Human-Pygmalion/HUPHY/ros/README.md

# `ros/` — ROS 2 래퍼

`huphy` 를 라이브러리로 쓰는 ROS 2 패키지. 노드 둘 + 조작 노드 둘 (창, 패드) +
기록 노드.

| 노드 | 하는 일 | 어디서 |
|---|---|---|
| `control_node` | 모터를 몲. 100Hz, CAN, 가드 | 모션보드 (CAN·IMU 가 붙은 쪽) |
| `policy_node` | 갈 자세를 냄. **속도 명령** 정책 (`vx`·`wz`·`h*`). 50Hz | 작업 기계 (사람이 쓰는 쪽) |
| `motion_node` | 갈 자세를 냄. **모션 추종** 정책 (기준 궤적 재생). 50Hz. `policy_node` 와 둘 중 하나만 | 작업 기계 (사람이 쓰는 쪽) |
| `teleop_node` | (선택) `huphy-run --teleop` 과 같은 창으로 명령·시작·멈춤 | 작업 기계 (화면 있는 쪽) |
| `gamepad_node` | (선택) Xbox 패드로 명령·토크·시작·멈춤. `joy_node` 와 같이 띄움. 명령 없는 정책은 버튼만 | 작업 기계 (패드 꽂은 쪽) |
| `log_node` | (선택) `huphy-run --log` 과 같은 JSON 기록. 구독만 함 | 아무 기계 (파일이 거기 모임) |
| `current_node` | (선택) 전류계로 로봇 전체 DC 전류를 재서 냄. 제어도 추론도 안 함 | 전류계를 꽂은 기계 (CAN 과 무관) |

패키지는 둘임.

| 패키지 | 빌드 | 무엇 |
|---|---|---|
| `huphy_ros` | `ament_python` | 노드와 런치 |
| `huphy_ros_interfaces` | `ament_cmake` | 기록용 메시지 6개. 제어 토픽은 표준 타입 그대로임 |

D455 를 쓸 때는 노드가 하나 더 돎. **그건 우리가 만든 것이 아니라 인텔 공식
패키지임** -- 아래 [카메라 (D455)](#카메라-d455).

| 노드 | 하는 일 | 어디서 | 누가 만든 것 |
|---|---|---|---|
| `realsense2_camera_node` | D455 를 열어 깊이·색·IMU 를 토픽으로 냄 | 카메라가 USB 로 꽂힌 기계 | 인텔 (`realsense2_camera`) |
| `robot_state_publisher` · `rviz2` | 관절각으로 3D 모델을 움직여 보여 줌 ([3D 로 보기](#3d-로-보기-rviz)) | 화면 있는 기계 | ROS 기본 |

그림은 [`ros.drawio`](ros.drawio). 설계 근거는 **아래쪽 "아래는 설계"** 부터.

로봇 없이 ROS 만 테스트하려면 [`without_robot.md`](without_robot.md).

---

## 설치 (새 컴퓨터)

**한 번만 하면 됨.** 끝나면 터미널을 새로 열 때 따로 할 것이 없음.
두 기계(모션보드, 작업 기계) 모두 똑같이 함.

| | |
|---|---|
| OS | Ubuntu 22.04 |
| ROS | Humble |
| 파이썬 | 3.10 (Ubuntu 22.04 기본) |

```bash
sudo apt install -y git
cd ~
git clone https://github.com/chanhue/HUPHY.git
cd HUPHY
ros/install.sh
```

중간에 sudo 비밀번호를 물어봄 (ROS 설치). `끝.` 이 나오면 **새 터미널을 열고** 바로
`ros2 launch` 를 씀.

**여러 번 실행해도 됨.** 이미 된 단계는 건너뛰고, 잘못된 것은 고침. 설치가 꼬인 것
같으면 일단 다시 실행함.

### 스크립트가 하는 일

| 단계 | 하는 일 |
|---|---|
| 1 | ROS 저장소를 추가하고 ROS 2 Humble · colcon 설치. 이미 있으면 건너뜀 |
| 2 | `.venv` 를 `--system-site-packages` 로 만듦 (가상환경 안에서 ROS 가 보이게). 옵션 없이 만든 것이 있으면 다시 만듦 |
| 3 | `pip install -e ".[imu]"` |
| 4 | `~/ros2_ws` 를 만들고 가상환경 파이썬으로 빌드 (`python -m colcon build`) |
| 5 | `~/.bashrc` 에 자동 설정을 넣음 (`# >>> huphy >>>` 블록). 다시 실행하면 블록을 바꿔 끼움 |
| 6 | `huphy_ros` 가 보이는지, 노드가 가상환경 파이썬으로 도는지 확인 |

`ROS_DOMAIN_ID` 는 7 로 들어감. **두 기계가 같은 값이어야 함** — 다르면 에러 없이
서로 안 보임. 바꾸려면 `HUPHY_DOMAIN_ID=9 ros/install.sh`.

### 따로 까는 것

`install.sh` 는 **안 깖.** 쓰는 기계에서만 깔면 됨 -- 모션보드에는 보통 필요 없음.

| 쓸 때 | 어느 기계 | 명령 |
|---|---|---|
| RViz 로 3D 보기 | 화면 있는 기계 (작업 기계) | `sudo apt install ros-humble-rviz2` |
| 로그를 걸러 보기 (rqt_console) | 보는 기계 | `sudo apt install ros-humble-rqt-console` |
| D455 카메라 | 카메라가 꽂힌 기계 | [카메라 (D455)](#카메라-d455) |

### 다시 빌드할 때

**거의 없음.** 파이썬 코드를 고치면 그대로 반영됨. 노드를 새로 추가했거나
`setup.py` · `package.xml` 을 바꿨을 때만 `ros/install.sh` 를 다시 실행함.

**`colcon build` 를 직접 치지 말 것.** 시스템 파이썬으로 빌드되어 노드가
`No module named 'huphy'` 로 죽음. 그렇게 됐으면 `ros/install.sh` 를 다시 실행하면 고쳐짐.

### 안 될 때

| 메시지 | 할 것 |
|---|---|
| `ros2: 명령을 찾을 수 없습니다` | 설치 후 새 터미널을 안 엶 |
| `Package 'huphy_ros' not found` | 새 터미널을 안 엶. 그래도 안 되면 `ros/install.sh` 다시 |
| `No module named 'huphy'` | `colcon build` 를 직접 쳤음. `ros/install.sh` 다시 |
| 스크립트가 `✗` 로 멈춤 | 그 줄에 이유가 있음. 고치고 다시 실행 |

### D455 설치 (카메라를 쓸 때만)

**`ros/install.sh` 는 이걸 안 깖.** 카메라를 안 쓰면 없어도 나머지는 다 돎.
**카메라가 USB 로 꽂히는 기계에서만** 깔면 됨.

```bash
sudo apt install -y ros-humble-librealsense2*      # 인텔 SDK (librealsense2)
sudo apt install -y ros-humble-realsense2-*        # ROS 래퍼 + 메시지 + urdf
```

앞줄이 카메라와 USB 로 이야기하는 라이브러리, 뒷줄이 그걸 ROS 노드로 감싼 것임.
뒷줄은 `realsense2-camera`, `realsense2-camera-msgs`, `realsense2-description`
셋을 같이 깖.

깔렸는지 보려면

```bash
ros2 pkg list | grep realsense           # realsense2_camera 가 나와야 함
lsusb | grep -i intel                    # 꽂혀 있으면 Intel RealSense 가 보임
```

**`colcon build` 를 다시 할 필요 없음.** apt 로 깔리는 별개 패키지라
`~/ros2_ws` 와 상관없음.

---

## 실행

**띄우는 방법이 둘임. 해당하는 단락 하나만 따라감** -- 두 단락은 서로를 참조하지 않음.

| 띄우는 방법 | 언제 | 단락 |
|---|---|---|
| **두 기계** | 실제 배치. 모션보드는 로봇에, 작업 기계는 사람 앞에 | [A. 두 기계](#a-두-기계) |
| **한 기계** | 개발·점검. CAN·IMU 가 붙은 기계 하나에서 노드 둘 다 | [B. 한 기계](#b-한-기계) |

| 기계 | 붙은 것 | 띄우는 노드 |
|---|---|---|
| **모션보드** | CAN 어댑터 (모터) · IMU | `control_node` -- 모터를 읽고 몲 |
| **작업 기계** | 사람이 쓰는 PC | `policy_node` -- 갈 자세를 계산해 모션보드로 보냄 |

각 단락은 **평소 쓰는 순서**(띄우기 -> 토크 -> 기준 자세 -> 정책 -> 명령 -> 멈춤)가 먼저 있고, 그 아래에
**확인**(읽히는지, 토크 없이 정책 출력만)이 따로 있음. 처음 돌리거나 모터·배선을 바꿨으면
토크 넣기 전에 확인부터 함.

### 기존 명령과 어떻게 대응하나

ROS 없이 돌리는 `huphy-run` 한 번이 아래처럼 쪼개져 있음. **ROS 는 "토크 넣기" 와 "정책
시작" 이 따로임** -- `huphy-run` 은 켜자마자 토크를 넣고 기준 자세로 감.

| `huphy-*` 로 하던 것 | ROS 에서 |
|---|---|
| `huphy-can up` | 같음 (`huphy-can up`) |
| `huphy-test --robot watch` -- 토크 없이 읽기만 | `control.launch.py` 를 띄운 직후 (`OBSERVE`) + `ros2 topic echo` 로 봄 |
| `huphy-run --policy <이름>` 의 정책 불러오기 | `policy.launch.py policy:=<폴더>` -- 불러만 두고 아무것도 안 냄 |
| `huphy-run` 시작 = 토크 켜고 기준 자세로 가서 기다림 | `enable` (토크, 감쇠로 대기) -> `approach` (기준 자세로 3초, 도착하면 붙잡고 기다림) |
| `huphy-run` 의 **Enter** -- 정책 시작 | `start_policy` |
| `--teleop` -- pygame 창으로 조작 | `teleop.launch.py` -- 같은 창. R(기준 자세)·Enter(시작)·Esc(끔) |
| `--cmd vx=0.2` | `ros2 topic pub /huphy/cmd_vel ...` (계단·경사는 `linear.x` 만) |
| `--cmd h_star=0.80` / `--teleop` 의 ↑↓ | `ros2 topic pub /huphy/h_star ...` |
| **Ctrl-Q** -- 감쇠 5초 후 토크 끔 | `stop_policy` -> `disable` (감쇠 5초 후 토크 끔). 또는 모션보드 런치에서 Ctrl-C |
| (없음) | 토크 없이 정책 출력만 보기 -- `OBSERVE` 에서 `approach` -> `start_policy` |

**launch 는 띄운 터미널을 계속 차지함** (끄면 노드도 꺼짐). 그 뒤 명령은 **새 터미널**에서
침.

---

### A. 두 기계

모션보드(로봇) + 작업 기계(사람 앞). 각 단계 제목의 `[ ]` 가 **치는 기계**임.
`ros2 service` · `ros2 topic` 은 네트워크 전체에 통해서 어느 기계에서 쳐도 되지만, 사람이 앉은
**작업 기계**에서 치는 것으로 적음.

두 기계의 `ROS_DOMAIN_ID` 가 같아야 함 (설치 스크립트가 7 로 넣음). 다르면 에러 없이 서로
안 보임.

#### 띄울 것 한눈에

런치 하나가 터미널 하나를 차지함. **위에서부터 순서대로** 띄움. 정책은 걷기 예시 --
`walk` 자리를 `stair_slope` / `squat` 로 바꾸면 됨. 정책·창·패드에는
**같은 정책**을 줌.

터미널 2 는 **정책 종류에 따라 런치가 다름.** 속도 명령 정책(`walk`,
`stair_slope`, `squat`)은 `policy.launch.py`, 모션 추종 정책
(`motion545` · `motion399`)은 `motion.launch.py` 임. **둘 중 하나만** 띄울 것 -- 둘 다 띄우면
같은 `joint_targets` 에 두 노드가 목표각을 냄.

| 터미널 | 기계 | 띄울 것 |
|---|---|---|
| 1 | 모션보드 | `huphy-can up` 후 `ros2 launch huphy_ros control.launch.py config:=$HOME/HUPHY/config/robot.yaml` |
| 2 | 작업 기계 | 속도 명령 정책 `ros2 launch huphy_ros policy.launch.py policy:=$HOME/HUPHY/config/policies/walk` <br> 모션 추종 정책 `ros2 launch huphy_ros motion.launch.py policy:=$HOME/HUPHY/config/policies/motion545` |
| 3 | 작업 기계 | 조작 하나: 창 `teleop.launch.py policy:=...` / 패드 `gamepad.launch.py policy:=...` / 명령 `ros2 topic pub ...` (A-6). **모션 추종 정책은 패드뿐** -- 창과 명령은 줄 값이 있어야 함 |
| 4 | 작업 기계 | **기록할 때만** `ros2 launch huphy_ros log.launch.py` -- 정책 시작 전에 |

- **기록은 터미널 4 하나로 끝남.** 1·2 에 붙일 것 없음 -- 기록 노드가 뜨면 두 노드가 알아서
  기록용 토픽을 내기 시작하고, 안 뜨면 안 냄.
- 기록 파일은 터미널 4 를 띄운 기계의 `~/HUPHY/ros/logs/policy/`, `.../latency/` 에 생김.
  `stop_policy` (Esc, 패드 B 포함) 한 번에 한 쌍. 자세한 것은 [기록](#기록).
- 토크 켜기·기준 자세·정책 시작·멈춤은 런치가 아니라 서비스임 -- A-3 부터.

#### A-1. CAN 올리고 제어 노드 띄우기  `[모션보드]`

```bash
huphy-can up
ros2 launch huphy_ros control.launch.py config:=$HOME/HUPHY/config/robot.yaml
```

기록은 여기서 켤 것 없음 -- 작업 기계에서 `log.launch.py` 하나 (위 [띄울 것 한눈에](#띄울-것-한눈에)).

| 명령 | 하는 일 | 기존으로 치면 |
|---|---|---|
| `huphy-can up` | CAN 채널 canr·canl 을 1 Mbps 로 올림. 재부팅·어댑터 재연결 뒤마다 다시 | 같음 |
| `control.launch.py` | 모터·IMU 를 100Hz 로 읽어 `joint_states` 로 내보내고, 들어온 목표각으로 모터를 몲. **`OBSERVE` 로 시작 -- 토크 없음** | `huphy-test --robot watch` 를 띄운 상태 |

모터 설정(호스트 id)이 어긋나 있으면 여기서 멈춤 -- 아래 [안 될 때](#안-될-때-1).

#### A-2. 정책 노드 띄우기  `[작업 기계]`

**넷 중 하나만** 침 -- 어느 정책을 돌릴지 고르는 것. 마지막 하나는 런치가 다름.

```bash
# 걷기 -- /huphy/cmd_vel 로 앞뒤·회전 속도를 줌
ros2 launch huphy_ros policy.launch.py policy:=$HOME/HUPHY/config/policies/walk

# 계단·경사 걷기 -- /huphy/cmd_vel 의 linear.x 만. angular.z 는 0 으로 잘림
ros2 launch huphy_ros policy.launch.py policy:=$HOME/HUPHY/config/policies/stair_slope

# 제자리 스쿼트 -- /huphy/h_star 로 골반 높이를 줌
ros2 launch huphy_ros policy.launch.py policy:=$HOME/HUPHY/config/policies/squat

# 모션 추종 -- 줄 명령이 없음. 꾸러미의 궤적 659프레임을 13.16초 동안 재생
ros2 launch huphy_ros motion.launch.py policy:=$HOME/HUPHY/config/policies/motion545
#   또는 policy:=$HOME/HUPHY/config/policies/motion399
```

`motion.launch.py` 는 `motion_node` 를 띄움 (아래 [`motion_node`](#motion_node)).
단계·서비스는 `policy_node` 와 같고 끝에 `done` 이 하나 더 있음. 명령 토픽
(`cmd_vel`/`h_star`)은 값으로 안 쓰고 조작 노드가 살아 있는지만 봄.

| 명령 | 하는 일 | 기존으로 치면 |
|---|---|---|
| `policy.launch.py` | 정책 꾸러미를 불러 두고 모션보드의 `joint_states` 를 받기 시작함. **띄우기만 하면 아무것도 안 냄** (`stage` = `off`) | `huphy-run --policy <이름>` 의 불러오기까지 |

`checkpoint:=4500`(스쿼트) / `checkpoint:=37400`(걷기 예전 기본. 지금 기본은 49999) 로 다른 체크포인트,
안 주면 계약의 기본값 (`huphy-run --checkpoint` 와 같음). `stair_slope` 는 체크포인트가 `99998`
하나뿐임.

#### A-3. 토크 넣기  `[작업 기계]`

**로봇을 들거나 테더에 맨 상태에서.**

```bash
ros2 service call /huphy/enable std_srvs/srv/Trigger
```

| 명령 | 하는 일 | 기존으로 치면 |
|---|---|---|
| `enable` | 모션보드를 `OBSERVE` -> `CONTROL`. **모터에 힘이 들어감.** 정책이 없는 동안은 감쇠 명령(위치를 안 붙잡고 빠른 움직임만 막음)으로 버팀 | `huphy-run` 을 켠 순간의 토크 넣기 (단, `huphy-run` 은 곧바로 기준 자세로 감) |

`success: true` 가 나와야 함. `false` 면 메시지에 이유가 있음.

#### A-4. 기준 자세로  `[작업 기계]`

```bash
ros2 service call /huphy/approach std_srvs/srv/Trigger
```

| 명령 | 하는 일 | 기존으로 치면 |
|---|---|---|
| `approach` | 3초에 걸쳐 정책의 기준 자세로 간 뒤 **그 자세를 붙잡고 기다림**. `stage` 가 `off -> approach -> ready` | `huphy-run` 이 켜지고 기준 자세로 가서 기다리는 부분 |

로봇이 기준 자세로 제대로 섰는지 보고 다음으로.

**기준 자세가 정책마다 다름.** 속도 명령 정책은 계약의 기본자세로 가고, 모션 추종
정책은 **궤적의 시작 프레임 자세**로 감 (`start_frame`, 기본 0). 학습이 그 자세에서
에피소드를 시작하기 때문임 — 기본자세로 가면 재생을 누른 순간 기준과 실측이
10~20도 벌어진 채로 들어감. `motion_node` 로그가 지금 자세에서 몇 도 가는지 적음.

#### A-5. 정책 시작  `[작업 기계]`

```bash
ros2 service call /huphy/start_policy std_srvs/srv/Trigger
```

| 명령 | 하는 일 | 기존으로 치면 |
|---|---|---|
| `start_policy` | 신경망으로 바뀜. `stage` 가 `ready -> running`. **`ready` 가 아니면 거절**하고 이유를 줌 (먼저 approach / 아직 가는 중 n초) | **Enter** |

어느 정책(걷기/스쿼트)인지는 A-2 에서 띄울 때 정해짐 -- 여기서 고르지 않음. 지금 불린 것은
`ros2 topic echo /huphy/policy_status --once` 의 `hardware_id`. 바꾸려면 정책 런치를 다시 띄움.

#### A-6. 명령 주기 (cmd)  `[작업 기계]`

**방법 셋 -- 창(teleop), 패드(gamepad), 또는 명령.**

창으로 조작 -- `huphy-run --teleop` 과 같은 pygame 창. 화면이 있는 **작업 기계**에서 (ssh 면 `-X`).
`policy:=` 는 정책 노드에 준 것과 같은 꾸러미.

**정책 노드(A-2)에 준 것과 같은 정책**을 줌 -- 그 정책의 명령 키만 생김.

```bash
# 걷기 -- W/S 앞뒤, A/D 회전
ros2 launch huphy_ros teleop.launch.py policy:=$HOME/HUPHY/config/policies/walk

# 계단·경사 -- W/S 앞뒤만. A/D 키가 아예 안 생김
ros2 launch huphy_ros teleop.launch.py policy:=$HOME/HUPHY/config/policies/stair_slope

# 스쿼트 -- ↑/↓ 높이
ros2 launch huphy_ros teleop.launch.py policy:=$HOME/HUPHY/config/policies/squat
```

| 창에서 누르는 키 | 하는 일 | 기존으로 치면 |
|---|---|---|
| W/S · A/D | 걷기 앞뒤 · 회전. 누르는 동안 가속, 떼면 감속해 0 | `--teleop` 의 W/S/A/D |
| ↑/↓ | 스쿼트 높이 | `--teleop` 의 ↑/↓ |
| Space | 속도 즉시 0 | 같음 |
| **R** | 기준 자세로 (`approach`). **토크가 켜져 있을 때만** -- 아니면 안 보내고 로그에 "먼저 enable" | (없음 -- `huphy-run` 은 켜자마자 감) |
| **Enter** | 정책 시작 (`start_policy`). 기준 자세 도착 뒤에만 | Enter |
| **Esc** · 창 닫기 | 정책 끔 -> 토크 끔 (`stop_policy` -> `disable`), 창도 닫힘 | Esc |

창 맨 위에 지금 상태가 뜸 -- `Torque OFF` / `R: go to ready pose` / `Moving to ready pose` /
`Ready. Enter: start policy` / `POLICY RUNNING`. **토크 켜기(`enable`)는 키로 안 함** -- 명령으로
침. 속도 상한 등은 `max:="vx=0.8" accel:="vx=0.4" decel:="vx=1.5"` (`--max` 등과 같음).

창을 쓰면 A-4·A-5·A-6 의 명령을 대신함 (enable 만 명령).

---

패드로 조작 -- Xbox 패드. 화면이 필요 없음. 패드를 USB 나 블루투스로 붙이면
`/dev/input/js0` 가 생기고, 런치가 `joy_node`(ROS 의 `joy` 패키지)와 `gamepad_node` 를 같이 띄움.
`policy:=` 는 정책 노드에 준 것과 같은 꾸러미.

```bash
# 걷기 -- 왼쪽 스틱 앞뒤, 오른쪽 스틱 회전
ros2 launch huphy_ros gamepad.launch.py policy:=$HOME/HUPHY/config/policies/walk

# 계단·경사 -- 왼쪽 스틱 앞뒤만. 오른쪽 스틱이 아예 안 배정됨
ros2 launch huphy_ros gamepad.launch.py policy:=$HOME/HUPHY/config/policies/stair_slope

# 스쿼트 -- 십자키 위아래로 높이
ros2 launch huphy_ros gamepad.launch.py policy:=$HOME/HUPHY/config/policies/squat

# 모션 추종 -- 스틱이 할 일이 없음. 버튼만 씀 (아래 설명)
ros2 launch huphy_ros gamepad.launch.py policy:=$HOME/HUPHY/config/policies/motion545
```

**모션 추종 정책은 스틱이 없고 버튼만 씀.** 사람이 줄 명령이 없어서임 -- 따라갈
궤적이 꾸러미 안에 있음. View·A·RB+Menu·B 는 그대로 되고, RB 는 속도를 내보내는
데드맨 역할은 없어지지만 "RB 를 쥐고 있어야 시작된다" 는 조건으로 남음.

`cmd_vel` 은 그 경우에도 **0 만 20Hz 로 계속 냄.** 값이 쓰이지 않지만 그것이 패드
쪽이 살아 있다는 신호임 -- 끊기면 `control_node` 가 감쇠 후 토크를 끊고
(`stop_on_input_loss`) `motion_node` 가 재생을 멈춤 (`stop_on_cmd_loss`). 안 내면
패드가 죽어도 로봇이 13초 동안 혼자 돌고 B 를 누를 수단이 없어짐.

| 패드 | 하는 일 |
|---|---|
| 왼쪽 스틱 세로 · 가로 | `vx` 앞뒤 · `vy` 옆 (스틱값 × 그 명령의 `max`) |
| 오른쪽 스틱 가로 | `wz` 회전 |
| 십자키 세로 | `h_star` 높이. `accel`(기본 0.05 m/s)씩 움직이고 계약의 범위에서 멈춤 |
| **RB** | 누르고 있는 동안에만 명령이 먹음. 떼면 속도 0, 높이는 마지막 값 유지 |
| **A** | 기준 자세로 (`approach`). **토크가 켜져 있을 때만** |
| **RB + Menu** | 정책 시작 (`start_policy`). **RB 를 누르고 있어야 나감** |
| **B** | 정책 끔 -> 토크 끔 (`stop_policy` -> `disable`). 노드는 계속 돎 -- 다시 View 1초부터. 노드 종료는 Ctrl-C |
| **View 1초** | 토크 넣기 (`enable`). **1초 계속 눌러야** 한 번 나감 |

**창(teleop)과 다른 점은 `enable` 이 패드에 있다는 것뿐임.** 토크가 들어가는 순간이 가장
위험해서, 한 번 눌리는 것으로는 안 나가게 `enable_hold_s`(기본 1.0초)를 둠. 정책 시작도
RB 를 쥐고 있어야 나감 -- 손이 데드맨에 가 있어야 정책이 돈다는 뜻임. 둘 다 버튼이
**안 눌림 -> 눌림** 으로 바뀐 주기에만 나가므로, Menu 를 누른 채로 RB 를 더하는 것은 안 됨
(Menu 를 뗐다가 RB 를 먼저 쥐고 다시 누를 것).

**버튼 번호는 USB 와 블루투스가 다름** -- 같은 View 가 USB 에서는 6번, 블루투스에서는 10번.
`gamepad_node` 가 첫 `/joy` 의 버튼 수로 배치를 고름 (11개 usb, 16개 bluetooth). 시작 로그에
`패드 배치 bluetooth (버튼 16개): deadman 7, …` 처럼 찍힘. **모르는 버튼 수면 패드를 통째로
무시하고 속도 0 만 냄** -- 번호를 모르는 채로 쓰면 엉뚱한 버튼이 토크를 넣음 (블루투스에서
USB 번호를 쓰면 LB 가 "View" 였음). 고정하려면 `layout:=usb` / `layout:=bluetooth`.

`joy` 패키지는 apt 로 깜: `sudo apt install -y ros-humble-joy` (pip 아님).

패드 입력만 따로 보려면 `python3 tools/gamepad_viewer.py` -- ROS 없이 패드를 직접 읽어 버튼·축의
번호와 이름(`View`, `RB` 등)을 브라우저에 실시간으로 보여 줌 (`tools/README.md`).

**끊기면 감쇠 후 토크가 꺼짐:** 패드가 끊기거나(`/joy` 가 0.5초 넘게 안 옴 -- 선이 빠짐,
블루투스 끊김, `joy_node` 가 죽음) `gamepad_node` 가 죽으면(Ctrl-C 포함) 명령 토픽이 끊기고,
0.5초 뒤 `control_node` 가 감쇠 5초 후 토크를 끊음 (`stop_on_input_loss`). 정책 노드도 정책을 끔.
속도만 0 으로 두면 B 를 누를 패드가 없어 멈출 수단이 없기 때문임. 다시 쓰려면 View 1초부터.

축·버튼 번호는 드라이버마다 다름 (USB 의 `xpad` 와 블루투스의 `xpadneo` 가 다름). 안 맞으면
`ros2 topic echo /joy` 로 실제 번호를 보고 덮어씀.

```bash
ros2 launch huphy_ros gamepad.launch.py policy:=... \
  --ros-args -p axis_vx:=1 -p button_deadman:=5
```

패드 하나로 A-3·A-4·A-5·A-6·A-7 을 다 함.

---

명령으로 줄 때는 정책에 맞는 것 **하나**. `pub -r 20` 은 초당 20번 계속 보냄. 안 보내면 걷기는
(0, 0) = 제자리, 스쿼트는 시작값 0.8914.

**끊으면:** 0.5초 뒤(`policy_node` 의 `cmd_timeout_s`) **정책이 멈추고 모션보드가 감쇠 후
토크를 끊음** (`stop_on_cmd_loss`). 보내던 쪽(패드·teleop·`pub -r`)이 죽었는데 정책이 계속
돌면, 멈춤 버튼도 같이 죽어 멈출 수단이 없어짐. `--once` 로 한 번만 보낼 거면
`stop_on_cmd_loss:=false` -- 그때는 속도만 0 으로 돌아가고 높이는 마지막 값이 유지됨.

```bash
# 걷기: linear.x 앞뒤 (m/s), angular.z 돌기 (rad/s)
ros2 topic pub -r 20 /huphy/cmd_vel geometry_msgs/msg/Twist \
  '{linear: {x: 0.2}, angular: {z: 0.0}}'

# 계단·경사: 같은 토픽인데 linear.x 만 (0 ~ 2 m/s). angular.z 는 보내도 0 으로 잘림
ros2 topic pub -r 20 /huphy/cmd_vel geometry_msgs/msg/Twist \
  '{linear: {x: 0.3}}'

# 스쿼트: 골반 높이 (m). 0.70 ~ 0.891
ros2 topic pub -r 20 /huphy/h_star std_msgs/msg/Float64 '{data: 0.80}'
```

| 명령 | 하는 일 | 기존으로 치면 |
|---|---|---|
| `topic pub cmd_vel` | 걷기 속도 명령 | `--cmd vx=0.2 wz=0` 또는 `--teleop` 의 W·S·A·D |
| `topic pub cmd_vel` (계단·경사) | 전진 속도만. `angular.z` 는 무시됨 | `--cmd vx=0.3` 또는 `--teleop` 의 W·S |
| `topic pub h_star` | 스쿼트 높이 명령 | `--cmd h_star=0.80` 또는 `--teleop` 의 ↑↓ |

#### A-7. 멈춤 · 토크 끄기  `[작업 기계]` · 급하면 `[모션보드]`

```bash
ros2 service call /huphy/stop_policy std_srvs/srv/Trigger   # 목표각 중단
ros2 service call /huphy/disable std_srvs/srv/Trigger       # 감쇠 5초 후 토크 차단
```

| 명령 | 하는 일 | 기존으로 치면 |
|---|---|---|
| `stop_policy` | 정책이 목표각을 그만 냄(어느 단계에서든). 모션보드는 감쇠로 버팀 | (없음 -- 둘이 한 번에 일어남) |
| `disable` | 감쇠 5초 후 토크를 끊고 `OBSERVE` 로 | **Ctrl-Q** |

급하면 **모션보드**의 런치 터미널에서 **Ctrl-C** -- 같은 절차(감쇠 후 차단)를 탐. 작업
기계의 정책 런치를 끊으면 목표각이 끊겨 모션보드가 100ms 뒤 감쇠로 떨어지지만, 토크는
`disable` 이나 모션보드 Ctrl-C 로 끊어야 함.

다시 돌리려면 A-3 (`enable`) 부터.

#### A 확인 1. 읽히는지  `[작업 기계]` -- A-1 뒤, 토크 전에

```bash
ros2 topic hz   /huphy/joint_states          # 초당 몇 번 오는지. 100 근처. Ctrl-C 로 멈춤
ros2 topic echo /huphy/joint_states --once   # 관절 각도·속도 한 번
ros2 topic echo /huphy/gravity --once        # IMU 가 본 중력 방향 한 번
ros2 topic echo /huphy/loop_status --once    # 제어 루프 상태 (모드, 무응답 수)
```

| 명령 | 하는 일 | 기존으로 치면 |
|---|---|---|
| `topic hz joint_states` | 모션보드 상태가 **네트워크 너머로** 제 주기로 오는지 | (없음 -- ROS 만의 확인) |
| `topic echo joint_states` | 관절 각도·속도 | `watch` 의 실시간 뷰어 숫자 |
| `topic echo gravity` | IMU 중력방향 | 실시간 뷰어 IMU 그래프 |
| `topic echo loop_status` | 모드·무응답 수 | 끝에 찍히는 실패 집계 |

`hz` 는 계속 찍고 안 끝남 -- 확인했으면 **Ctrl-C**. `--once` 는 하나 찍고 끝남.

| 보는 것 | 맞는 값 |
|---|---|
| 관절 이름 | `right_leg__knee` 꼴, **모터 12개.** 발목은 `ankle_a`/`ankle_b` (기존 레포·정책 계약과 같음. `ankle_pitch`/`ankle_roll` 이 보이면 예전 노드임) |
| 위치 | **라디안.** 무릎 20도면 0.35. 손으로 움직이면 따라 변함 |
| 중력방향 | 서 있으면 z 가 −1 근처 |
| `missing_cycles` | 거의 안 늚 |

#### A 확인 2. 토크 없이 정책 출력만  `[작업 기계]` -- A-2 뒤, A-3 전에

```bash
ros2 service call /huphy/approach std_srvs/srv/Trigger       # 기준 자세 목표각 (3초 뒤 ready)
ros2 service call /huphy/start_policy std_srvs/srv/Trigger   # 정책 켬
ros2 topic hz   /huphy/joint_targets                         # 목표각이 초당 몇 번. Ctrl-C
ros2 topic echo /huphy/joint_targets --once                  # 목표각 한 번
ros2 service call /huphy/stop_policy std_srvs/srv/Trigger    # 정책 끔
```

| 명령 | 하는 일 | 기존으로 치면 |
|---|---|---|
| `approach` -> `start_policy` | 정책이 목표각을 내기 시작. 모션보드가 아직 `OBSERVE` 라 **모터는 안 움직임** | **없음** -- `huphy-run` 은 늘 토크를 넣고 돎 |
| `topic hz/echo joint_targets` | 목표각이 정책 주기(50Hz 근처)로, −2 ~ 2 rad 안에서 나오는지 | (없음) |
| `stop_policy` | 정책 끔. 이 뒤에 A-3 으로 | (없음) |

---

### B. 한 기계

**모든 명령을 CAN·IMU 가 붙은 그 기계 하나에서** 침. 노드 둘을 런치 하나로 같이 띄우는 것만
다르고, 그 뒤 서비스·토픽은 A 와 같음. 런치 뒤 명령은 새 터미널에서.

**`local.launch.py` 는 속도 명령 정책만 띄움** (`control` + `policy`). 모션 추종
정책은 한 기계에서도 터미널 둘로 띄울 것 -- `control.launch.py` 와
`motion.launch.py`. 한 런치로 묶지 않은 이유: `local.launch.py` 에 둘을 같이
넣으면 `policy_node` 와 `motion_node` 가 같은 `joint_targets` 에 목표각을 냄.

#### 띄울 것 한눈에 (한 기계)

| 터미널 | 띄울 것 |
|---|---|
| 1 | `huphy-can up` 후 `ros2 launch huphy_ros local.launch.py config:=$HOME/HUPHY/config/robot.yaml policy:=$HOME/HUPHY/config/policies/walk` |
| 2 | 조작 하나: 창 `teleop.launch.py policy:=...` / 패드 `gamepad.launch.py policy:=...` / 명령 `ros2 topic pub ...` (B-5) |

- **기록할 때만** 다른 터미널에서 `ros2 launch huphy_ros log.launch.py` -- 정책 시작 전에.
- 기록 파일은 `~/HUPHY/ros/logs/policy/`, `.../latency/`. `stop_policy` 한 번에 한 쌍.

#### B-1. CAN 올리고 노드 둘 띄우기

```bash
huphy-can up
ros2 launch huphy_ros local.launch.py \
  config:=$HOME/HUPHY/config/robot.yaml \
  policy:=$HOME/HUPHY/config/policies/walk
```

| 명령 | 하는 일 | 기존으로 치면 |
|---|---|---|
| `huphy-can up` | CAN 채널을 1 Mbps 로 올림 | 같음 |
| `local.launch.py` | 제어 노드(`OBSERVE`, 토크 없음)와 정책 노드(불러만 둠)를 **한 번에** 띄움. 정책은 `policy:=` 로 고름 -- `walk` / `stair_slope` / `squat`. **기록 노드는 안 띄움** | `huphy-test --robot watch` 상태 + `huphy-run --policy <이름>` 의 불러오기 |

로그 끝에 `approach 를 기다림` 과 `OBSERVE 로 시작` 이 나오면 된 것임.

기록은 다른 터미널에서 `ros2 launch huphy_ros log.launch.py` (아래 [기록](#기록)).

로봇 없이 점검할 때는 `huphy-can up` 대신 가짜 채널을 올리고 `config:=/tmp/robot_vcan.yaml`
-- [`without_robot.md`](without_robot.md).

#### B-2. 토크 넣기

**로봇을 들거나 테더에 맨 상태에서.**

```bash
ros2 service call /huphy/enable std_srvs/srv/Trigger
```

`OBSERVE` -> `CONTROL`. 정책이 없는 동안은 감쇠로 버팀. `huphy-run` 을 켠 순간의 토크
넣기에 해당 (단, 기준 자세로는 아직 안 감). `success: true` 가 나와야 함.

#### B-3. 기준 자세로

```bash
ros2 service call /huphy/approach std_srvs/srv/Trigger       # 3초에 걸쳐 기준 자세로, 도착하면 붙잡고 기다림
```

`stage` 가 `off -> approach -> ready`. `huphy-run` 이 켜지고 기준 자세에서 기다리는 부분.
로봇이 제대로 섰는지 보고 다음으로.

#### B-4. 정책 시작

```bash
ros2 service call /huphy/start_policy std_srvs/srv/Trigger   # ready -> running (= huphy-run 의 Enter)
```

`ready` 가 아니면 거절하고 이유를 줌. 어느 정책인지는 B-1 의 `policy:=` 로 정해짐 -- 바꾸려면
`disable` 후 런치를 다시 띄움 (제어 노드도 같이 뜨는 런치라서).

#### B-5. 명령 주기 (cmd)

창으로 -- 같은 기계에 화면이 있으면 (A-6 의 키와 같음. R 기준 자세, Enter 시작, Esc 끔):

```bash
# B-1 의 policy:= 와 같은 것
ros2 launch huphy_ros teleop.launch.py policy:=$HOME/HUPHY/config/policies/walk   # 걷기 W/S/A/D
ros2 launch huphy_ros teleop.launch.py policy:=$HOME/HUPHY/config/policies/stair_slope    # 계단·경사 W/S
ros2 launch huphy_ros teleop.launch.py policy:=$HOME/HUPHY/config/policies/squat        # 스쿼트 ↑/↓
```

패드로 -- A-6 의 패드와 같음 (RB 데드맨, View 1초 토크, A 기준 자세, RB+Menu 시작, B 끔):

```bash
ros2 launch huphy_ros gamepad.launch.py policy:=$HOME/HUPHY/config/policies/walk
```

명령으로 -- 정책에 맞는 것 하나. 끊으면 속도는 0.5초 뒤 0, 높이는 유지.

```bash
ros2 topic pub -r 20 /huphy/cmd_vel geometry_msgs/msg/Twist \
  '{linear: {x: 0.2}, angular: {z: 0.0}}'                      # 걷기 (= --cmd vx=0.2)
ros2 topic pub -r 20 /huphy/cmd_vel geometry_msgs/msg/Twist \
  '{linear: {x: 0.3}}'                                         # 계단·경사 (= --cmd vx=0.3)
ros2 topic pub -r 20 /huphy/h_star std_msgs/msg/Float64 '{data: 0.80}'   # 스쿼트 (= --cmd h_star=0.80)
```

#### B-6. 멈춤 · 토크 끄기

```bash
ros2 service call /huphy/stop_policy std_srvs/srv/Trigger   # 목표각 중단
ros2 service call /huphy/disable std_srvs/srv/Trigger       # 감쇠 5초 후 토크 차단 (= Ctrl-Q)
```

급하면 런치 터미널에서 **Ctrl-C** -- 같은 절차를 탐. 다시 돌리려면 B-2 (`enable`) 부터.

#### B 확인 1. 읽히는지 -- B-1 뒤, 토크 전에

```bash
ros2 topic hz   /huphy/joint_states          # 100 근처. Ctrl-C
ros2 topic echo /huphy/joint_states --once   # 관절 각도·속도
ros2 topic echo /huphy/gravity --once        # 중력 방향
ros2 topic echo /huphy/loop_status --once    # 모드, 무응답 수
```

| 명령 | 하는 일 | 기존으로 치면 |
|---|---|---|
| `topic hz joint_states` | 상태가 제 주기로 나오는지 | (없음) |
| `topic echo joint_states` | 관절 각도·속도 | `watch` 의 실시간 뷰어 숫자 |
| `topic echo gravity` | IMU 중력방향 | 실시간 뷰어 IMU 그래프 |
| `topic echo loop_status` | 모드·무응답 수 | 끝에 찍히는 실패 집계 |

맞는 값: 이름 `right_leg__knee` 꼴로 모터 12개(발목은 `ankle_a`/`ankle_b`), 위치는 **라디안**(무릎 20도면 0.35), 중력방향 z 가
−1 근처, `missing_cycles` 가 거의 안 늚.

#### B 확인 2. 토크 없이 정책 출력만 -- B-1 뒤, B-2 전에

```bash
ros2 service call /huphy/approach std_srvs/srv/Trigger       # 기준 자세 목표각 (3초 뒤 ready)
ros2 service call /huphy/start_policy std_srvs/srv/Trigger   # 정책 켬 -- 모터는 안 움직임
ros2 topic hz   /huphy/joint_targets                         # 정책 주기 근처. Ctrl-C
ros2 topic echo /huphy/joint_targets --once                  # −2 ~ 2 rad 면 정상
ros2 service call /huphy/stop_policy std_srvs/srv/Trigger    # 정책 끔. 이 뒤에 B-2 로
```

`huphy-run` 에는 없는 단계임 -- 토크 없이 정책이 무엇을 내는지만 봄.

---

## 카메라 (D455)

**지금은 카메라가 무엇을 내는지 보는 데까지임.** 깊이를 지형으로 바꿔 정책에
넣는 노드는 아직 없음 -- 아래 [지형 -- 아직 정하는 중](#지형--아직-정하는-중).

띄우는 노드는 인텔이 만든 `realsense2_camera_node` 임. 우리가 가진 것은
그걸 우리 설정으로 부르는 런치 파일 하나
([`camera.launch.py`](huphy_ros/launch/camera.launch.py)) 뿐임.

### C-1. 띄우기  `[카메라가 꽂힌 기계]`

```bash
ros2 launch huphy_ros camera.launch.py
```

**혼자 돎.** `control_node` 나 `policy_node` 가 떠 있든 말든 상관없고, 구독자가
없어도 그냥 토픽을 냄. 그래서 책상에서 작업 기계에 꽂고 띄워 봐도 됨.

자주 쓰는 인자.

```bash
# 드라이버가 역투영까지 해서 PointCloud2 로도 냄
ros2 launch huphy_ros camera.launch.py pointcloud:=true

# 눈으로 보려고 색까지
ros2 launch huphy_ros camera.launch.py color:=true

# 해상도를 낮춤 ("848x480x30" 도 "848,480,30" 도 됨)
ros2 launch huphy_ros camera.launch.py depth_profile:=424x240x30

# 드라이버 쪽에서 가로세로 반으로 줄임 (점 수 1/4)
ros2 launch huphy_ros camera.launch.py decimation:=true

# 카메라가 안 열릴 때 (앞 실행이 비정상 종료한 경우)
ros2 launch huphy_ros camera.launch.py initial_reset:=true
```

인자 전체는 런치 파일 맨 위 주석과 `ARGUMENTS` 목록에 있음.

### C-2. 나오는 토픽

| 토픽 | 타입 | 무엇 |
|---|---|---|
| `/huphy/d455/depth/image_rect_raw` | `sensor_msgs/Image` | 깊이. `Z16`, 한 칸이 1mm |
| `/huphy/d455/depth/camera_info` | `sensor_msgs/CameraInfo` | 초점거리·주점. 역투영에 필요 |
| `/tf_static` | `tf2_msgs/TFMessage` | 카메라 안 좌표계 관계. 드라이버가 냄 |
| `/huphy/d455/depth/color/points` | `sensor_msgs/PointCloud2` | `pointcloud:=true` 일 때만 |
| `/huphy/d455/color/image_raw` | `sensor_msgs/Image` | `color:=true` 일 때만 |
| `/huphy/d455/imu` | `sensor_msgs/Imu` | `imu:=true` 일 때만. 카메라 내장 IMU |

이름공간을 `/huphy/d455` 로 바꿔 둔 것임 (드라이버 기본값은 `/camera/camera`).
런치 인자 `namespace:=`, `name:=` 로 바꿀 수 있음.

### C 확인. 실제로 무엇을 얼마나 내는지

```bash
ros2 topic list                                              # 토픽이 다 떴는지
ros2 topic hz   /huphy/d455/depth/image_rect_raw             # 초당 프레임 수. Ctrl-C
ros2 topic bw   /huphy/d455/depth/image_rect_raw             # 초당 바이트. Ctrl-C
ros2 topic echo /huphy/d455/depth/camera_info --once         # 초점거리(k[0], k[4])
ros2 run rqt_image_view rqt_image_view                       # 눈으로 봄
```

`hz` 와 `bw` 가 **지형 노드를 설계할 때 필요한 숫자**임 -- 얼마나 자주 오는지,
기계 사이로 보내면 얼마를 먹는지.

### 안 될 때

| 증상 | 이유·할 것 |
|---|---|
| `Package 'realsense2_camera' not found` | 안 깔림. 위 "D455 설치" |
| `No RealSense devices were found` | USB 에 안 꽂힘. `lsusb \| grep -i intel` 로 확인 |
| 열렸다 바로 닫힘 | 앞 실행이 남아 있음. `initial_reset:=true` |
| 프레임이 뚝뚝 끊김 | USB 2.0 포트에 꽂힘. USB 3 포트(보통 파란색)로 |
| 깊이가 다 0 | 너무 가까움. D455 최소 거리가 대략 0.5m |

### 지형 -- 아직 정하는 중

깊이를 정책 입력으로 바꾸는 노드(`terrain_node`)는 **아직 안 만듦.** 만들려면
학습 쪽에서 다음이 정해져야 함.

- 정책이 지형을 **어떤 모양으로** 받는가 -- 높이 격자인지, 깊이 영상을 학습된
  인코더에 넣은 벡터인지, 영상 자체인지. 셋이 완전히 다른 노드가 됨
- **쌓는가** -- 지금 안 보이는 곳을 기억해야 하면 로봇이 공간 어디에 있는지를
  알아야 함. 그 추정 코드가 지금 우리 레포에 없음. 노드가 하나 더 생김
- 격자를 쓴다면 **크기·간격·칸의 값·안 보이는 칸의 값**
- 지형이 **낡았을 때** 무엇을 넣는가. 제어 루프는 멈출 수 없음

값과 무관하게 정해진 것도 있음.

- 지형 처리는 `control_node` 와 **다른 프로세스**여야 함. `control_node` 는
  100Hz 제어 스레드가 마감을 지키고 있어서 길이를 모르는 일을 같이 둘 수 없음
- 깊이 영상은 **기계 사이로 건너면 안 됨**. `/huphy/joint_targets` 와 같은 선을
  다투게 되고, 늦으면 `control_node` 의 `target_stale_ms` 에 걸려 루프가 멈춤.
  줄이는 일은 카메라가 붙은 기계에서 함
- 기하 계산은 `src/huphy/` 에 두고 노드는 부르기만 함. `control_node` ·
  `policy_node` 가 이미 그 구조임

---

## 파라미터

### `control_node`

| 이름 | 기본 | 무엇 |
|---|---|---|
| `config` | 없음. **필수** | `robot.yaml` 경로 |
| `limb` | 빈 값 = 양다리 | 다리 하나만 돌릴 때 |
| `hz` | 100.0 | 제어 주기. **런치 인자 이름은 `motor_hz`** (아래 [런치 인자 이름](#런치-인자-이름)) |
| `state_hz` | 100.0 | 상태 발행 주기 |
| `drain_ms` | 4.0 | 응답을 기다리는 최대 시간. 다 오면 즉시 넘어가서 평소엔 안 씀. 2 면 마지막 응답 모터(ankle_b)가 가끔 무응답으로 잡혀 통신 두절로 멈췄음 |
| `send_mode` | `burst` | 명령을 내는 방식. `burst` 는 모터마다 호스트 id 가 0xF0+id 여야 함 -- 시작할 때 확인하고 아니면 멈춤. 못 맞춘 모터가 있으면 `seq` (`docs/can_communication.md` 4절) |
| `target_stale_ms` | 100.0 | 목표각이 이보다 안 오면 감쇠 |
| `input_timeout_ms` | 500.0 | 조작 노드(패드·teleop)의 명령 토픽(`cmd_vel`/`h_star`)이 이보다 끊기면 CONTROL 을 멈춤 -> 감쇠 5초 후 토크 끔 |
| `stop_on_input_loss` | true | 위를 켜고 끔. 명령 토픽을 한 번도 안 받았으면(조작 노드 없이 씀) 걸리지 않음. `enable` 때마다 새로 셈 |
| `allow_uncalibrated` | false | 실측 전에도 토크를 넣음 |
| `extra` | 0 | 한 주기에 다리마다 보낼 파라미터 읽기 요청 수. 0 이면 전류·전압을 안 읽고 `motor_extra` 토픽도 안 냄. `burst` 에서만 됨 (아래 [모터 전류·전압·온도](#모터-전류전압온도)) |

### `policy_node`

| 이름 | 기본 | 무엇 |
|---|---|---|
| `policy` | 없음. **필수** | 정책 꾸러미 폴더 (`config/policies/<이름>`) |
| `checkpoint` | 빈 값 = 계약의 기본값 | 꾸러미 안의 다른 체크포인트 번호 (예: 스쿼트 `4500`, 걷기 `37400` -- 걷기 기본은 `49999`). `local.launch.py` 에도 같은 인자 |
| `hz` | 0 = 계약의 `control_rate_hz` | 추론 주기. 보통 비워 둠. **런치 인자 이름은 `policy_hz`** (아래 [런치 인자 이름](#런치-인자-이름)) |
| `state_stale_ms` | 60.0 | 상태가 이보다 낡으면 목표각을 안 냄 |
| `approach_s` | 3.0 | 기준 자세로 옮기는 시간 |
| `cmd_timeout_s` | 0.5 | 속도 명령(`cmd_vel`)이 이만큼 안 오면 속도를 0 으로. 높이는 유지 |
| `stop_on_cmd_loss` | true | 명령 토픽(`cmd_vel`/`h_star`)을 받다가 `cmd_timeout_s` 넘게 끊기면 **정책을 멈춤** -> 모션보드가 감쇠 후 토크 끔. 조작 노드(패드·teleop)가 죽었을 때 멈출 수단이 없어지는 것을 막음 |

### `motion_node`

`policy_node` 와 같은 자리임 -- **둘 중 하나만 띄울 것.** 둘 다 띄우면 같은
`joint_targets` 에 두 노드가 목표각을 내 모터가 둘을 번갈아 받음.

| 이름 | 기본 | 무엇 |
|---|---|---|
| `policy` | 없음. **필수** | 정책 꾸러미 폴더. 계약에 `motion` 칸이 있어야 함 (없으면 시작할 때 멈춤) |
| `checkpoint` | 빈 값 = 계약의 기본값 | 꾸러미 안의 다른 체크포인트 번호 |
| `hz` | 0 = 계약의 `control_rate_hz` | 추론 주기. **런치 인자 이름은 `motion_hz`** |
| `state_stale_ms` | 60.0 | 상태가 이보다 낡으면 목표각을 안 냄 |
| `approach_s` | 3.0 | 기준 자세로 옮기는 시간 |
| `start_frame` | 0 | 기준 궤적의 몇 번째 프레임부터 재생할지 |

| `cmd_timeout_s` | 0.5 | 명령 토픽이 이만큼 안 오면 조작 노드가 죽은 것으로 봄 |
| `stop_on_cmd_loss` | true | 그때 **재생을 멈춤** -> 모션보드가 감쇠 후 토크 끔 |

**명령 토픽은 값으로 안 쓰고 생존 신호로만 씀.** 사람이 줄 명령이 없지만
`cmd_vel`·`h_star` 를 구독해 **도착 시각만** 봄. `gamepad_node` 가 명령 없는
정책에서도 `cmd_vel` 로 0 을 20Hz 로 계속 내므로, 그것이 0.5초 넘게 끊기면 패드나
그 노드가 죽은 것이라 재생을 멈춤. 한 번도 안 받았으면 멈추지 않음 -- 조작 노드
없이 `ros2 service call` 로만 돌리는 쓰임임.

패드 버튼은 `policy_node` 와 같음: View 1초 토크, A 기준 자세, RB+Menu 시작, B 끔.

`joint_states` 의 **속도**도 씀 (`policy_node` 는 위치만 씀). 이 정책의 관찰에
관절 속도 24칸이 있음. 같은 토픽에 이미 실려 오고 있어서 더 받을 것은 없음.

단계가 하나 더 있음.

```
off -> approach -> ready -> running -> done
```

`done` 은 마지막 프레임까지 재생한 뒤임. **마지막 목표각을 계속 냄** -- 지금 궤적은
쪼그려 앉은 자세로 끝나서 목표각을 끊으면 모션보드가 100ms 뒤 감쇠, 5초 뒤 토크를
끊어 주저앉음. `done` 에서 `approach` 를 부르면 기본자세로 돌아옴.

되돌려 반복하지 않음 -- 첫 프레임과 끝 프레임의 관절차가 최대 37.6도임.

`log_node` 는 `running` 인 동안만 쌓으므로 `done` 으로 넘어가는 순간 그 재생의
기록 파일이 떨어짐.

재생 위치는 `policy_status` 의 `frame`·`frames`·`progress` 로 나감.

꾸러미와 확인된 어긋남은 [docs/policies/motion.md](../docs/policies/motion.md).

### `teleop_node`

| 이름 | 기본 | 무엇 |
|---|---|---|
| `policy` | 없음. **필수** | 정책 꾸러미 폴더. 정책 노드와 같은 것 -- 그 정책의 명령만 조작함 |
| `max` / `accel` / `decel` | 빈 값 = 기본 | `"vx=0.8 wz=1.0"` 꼴. `huphy-run --max/--accel/--decel` 과 같음 |

**게인·관절 한계·모터 id 는 양쪽 다 없음.** `robot.yaml` 과
`config/calibration/*.json` 이 유일한 출처임. 파라미터로 또 받으면 어긋났을 때 어느
쪽이 진짜인지 알 수 없음 — 실제로 그 실수를 한 적이 있음(커밋 `4dbdfa2`, 무릎 kp 가
설정의 값 대신 코드 상수로 나감).

### 런치 인자 이름

위 표는 **노드 파라미터** 이름임. 런치 인자는 `hz` 두 개만 이름이 다름.

| 런치 | 런치 인자 | 노드 파라미터 |
|---|---|---|
| `control.launch.py` | `motor_hz:=` | `hz` |
| `policy.launch.py` | `policy_hz:=` | `hz` |

**`local.launch.py` 때문임.** `IncludeLaunchDescription` 은 런치 설정 범위를 새로
안 만들고, `DeclareLaunchArgument` 는 **이미 있는 이름에 기본값을 안 넣음.** 그래서
두 런치가 같은 이름을 쓰면 먼저 include 한 쪽 값이 뒤쪽 노드에 그대로 들어감.

둘 다 `hz` 였을 때 `local.launch.py` 로 띄우면 `control.launch.py` 의 100 이
`policy_node` 에 들어가, **인자를 하나도 안 줘도 정책이 계약의 50 이 아니라 100Hz
로 돌았음** (11-02 기록 다섯 개가 그 상태임 -- `run.hz` 가 100, 줄 간격 9.99ms).
제어가 정책 사이를 메우는 구조가 아니라 두 타이머가 같은 주기로 따로 돈 것임.

인자를 더할 때 두 파일에 같은 이름을 쓰지 말 것.

`local.launch.py` 가 선언해서 `control.launch.py` 로 넘기는 이름(`config`, `extra`)
은 다름. 부모가 `launch_arguments` 로 값을 직접 주므로 선언 순서와 무관하게 그 값이
들어감. 금지되는 것은 **include 되는 두 파일이 같은 이름을 각자 선언하는 것**임.

---

---

## 테스트

`convert.py` 와 `freshness.py` 는 ROS 없이 돎.

```bash
cd ~/HUPHY
PYTHONPATH=src python3 -m pytest tests/test_ros_convert.py tests/test_ros_freshness.py -q
```

`tests/conftest.py` 가 `ros/huphy_ros` 를 경로에 넣으므로 `PYTHONPATH` 에 따로 안
적어도 됨. 노드 둘은 `rclpy` 가 있어야 import 되어 여기서 안 봄.

---

---

## 안 될 때

```bash
echo $ROS_DOMAIN_ID          # 양쪽 같아야 함
echo $ROS_LOCALHOST_ONLY     # 비어 있거나 0
echo $RMW_IMPLEMENTATION     # 양쪽 같아야 함
ros2 node list               # 상대 노드가 보여야 함
ros2 topic info -v /huphy/joint_states    # QoS 가 양쪽 맞는지
```

| 증상 | 흔한 원인 |
|---|---|
| `ros2 node list` 에 상대가 없음 | `ROS_DOMAIN_ID` 가 다름 / 멀티캐스트가 막힘 |
| 토픽은 보이는데 값이 안 옴 | QoS 가 다름 |
| `joint_states` 가 안 뜸 | `control_node` 가 CAN 을 못 열었음. 로그를 볼 것 |
| `control_node` 가 시작하자마자 `호스트 id 가 규칙과 다른 모터` 로 끝남 | 갈아 끼운 모터의 호스트 id 를 안 맞춤. `python3 tools/can_scan.py` 로 보고 맞추거나 `-p send_mode:=seq` |

ROS 1(Noetic)이 같이 깔려 있으면 **같은 셸에서 둘 다 `source` 하지 말 것.**
`ROS_DISTRO`, `PYTHONPATH`, `CMAKE_PREFIX_PATH` 가 서로 덮어씀.

---

## 3D 로 보기 (RViz)

로봇이 실물 관절각대로 RViz 에서 움직임. **화면이 있는 기계**(보통 작업 기계)에서 띄움.
`control_node` 가 떠 있으면 됨 -- OBSERVE 면 충분하니 토크 없이 손으로 다리를 움직여 봄.

처음 한 번 (화면 있는 기계):

```bash
sudo apt install ros-humble-rviz2
```

```bash
ros2 launch huphy_ros view.launch.py
```

| 보이는 것 | 뜻 |
|---|---|
| 몸통이 공중에 고정, 다리만 움직임 | 정상. 몸통 위치·자세를 추정하는 것이 없어 `world -> base_link` 를 0 으로 박음 |
| 막대 끝이 발에서 떨어짐 | 크랭크각이 모델 범위 밖이라 못 풀었음. launch 화면에 `발목 링키지를 못 풂` 경고가 뜨고 직전 자세로 그림 |
| 로봇이 아예 안 움직임 | `ros2 topic hz /huphy/joint_states` 부터. 두 기계면 `ROS_DOMAIN_ID` 확인 |
| 한 관절만 안 움직임 | URDF 관절 이름이 다름. robot_state_publisher 는 **모르는 이름을 경고 없이 버림** |
| 실물과 반대로 돎 | 0점·방향이 학습 모델과 다름 -- 캘리브레이션 문제 (`config/README.md`) |
| 반투명 로봇이 하나 더 겹쳐 있음 | 목표 자세 (아래). `target:=false` 로 안 띄움 |
| 반투명 로봇이 안 보임 / Target 이 `No transform` | 정책 노드가 아직 목표각을 안 냄. `approach` 부터 나옴 |

**목표 자세 (반투명).** 정책 노드가 낸 `/huphy/joint_targets` 를 반투명한 두 번째 로봇으로
겹쳐 그림 -- 실측(진한 쪽)이 목표를 얼마나 따라가는지 바로 보임. 같은 세 노드(링키지·
robot_state_publisher·고정 TF)를 한 벌 더 띄우고 TF 이름에 `target/` 을 붙임. 목표각은
기준 자세로 가는 중·대기·정책 중에만 와서, 그 밖에는 마지막 목표 자세에 멈춰 있음. 색은 메시
색 그대로라 투명도로만 구분됨.

```bash
ros2 launch huphy_ros view.launch.py target:=false   # 실측만
```

URDF 는 학습 레포(Human-Pygmalion/HuphyChan-dev) 의 `LegOnly_..._v30_proxyfix_loop.urdf` 를
이름만 바꾼 사본임 (`urdf/huphy.urdf`, 메시는 `meshes/`). 원본이 바뀌면 다시 만듦:

```bash
A=<원본 레포>/pygmalion_locomotion/assets/pygmalion_v2/LegOnly_prototype-tempmass-motormeasured-armfix_v30_proxyfix_loop
python3 ros/huphy_ros/urdf/make_urdf.py $A.urdf $A.xml <원본 레포>/tools/robot_model/fusion_snapshots/v30_inspection/meshes_armfix
rm -rf ~/ros2_ws/build/huphy_ros/meshes ~/ros2_ws/install/huphy_ros/share/huphy_ros/meshes  # 메시 이름이 바뀌면 옛 링크가 남아 빌드가 실패함
ros/install.sh      # 새 파일을 설치 폴더에 넣음
```

정강이·발은 원본 URDF 의 메시 대신 MJCF 가 쓰는 `*_noloop.stl` 을 씀. 원본 메시에는 크랭크·막대가
0 자세로 붙어 있어서, 그대로 쓰면 움직이는 막대 옆에 고정된 막대가 하나 더 보임.

**발목.** URDF 는 크랭크 -> 막대 -> 발 고리를 못 적어서 발(`ankle_pitch/roll`)과 막대가 따로
매달려 있음. `joint_states` 에는 크랭크각(`ankle_a/b`)만 있으므로, `view.launch.py` 가 같이
띄우는 `linkage_node` 가 **URDF 치수로** 발 자세와 막대 각도를 풀어 붙임
(`/huphy/joint_states_view`). RViz 는 계산을 안 하고 받은 각도대로 그리기만 함.

`huphy` 의 `kinematics/ankle.py` 값을 안 쓰는 이유: 그쪽 링키지 치수가 학습 모델과 달라서
(크랭크 반지름 40mm 대 약 65mm 등) 그 발 자세를 URDF 에 넣으면 막대 끝이 발에서 수 mm ~
2cm 어긋남.

---

## 로그

노드 메시지와 `huphy` 라이브러리(CAN·모터·루프) 메시지가 **같은 ROS 로그**로 나감.
이름 앞에 노드가 붙어서 어디서 온 줄인지 보임.

```
[INFO] [...] [huphy_control]: OBSERVE 로 시작
[WARN] [...] [huphy_control.huphy.robots.leg]: right_leg/knee 응답 없음
```

| 어디서 보나 | 명령 |
|---|---|
| launch 를 띄운 터미널 | 그대로 찍힘 |
| 지난 실행 | `~/.ros/log/` 아래 실행마다 폴더 하나 |
| 두 기계 로그를 한곳에서, 레벨·노드로 걸러서 | `ros2 run rqt_console rqt_console` (`/rosout` 을 봄. 처음 한 번 `sudo apt install ros-humble-rqt-console`) |
| 화면 없이 | `ros2 topic echo /rosout` |

**자세히 보기 (DEBUG)** — 노드 이름을 붙여서 줄 것. 그냥 `debug` 를 주면 ROS 내부
(`rcl`, `rmw`) 로그까지 쏟아짐.

```bash
ros2 run huphy_ros control_node --ros-args -p config:=... --log-level huphy_control:=debug
```

특정 모듈만 조용히: `--log-level huphy_control.huphy.motors.canbus:=warn`. 노드보다 낮게
(더 자세히) 내리는 것은 안 됨 — 파이썬 쪽 문턱이 노드 레벨에 맞춰져 있음.

---

## 기록

위 "로그" 는 **글 메시지**임. 이 절은 **숫자 기록** -- `huphy-run --log` 이 남기는
JSON 두 파일을 ROS 로 돌릴 때도 남기는 것임.

### 켜는 법

**기록 노드 하나만 띄우면 됨.** 제어·정책 노드는 평소대로 띄우고 따로 켤 것 없음.

```bash
ros2 launch huphy_ros log.launch.py      # 아무 기계 (보통 작업 기계)
```

두 노드는 기록용 토픽(`/huphy/debug/*`)을 **구독자가 있을 때만** 냄 -- 기록 노드가 없으면
50Hz·100Hz 메시지를 만들지도 않음. 시작할 때 한 번 내는 설명 두 개(`policy_info`,
`control_info`)는 늘 내 두고 `transient_local` 이라 기록 노드를 나중에 띄워도 받음.

**`log_node` 를 정책 시작 전에 띄울 것.** 그 전에 흘러간 줄은 못 받음. 시작할 때
어디에 쓸 것인지가 로그에 찍힘.

### 나오는 파일

```
$HOME/HUPHY/ros/logs/policy/<월일>_policy_<정책>.json     tools/policy_viewer.html
$HOME/HUPHY/ros/logs/latency/<월일>_latency_<정책>.json   tools/latency_viewer.html
```

`log_node` 를 띄운 기계의 디스크임. `log:=` 로 바꿀 수 있음.

기본값이 **절대경로**인 이유: 상대경로면 런치를 어느 폴더에서 쳤는지에 따라 파일이
다른 데 생김. `log_node` 자체는 경로를 모름 -- 설치된 노드는
`~/ros2_ws/install/huphy_ros/lib/huphy_ros/log_node` 에서 돌고 소스 폴더가 어디인지
알 길이 없음 (`__file__` 은 빌드 방식에 달리고, `share/` 는 다시 빌드하면 지워지고,
`huphy.__file__` 은 `pip install -e` 여서 소스를 가리키는 것임). 그래서 경로는
**소스에 있는 런치 파일**이 정함.

`ros/logs/` 에 두는 이유: 이 폴더를 새 레포로 분리하면 기록도 같이 감. `huphy-run`
쪽은 `<레포>/logs/` 로 따로 남음.

같은 날 같은 정책으로 또 돌리면 `_2`, `_3` 이 붙음. **덮어쓰지 않음.** 두 파일의
이름을 `log_node` 한 곳에서 지으므로 번호가 같이 올라감.

### 무엇이 담기나

`huphy-run --log` 과 **같은 모양임.** 같은 코드가 씀
(`src/huphy/telemetry/policy_log.py`, `latency_log.py`). 다른 것은 `power/` 열
하나임 -- 이쪽에만 있음 (아래 [전력 열](#전력-열)).

| 파일 | 열 |
|---|---|
| `policy` | `t`, `obs/...`(정규화 전), `act/...`(모델 출력 날값), `tgt/...`(도), `pos/...`(도), `extra/...`(전류·전압·온도. `extra` 를 켰을 때만), `power/...`(구리 손실·DC 전류 하한. `extra` 를 켰을 때만. **`huphy-run` 기록에는 없음**) |
| `latency` | `t`, `joint`, `latency_ms`, `status`(제때/늦음/유실) |

`run` 칸에 `source: "ros"` 가 들어감 -- `huphy-run` 기록과 한 폴더에 섞여도
구별됨. 게인 배율은 ROS 에 파라미터가 없어 안 들어감.

### 모터 전류·전압·온도

`control.launch.py` 의 `extra` 인자로 켬. 기본값은 0 (끔) 이라 안 켜면 명령이
그대로임.

```bash
ros2 launch huphy_ros control.launch.py config:=$HOME/HUPHY/config/robot.yaml extra:=2
ros2 launch huphy_ros local.launch.py config:=... policy:=... extra:=2
```

**`extra` 는 읽기만 켬. 기록 노드를 띄우지 않음.** 파일에 남기려면 다른 터미널에서
`log.launch.py` 를 정책 시작 전에 띄울 것 (위 [켜는 법](#켜는-법)).

```bash
ros2 launch huphy_ros log.launch.py      # 터미널 2
```

값은 **한 주기에 다리마다 보낼 파라미터 읽기 요청 수**임. 전류·전압은 상태 응답
프레임에 없어서 따로 요청해야 함. 한 다리가 읽을 항목이 모터 6개 x 값 2개 =
12개이므로 `extra:=2` 면 6주기에 한 바퀴 -- 100Hz 기준 값 하나가 **약 17Hz** 로
갱신됨. 올리면 빨라지고 그만큼 CAN 프레임이 늘어남.

온도는 상태 응답 프레임에 있어서 매 주기 갱신됨. 다만 세 값을 한 메시지로 두므로
`extra` 가 0 이면 온도도 안 나감 -- 열이 중간부터 생기면 줄마다 열 수가 달라짐.

주기는 이렇게 흐름.

| 무엇 | 주기 |
|---|---|
| `control_node` 가 `/huphy/debug/motor_extra` 발행 | `state_hz` (기본 100Hz) |
| `log_node` 가 구독 | 100Hz. 마지막 메시지만 둠 |
| 파일에 기록 | 정책 줄 주기 (50Hz). 줄이 올 때 마지막 값을 넣음 |
| `iq`·`vbus` 값 갱신 | `extra:=2` 면 약 17Hz. 연속 두세 줄에 같은 값이 기록됨 |
| `temp` 값 갱신 | 100Hz |

파일의 열 이름은 `huphy-run --extra` 와 같음 (`extra/<모터>/iq`, `/temp`, `/vbus`).
같은 뷰어로 봄. `run` 칸에 `extra` 값이 들어감.

#### 전력 열

`extra` 를 켜면 `log_node` 가 받은 상전류로 구리 손실을 계산해 열을 더 만듦. 따로
켜는 인자는 없음.

```
power/<모터>/copper_w   그 모터의 구리 손실 (W)
power/<모터>/dc_a_lo    그 모터의 DC 전류 하한 (A) = 그 모터의 구리 손실 / 그 모터의 vbus
power/copper_w          모터 전부의 합 (W)
power/dc_a_lo           DC 전류 하한 합 (A) = 합 / vbus 평균
```

    P_cu = 1.5 * iq**2 * R_phase

`R_phase` 는 모델별 사양값임. `control_node` 가 `control_info` 에 모델명
(`motor_models`, `robot.yaml` 의 `model`) 을 실어 보내고 `log_node` 가 상수로 바꿈
-- 모터가 다른 기계에 있어서 설정 파일을 못 읽음.

**`dc_a_lo` 는 하한임.** 모터가 DC 전류도 전력도 안 내서(매뉴얼의 읽기 가능 항목이
네 개뿐임) 구리 손실만 계산함. 기계 출력·철손·인버터 손실·감속기 손실이 빠져 있음
([docs/motor_power.md](../docs/motor_power.md)).

한 모터라도 상전류를 아직 못 받았으면 그 줄의 합이 `null` 임 -- 일부만 더한 값을
전체 합으로 읽지 않게 함. 사양을 안 넣은 모델(RS00·RS02)뿐이면 열을 아예 안 만듦.
`huphy-run --extra` 기록에는 이 열이 없음.

**`send_mode` 가 `burst` 여야 함.** 읽기 응답에 모터 id 가 없어서 CAN id 로 가름.
`seq` 로 띄우면 `control_node` 가 시작할 때 멈춤.

구독자가 없으면 `control_node` 가 이 토픽을 안 냄. 다만 **CAN 읽기 요청은 `extra`
파라미터로 켜는 것이라 `log_node` 가 없어도 보냄.** 안 보내려면 `extra:=0` 으로
띄울 것.

#### 전류 실측 열

전류계를 꽂았으면 `current_node` 를 같이 띄움 (아래 [노드](#3-노드) 3-4).
`log_node` 가 그 토픽을 받아 열을 더 만듦.

```bash
ros2 launch huphy_ros log.launch.py        # 터미널 2
ros2 launch huphy_ros current.launch.py    # 터미널 3. 포트가 헷갈리면 port:= 로
```

```
current/total_a   전류계가 잰 로봇 전체 DC 전류 (A). 실측
current/age       그 값이 장비에서 온 뒤 흐른 시간 (ms). 못 받았으면 -1
```

**계산값 `power/dc_a_lo` 와 같아질 수 없음.** 차이가 두 가지에서 옴.

| | |
|---|---|
| 빠진 손실 | 철손 + 인버터 + 감속기 + 기계 출력 -> 계산값이 작음 |
| 범위 차이 | 실측은 모터 말고 연산보드·팬·통신까지 다 포함 -> 실측이 큼 |

그래서 두 열을 바로 빼서 손실로 읽으면 안 됨. 로봇을 세워 둔 채 잰 값을 기준선으로
빼면 비교가 됨 (`huphy-current` 가 평균을 찍어 줌).

`age` 가 따로 있는 이유: 장비 출력 주기가 정책 줄 주기(50Hz)보다 느려 같은 값이 여러
줄에 반복됨. 없으면 "전류가 안 변함" 과 "장비가 멈춤" 이 구분되지 않음. 이 값은
`current_node` 가 재서 실어 보낸 것이므로 **그 기계 기준**임 -- 두 기계 시계를 안
맞추므로 전달 시간은 안 들어 있음 (`freshness.py` 와 같은 이유).

열은 **첫 `bus_current` 가 왔을 때 생김.** 정책이 도는 중에 `current_node` 를 띄우면
그 실행은 열 없이 끝나고 다음 실행부터 생김 -- 이미 쌓인 줄이 있는데 기록을 다시
만들면 그 줄들이 날아감. 열이 생긴 뒤에는 값이 안 와도 남고 `age` 가 `-1` 임.

파일의 열 이름은 `huphy-run --current` 와 같음. 같은 뷰어로 봄.

### 어느 구간이 담기나

`policy_status` 의 단계가 `running` 인 동안만. 접근·대기·감쇠가 빠짐 --
`huphy-run` 이 맞추는 구간과 같음.

`stop_policy` 한 번이 한 실행임. 그때 두 파일을 씀. Ctrl-C 로 끝내도 남음.

### 파일을 쓰는 것이 왜 따로 있나

**기계가 둘임** (결정 13). 두 노드가 각자 쓰면 정책 기록은 작업 기계에, 지연 기록은
모션보드에 떨어짐.

그리고 쓰는 데 **1분 기록이 220~260ms, 5분이면 1.2~1.3초** 걸림 (측정). 두 노드는
단일 스레드 executor 에서 100Hz·50Hz 타이머를 돌리므로 그 안에서 쓰면 낡음 기준
60ms/100ms 를 넘겨 감쇠 정지로 번짐 (결정 12). `log_node` 에는 타이머가 없음.

### 안 될 때

| 증상 | 이유·할 것 |
|---|---|
| 파일이 안 생김 | `stop_policy` 를 안 불렀거나 `running` 구간이 없었음. `ros2 topic echo /huphy/policy_status --once` 로 단계 확인 |
| `log_node` 가 "정책 줄 N개를 못 받음" | 정책이 시작한 뒤에 띄웠음. 먼저 띄울 것 |
| 지연 파일만 안 생김 | 모션보드와 기록 노드 기계가 서로 안 보임 (`ROS_DOMAIN_ID`). `ros2 topic info /huphy/debug/latency` 의 구독자 수 확인 |
| 정책 파일만 안 생김 | 정책 노드가 기록 노드를 못 봄. `ros2 topic info /huphy/debug/policy_row` 의 구독자 수 확인 |
| `loop_status` 의 `latency_pending` 이 계속 큼 | 발행이 밀림. 24 안쪽이 정상. `ros/huphy_ros/huphy_ros/latency_tap.py` 의 `MAX_EVENTS` 를 넘으면 오래된 사건이 버려짐 |
| `limits` 칸이 빈 파일 | `control_info` 를 못 받았음. `control_node` 가 떠 있는지, 두 기계가 서로 보이는지 확인 |

---

---

# 아래는 설계

왜 이렇게 만들었는지. 고치거나 늘릴 때 볼 것.

## 0. 정해진 것

| # | |
|---|---|
| 1 | 관절상태 → 정책 → 관절목표각 한 바퀴가 **네트워크를 건너감** |
| 2 | 목표각이 끊기면 **감쇠 후 토크 차단** |
| 3 | 기준 자세로 옮기는 접근 단계는 **`policy_node`** 가 함 |
| 4 | 사람이 보내는 것: 속도 명령(`vx`, `wz`) / 시작·정지·토크 / 관절 목표각 직접 |
| 5 | **정책 교체 없음.** 다른 정책은 `policy:=` 를 바꿔 노드 재시작 |
| 6 | 추론은 **타이머**, 주기는 정책 계약을 따름 (지금 둘 다 50Hz). 상태가 낡으면 목표각을 안 내보냄 |
| 7 | IMU 는 **모션보드**에 붙음. 관절 상태와 같이 네트워크를 건너감 |
| 8 | `/huphy/joint_targets` **하나**를 정책과 pose 가 같이 씀. 중재 없음 |
| 9 | 기계 간 **시계 동기 없음.** 각 노드가 자기 시계로 도착 간격만 봄 |
| 10 | 상태 발행 주기는 파라미터, **기본 100Hz** |
| 11 | 제어 토픽은 **표준 메시지**만. 기록 토픽 4개만 직접 정의 (`huphy_ros_interfaces`) — 아래 [기록](#기록) |
| 12 | 낡음 기준 **60ms / 100ms**, 통신두절 5주기 |
| 13 | **기계 둘.** 모션보드에 `control_node`, 작업 기계에 `policy_node` 와 사람 |

정책은 꾸러미 폴더 하나임 (`config/policies/<이름>/deploy_contract.json` + `.pt`).
`policy_node` 는 [`control/deploy.py`](../src/huphy/control/deploy.py) 로 그 계약을
읽어 돌림 — `huphy-run` 과 같은 코드임. 명령은 정책에 있는 칸만 씀.

| 정책 | 관찰 | 명령 토픽 |
|---|---|---|
| `walk` | 44 | `/huphy/cmd_vel` (Twist) 의 `linear.x` -> `vx`, `angular.z` -> `wz`. `vy` 칸 없음 |
| `stair_slope` | 44 | 같은 토픽, `linear.x` -> `vx` 만. **`angular.z` 는 0 으로 잘림** |
| `squat` | 43 | `/huphy/h_star` (Float64) -> `h_star` [m]. 0.1 m/s 로 다가감 |

**정책이 명령 범위도 정함.** 계약의 `observations[].ranges` 에 적힌 범위 밖의 값은
[`control/deploy.py`](../src/huphy/control/deploy.py) 의 `_command` 가 관찰에 넣기 전에
자름. `stair_slope` 는 전진만 학습해서 `vx` 가 `[0, 2]`, `wz` 가 `[0, 0]` 임 --
`/huphy/cmd_vel` 의 `angular.z` 에 무엇을 보내도 신경망은 0 을 받고, 조작 노드 둘은
그 칸에 키·스틱을 아예 안 배정함.

---

---

## 1. ROS 개념 — 이 로봇에 짝지어서

| 개념 | 무엇 | 여기서 |
|---|---|---|
| 노드 | 프로세스 하나 안에서 도는 작업 단위 | `control_node`, `policy_node` |
| 토픽 | 이름이 붙은 단방향 방송. 받는 쪽이 없어도 보냄 | 관절 상태, IMU, 목표각, 속도 명령 |
| 서비스 | 요청-응답 한 쌍 | 토크 on/off, 정책 시작·정지 |
| 파라미터 | 노드마다 가지는 설정값 | 설정 파일 경로, 주기, 임계값 |
| 메시지 | 주고받는 자료형 | `sensor_msgs/JointState` 등 표준만 |
| QoS | 토픽마다의 신뢰성 설정 | 3-4 |
| 런치 | 노드 여러 개를 한 번에 띄우는 파이썬 스크립트 | 7-3 |

**액션은 안 씀.** 오래 걸리는 것이 접근 단계 하나인데 그건 `policy_node` 안에서
끝남 (결정 3).

---

---

## 2. 전체 그림

```
        모션보드  (로봇에 붙음)                    작업 기계
 ┌──────────────────────────┐          ┌──────────────────────────┐
 │ control_node             │          │ policy_node              │
 │                          │          │                          │
 │  메인    rclpy.spin()    │          │  메인   rclpy.spin()     │
 │  제어    ControlLoop     │          │         + 20ms 타이머    │
 │          100Hz           │          │                          │
 │  rx x2   CanBus          │          │  .pt -> numpy MLP        │
 │                          │          │  q(t-1), last_action 보관│
 └───┬──────────────────┬───┘          └────┬────────────────┬────┘
     │                  │                   │                │
     │ CAN              │   joint_states    │                │
     │ canr/canl        ├──────100Hz───────>│                │
     │ 시리얼 IMU       │   imu, gravity    │                │
     │                  │                   │                │
     │                  │<─────50Hz─────────┤                │
     │                  │   joint_targets   │                │
     v                  │                   │   cmd_vel      │
  모터 12개             │<┄┄ enable ┄┄┄┄┄┄┄ │ approach·start │
  IMU                   │     disable       │        ↓       │
                        │                   │  ┌──────────┐  │
                        ├┄┄ loop_status ┄┄> │  │  사람    │<─┘
                        │                   │  │ bag·rqt  │
                        │                   │  └──────────┘
                        └───────────────────┴──────────────────────┘
                              네트워크
                     ROS_DOMAIN_ID 양쪽 같게 · 유선
```

### 네트워크를 타는 것과 안 타는 것

```
탐         joint_states  imu  gravity      100Hz   모션 -> 작업
           joint_targets                    50Hz   작업 -> 모션
           loop_status                       5Hz   모션 -> 작업
           enable  disable                   사람  작업 -> 모션

안 탐      CAN 프레임                            모션보드 안
           시리얼 IMU 읽기                        모션보드 안
           가드·통신두절 판정                     모션보드 안
           신경망 추론                            작업 기계 안
           q(t-1) 보관                            작업 기계 안
           cmd_vel                               작업 기계 안
           approach / start_policy / stop_policy 작업 기계 안
```

### 한 주기에 값이 지나는 길

```
 1  모터 12개 ──CAN──> CanBus ──> Leg ──> Biped
                                            │ Observation (도, cal)
 2                            control_node ─┤
                                            │ JointState (rad) + Imu + Vector3
 3                      ─────네트워크─────> policy_node
                                            │
 4                            observation_vector(44칸)
                                 0-2   각속도        rad/s
                                 3-5   중력방향      단위벡터
                                 6-17  q(t-1)-기본   rad
                                 18-29 q(t)  -기본   rad
                                 30-41 직전 행동     날것
                                 42-43 vx, wz        cmd_vel 에서
 5                            model(vector) -> 행동 12
 6                            joint_targets() -> 목표각 12 (도)
                                            │ JointState (rad)
 7                      <────네트워크────── │
                                            │
 8  control_node ──> Biped ──> Leg ──> 가드 ──> MitCommand ──CAN──> 모터
```

4번의 관찰 배치는 계약 파일이 정하고 `deploy.DeployPolicy.observation_vector` 가
만듦. **`policy_node` 는 `deploy.Runner.step` 을 그대로 부름** — 배치를 ROS 쪽에서
다시 만들지 않음.

### 노드가 들고 있는 상태

둘 다 스레드가 둘 이상이라, 스레드 사이에 넘기는 값만 적음.

```
control_node
  Latest      최신 관찰        제어 스레드 -> 발행 타이머
  Freshness   최신 목표각      구독 콜백   -> 제어 스레드   기준 100ms

policy_node
  Freshness   최신 관절 상태   구독 콜백   -> 추론 타이머   기준 60ms
  Freshness   최신 IMU         구독 콜백   -> 추론 타이머   기준 60ms
  Runner      q(t-1), last_action, 명령    추론 타이머 (명령은 구독 콜백이 set)
```

명령 토픽만 나이를 안 보는 이유: 안 오면 계약의 시작값으로 두면 되고(walk 는
제자리, squat 는 기본자세 높이), 끊겼다고 로봇을 멈출 이유가 아님.

---

---

## 3. 노드

### 3-1. `control_node` — 모션보드

```
하는 일   ControlLoop 를 자기 스레드에서 돌림. CAN 송수신. IMU 읽기
          가드(safety/guards.py)와 통신두절 판정(safety/link.py)은 여기서 돎
받음      /huphy/joint_targets        관절 목표각 12개
          /huphy/enable, /disable     서비스
보냄      /huphy/joint_states         모터 12개 위치·속도·토크 (발목은 ankle_a/b)
          /huphy/imu                  각속도·가속도
          /huphy/gravity              중력방향 3칸
          /huphy/loop_status          주기·밀림·무응답
          /huphy/debug/control_info   주기·수거 대기·관절 이름·모델명·가동범위 (1회)
          /huphy/debug/latency        송신·수신 사건 (100Hz, 기록 노드가 있을 때만)
          /huphy/debug/motor_extra    전류·전압·온도 (100Hz, extra 가 1 이상이고
                                      기록 노드가 있을 때만)
```

**정책을 모름.** 목표각을 누가 보냈는지도 모름 (결정 8).

### 3-2. `policy_node` — 작업 기계

```
하는 일   .pt 를 읽어 추론. 관찰 44칸 조립, q(t-1) 보관, 행동 -> 목표각
          접근 단계(기준 자세로 보간)도 여기서 함
받음      /huphy/joint_states, /huphy/imu, /huphy/gravity
          /huphy/cmd_vel              속도 명령
          /huphy/approach, /start_policy, /stop_policy   서비스
보냄      /huphy/joint_targets        관절 목표각 12개
          /huphy/policy_status        단계·상태 나이·멈춘 이유
          /huphy/debug/policy_info    열 이름·관절 순서·체크포인트 (1회)
          /huphy/debug/policy_row     추론 한 번 (50Hz, 기록 노드가 있을 때만)
```

**CAN 을 모름.** 모터가 몇 개인지, id 가 뭔지 모름.

### 3-3. `log_node` — 아무 기계 (선택)

```
하는 일   토픽을 받아 huphy-run --log 과 같은 JSON 두 파일을 씀. 제어도 추론도 안 함
받음      /huphy/debug/policy_info, /policy_row
          /huphy/debug/control_info, /latency, /motor_extra
          /huphy/bus_current          전류계 실측 (current_node 를 띄웠을 때만)
          /huphy/policy_status        단계. running 인 동안만 쌓음
보냄      없음
```

**설정 파일을 안 읽음.** 열 이름·관절 순서·가동범위·주기·모터 모델명이 전부 두
`*Info` 토픽으로 옴 (`transient_local` 이라 늦게 띄워도 받음). 모델명은 전력 열의
상저항을 가르는 데 씀 (`ControlInfo.motor_models`).

따로 있는 이유와 파일 경로는 위 [기록](#기록).

### 3-4. `current_node` — 전류계를 꽂은 기계 (선택)

```
하는 일   전류계(WCM1600)로 로봇 전체 DC 전류를 재서 냄. 제어도 추론도 안 함
받음      없음
보냄      /huphy/bus_current          전류 (A) · 값이 온 뒤 흐른 시간 (ms), 20Hz
```

```bash
ros2 launch huphy_ros current.launch.py
ros2 launch huphy_ros current.launch.py port:=/dev/ttyUSB1
```

`log_node` 와 **같이 띄워야** 기록에 열이 남음 (`current/total_a`, `current/age`).
다른 런치에 들어 있지 않음 -- 전류계가 없는 실행이 대부분이고, 없으면 이 노드는
포트를 못 열어 멈춤. 그래도 **로봇은 멈추지 않음**: 이 노드는 아무것도 제어하지
않고, 제어·정책 노드는 이 토픽을 보지 않음.

**어느 기계에 꽂아도 됨.** 모터와 달리 CAN 과 무관해서 작업 기계에 꽂고 이 노드만
그쪽에서 띄워도 `log_node` 가 받음 (결정 13).

`control_node` 에 넣지 않은 이유는 둘임. 안 꽂혀 있을 때마다 그 노드가 포트를
뒤지게 되고, 장비가 9600 baud 라 8바이트 프레임 하나가 선로에 8.3ms 걸림 -- 제어
주기가 10ms 임. 읽기는 스레드가 하므로 주기 안에서 기다리지는 않지만 같은
프로세스에 둘 이유가 없음.

이 값은 `power/dc_a_lo`(모터 상전류로 계산한 하한)와 **같아질 수 없음.** 위
[기록](#기록) 의 전류 실측 열 절.

### 3-5. 사람이 치는 것

노드를 안 만듦. `policy_node` 와 **같은 기계**에서 기성 도구로 함.

```
ros2 service call /huphy/enable std_srvs/srv/Trigger
ros2 topic pub -r 20 /huphy/cmd_vel geometry_msgs/msg/Twist '{}'
ros2 bag record -a
rqt_plot /huphy/joint_states/position[3]
```

---

---

## 4. 토픽

| 토픽 | 타입 | 내는 쪽 | 주기 | QoS |
|---|---|---|---|---|
| `/huphy/joint_states` | `sensor_msgs/JointState` | control | 100Hz | sensor_data |
| `/huphy/imu` | `sensor_msgs/Imu` | control | 100Hz | sensor_data |
| `/huphy/gravity` | `geometry_msgs/Vector3Stamped` | control | 100Hz | sensor_data |
| `/huphy/loop_status` | `diagnostic_msgs/DiagnosticArray` | control | 5Hz | 기본 |
| `/huphy/joint_targets` | `sensor_msgs/JointState` | policy 또는 사람 | 50Hz | sensor_data |
| `/huphy/cmd_vel` | `geometry_msgs/Twist` | 사람 | 10~20Hz | 기본 |
| `/huphy/policy_status` | `diagnostic_msgs/DiagnosticArray` | policy | 5Hz + 단계 전이 직후 | 기본 |

**제어가 쓰는 것은 전부 표준 메시지임** (결정 11). 기록용 토픽 다섯만 직접 정의한
타입을 씀 (`huphy_ros_interfaces`).

| 토픽 | 타입 | 내는 쪽 | 주기 | QoS |
|---|---|---|---|---|
| `/huphy/debug/policy_info` | `huphy_ros_interfaces/PolicyInfo` | policy | 1회 | transient_local |
| `/huphy/debug/policy_row` | `huphy_ros_interfaces/PolicyRow` | policy | 50Hz | sensor_data |
| `/huphy/debug/control_info` | `huphy_ros_interfaces/ControlInfo` | control | 1회 | transient_local |
| `/huphy/debug/latency` | `huphy_ros_interfaces/LatencyBatch` | control | 100Hz | sensor_data |
| `/huphy/debug/motor_extra` | `huphy_ros_interfaces/MotorExtra` | control | 100Hz | sensor_data |
| `/huphy/bus_current` | `huphy_ros_interfaces/BusCurrent` | current | 20Hz | sensor_data |

`policy_row` · `latency` · `motor_extra` 는 구독자(`log_node`)가 있을 때만 나감.
`bus_current` 는 구독자와 무관하게 나감 -- `current_node` 를 띄운 것 자체가 "지금
재겠다" 는 뜻임. 쓰는 쪽은 `log_node` 하나임 -- 아래 [기록](#기록).

### 4-0. 기록용 토픽만 직접 정의한 이유

제어 토픽은 표준 타입에 들어갈 자리가 있었음. 기록은 아님.

| 담아야 하는 것 | 표준 타입으로 |
|---|---|
| 관찰 벡터 44칸 + 행동 12칸을 **한 메시지로** | `Float64MultiArray` 로 56칸을 보낼 수 있음. 다만 칸 이름이 없어 `ros2 topic echo` 와 `rqt_plot` 에서 숫자 뭉치로만 보임 |
| 관절 이름 · 지연 ms · 제때/늦음/유실 | 맞는 것이 없음. `JointState` 의 `position` 에 지연을 넣으면 **필드 이름과 담는 내용이 달라지고**, 같은 타입을 보는 기성 도구(rviz 등)가 관절 상태로 읽음 |
| 발행 시각 (`Header`) | `Float64MultiArray` 에 `Header` 가 없음 |

`huphy_ros_interfaces` 를 `ament_cmake` 로 따로 두는 것이 ROS 2 의 보통 구성임.
`huphy_ros` 는 `ament_python` 그대로 남음.

### 4-1. 중력방향을 따로 내보내는 이유

`sensor_msgs/Imu` 에는 `orientation`(쿼터니언), `angular_velocity`,
`linear_acceleration` 만 있음. **중력방향 3칸이 들어갈 자리가 없음.**

이 저장소의 `ImuState` 는 자세를 중력방향으로만 들고 있음
([`sensors/base.py`](../src/huphy/sensors/base.py) 의 `gravity`). 벤더 모듈이
쿼터니언이든 오일러든 받아서 중력방향으로 만들어 올리는 구조이고, 정책이 쓰는 것도
그 3칸임 (계약의 `imu_gravity` 항목).

쿼터니언으로 되돌려 넣었다가 정책 쪽에서 다시 풀면 **왕복에서 틀릴 자리가 생김.**
그래서 `Vector3Stamped` 로 그대로 내보냄.

`Imu` 토픽도 같이 내는 이유는 표준 도구(rviz, 기록)가 그걸 보기 때문임.

### 4-2. `joint_targets` 에 `JointState` 를 쓰는 이유

목표각 전용 표준 메시지가 없음. `JointState` 의 `name` 과 `position` 만 채우고
`velocity`/`effort` 는 비움.

**받는 쪽은 `name` 을 봐야 함.** 배열 순서를 믿으면 보내는 쪽이 순서를 바꿨을 때
조용히 엉뚱한 관절이 움직임.

### 4-3. QoS

| | |
|---|---|
| `sensor_data` | BEST_EFFORT, depth 5. 빠진 것을 다시 안 보냄 |
| 기본 | RELIABLE, depth 10. 빠지면 다시 보냄 |

고주기 값에 RELIABLE 을 쓰면 안 됨 — 다시 보낼 때쯤이면 이미 낡은 값이고, 재전송이
새 값 뒤에 줄을 섬.

**보내는 쪽과 받는 쪽 설정이 다르면 연결이 아예 안 됨.** 에러도 경고도 없이 토픽이
비어 있음. `ros2 topic info -v <토픽>` 으로 양쪽을 확인함.

---

---

## 5. 단위와 이름

### 5-1. 단위

ROS 는 SI 를 씀 (REP 103). 이 저장소는 도를 씀.

| | huphy 안쪽 | ROS 경계 |
|---|---|---|
| 각도 | 도 | 라디안 |
| 각속도 | 도/초 | rad/s |
| 토크 | Nm | Nm (같음) |

변환은 `huphy_ros/convert.py` **한 곳에만** 둠. 저장소 안에 도↔라디안이 이미 두
곳 있는데(프로토콜 경계 `codec/mit.py`, 모델 경계 `control/deploy.py`)
서로 안 만남. 세 번째가 여기저기 흩어지면 어디서 한 번 더 변환됐는지 추적이 안 됨.

### 5-2. 관절 이름

`Biped` 는 `right_leg/knee` 처럼 `/` 로 팔다리를 앞에 붙임
([`robots/biped.py`](../src/huphy/robots/biped.py) 의 `SEP`).

ROS 에서 `/` 는 네임스페이스 구분자라 사람이 토픽 이름과 헷갈림. 경계에서 바꿈.

```
huphy   right_leg/knee
ROS     right_leg__knee
```

---

---

## 6. 주기와 끊김

### 6-1. 정책 추론은 타이머가 돌림

`policy_node` 가 20ms 타이머로 추론함 (결정 6). 메시지 도착이 아니라 타이머인
이유: **네트워크 지터가 그대로 추론 간격의 지터가 되기 때문**임.

정책은 20ms 간격으로 불린다고 가정하고 학습했고, 관찰의 관절 이력 `q(t-1)` 이
정확히 한 정책 주기 전 값이어야 함 (계약의 `motor_encoder_rel.history_frames`,
`control_rate_hz`).

```
타이머 20ms
  마지막 joint_states 나이 < 60ms   -> 추론하고 목표각을 냄
  나이 >= 60ms                      -> 아무것도 안 냄
```

`q(t-1)` 은 **직전 추론 때 쓴 관절각**임. 메시지 순번이 아니라 추론 호출 기준이므로,
중간에 상태가 두 번 와도 한 번만 쓰고 한 번은 버림.

### 6-2. 끊겼을 때 — 두 단계

```
상태가 60ms 넘게 안 옴
  policy_node 가 목표각 발행을 멈춤        policy_status 에 이유를 적음
      |
      | 40ms 더 지남
      v
control_node 가 목표각을 100ms 넘게 못 받음
  ControlLoop 을 멈춤 -> damp(kp=0) 5초 -> 토크 차단 -> 스스로 OBSERVE 로 돌아감
```

`stop_policy` 를 불러도, `policy_node` 가 꺼져도 이 길을 탐. **OBSERVE 로 돌아가므로 상태는
계속 읽힘.** 다시 돌리려면 `enable` → `approach` → `start_policy`.

`enable` 직후 목표각이 **아직 한 번도 안 왔으면** 이 판정을 안 함 — 그 동안은 감쇠 명령을 보냄
(실행 A-3 / B-2).

`100 > 60` 이므로 순서가 뒤바뀌지 않음. 정책이 먼저 멈추고, 그 뒤에 제어가 멈춤.

| 값 | 어디 | 뜻 |
|---|---|---|
| 60ms | `policy_node` | 상태가 이보다 낡으면 목표각을 안 냄. 50Hz 기준 3주기 |
| 100ms | `control_node` | 목표각이 이보다 안 오면 감쇠. 50Hz 기준 5주기 |
| 5주기 | `robot.yaml` 의 `safety.link_loss_cycles` | 모터가 연속으로 답을 안 하면 정지 |

앞의 둘은 **실물 측정 전의 제안값**임.

### 6-3. 시계

기계 간 시계를 안 맞춤 (결정 9). 각 노드가 **자기 시계로 마지막 수신 이후 흐른
시간**만 봄. 편도 지연은 알 수 없고, 끊겼는지는 알 수 있음.

메시지의 `header.stamp` 는 **채워서 보내되 나이 판정에는 안 씀.** 기록(`ros2 bag`)과
나중에 시계를 맞출 때를 위해 남겨 두는 것임.

---

---

## 7. 안전

| 상황 | 막는 것 | 어디 |
|---|---|---|
| 목표각이 안 옴 | 감쇠 후 토크 차단 | `control_node`, 100ms |
| 상태가 안 옴 | 목표각 발행 중단 | `policy_node`, 60ms |
| 모터가 답을 안 함 | 루프 정지 | `safety/link.py`, 이미 있음 |
| 한계·점프 | 자름 | `safety/guards.py`, 이미 있음 |
| 명령값이 NaN | 그 모터만 안 보냄 | `safety/guards.py`, 이미 있음 |
| 노드를 `kill -9` | **못 막음.** 토크가 켜진 채 남음 | — |

**토크는 명시해야 들어감.** `control_node` 가 `Mode.OBSERVE` 로 시작하고,
`/huphy/enable` 서비스를 받아야 `Mode.CONTROL` 이 됨.

**정책과 pose 를 동시에 쓰면 안 됨** (결정 8). 토픽 하나를 같이 쓰므로 둘 다 쏘면
번갈아 들어감. 사람이 `policy_node` 를 시작·정지해서 정함.

---

---

## 8. 코드

### 8-1. 파일

| 파일 | 하는 일 | `rclpy` |
|---|---|---|
| `huphy_ros/convert.py` | 도↔라디안, 관절 이름 변환 | **안 씀** |
| `huphy_ros/freshness.py` | 받은 값과 그 나이. 낡음 판정 | **안 씀** |
| `huphy_ros/control_node.py` | `ControlLoop` 를 자기 스레드에서. CAN | 씀 |
| `huphy_ros/policy_node.py` | 20ms 타이머 추론. 접근 단계 | 씀 |
| `huphy_ros/logbridge.py` | 파이썬 `logging` → ROS 로그. 노드 시작 때 붙임 | 씀 |
| `huphy_ros/linkage.py` | 크랭크각 -> 발 자세·막대 각도 (URDF 치수). RViz 용 | **안 씀** |
| `huphy_ros/linkage_node.py` · `launch/view.launch.py` · `urdf/` · `meshes/` · `rviz/` | RViz 로 보기. URDF 는 `urdf/make_urdf.py` 로 만듦 | 씀 |
| `huphy_ros/current_node.py` · `launch/current.launch.py` | 전류계로 로봇 전체 DC 전류. 필요할 때만 띄움 | 씀 |

앞의 둘이 `rclpy` 를 안 쓰는 것이 의도임. 거기 있는 판단(단위, 이름, 낡음)이 틀리면
로봇이 잘못 움직이는데 **틀려도 길이와 자릿수가 그대로라 코드로는 안 잡힘.** ROS 가
없는 기계에서 테스트가 돌아야 고정해 둘 수 있음.

### 8-2. `convert.py`

| 함수 | 방향 |
|---|---|
| `to_ros_name` / `to_huphy_name` | `right_leg/knee` ↔ `right_leg__knee` |
| `joint_names` | 관찰 사전에서 관절 이름을 뽑음. `.pos` 가 있는 것만 |
| `observation_to_arrays` | 관찰(도) → `JointState` 네 배열(rad) |
| `arrays_to_observation` | `JointState` → 관찰 사전. `policy_node` 가 씀 |
| `targets_to_arrays` | 목표각(도) → `JointState`(rad). 순서는 `ORDER` 가 정함 |
| `arrays_to_targets` | `JointState` → `Action`(도). `control_node` 가 씀 |
| `imu_arrays` | `ImuState` → 각속도(rad/s)·가속도·중력방향 |
| `extra_to_columns` | `MotorExtra` 세 배열 → `extra/<모터>/<값>` 열 |
| `current_to_columns` | `BusCurrent` → `current/total_a`·`current/age` 열 |

**없는 항목은 `0.0` 으로 채움.** `JointState` 는 네 배열의 길이가 같아야 하고 다르면
받는 쪽이 짝을 못 맞춤 — 0 이 옳은 값이라는 뜻이 아니라 길이를 맞추는 것이 필수라서임.

**길이가 다르면 멈춤.** `zip` 은 짧은 쪽에 맞춰 조용히 잘라서, 관절 하나가 빠진
명령이 그대로 통과함.

### 8-3. `freshness.py`

```python
Freshness(stale_s, clock=time.monotonic)
    put(value)          받은 값을 넣음. ROS 콜백에서
    take() -> (값, 쓸 수 있나)
    age()               마지막 수신 이후 초. 없었으면 -1.0
    clear()             비움

Latest()
    put(value) / take()     나이를 안 봄
```

`Latest` 는 반대 방향에 씀 — 제어 스레드가 관찰을 써 두고 발행 타이머가 꺼냄.
발행이 한 번 늦는 것은 문제가 아니므로 낡음 판정이 필요 없음.

**"아직 없음" 을 `None` 으로 둠.** `0.0` 을 쓰면 안 되는 이유는 `clock()` 이
정말로 `0.0` 을 낼 수 있기 때문임 — `monotonic` 은 기준점이 정해져 있지 않음.
만들다 이걸 테스트가 잡았음.

`time.monotonic` 을 쓰는 이유: 벽시계는 보정으로 뒤로 갈 수 있어 나이가 음수가 됨.
`huphy` 전체가 같은 이유로 `monotonic` 을 씀.

### 8-4. `control_node.py` — 모드를 루프 재시작으로 바꿈

`ControlLoop` 는 모드를 **생성할 때** 받고 `_enter` 에서 `enable()`/`disable()` 을
부름. 돌고 있는 루프의 모드를 바꾸는 길이 없음.

```
시작        OBSERVE 루프를 띄움        토크 안 들어감
/enable     OBSERVE 를 멈추고 CONTROL 루프를 새로 띄움
/disable    CONTROL 을 멈춤 -> finally 가 감쇠 후 토크 차단
```

로봇 객체는 그대로 두고 루프만 바꿈. `_enter` 가 `is_connected` 를 보고 이미
연결돼 있으면 다시 안 엶.

`CONTROL` 을 멈출 때는 `_exit` 가 `DAMPING_S`(5초) 동안 감쇠를 보냄. 그만큼 걸림.

**`enable` 서비스는 토크가 실제로 들어갔는지 확인하고 답함.** 루프를 띄우기만 하고
성공으로 답하면, `robot.enable()` 이 실측값이 없어 예외를 낼 때 스레드가 조용히
죽는데 부르는 쪽은 토크가 들어간 줄 앎.

**목표각이 낡으면 `_motion` 안에서 `loop.stop()`.** 플래그만 세우는 일이라 그 주기는
정상으로 끝나고, `finally` 가 감쇠 뒤 토크를 끊음 (결정 2).

### 8-5. `policy_node.py` — 네 단계

```
꺼짐      아무것도 안 냄
접근      지금 자세에서 기준 자세로 approach_s 초 동안 보간한 목표각
대기      기준 자세를 계속 냄. 사람이 자리를 잡는 시간
정책      신경망 출력
```

`/huphy/approach` 가 꺼짐 → 접근, `approach_s` 가 지나면 저절로 대기. `/huphy/start_policy`
가 대기 → 정책 (`huphy-run` 의 Enter) -- 대기가 아니면 이유를 붙여 거절함.
`/huphy/stop_policy` 가 어디서든 꺼짐으로.

접근과 정책 시작을 나눈 이유: 하나로 묶여 있으면 기준 자세에 도착하자마자 정책으로 넘어가서,
로봇이 제대로 섰는지 보고 시작할 틈이 없음. `huphy-run` 도 기준 자세에서 Enter 를 기다림.

접근을 여기서 하는 이유 (결정 3): 기준 자세(계약의 행동 오프셋,
`DeployPolicy.default_pose()`)를 아는 쪽이 여기뿐임. 모션보드에도 두면 같은 값이 두
군데가 됨.

**`DeployPolicy.motion()` 대신 `Runner` 를 직접 들고 있음.** 명령이 토픽으로 매 주기
바뀔 수 있어서, 구독 콜백이 `runner.commands.set(이름, 값)` 으로 넣고 타이머가
`runner.step()` 을 부름. `huphy-run` 은 같은 `Runner` 를 `motion()` 으로 감싸 쓸 뿐임.

```python
self.policy = deploy.load(folder)
self.runner = self.policy.runner(self.policy.load_model(checkpoint))
targets = self.runner.step(observation, imu_state)     # 20ms 타이머
```

접근 단계는 `scripts.selftest.approach(targets, start, seconds)` 를 그대로 씀.
지금 자세에서 목표까지 선형 보간하는 함수를 내는 순수 함수라 ROS 와 무관함.

---

---

## 9. `huphy` 와의 경계

`ros/` 는 `huphy` 를 **라이브러리로 씀.** 지켜야 하는 것이 둘임.

1. **`src/huphy/` 가 ROS 없이 그대로 돌아야 함.** `rclpy` 를 import 하지 않고,
   `package.xml` 을 붙이지 않고, `tests/` 가 ROS 없는 기계에서 돎
2. **`ros/` 를 새 레포로 분리했을 때 `huphy` 를 import 해서 그대로 쓸 수 있어야 함.**
   `huphy` 의 공개 API 만 쓰고, `sys.path` 를 건드리지 않고, 레포 안에 있다는 것을
   전제하지 않음

**`src/huphy/` 에 기능을 더하는 것은 이 둘을 안 깨면 됨.** ROS 쪽에서 필요해 더한
것이 있음 -- 아래 "기록을 위해 더한 것".

| 노드 | `huphy` 에서 쓰는 것 |
|---|---|
| `control_node` | `config.load_robot`, `scripts.bringup.build_biped`, `control.ControlLoop`, `control.Mode`, `telemetry.track_log.joint_limits` |
| `policy_node` | `control.deploy` 의 `load`·`DeployPolicy.load_model`·`runner`·`default_pose`·`order`, `scripts.selftest.approach` |
| `log_node` | `telemetry` 의 `policy_log.PolicyLog`·`latency_log.LatencyLog`·`run_name`·`power`, `motors.robstride.tables.phase_resistance_ohm` |
| `current_node` | `sensors.wcm1600.Wcm1600` |

### 기록을 위해 더한 것

`log_node` 는 모델을 안 부르고 버스도 안 들고 있음 -- 토픽으로 완성된 숫자를 받음.
그런데 두 기록 클래스는 **감싸서 직접 잡는** 입구만 있었음 (`PolicyLog.wrap_model`,
`LatencyLog.attach`). 그래서 밖에서 넣는 입구를 더함.

| 어디 | 무엇 | 왜 |
|---|---|---|
| `control/deploy.py` | `Runner.last_vector` | 모델에 넣은 관찰 벡터. `last_action` 은 이미 있었음. 모델을 감싸지 않고 읽으려는 것 |
| `telemetry/policy_log.py` | `add_row(...)`, 생성자 `limits=`·`extra_motors=`·`power_motors=`·`current=` | 완성된 줄을 넣음. `limits` 는 로봇 객체 없이 받음 (모터가 다른 기계에 있음). 두 `*_motors` 는 열을 미리 박음 -- 첫 정책 줄이 첫 `MotorExtra` 보다 먼저 올 수 있음 |
| `telemetry/power.py` | 새 모듈 | 받은 상전류로 구리 손실. `huphy-run` 쪽은 안 씀 (모델별 상저항을 꺼내는 길이 없음). 전류계 실측 열 이름(`CURRENT_COLUMNS`)도 여기 -- 계산값과 나란히 적어 두려는 것 |
| `telemetry/latency_log.py` | `set_joints`·`note_sent`·`add_sample` | 버스 없이 사건을 넣음. `_BusSink` 도 이 셋을 거쳐 가게 바꿈 |

**기록 형식을 `log_node` 안에 베끼지 않은 이유:** 열 순서, `NaN -> null`, 유실
계산(`보낸 수 - 받은 수`), p50/p95 표가 두 벌이 되면 한쪽만 고쳐져 어긋남. 그러면
`huphy-run` 기록과 비교하는 일이 안 됨 -- 비교가 이 기록의 목적임.

`_BusSink` 를 새 메서드로 돌린 이유도 같음. "**센 송신의 응답만 센다**" 는 규칙이
한 곳에 있어야 함 (`LatencyLog._counted`). 안 지키면 기록을 켜고 끄는 경계에서
가짜 유실이 생김.

### `huphy` 를 ROS 패키지로 안 만드는 이유

**빌드 경로가 둘이 됨.** `ament_python` 은 `setup.py` 를 보는데 이 저장소는
`pyproject.toml` 만 있음. 둘을 같이 두면 `pip install -e .` 과 `colcon build` 가
다른 경로로 설치해서 어느 쪽이 import 되는지가 환경에 달라짐.

**ROS 없이 못 돌게 됨.** 지금 `src/huphy/` 와 `tests/` 가 ROS 없는 기계에서 돎.
`package.xml` 을 붙이면 그 전제가 흐려짐.

`rosdep` 은 apt 패키지와 몇몇 pip 패키지만 알아서 `huphy` 를 `package.xml` 에 적을
수 없음. `pip install -e .` 를 전제로 둠. **분리하면 이 전제가 바뀜** --
`install.sh` 가 레포를 링크하는 대신 `huphy` 를 패키지로 받게 됨.

---

---

## 10. 스레드

`control_node` 한 프로세스 안에 넷임.

| 스레드 | 하는 일 |
|---|---|
| 메인 | `rclpy.spin()`. 구독·서비스·발행 타이머 |
| 제어 | `ControlLoop.run()`. 100Hz, CAN 송수신 |
| 수신 ×2 | `CanBus._read_loop`. 채널마다. `huphy` 가 이미 띄움 |

**제어 스레드에서 `publish()` 를 부르지 않음.** 직렬화와 DDS 가 제어 주기 안에
들어감. 제어 스레드는 최신 관찰을 `Latest` 에 써 두기만 하고 발행 타이머가 꺼냄.

**`ControlLoop` 를 `rclpy` 타이머에 얹지 않음.** 절대 마감·스핀 구간·밀림 측정으로
주기를 자기가 지키는데([`control/loop.py`](../src/huphy/control/loop.py) 의
`_sleep_until`, `SPIN_THRESHOLD_S`), executor 가 콜백을 꺼내 부르는 구조 위에
얹으면 그 지터가 더해짐.

**콜백 안에서 계산하지 않음.** 파이썬은 GIL 을 쥔 스레드가
`sys.getswitchinterval()`(기본 0.005초) 동안 시스템콜 없이 계속 돌 수 있음. 수거
예산이 2ms 이므로, 계산만 하는 콜백 하나가 그 주기의 수거를 통째로 넘기게 만듦.

---

---

## 11. 센서를 붙일 때

카메라·라이다를 **모션보드에 붙이지 않음.** 거기는 CAN 과 100Hz 제어뿐임.

그러면 작업 기계에 붙게 되는데, **거기가 정책이 도는 기계임** (결정 13). 그래서
막아야 할 것이 제어가 아니라 **정책**임.

| 무엇이 다투나 | 왜 |
|---|---|
| CPU | 포인트클라우드 처리와 50Hz 추론이 같은 코어를 씀 |
| GIL | 센서 노드가 파이썬이면 10장의 전환 간격 문제가 추론 타이머에 걸림 |
| 대역 | 프레임 하나가 수십 MB 라 UDP 조각으로 나감. 같은 링크의 `joint_targets` 가 그 뒤에 줄을 섬 |

마지막 것이 제일 나쁨. `joint_targets` 가 50Hz 로 가야 하는데 한 번 늦으면
모션보드의 100ms 임계에 가까워지고, 몇 번 이어지면 감쇠로 떨어짐.

대책 넷임. 위에서부터 효과가 큼.

| | |
|---|---|
| 센서를 **전용 보드**에 | 정책과 CPU·GIL 을 안 나눔. 기계가 셋이 됨 |
| 망을 나눔 | 제어용 링크와 센서용 링크를 물리적으로 분리 |
| `ROS_DOMAIN_ID` 를 나눔 | 센서 도메인과 제어 도메인을 나누고 필요한 토픽만 넘김 |
| 센서 노드를 C++ 로 | `realsense-ros`·`ouster-ros` 가 이미 C++ 임. GIL 을 안 씀 |

마지막 것이 공짜임 — 기성 드라이버가 이미 C++ 라 **파이썬 노드를 따로 안 만들면**
GIL 문제는 안 생김. CPU 와 대역은 남음.

**붙이기 전에 재야 할 것**: 센서 노드를 띄운 상태에서 `/huphy/joint_targets` 의
주기가 50Hz 를 지키는지. `ros2 topic hz` 로 보면 됨.

---

---

## 12. 안 하는 것

| | 왜 |
|---|---|
| `ros2_control` | 발목이 크랭크 두 개로 두 축을 만드는 링키지라 기성 컨트롤러에 그 변환이 없음. 커스텀 컨트롤러를 C++ 로 써야 해서 기성품을 쓰는 이점이 사라짐 |
| 정책 교체 서비스 | 결정 5 |
| 액션 | 오래 걸리는 것이 접근 단계뿐이고 `policy_node` 안에서 끝남 |

### 아직 못 한 것

| 확인함 | 안 함 |
|---|---|
| 한 기계에서 실물로 B 확인 1·2 (상태 100Hz, IMU, 토크 없이 목표각) | 토크 넣기·기준 자세·정책 시작 (A-3~A-5 / B-2~B-4) — **ROS 로 토크를 넣어 본 적 없음** |
| 로봇 없이 가짜 CAN 으로 노드 둘 ([`without_robot.md`](without_robot.md)) | **두 기계** 구성 |
| RViz 보기 — robot_state_publisher 가 URDF 를 읽는 것까지 | RViz 화면을 실물과 같이 띄워 본 적 없음. **발목 pitch/roll 방향**이 URDF 와 맞는지 모름 |
| 기록(`--log`)을 `log_node` 로 옮김 — 코드만, **실물에서 안 돌려 봄** | `huphy-run` 에만 있는 것: 실시간 그래프(`--live`), `--profile`, `--gain-scale` |

두 기계 사이 왕복 지연도 안 쟀음. 6-2 의 60ms / 100ms 는 제안값이고, 재고 나서 다시
정해야 함.
