Human-Pygmalion/HUPHY/src/huphy/kinematics/README.md

# `kinematics/` — 기구학

```
kinematics/
├── ankle.py       발목 2모터 링키지 (**실측**). 관절각 <-> 모터각. 제어가 씀
└── mjcf_loop.py   발목 폐루프 (**학습 MJCF**). 모터각 -> 종속 관절 6개. 관찰이 씀
```

**둘을 섞어 쓰지 말 것.** 같은 발목을 다르지만 수치가 다른 두 링키지로 모델링한
것임 -- 같은 크랭크각에 피치가 약 1.1배, 롤이 약 1.4배 다르고 롤 부호 규약도
다름. `ankle.py` 는 실측이라 모터에 보낼 각도를 정하는 데 쓰고, `mjcf_loop.py` 는
학습 MJCF 라 **정책에 넣을 관찰**을 만드는 데만 씀
(`docs/policies/motion.md` 3절).

순수 계산임. 모터도 CAN 도 모르고 숫자만 다룸. `numpy` 만 씀.

---

## 왜 발목만 있나

다른 관절은 **모터 하나가 관절 하나**를 돌림. 무릎에 30도를 보내면 무릎이 30도
돎 — 변환할 것이 없음.

발목은 다름. **모터 두 개가 로드 두 개로 발판 하나를 밀고 당김.**

```
a1 ↑  a2 ↓     ->  발끝이 내려감 (pitch)
a1 ↑  a2 ↑     ->  발이 옆으로 기움 (roll)
```

그래서 "pitch 10도" 를 모터 각도 두 개로 풀어야 하고, 모터 각도 두 개를 읽으면
지금 pitch/roll 이 얼마인지 계산해야 함.

---

## 두 방향

```python
solve_ik(pitch, roll)  ->  (a1, a2)      역기구학
solve_fk(a1, a2)       ->  (pitch, roll) 순기구학
```

### 비용이 다름

`solve_ik` 는 **닫힌 해**임. 삼각함수 몇 번으로 끝남. 제어 루프에서 매 주기 불러도 됨.

`solve_fk` 는 **뉴턴 반복**임. 두 로드 길이가 동시에 맞는 자세를 수치로 찾아감.

`solve_fk` 는 `solve_ik` 의 열 배쯤 걸리지만 둘 다 제어 루프에서 매 주기 쓸 수 있음
— 직전 자세를 추정으로 주면 FK 가 155us 이고 IK 는 12us 임 (100Hz 주기 예산 10ms).

---

## 토크로 굴릴 때

위치 명령 대신 토크를 보내는 경로임. 모터 각도에 게인을 걸면 로드 지렛대 비가 자세마다
달라 발목이 내는 강성이 자세마다 달라짐. 관절 토크를 만들어 야코비안으로 내리면 그 비가
보정됨.

```python
jacobian(pitch, roll)                        ->  J = d(a1,a2)/d(pitch,roll)
joint_torque_to_motor(자세, tau_pitch, tau_roll)  ->  (tau1, tau2)   [Nm]
mit_torque(목표, 실측, kp=..., kd=...)        ->  (tau1, tau2)   [Nm]
```

`jacobian` 은 닫힌 해임. 제약식을 직접 미분한 것이라 eps 를 고를 일도 wrap 불연속에
걸릴 일도 없음. **단위가 없음** — 분자와 분모가 둘 다 각도라 도/도와 rad/rad 가 같은
값임.

`joint_torque_to_motor` 는 가상일 보존에서 나옴.

```
tau_a . da = tau_pr . dpr,   da = J dpr    ->    tau_a = (J^T)^-1 tau_pr
```

**지금 자세에서 선형화함.** 목표가 아니라 실측을 넣을 것 — 링키지가 지금 놓인 기하가
토크를 정함.

`mit_torque` 는 모터 펌웨어가 하던 PD 를 여기서 함.

```
tau_pr = kp*(목표 - 실측) + kd*(목표속도 - 실측속도) + feedforward
```

| 인자 | 단위 |
|---|---|
| `target`, `current` | 도 |
| `target_velocity`, `current_velocity` | 도/초 |
| `kp` | Nm/rad |
| `kd` | Nm/(rad/s) |
| `feedforward` | Nm |

각도는 도, 게인은 라디안 기준임. 둘 다 이 저장소의 기존 규약임 — `solve_ik`/`solve_fk`
가 도를 쓰고, `robot.yaml` 의 `kp` 는 변환 없이 모터로 나가는데 모터는 프레임의 라디안
각도로 계산함. 오차를 안에서 라디안으로 바꾸므로 `kp` 값을 그대로 쓸 수 있음.

나온 값은 `MitCommand(kp=0, kd=0, torque_nm=...)` 로 보낼 것. 모터 쪽 PD 를 끄지 않으면
두 PD 가 겹침.

특이점에서는 던짐. 로드가 크랭크 원에 접하면 모터를 돌려도 발판이 그 방향으로 움직이지
않아 필요한 토크가 발산함. 조건수가 `MAX_JACOBIAN_CONDITION` 을 넘어도 던짐 — 그런 자세
에서는 자세 측정 오차가 토크로 증폭됨. 지금 기하에서는 도달 범위 안 최대가 12 정도라
걸리지 않고, 그보다 먼저 로드 해가 없어짐.

---

## FK 는 답이 하나가 아님

**같은 모터각 조합이 서로 다른 자세 둘에 대응함.**

```python
a1, a2 = ankle.solve_ik(90, 90, enforce_envelope=False)   # (52.10, 45.41)

ankle.solve_fk(a1, a2)                                    # (2.41, -40.48)
ankle.solve_fk(a1, a2, guess_pitch_deg=90, guess_roll_deg=90)   # (90.00, 90.00)
```

둘 다 **맞는 해임.** 링키지의 성질이지 버그가 아님. 어느 쪽으로 수렴할지는 초기
추정이 정함.

### 실제로는 문제가 안 됨

시험 범위 안에서는 추정 `(0, 0)` 으로도 **항상** 원래 자세를 찾음. 격자 187개로
확인함 (`test_default_guess_is_enough_inside_the_envelope`).

제어 루프에서는 한 주기 전 자세를 추정으로 넣으면 됨 — 늘 가까움.

**범위를 넓히면 이 성질이 깨질 수 있음.** 그때 다시 확인할 것.

### 발산은 막음

수렴한 답을 **IK 로 되짚어 확인함.** IK 는 닫힌 해라 싸고, 이 검사가 없으면 발산한
값이 그대로 나감.

```python
ankle.solve_fk(170.0, -170.0)     # AnkleUnreachableError
```

NaN 을 돌려주면 `safety.guards` 가 잡기 전까지 조용히 흘러감.

---

## 각도 규약

두 모터 각도를 **모두 `[-180, 180)`** 으로 냄.

모터가 `zero_sta = 1` 로 그 범위를 보고하기 때문임. 한쪽만 `[0, 360)` 으로 두면
IK 가 340도를 돌려주고 모터는 -20도를 보고해 **360도 차이**가 남 (이슈 #1).

이 규약이 맞아떨어져서 별도의 각도 감싸기 처리가 필요 없음 — 모든 관절 한계가
±180 안에 있고 전 회전을 하지 않음.

---

## 닿지 않는 자세는 던짐

```python
ankle.solve_ik(80.0, 0.0, enforce_envelope=False)
# AnkleUnreachableError: ... 로드 해가 없음 (a1 가능=False, a2 가능=True)
```

자르지 않는 이유: 발목은 두 모터가 물려 있어 **한쪽만 잘리면 관절이 비틀림.**
무엇을 보낼지는 상위가 정해야 함.

어느 로드가 안 닿는지 같이 알려줌.

### 시험 범위는 별개임

```python
AnkleEnvelope(roll_deg=(-25, 25), pitch_deg=(-40, 40))
```

링키지가 닿는 범위보다 **좁게** 잡아 둔 소프트웨어 값임. 브링업 단계라 보수적으로
감. `enforce_envelope=False` 로 건너뛸 수 있고, `is_reachable()` 은 범위를 무시하고
링키지만 봄.

시험 범위 네 귀퉁이가 전부 닿는지 테스트가 확인함 — 안 닿으면 설정이 잘못된 것임.

---

## 거울상

```python
left = AnkleKinematics(AnkleGeometry().mirrored())
```

**좌표만 뒤집으면 안 됨.** `crank_t` 는 x 방향 오프셋이라 부호가 같이 뒤집혀야 하고,
모터 회전축이 x 축이므로 yz 평면 반사에서 회전 방향도 뒤집힘.

제대로 뒤집으면 다음이 정확히 성립함.

```
거울상.solve_ik(pitch, -roll) == -원본.solve_ik(pitch, roll)
```

**이게 성립해야 보행 궤적 한 벌로 양다리를 움직일 수 있음.** 좌표만 뒤집으면 이
관계가 근사로만 맞아 좌우가 미묘하게 다르게 움직임.

---

## 기하값

```
a1     (-26.10,  74.000, -255.00)   모터 1 회전축
a2     (-80.90,  74.000, -313.00)   모터 2 회전축
origin (-53.50,  74.000, -393.00)   발목 회전 중심
c1     ( -8.10, 111.343, -398.00)   로드 1 이 발판에 붙는 곳
c2     (-98.90, 111.343, -398.00)   로드 2 가 발판에 붙는 곳

crank_r  40.0    모터 디스크 반지름
crank_t  18.0    디스크가 축에서 x 방향으로 떨어진 거리
```

단위는 mm. 모터 회전축은 x 축이고 디스크는 y-z 평면에 놓임.

**로드 길이는 여기 없음.** 중립 자세(모터각 0)에서 계산됨 — 143.02 와 85.04.
좌표를 고치면 길이도 따라 바뀌므로 따로 관리할 값이 아님.

두 로드 길이가 크게 다름. **대칭 링키지가 아님.**

### 출처가 확인되지 않음 (이슈 #13)

실물 발목 **하나**를 실측한 값임. 어느 쪽 다리인지 기록이 없고, 반대쪽은
`mirrored()` 로 만든 계산 결과임 — 실측이 아님.

`rotation_sign_1/2` 가 실물과 맞는지도 확인된 바 없음. 반대면 발목이 목표에서
멀어지는 방향으로 감.

---

## 테스트가 확인하는 것과 못 하는 것

```bash
PYTHONPATH=src python3 -m pytest tests/test_ankle.py -q
```

149개. 확인하는 것:

```
IK -> FK 왕복이 정확함
두 각도가 같은 규약
시험 범위 격자 187개에서 다중해 문제가 없음
거울상 반대칭
시험 범위 네 귀퉁이가 닿음
```

**이 전부가 기하값이 틀려도 성립함.** 자기일관성은 정확성이 아님.

기하가 실제 로봇과 맞는지는 **실물에서만** 확인됨 — 발목에 pitch 10도를 명령하고
실제 발 각도를 재는 수밖에 없음.
