Human-Pygmalion/HUPHY/src/huphy/scripts/README.md

# `scripts/` — 터미널 진입점

```
scripts/
├── commission.py   조립할 때 한 번 하는 조작
├── bringup.py      다리를 실제로 움직여 보는 대화형 메뉴
├── selftest.py     정해진 패턴으로 계속 움직여 봄
├── run.py          학습한 정책으로 움직임
├── imu.py          센서를 설정하고 확인
├── current.py      전류계로 로봇 전체 DC 전류를 봄
├── failures.py     실행이 끝난 뒤 실패 집계 (진입점 아님)
└── table.py        표 그리기 (진입점 아님)
```

설정 파일에서 모터 목록을 읽으므로 모터 id 를 손으로 적지 않음.

`--config` 를 주지 않으면 현재 폴더부터 위로 올라가며 `config/robot.yaml` 을 찾음.
설정에 오류가 있으면 채널을 열기 전에 멈춤.

`--limb` 은 팔다리가 둘 이상이면 필수임. 팔다리마다 CAN 채널이 다름.

`huphy-test` 는 로봇 전체를 한 루프로 돌릴 수 있음.

```bash
huphy-test --robot zero                   # kind: leg 인 팔다리 전부
huphy-test --limb right_leg zero          # 다리 하나
huphy-test --limb left_leg,right_leg zero # 일부만 묶기 (드묾)
```

**플래그가 곧 만들어지는 객체임.**

| | 만들어지는 것 | 관절 이름 |
|---|---|---|
| `--limb <이름>` | `Leg` | `knee` |
| `--robot` | `Biped` | `right_leg/knee` |

`--limb` 은 "팔다리가 여럿이라 헷갈리니 하나를 짚어라" 는 뜻임. 로봇 전체는 그것과
다른 층의 선택이라 플래그를 따로 둠 — `--limb all` 처럼 단수 플래그에 복수 의미를
얹으면, 나중에 팔이 붙었을 때 "다리만? 팔까지?" 로 다시 애매해짐. 둘을 같이 주면
거부함.

프로세스를 둘 띄우는 것과 다름 — 명령이 같은 주기에 나가고, 한쪽 통신이 끊기면
**양쪽이 같이** 멈춤. 따로 띄우면 한쪽이 죽어도 다른 쪽은 계속 움직여 넘어짐.

나머지 진입점은 팔다리 하나만 받음. `commission` 은 사람이 한 다리를 손으로
만지는 절차이고, `bringup` 은 관절 하나씩 확인하는 화면이라 묶을 이유가 없음.

---

## `commission.py`

```bash
python -m huphy.scripts.commission --limb right_leg scan
huphy-commission --limb right_leg state
huphy-commission --limb right_leg nudge knee --delta 5
huphy-commission --limb right_leg zero knee --note "다리 편 상태" --yes
```

| | 무엇 |
|---|---|
| `scan` | 어느 모터가 응답하는지 |
| `state` | raw 와 cal 을 나란히. 속도·토크·온도 |
| `fault` | 고장 상태 조회 |
| `clear-fault` | 고장 상태 지우기 |
| `sweep` | 토크를 끄고 손으로 밀어 가동 범위 측정 |
| `nudge` | 조금 움직였다 되돌림 |
| `zero` | **[영구]** 지금 자세를 기계 영점으로 |
| `mode` | 제어 모드 변경 |
| `can-id` | **[영구]** CAN id 변경 |
| `protocol` | **[영구]** 프로토콜 전환 |

`mode` `can-id` `protocol` 은 모터를 새로 사거나 갈아 끼울 때만 씀. 한 관절씩만 다룸.

**갈아 끼운 모터는 호스트 id 도 맞출 것** (0xF0 + id, `docs/motor_setup.md` 14절). 이
도구에는 없고 `cansend` 한 줄임. 안 맞추면 `huphy-run`·`huphy-test` 가 연결할 때
`HostIdError` 로 멈춤. 확인은 `python3 tools/can_scan.py`.

### 관절과 옵션을 생략하면 물어봄

관절을 받는 명령(`clear-fault` `sweep` `nudge` `zero` `mode` `can-id` `protocol`)은
이름을 빼고 실행할 수 있음. 터미널이면 목록을 띄우고 번호·이름·`a`(전부) 로 받음.

```
  right_leg -- 무엇을 영점 잡을까요?

    1) hip_pitch  id=7   RS02
    ...
    a) 전부

  선택 [a]:
```

`clear-fault` `sweep` `zero` 는 전부가 기본임. `nudge` `mode` `can-id` `protocol` 은
전부를 고를 수 없음.

관절을 고르고 나면 옵션을 한 번에 보여주고 한 줄로 받음. 쉼표로 구분하고 빈 칸은
기본값임. 옵션이 하나뿐인 명령은 줄 전체를 값으로 씀.

```
  옵션 -- 쉼표로 구분, 비우면 기본값

    1) delta   5.0      몇 도 움직였다 되돌릴지. 20도까지
    2) kp      5.0      위치 게인. 안 움직이면 조금씩 올릴 것
    3) kd      0.5      속도 게인

  입력 [5.0, 5.0, 0.5]: 3

  실행: huphy-commission --limb right_leg nudge knee --delta 3.0 --kp 5.0 --kd 0.5
```

끝에 나오는 명령줄은 그대로 다시 쳐도 같이 동작함. `(필수)` 로 나오는 것은
`zero --note`, `can-id --to`, `protocol --to` 임.

옵션을 물어보는 것은 관절을 생략했을 때뿐임. 관절을 명령줄에 적었으면 묻지 않음.

터미널이 아니면 물어볼 수 없음. 전부가 기본인 명령은 전부로 가고, 하나만 받는 명령은
거부함.

### `--yes` 를 요구하는 것

```
zero        기계 영점. 모터에 저장되고 좌표계가 통째로 옮겨감
can-id      CAN id 변경. 바꾼 뒤 robot.yaml 도 고쳐야 함
protocol    프로토콜 전환. 전원 재투입 필요
```

승인 확인이 버스를 열기 전에 일어남. `--yes` 는 이 세 명령에만 붙음.

---

## 명령별 동작

### `scan`

```
right_leg  can1  모터 6개

  hip_pitch  id=7   RS02   응답
  ankle_b    id=12  RS00   ----

응답 없음: ['ankle_b']
```

### `state`

```
  관절               raw       cal        속도       토크     온도
  knee       29.99     29.99     -0.46     0.39   32.5

  미실측 상태라 cal 이 raw 와 같음.
```

### `sweep`

```bash
huphy-commission --limb right_leg sweep          # 전 관절
huphy-commission --limb right_leg sweep knee     # 하나만
huphy-commission --limb right_leg sweep 10       # id 로도 됨
```

토크를 끄고 관절마다 오프셋과 한계각을 정함. 관절(묶음) 하나가 한 단계임. 측정은
초당 20번, `--hz` 로 바꿀 수 있음.

```
right_leg 가동 범위 측정 -- 5단계, 초당 20번 잽니다.

  [4/5] knee
       0도 자세로 두고 Enter:
       knee       offset   -33.40

       양쪽 끝까지 미세요. 끝나면 Enter.

       관절                최소        지금        최대        범위
       knee       -20.61     30.12     74.76     95.37
```

0도가 먼저임. `measure_offset` 이 `offset = -raw` 를 내고, 그 뒤 `cal = raw + offset`
으로 최대·최소를 굴림. `ankle_a` 과 `ankle_b` 는 한 단계로 묶임(`LINKED`).

단계가 끝날 때마다 캘리브레이션 파일에 적음. 오프셋과 한계각이 같이 들어가고,
`sign` 과 `zero_reference` 는 건드리지 않음.

```json
"knee": {"sign": 1.0, "offset_deg": -33.40,
         "zero_reference": "다리 편 상태", "limits_deg": [-20.61, 74.76]}
```

움직인 폭이 0인 관절은 빼고 나머지를 적음. 뺀 관절과 그것만 다시 재는 명령을 화면에
냄. 캘리브레이션 파일이 설정되어 있지 않으면 재기 전에 멈춤.

단계마다 Enter 를 받으므로 화면에서만 실행됨. 범위가 5도도 안 되는 관절이 있으면
종료 코드 `1`.

### `nudge`

```
right_leg.knee (id=10) 를 +5.0도 움직였다 되돌림.
  게인 kp=5.0 kd=0.5
  다리를 받쳐 두고, 실제로 어느 관절이 움직이는지 볼 것.

  시작    29.99
  최대    34.72   (움직인 양 +4.73)
  끝      30.23
```

명령한 양의 30% 미만이면 알림. 응답 없는 모터에는 토크를 넣지 않음.

### `zero`

```bash
... zero --yes                                            # 전부, 관절마다 Enter
... zero knee --note "다리 편 상태, 발바닥 평면 접촉" --yes   # 하나만
```

```json
"knee": {"sign": 1.0, "offset_deg": 0.0, "zero_reference": "다리 편 상태, 발바닥 평면 접촉"}
```

토크를 맨 앞에서 한 번에 끊고 영점을 잡음. 관절을 생략하면 한 번 실행에 전부를 잡되
관절마다 Enter 를 받음.

```
  자세를 잡은 채로 관절마다 Enter.

  hip_pitch  Enter:
  hip_pitch  잡음
  hip_roll   실패 -- 응답 없음
```

프레임이 실제로 나간 관절만 메모가 저장됨. 하나라도 실패하면 종료 코드 `1`.

### 채널이 안 열리면

```
can1 (socketcan) 를 열 수 없음: ...
채널이 올라와 있는지 확인할 것:
  huphy-can up       (robot.yaml 의 채널을 1 Mbps 로 올림. 상태는 huphy-can status)
  손으로 -- gs_usb(candleLight)·네이티브 CAN:
    sudo ip link set can1 up type can bitrate 1000000
  손으로 -- slcan 어댑터 (slcand, -s8 = 1 Mbps):
    sudo slcand -o -c -s8 /dev/<어댑터> can1 && sudo ip link set can1 up
  확인: ip -details link show can1
```

### 종료 코드

```
0   정상
1   응답 없는 모터가 있거나 고장이 있음
```

`scan`, `state`, `fault` 는 문제가 있으면 `1` 을 냄.

---

## 실물에서의 순서

```
1  CAN 채널 올리기          어댑터 종류에 따라 다름. 루트 README 4번
2  commission scan          6개 다 응답하나
3  commission fault         고장 없나
4  commission nudge <관절>   설정대로 움직이나. 관절마다, 눈으로
5  commission zero <관절>    영점. 자세를 잡아 놓고 관절 전부
6  commission sweep         가동 범위. 영점을 전부 끝낸 뒤 한 번에
7  게인 튜닝               kp, kd 를 robot.yaml 에 적음
8  bringup                  게인 튜닝. 그래프를 보며
```

`sweep` 이 재는 값은 영점 기준의 각도임. 영점을 다시 잡으면 범위도 다시 재야 함.

---

## `bringup.py`

```bash
python -m huphy.scripts.bringup --limb right_leg
huphy-bringup --limb right_leg
huphy-bringup --limb right_leg --gain-scale 0.1 --allow-uncalibrated
```

설정·실측값·버스·기구학·안전·텔레메트리·제어 루프를 한데 묶어 씀.

| 옵션 | 기본값 | 무엇 |
|---|---|---|
| `--limb` | 없으면 오류 | 어느 팔다리. 팔다리마다 CAN 채널이 다름 |
| `--gain-scale` | `1.0` | `robot.yaml` 의 `kp`/`kd` 를 이 비율로 낮춰 씀. 설정 파일은 안 바뀜 |
| `--allow-uncalibrated` | 꺼짐 | 미실측이어도 토크를 넣음. 경고만 내고 진행함 |
| `--config` | 위로 올라가며 찾음 | 다른 `robot.yaml` 을 쓸 때 |
| `--hz` | 설정의 `control_hz` | 제어 주기 |
| `--no-precise` | 켜짐 | 마감 직전 스핀을 끔 |
| `-v` | | DEBUG 로그 |

`--gain-scale 0.1` 이면 `kp: 20.0, kd: 1.0` 이 `kp: 2.0, kd: 0.1` 로 감. 실물에서
튜닝하기 전의 시작값이라 처음 만질 때는 낮춰야 함. 낮추면 시작할 때 화면에 냄.

`--allow-uncalibrated` 가 없으면 `Leg.enable` 이 `is_calibrated` 를 보고 막음 —
`[토크]` 항목이 전부 거부됨. 상태 보기와 카운터 보기는 그대로 됨.

```
1. 상태 보기
2. 카운터 보기
3. 자세 유지 [토크]
4. 한 관절 옮기기 [토크]
5. 계단 응답 [토크]
6. 사인파 왕복 [토크]
```

`[토크]` 항목은 미실측이면 거부함. 아래가 다 차야 `is_calibrated` 가 참이 됨.

| 파일 | 채울 값 | 무엇으로 |
|---|---|---|
| `config/calibration/<팔다리>.json` | `limits_deg` | `commission sweep` |
| `config/calibration/<팔다리>.json` | `zero_reference` | `commission zero --note` |
| `config/robot.yaml` | `kp` (0보다 커야 함) | 사람이 적음 |

하나라도 비면 메뉴 머리에 `미실측 (allow_uncalibrated 필요)` 이 뜨고 `[토크]` 항목이
거부됨. 어느 관절이 빈지는 상태 보기 끝에 나옴.

`--allow-uncalibrated` 를 붙이면 경고만 내고 진행함. 실측을 하려면 움직여야 하므로
커미셔닝 단계에서 필요함.

움직이는 것은 전부 제어 루프를 탐. 메뉴는 동작만 정하고 루프에 넘김.

```
menu -> motion -> ControlLoop -> Leg -> bus
```

### 상태 보기

```
  관절             raw       cal      속도     토크   온도     응답  마지막 응답
  hip_pitch  -60.01    -60.01     -0.46     0.32   30.0     받음       0.02ms
  knee       -60.01    -60.01     -0.46     0.32   30.0     씹힘      254.9초
  ankle_b    -60.01    -60.01     -0.46     0.32   30.0 명령안함         없음

  발목  pitch   -0.00   roll    0.01
```

| 칸 | 무엇 |
|---|---|
| `raw` | 모터가 보고한 각도 그대로 |
| `cal` | 관절 좌표계 각도. `sign`·`offset` 을 적용한 값 |
| `속도` | 도/초 |
| `토크` | 모터가 보고한 토크 |
| `온도` | ℃ |
| `응답` | 직전 주기에 명령하고 `받음` / 명령했는데 `씹힘` / `명령안함` |
| `마지막 응답` | 그 이후 경과 시간. 1초가 넘으면 초로 씀. 한 번도 못 받았으면 `없음` |

100Hz 면 `마지막 응답` 이 한 자리 ms 임. `254.9초` 처럼 크면 한 번은 받았다가 끊긴
것이고, `없음` 이면 처음부터 응답이 없던 것임.

응답이 끊기면 가드가 현재 위치를 몰라 명령을 거부하므로 `응답` 이 `명령안함` 으로
조용해짐. 진짜 신호는 `마지막 응답` 임.

발목은 모터 각도가 아니라 기구학으로 푼 pitch/roll 로 보여줌.

IMU 가 붙어 있으면 이어서 나옴. 없으면 이 표가 아예 안 나옴.

```
  IMU             roll     pitch       yaw    마지막 값
  main            1.50     -2.50     30.00      4.21ms
```

`마지막 값` 이 진짜 신호임. 센서가 멈춰도 자세는 그럴듯한 숫자로 남아 있음.

한계 밖에 있는 관절이 있으면 경고함.

```
  ** 한계 밖에 있는 관절 **
  토크를 넣으면 가드가 한계 안으로 끌어당김 -- 그 방향으로 움직임.
    knee       200.00  한계 -20.65 ~ 74.79
```

### 카운터 보기

시작부터 지금까지 쌓인 사건 수임. 상태 보기가 "지금 어떤가"면 이쪽은 "그동안 몇 번".

```
  가드
    clips                12
    rejects               0
    clips_limit          12
    clips_jump            0
    rejects_nan           0
    rejects_nostate       0

  CAN
    can.tx_errors         0
    can.rx_errors         0
    can.frames_sent    1204
    can.frames_received 1198
    can.drain_timeouts    2

  마지막 클리핑 이후 3.4초   마지막 거부 이후 -1.0초

  루프  340주기 3.4초 (평균 100.1Hz / 목표 100Hz), 밀림 2회, 최악 12.3ms, 무응답 주기 0회
```

| 칸 | 무엇 |
|---|---|
| `clips` | 잘렸지만 전송은 된 횟수 |
| `rejects` | 아예 안 나간 횟수 |
| `clips_limit` | 목표가 관절 한계 밖이라 한계값으로 잘림 |
| `clips_jump` | 한 주기에 너무 많이 움직이려 해서 잘림 |
| `rejects_nan` | 목표가 NaN/Inf. 자를 수 있는 값이 아님 |
| `rejects_nostate` | 현재 위치를 몰라 점프 폭을 못 잼 — 그 모터가 무응답임 |
| `can.frames_sent` / `_received` | 보낸 프레임과 받은 프레임. 차이가 벌어지면 응답을 못 받는 것 |
| `can.drain_timeouts` | 기대한 개수를 못 채우고 시간을 다 쓴 횟수 |
| `마지막 ... 이후` | 초. 없었으면 `-1.0` |

누적 수만 보면 12번이 방금 몰린 것인지 10분 전 것인지 모름. 그래서 마지막 사건 이후
경과를 같이 냄.

루프 줄은 한 번이라도 돌았을 때만 나옴.

| 칸 | 무엇 |
|---|---|
| `340주기 3.4초` | 돈 주기 수와 걸린 시간 |
| `평균 100.1Hz / 목표 100Hz` | 실제 주파수와 `--hz` |
| `밀림` | 마감을 넘긴 주기 수 |
| `최악` | 가장 오래 걸린 주기 |
| `무응답 주기` | 응답이 하나도 안 온 주기 수 |

못 지키면 끝에 `** 주기를 못 지킴 **` 이 붙음.

### 자세 유지 [토크]

지금 자세를 그대로 붙잡음. 게인 튜닝의 출발점임 — 여기서 떨리면 어떤 동작을 시켜도
떨림.

```
  얼마나 (초) [3.0]:

  지금 자세를 붙잡음. 처지나, 떨리나 볼 것

  300주기 3.0초 (평균 100.0Hz / 목표 100Hz), 밀림 0회, 최악 10.4ms, 무응답 주기 0회
```

처지면 `kp` 부족, 떨리면 `kp` 과함.

관절을 고르지 않고 여섯 개를 전부 붙잡음. 목표는 시작할 때 한 번 정하고 그대로 둠.
발목은 FK 로 풀어 `ankle_pitch`/`ankle_roll` 목표를 만듦. 목표를 못 정한 관절은
이름을 내고 빠짐.

### 한 관절 옮기기 [토크]

한 관절만 지금 자리에서 조금 옮김. 나머지는 지금 자리에 붙잡아 둠.

```
  관절: hip_pitch, hip_roll, hip_yaw, knee, ankle_pitch, ankle_roll
  이름: knee
  얼마나 (도) [5.0]:

  knee       29.99 -> 34.99 도

  250주기 2.5초 (평균 100.0Hz / 목표 100Hz), 밀림 0회, 최악 10.4ms, 무응답 주기 0회
```

`29.99 -> 34.99` 는 지금 각도와 목표 각도임. 1초에 걸쳐 옮김. 발목은 모터가 아니라
`ankle_pitch` / `ankle_roll` 로 받음.

### 계단 응답 [토크]

목표를 한 번에 뛰게 하고 따라오는 모양을 봄. 게인 튜닝에서 가장 많은 것을 알려줌.

```
  이름: knee
  계단 크기 (도) [10.0]:

  knee       29.99 -> 39.99 도
  그래프에서 볼 것:
    못 미침    kp 부족      지나쳤다 돌아옴  kd 부족
    떨림       kp 과함      느리게 도달      kp 올릴 여지

  350주기 3.5초 (평균 100.0Hz / 목표 100Hz), 밀림 0회, 최악 10.4ms, 무응답 주기 0회
```

0.5초 붙잡고 있다가 뛰므로 그래프에서 뛰기 전후가 갈림. 모양은 텔레메트리로 봄.

### 사인파 왕복 [토크]

지금 자리를 중심으로 왕복시킴. 추종 지연과 진폭 감쇠를 봄.

```
  이름: knee
  진폭 (도) [5.0]:
  주파수 (Hz) [0.5]:
  길이 (초) [3.0]:

  knee       29.99 도를 중심으로 ±5.0 도, 0.5 Hz

  350주기 3.5초 (평균 100.0Hz / 목표 100Hz), 밀림 0회, 최악 10.4ms, 무응답 주기 0회
```

| 물음 | 무엇 |
|---|---|
| `진폭` | 중심에서 한쪽으로 몇 도 |
| `주파수` | 초당 몇 번 오가는지 |
| `길이` | 몇 초 동안 |

주파수를 올릴수록 뒤처짐과 진폭 감쇠가 커짐. 어디서 못 따라오는지가 게인의 한계임.

### 안전

```
시작할 때    관찰 모드. 토크가 꺼져 있음
움직이기 전  freeze 로 지금 자세를 잡음
끝날 때      hold 후 토크 차단
Ctrl-C       루프의 finally 를 지나므로 같은 순서
```

모든 동작이 `freeze` 로 시작하고, 흔들지 않는 관절은 지금 자리에 붙잡아 둠.

---

## `selftest.py`

```bash
huphy-test --limb right_leg zero
huphy-test --limb right_leg range --period 10 --margin 8
huphy-test --limb right_leg pose 0 10 0 30 0 0
huphy-test --robot pose 0 10 0 30 0 0  0 10 0 30 0 0
huphy-test --robot pose left_leg/ankle_a=10 right_leg/knee=-20
huphy-test --robot pose --ankle-space rp left_leg/ankle_pitch=10 left_leg/ankle_roll=0
huphy-test --robot --hz 50 --drain-ms 4 zero --log     # 목표·실측과 지연을 logs/ 에
huphy-test --robot --hz 50 zero --live                  # 같은 것을 브라우저로 실시간 (포트 8770)
```

`--live [PORT]` 는 도는 동안 관절 목표·실측을 브라우저로 보여줌. `huphy-run` 에도 있음.
화면의 **녹화** 버튼으로 누른 구간만 `logs/track/<월일>_track_live_*.json` 으로 남길 수 있음.
화면 설명은 [tools/README.md](../../../tools/README.md).

`--log [DIR]` 을 주면 파일 둘을 남김. 정책 입출력은 없음.

| 파일 | 무엇 | 볼 곳 |
|---|---|---|
| `track/<월일>_track_<명령>[_<인자>].json` | 매 주기 관절 목표각(`tgt/`)과 실측각(`pos/`). 접근 구간부터 | `tools/policy_viewer.html` |
| `latency/<월일>_latency_<명령>[_<인자>].json` | 관절별 응답 지연. 첫 상태 읽기부터. 끝날 때 p50/p95/p99 표도 찍음 | `tools/latency_viewer.html` |

`zero`·`pose` 는 목표가 고정이라 실측이 거기로 어떻게 다가가고 얼마나 처지는지가
보임. 뷰어의 "관절별 추종" 칸이 목표(점선)·실측(실선)·오차를 같이 그림.

정해진 패턴으로 Ctrl-Q 를 누를 때까지 계속 움직임.

| | 무엇 | 무엇을 보나 |
|---|---|---|
| `zero` | 관절 전부를 0도로 두고 붙잡음 | 자세가 유지되는가. 처지면 `kp` 부족, 떨면 과함 |
| `range` | 관절마다 최소~최대를 오감 | 끝까지 가는가. 걸리는 데는 없는가 |
| `pose` | 준 각도로 옮기고 붙잡음 | 원하는 자세를 직접 넣어 봄 |
| `watch` | **토크를 끄고** 위치만 읽음 | 손으로 움직인 각도를 실시간으로 보고 녹화 |
| `studio` | 웹에서 토크·게인·자세·동작 순서를 다룸 | 자세를 손으로 넣어 보고, 엮어서 반복 |

### `studio` — 웹에서 자세와 동작 순서

```bash
huphy-test --robot studio                       # http://127.0.0.1:8770 (이 기계에서만)
huphy-test --robot studio --gain-scale 0.4      # 처음 게인 = robot.yaml 값 x 0.4
huphy-test --robot studio --open                # 같은 망의 노트북에서도 (제어가 붙음 -- 주의)
huphy-test --robot studio --log                 # 실행 전체를 logs/track/*.json 으로도
```

**힘이 풀린 채로 시작함.** 실시간 뷰어 위에 제어 패널이 붙음.

| 상태 | 뜻 | 할 수 있는 것 |
|---|---|---|
| `FREE` | 토크 없음. 위치만 읽음 | 토크 켜기, 게인 미리 정하기 (바로 걸림) |
| `HOLD` | 지금 목표를 붙잡음 | 자세 실행, 재생, 게인 바꾸기, 토크 끄기 |
| `RAMP` | 게인을 0.3초에 걸쳐 바꾸는 중 | 기다림 |
| `MOVING` | 정한 시간에 자세로 이동 | 정지(그 자리 붙잡기), 토크 끄기 |
| `PLAYING` | 키프레임을 차례로 (반복) | 정지, 토크 끄기 |
| `DAMPING` | 토크를 끄기 전 감쇠 (5초) | 기다림 |

튀지 않게 하는 것:

- **토크를 켤 때 목표 = 지금 실측 자세.** 켜는 순간 당기는 힘이 없음
- 이동과 재생은 늘 **지금 목표**에서 출발함 (처져 있어도 목표가 끊기지 않음)
- **게인은 `HOLD` 에서만** 바꾸고 0.3초에 걸쳐 바꿈

**게인은 값으로 넣음.** 모터 이름(`hip_pitch hip_roll hip_yaw knee ankle_a ankle_b`)마다
kp/kd 한 쌍, **양다리 공통**. 표에 지금 값·robot.yaml 값·상한이 같이 나옴.

- 상한은 모터 통신 형식(MIT)이 실을 수 있는 최댓값뿐임 (RS03·RS04 kp 5000, kd 100).
  넘으면 보내는 숫자가 잘려 적은 값과 다른 게인이 나가서 거부함. **robot.yaml 값은
  상한이 아님** -- 처음 값(`--gain-scale` 을 곱함)과 기준으로만 씀
- "yaml 값으로 채우기", "배율로 채우기" 는 입력칸만 채움. "게인 적용" 을 눌러야 나감
- 게인은 동작 순서 파일에 안 들어감 -- 튜닝 값이라 동작과 따로 둠
- robot.yaml 에서 양다리 값이 다르면 시작할 때 알리고 첫 다리 값을 기준으로 씀
- 목표가 한계 밖이면 실행 전에 거부함. 가드는 그대로 걸려 있음
- 이동 시간은 0.2초 이상
- 이동·재생 중 **화면이 5초 끊기면** 그 자리를 붙잡음

웹 요청은 큐에만 들어가고 **제어 루프가 다음 주기 앞에서 처리함** (`ControlLoop.before_step`).
웹 서버 스레드가 직접 토크를 켜거나 게인을 바꾸면 루프와 동시에 버스를 씀.

발목은 **모터각**(`ankle_a`/`ankle_b`)으로 받음 (`pose --ankle-space ab` 와 같음). 동작
순서 파일(`config/sequences/<이름>.json`)도 모터각이고 `ankle_space: ab` 를 적어 둠.

```json
{"name": "wave_1", "ankle_space": "ab", "repeat": 0,
 "keyframes": [{"pose": {"right_leg/knee": 40.0, "...": 0}, "move_s": 2.0, "hold_s": 0.5}]}
```

`repeat` 0 은 무한. 패널의 "지금 자세 불러오기" 를 쓰면 토크를 끈 채 손으로 자세를 잡고
그대로 키프레임으로 만들 수 있음.

### `watch` — 손으로 움직이는 것을 기록

```bash
huphy-test --robot watch                 # 실시간 뷰어가 기본으로 켜짐 (8770)
huphy-test --robot watch --log           # 실행 전체도 logs/track/*.json 으로
```

제어 루프를 관찰 모드로 돌림 -- 들어갈 때 토크를 끊고, 힘이 0인 명령(kp = kd = 토크
= 0)을 보내 그 응답으로 위치를 받음. MIT 모드에는 읽기 전용 명령이 없음. 관찰 모드에서는
motion 이 안 불리므로 기록기(`track_log.ObservationTap`)를 루프의 텔레메트리 자리에
꽂아 매 주기 관찰을 받음.

| 기록 | 열 |
|---|---|
| 관절 | 다리마다 `hip_pitch hip_roll hip_yaw knee`, 발목 자세 `ankle_pitch ankle_roll`, 발목 모터 `ankle_a ankle_b` 의 `pos/` |
| IMU | `imu/<이름>/...` (붙어 있으면) |

목표가 없어 `tgt/` 열이 없음. 실시간 뷰어와 `policy_viewer` 는 그때 실측만 그리고, 관절
칸 머리에 지금 값과 보이는 창의 범위(어디서 어디까지 움직였나)를 보여줌.

### `pose` 의 각도 넣는 법

둘 중 하나만 씀. 섞으면 거부함 — 숫자가 어느 관절로 갈지 정할 근거가 없음.

| | 방식 | 안 준 관절 |
|---|---|---|
| 숫자만 | 다리 하나 6개, 로봇 전체 12개를 순서대로 | — (전부 줘야 함) |
| `이름=값` | 준 관절만 | **0** |

숫자 순서는 `hip_pitch hip_roll hip_yaw knee` 다음에 발목 두 개이고, 로봇 전체면
**왼다리 6개 다음 오른다리 6개**임. 양다리 모델의 출력 규격과 같은 순서라 모델이 낼
자세를 그대로 옮겨 넣을 수 있음. `robot.yaml` 의 다리 순서와는 무관함.

발목 두 칸은 `--ankle-space` 가 정함. **기본은 모터 각도**임.

| | 발목 두 칸 | 한계의 출처 |
|---|---|---|
| `ab` (기본) | `ankle_a` `ankle_b` — 모터각을 그대로 보냄 | 여섯 개 다 캘리브레이션 실측값 |
| `rp` | `ankle_pitch` `ankle_roll` — 기구학을 거쳐 모터각으로 | 발목만 `AnkleEnvelope` 의 시험 범위 |

`rp` 의 발목이 실측값을 못 쓰는 이유: 모터 두 개가 물려 있어 **한 모터의 최대각이
다른 모터의 자세에 따라 달라짐.** 모터 한계를 관절 한계로 옮길 수 없음.

안 준 관절을 지금 자세가 아니라 0 으로 두는 이유: 결과가 실행할 때마다 같아야 함.
시작 전에 목표 전부를 표로 찍고, 한계 밖이면 표시함. 발목 외 관절은 가드가 한계
안쪽으로 자르고, 발목은 기구학이 못 풀면 그 목표를 버림.

이름으로 줄 때는 그 공간의 이름만 받음. 음수는 그냥 치면 됨 (`-10`).

### 끝나면 실패 집계를 찍음

`huphy-test` 와 `huphy-run` 이 루프가 끝난 뒤 한 번에 찍음. 텔레메트리를 켜지
않아도 됨 (`scripts/failures.py`).

```
  주기       1000회 10.0초  평균 99.8Hz / 목표 100Hz  밀림 3회  최악 14.2ms
  수거 대기  2ms  (주기 10.0ms 의 20%)
  무응답     12주기 (1.2%)

  채널        송신실패  수신실패  대기초과      버림
  can1               0         0         7         0
  can0               0         0         5         0

  모터                      빠짐    명령    비율
  left_leg/ankle_a             7    1001    0.7%
  right_leg/knee               5    1001    0.5%

  가드 자름   limit 4
  가드 거부   없음
```

| 줄 | 무엇 |
|---|---|
| 대기초과 | 기다린 개수를 못 채우고 수거 대기 시간을 다 쓴 횟수 |
| 버림 | 수신 스레드 큐가 차서 버린 프레임. 양다리만 해당 |
| 버스오류 | 버스에서 난 CAN 오류 프레임 수. 응답으로 세지 않음. **0 이 아니면 버스 오류가 실제로 있는 것** (배선·노이즈·타이밍). gs_usb 만 냄 -- slcan 은 늘 0 |
| 모터별 | 명령한 횟수 대비 응답이 없던 횟수. 빠진 모터만 나옴 |

**연결한 뒤부터의 누적**임. 연결 직후 상태 조회와 영자세로 옮기는 구간이 들어감.

### `--drain-ms` — 응답을 기다리는 최대 시간

```bash
huphy-test --robot --hz 100 --drain-ms 4 zero
huphy-run --policy walk --cmd vx=0.5 --drain-ms 4
```

기본 4ms. 다 오면 즉시 빠져나가므로 정상 주기에는 이만큼 쓰지 않음.

| | |
|---|---|
| 늘리면 | 늦은 응답을 이번 주기에 받아 무응답·대기초과가 줄어듦 |
| 대신 | 모터 하나가 죽으면 매 주기 이만큼을 통째로 씀 → 밀림 |

양다리도 **마감 하나를 같이 씀** (`Biped.collect`) -- 앞 다리가 마감까지 기다리는
동안 뒤 다리 응답은 수신 스레드가 받아 둬서, 최악이 다리 수만큼 곱해지지 않음.
주기의 80% 를 넘으면 집계에 경고가 찍힘. 주기(`--hz`)와 함께 바꿔 가며 실패 집계를
보는 용도임.

지금 자세에서 목표까지 `--approach` 초(기본 3)에 걸쳐 옮긴 뒤 패턴을 시작함.
왕복은 사인파이고 `--period`(기본 6초)에 한 번 오감.

관절 한계의 출처가 둘임.

```
hip_pitch hip_roll hip_yaw knee     캘리브레이션 파일의 limits_deg
ankle_pitch ankle_roll  AnkleEnvelope 의 시험 범위
```

한계가 없는 관절은 빠지고, 어느 관절을 뺐는지 화면에 냄. `--margin`(기본 5도)만큼
한계 안쪽까지만 감.

Ctrl-Q 는 `QuitWatcher` 가 별도 스레드에서 봄. 터미널을 cbreak 로 바꾸고 빠져나올 때
되돌림. 화면이 아니면 켜지 않고 Ctrl-C 로 끊음.

---

## `can.py` -- `huphy-can`

CAN 채널을 올리고 내리고 상태를 봄. 채널 이름은 `robot.yaml` 에서 읽음.

| | 하는 일 |
|---|---|
| `up` | `ip link set <ch> down` 다음 `up type can bitrate 1000000`. slcand 가 떠 있으면 먼저 끔. 막힌 송신 큐도 비워짐 |
| `down` | 내림 |
| `status` | lsusb 의 candleLight 개수, gs_usb 로드 여부, 채널별 링크·CAN 상태·비트레이트·error-warning/passive/bus-off·막힌 큐, 최근 10분 gs_usb echo 오류. 손볼 것이 있으면 종료 코드 1 |

root 가 아니면 `sudo` 를 붙여 부름. 암호는 sudo 가 터미널에서 물음 -- 이 코드는 암호를
받지 않음. `--channel canr` 로 하나만, `--config` 로 다른 하드웨어 버전.

---

## `run.py`

정책 꾸러미(`config/policies/<이름>/`) 하나로 움직임. `selftest` 와 **같은 다리·같은
루프**를 쓰고, 매 주기 관절 목표를 내는 것만 다름.

```bash
huphy-run --policy walk --cmd vx=0.5 --cmd wz=0.0
huphy-run --policy squat --cmd h_star=0.80
huphy-run --policy squat --checkpoint 4500
```

**정책별 코드가 없음.** `main()` 의 순서:

| 단계 | 함수 | 하는 일 |
|---|---|---|
| 1 | `_policy_folder(args.policy, path)` | `--policy` -> 꾸러미 폴더. 경로 / `robot.yaml` 옆 `policies/<이름>` / `config/policies/<이름>` 순으로 찾음 |
| 2 | `deploy.load(folder)` | `deploy_contract.json` -> `DeployPolicy` (관절 순서, 기본 자세, 자르기 범위, 관찰 항목, 명령, 주기) |
| 3 | `policy.load_model(args.checkpoint)` | sha256 대조 -> `rsl_rl.load` (입출력 개수 대조) -> 참조 입출력 대조 |
| 4 | `_parse_commands(args.cmd, policy)` | `--cmd 이름=값` -> `deploy.Commands`. 없는 이름·범위 밖이면 멈춤 |
| 5 | | `--hz` 가 `policy.hz` 의 정수 배인지, `policy.order` 의 다리가 `robot.yaml` 에 있는지 |
| 6 | `build_biped` -> `connect` | 여기서 처음 CAN 을 엶 |
| 7 | `policy.motion(model, imu, commands=...)` | 매 주기 `Runner.step` -> 관찰 -> 모델 -> 목표각 |
| 8 | `staged(approach(policy.default_pose(), ...), ...)` | 기본 자세로 옮김 -> 대기 -> Enter -> 정책 |

1~5 는 모터를 켜기 전임. 계약·가중치·명령이 어긋나면 여기서 멈춤.

시작은 세 단계임 (`staged`). `--approach` 초에 걸쳐 시작 자세로 옮김 → 그 자세로
대기 → **Enter** 를 누르면 정책. **Ctrl-Q** 로 멈춤 (`huphy-test` 와 같은 키). 끝나면
실패 집계를 찍음.

`EnterWatcher` 가 `selftest.QuitWatcher` 를 이어받아 한 스레드에서 두 키를 봄 --
터미널을 한 글자 모드로 두므로 `input()` 으로는 Enter 를 못 받음. `QuitWatcher.on_key`
가 Ctrl-Q 가 아닌 키를 넘겨 줌. 화면이 아니면(파이프) 바로 시작하고 Ctrl-C 로 끊음.

### 옵션

| | 기본 | 무엇 |
|---|---|---|
| `--policy` | **필수** | 꾸러미 이름 또는 폴더 (`walk`, `stair_slope`, `squat`) |
| `--checkpoint` | 계약의 `default_checkpoint` | 같은 꾸러미의 다른 체크포인트 |
| `--cmd 이름=값` | 계약의 시작값 | 정책 명령. 여러 번. `--teleop` 없으면 실행 내내 고정 |
| `--teleop` | 끔 | pygame 창으로 실시간 조작 (`control/teleop.py`, 별도 프로세스). W/S vx, A/D wz, ↑/↓ h_star, Space 0, Enter 시작, Esc·Ctrl-C·Ctrl-Q 멈춤 |
| `--max/--accel/--decel 이름=값` | 0.5 / 0.5 / 1.0 | `--teleop` 의 속도 상한 · 누르는 동안 가속 · 뗐을 때 감속 (h_star 는 `--accel` 만, 기본 0.05 m/s) |
| `--hz` | 정책 주기 | 모터 전송 주기. 정책 주기의 정수 배. 정책은 늘 정책 주기 (`held`) |
| `--drain-ms` | `2` | 응답 대기. slcan(1.0) 이면 `--hz 50 --drain-ms 4` |
| `--gain-scale A [B]` | `1.0` | kp/kd 배율. 하나면 전체, 둘이면 나머지 A · 발목(`ANKLE_MOTORS`) B |
| `--log [DIR]` | 끔 | 정책 입출력과 응답 지연 기록. 폴더를 안 주면 `logs/` |
| `--live [PORT]` | 끔 | 도는 동안 관절 목표·실측을 브라우저로. 포트를 안 주면 8770 |

**게인 배율은 `build_leg` 가 함** -- `gain_scale` 이 전체 배율이고 `joint_gain_scale`
(관절 이름 -> 배율)이 `ANKLE_MOTORS`(`ankle_a`/`ankle_b`)만 따로 덮어씀. 시작
화면의 게인 줄은 **모터에 실제로 걸린 값**을 읽어 찍음.

**`--ankle-output`(torque)은 지금 `run.py`에 CLI로 없음 — `Leg` 쪽 기능은 그대로
있지만 띄울 진입점이 없는 상태임.** 예전 `balance`/`hopping`만 `rp` 발목 공간에서
이 플래그(관절 공간 PD를 야코비안으로 모터에 내리는 경로, `ankle_kp`/`ankle_kd`)
를 썼는데, 그 정책들이 지워지면서 `run.py`가 더 이상 `build_leg(ankle_output=...)`
를 안 넘김 -- 코드(`robots/leg.py`의 `ANKLE_TORQUE` 분기)는 안 지웠지만, 지금은
아무 명령줄도 이 경로를 호출하지 않음. 발목 토크 출력을 쓰는 정책이 다시 생기면
`run.py`에 이 플래그만 되살리면 됨.

### 기록 (`--log`)

| 파일 | 무엇 | 만드는 곳 |
|---|---|---|
| `policy/<월일>_policy_<정책>[_<인자>].json` | 정책 호출마다 관찰·출력·목표각·실측각 | `telemetry/policy_log.py` |
| `latency/<월일>_latency_<정책>[_<인자>].json` | 모터마다 송신 → 응답 도착 지연 (제때/늦음/유실) | `telemetry/latency_log.py` |

정책 기록은 모델(`wrap_model`)과 정책 motion(`wrap_motion`)을 감싸서 잡음. 지연은 접근
구간부터 재고, 끝날 때 관절별 p50/p95/p99 표를 찍음. 둘 다 메모리에 쌓았다가 토크를
끊은 **뒤** `finally` 에서 씀 -- 저장이 실패해도 정지 절차를 막지 않음. 보는 법은
[`tools/README.md`](../../../tools/README.md).

### 연결 실패

채널이 안 올라와 있으면 진입점 넷이 모두 `canbus.bring_up_hint()` 의 명령을 찍음.
채널 이름으로는 어댑터 종류를 알 수 없어서 USB 어댑터(`slcand -s8` + `ip link set up`)와
네이티브(`ip link set ... type can bitrate 1000000`) 두 방식을 같이 찍음.

---

## 넷의 차이

| | `commission.py` | `bringup.py` | `selftest.py` | `run.py` |
|---|---|---|---|---|
| 무엇 | 조립할 때 한 번 | 하나씩 골라 움직여 봄 | 정해진 패턴을 계속 | 학습한 정책 |
| 주기 | 없음 | 제어 루프 | 제어 루프 | 제어 루프 |
| 되돌리기 | 어려움 | 쉬움 | 쉬움 | 쉬움 |
| 사람이 하는 일 | 관절을 손으로 잡음 | 메뉴를 고름 | 보고만 있음 | 보고만 있음 |
| 목표를 정하는 것 | 사람 | 사람 | 코드의 패턴 | 신경망 |

---

## 테스트

```bash
PYTHONPATH=src python3 -m pytest tests/test_commission_cli.py tests/test_bringup.py tests/test_selftest.py -q
```

`commission` 71개, `bringup` 30개, `selftest` 27개. 가짜 모터가 붙은 가짜 CAN 버스에
대고 명령줄과 메뉴를 그대로 돌림. 설정 파일은 임시 폴더에 만들어 씀.

---

## 조립 함수 — `bringup.build_leg` / `bringup.build_biped`

설정을 실행 객체로 바꾸는 곳. 진입점 넷이 전부 이 둘 중 하나를 씀.

```python
build_leg(robot, limb)      # 다리 하나.       ControlLoop 에 그대로 들어감
build_biped(robot)          # 로봇 전체.       kind: leg 인 팔다리를 전부
```

둘 다 `Robot` 계약을 채우므로 제어 루프 입장에서는 차이가 없음.

### `build_biped` 가 다르게 하는 것

| | 왜 |
|---|---|
| 수신 스레드를 켬 | 버스가 둘이면 순차 수거의 총 대기가 두 배가 됨 |
| IMU 를 다리에 안 붙임 | 로봇이 들고 있음. 몸통 센서는 어느 다리의 것도 아님 |
| 관절 이름에 팔다리가 붙음 | `right_leg/knee`. 무릎이 둘이라 구분이 필요함 |

나머지 인자(`gain_scale` 등)는 `build_leg` 로 그대로 넘어가 **양다리에 같이**
걸림.

### 순서가 곧 열 순서임

`limbs` 를 생략하면 `robot.yaml` 에 적힌 순서를 씀. 그 순서가 관절 이름 순서와
텔레메트리 열 순서를 정하므로, 설정에서 다리 순서를 바꾸면 로그 열 순서도 바뀜.

---

## `current.py`

```bash
huphy-current                        # 포트를 찾아 계속 보여 줌
huphy-current --port /dev/ttyUSB1
huphy-current --quiet --seconds 10   # 조용히 재고 요약만
```

전류계(WCM1600)로 **로봇 전체 DC 전류**를 봄. `config/robot.yaml` 을 안 읽음 --
전류계는 설정의 항목이 아니고 필요할 때만 꽂는 장비임 (`sensors/wcm1600/`).

끝낼 때 프레임 수·평균·최소·최대를 찍음. **기준선을 잴 때 쓰는 화면임** -- 로봇을
세워 둔 채(모터는 자세 유지 전류만) 평균을 재 두면, 나중에 로그의
`current/total_a` 에서 그만큼을 빼고 계산값 `power/dc_a_lo` 와 비교할 수 있음
(`telemetry/power.py` 4절).

기록에 남기는 것은 이 명령이 아니라 `huphy-run --current` 또는 ROS `current_node` 임.
