Human-Pygmalion/HUPHY/src/huphy/telemetry/README.md

# `telemetry/` — 무슨 일이 일어났는지 내보냄

```
telemetry/
├── snapshot.py   한 시점의 사전. 필드 이름을 정하는 유일한 곳
├── udp.py          UDP JSON 송신. 실시간으로 보는 것
├── csv_log.py      CSV 기록. 끝나고 되돌아보는 것
├── policy_log.py   정책이 본 입력과 낸 출력. huphy-run --log
├── track_log.py    매 주기 관절 목표각과 실측각. huphy-test --log
├── live.py         같은 값을 브라우저로 실시간. huphy-test / huphy-run --live
├── live_viewer.html  live.py 가 내주는 화면
├── latency_log.py  관절별 응답 지연 (송신 -> 도착). huphy-run / huphy-test --log
├── power.py        읽어 온 상전류로 구리 손실. ROS log_node 가 씀
└── run_name.py     위 셋의 파일 이름·`run` 칸·JSON 쓰기
```

앞의 셋은 **한 주기의 로봇 상태**(스냅샷)를 내보내고, 뒤의 셋은 `--log` 으로 켜는
실행 기록임 -- 모델이 실제로 본 벡터, 시험 패턴의 목표·실측, 프레임 하나하나의 왕복
시간. 뒤의 셋을 보는
도구는 [`tools/README.md`](../../../tools/README.md).

---

## 왜 제어보다 먼저인가

게인을 튜닝하려면 **목표와 실측을 겹쳐 봐야 함.**

```
목표를 지나쳤다 돌아옴    ->  kd 를 올림
목표까지 못 감            ->  kp 를 올림
부르르 떨림               ->  kp 를 내림
```

눈으로만 보면 "지나쳤다 돌아온다" 를 구분할 수 없음. 그래프가 없으면 게인을
찾을 수 없고, 게인이 없으면 다리가 안 움직임.

---

## 필드 이름은 한 곳에서만 정함

`snapshot.py` 가 사전 하나를 만들고 **UDP 와 CSV 가 둘 다 그것을 소비함.**

두 군데에서 필드를 만들면 반드시 어긋남 — CSV 헤더에는 있는데 UDP 에는 없는 값이
생기고, 어느 쪽이 맞는지 알 수 없어짐.

```python
snapshot.field_names(robot)   # 실행 전에 알 수 있음
snapshot.build(robot, t=1.5)  # 그 목록과 정확히 같은 키
```

테스트가 둘이 같은지 고정함.

### 실행 전에 알 수 있어야 함

CSV 헤더를 첫 줄에 써야 하고, PlotJuggler 레이아웃도 미리 만들어 둬야 함.

**필드가 나타났다 사라지면 안 됨.** 값이 없어도 키는 내보내고 `0` 을 채움 — 중간에
사라지면 그래프가 끊기고 CSV 열이 밀림.

---

## 두 갈래로 나감

**빠른 것 — 매 주기** (42필드, 약 1.2 KB)

```
t                            시작부터 흐른 초
loop_dt                      직전 루프 실제 주기 (ms)

right_leg/knee/pos           실측 위치 (cal 공간)
right_leg/knee/tgt           목표 위치. 실제로 나간 것
right_leg/knee/err           tgt - pos
right_leg/knee/vel           실측 속도
right_leg/knee/tau           실측 토크

right_leg/ankle_pitch/pos    실측 각도. 모터각을 FK 로 푼 것
right_leg/ankle_pitch/tgt    목표 각도
right_leg/ankle_pitch/err    tgt - pos
right_leg/ankle_pitch/vel    실측 각속도. 모터 속도를 야코비안으로 푼 것
right_leg/ankle_roll/...     같은 넷

right_leg/ankle_a/tau_cmd   tau_ff 로 실어 보낸 토크
right_leg/ankle_b/tau_cmd
```

`tau` 와 `tau_cmd` 는 다른 값임 — 앞은 **모터가 냈다고 보고한 값**이고 뒤는
**우리가 시킨 값**임. 둘을 같이 봐야 `tau` 가 낮을 때 적게 시킨 것인지, 시킨 만큼
못 낸 것인지(전류 한계·마찰·걸림) 구분됨. 위치 모드에서는 `tau_cmd` 가 늘 0임 —
모드에 따라 열이 나타났다 사라지면 CSV 가 밀림.

발목만 **관절 축**을 따로 냄. 모터 값(`ankle_a/pos`)만 보면 발이 어떤 자세인지 안
보임 — 두 모터가 로드로 물려 있어 각도 하나가 자세 하나에 대응하지 않음. 모터 값도
그대로 나가므로 둘을 같이 볼 수 있음.

**진단 — N주기마다** (35필드, 약 950 B. 기본 10주기)

```
t
missing                      명령했는데 응답이 없는 모터 수
since_clip                   마지막 클리핑 이후 경과 (초). 없었으면 -1
since_reject                 마지막 거부 이후 경과 (초)

right_leg/knee/temp          권선 온도
right_leg/knee/age           마지막 응답 이후 경과 (ms). 한 번도 없었으면 -1
right_leg/knee/ack           1 응답함 / 0 씹힘 / -1 명령하지 않음
right_leg/knee/miss          연속 무응답 주기 수

right_leg/guard/clip_limit   한계에 잘린 횟수 (누적)
right_leg/guard/clip_jump    점프에 잘린 횟수
right_leg/guard/reject_nan   NaN 으로 버린 횟수
right_leg/guard/reject_nostate  현재 위치를 몰라 버린 횟수

right_leg/can/tx_errors      송신 실패
right_leg/can/rx_errors      수신 실패
right_leg/can/drain_timeouts 기대한 응답을 못 채운 횟수
```

**IMU — 매 주기** (붙었을 때만. **필드 수가 센서마다 다름**)

공통 열은 센서를 바꿔도 같음.

```
t
imu/main/gx                  각속도 (도/초)
imu/main/gy
imu/main/gz
imu/main/ax                  가속도 (m/s^2). 중력 포함
imu/main/ay
imu/main/az
imu/main/grav_x              중력방향 단위벡터. 정책에 그대로 들어가는 값
imu/main/grav_y
imu/main/grav_z
imu/main/age                 파싱한 지 얼마나 됐나 (ms). 한 번도 없었으면 -1
```

센서 고유 열이 뒤에 붙음. 목록은 구현체의 `extra_fields` 가 냄.

```
EBIMU   qw qx qy qz  roll pitch yaw  dx dy dz  temp  sensor_ms  sensor_dt
Xsens   roll pitch yaw  temp  sensor_ms  sensor_dt
```

`grav_*` 는 **정책이 실제로 본 값**임. 자세가 이상해 보일 때 센서 원본이 이상한
것인지 중력방향 계산이 이상한 것인지 여기서 갈림.

`sensor_dt` 는 직전 패킷과의 **센서 시각** 차임. 100Hz 면 10이 정상이고, 20이면 한
개가 빠진 것임. `age` 와 같이 봐야 원인이 좁혀짐.

    sensor_dt 10, age 10       정상
    sensor_dt 10, age 가 튐    센서는 규칙적인데 우리 스레드가 밀림
    sensor_dt 20, 30           패킷이 빠지는 중. 선이나 보레이트
    age 만 자람                센서가 멈춤

**나누는 이유는 패킷 크기임.** 합치면 66필드에 약 1.8 KB 로 MTU 를 넘어 조각남.

나누는 것이 자연스럽기도 함 — `temp` 는 초 단위로 변하고 카운터는 사건이 있을 때만
변함. 100Hz 로 보낼 이유가 없음.

**CSV 는 나누지 않음.** 진단 값도 매 주기 계산해 한 줄에 다 넣음 — 나누는 것은
보내는 쪽뿐임.

---

## 명령이 씹혔는지 잡아냄

### ack 가 두 층임

**CAN 하드웨어 ACK** — 프레임마다 ACK 비트가 있고 **버스에 붙은 아무 노드나** 한 개가
찍어줌. "누군가 들었다" 일 뿐이고, 아무도 안 찍으면 `can/tx_errors` 가 오름.

**응답 프레임** — MIT 모드는 명령을 받으면 **반드시 상태 프레임으로 답함.** 그게
그 모터가 처리했다는 증거임. `ack` 가 이것임.

### 둘을 같이 보면 원인이 좁혀짐

| `tx_errors` | `ack` | 뜻 |
|---|---|---|
| 0 | 1 | 정상 |
| 0 | 0 | **모터가 명령을 무시함** — 프로토콜·제어 모드 불일치 (이슈 #11) |
| > 0 | — | 버스에 아무도 없음 — 배선·전원 |

### `age` 가 가장 믿을 만함

응답이 한 번도 없던 모터는 **현재 위치를 몰라 가드가 명령을 거부함**
(`reject_nostate`). 그러면 명령이 안 나가고, 명령이 안 나갔으니 응답 대상에서도
빠짐 — **그 모터가 `ack` 에서 `-1` 로 가려짐.**

`age` 는 명령 여부와 무관하게 참임. `-1` 이면 한 번도 응답한 적이 없다는 뜻임.

```
모터           ack  miss   age(ms)
ankle_b      -1.0   1.0     -1.00   <- 한 번도 응답 없음
reject_nostate 3.0                    <- 매 주기 거부됨
can/tx_errors  0.0                    <- 배선이 아니라 모터가 무시하는 것
```

### 응답은 명령한 모터만 보냄

`collect()` 가 **직전에 명령한 개수만** 기다림. 전체를 기다리면 명령하지 않은
모터가 무응답으로 잡혀 가짜 고장이 보임.

### `since_clip` / `since_reject`

누적 카운터만으로는 **언제 일어났는지** 그래프에서 계단을 찾아야 함. 이 값은 사건
직후 0으로 떨어졌다 올라가서 눈에 바로 띔.

없었으면 `-1` 임.

---

## 이름 규약

`/` 로 나눔. PlotJuggler 가 트리로 묶어 보여줌 — 모터가 20개를 넘어가면 평평한
목록에서는 찾을 수 없음.

**팔다리 이름이 앞에 붙음.** 양다리를 같이 기록할 때 `knee` 가 둘이 되기 때문임.

**IMU 만 예외로 개체 이름을 씀** (`imu/main/roll`). 같은 센서가 다리에 붙었다가
몸통으로 옮겨감 — 팔다리 이름을 쓰면 옮기는 순간 필드 이름이 바뀌어 예전 로그와
그래프 레이아웃이 안 맞음.

### `tgt` 는 실제로 나간 명령임

명령한 값이 아니라 **잘리고 남은 값**임 (`robot.last_sent`).

그래야 오차를 보고 "왜 모터가 저기까지만 갔지" 가 설명됨. 명령한 값을 기록하면
한계에 걸린 것과 게인이 낮은 것이 그래프에서 구분되지 않음.

발목은 명령이 관절(pitch/roll)로 오므로 모터별 목표가 없음. 그때는 실측을 목표로
둬서 오차를 0으로 냄 — 가짜 오차가 그래프에 남는 것보다 나음.

---

## 팔다리마다 따로 둠

```python
Telemetry(left_leg,  host=...)    # 빠른 패킷 + 진단 패킷 (+ IMU 패킷)
Telemetry(right_leg, host=...)    # 빠른 패킷 + 진단 패킷 (+ IMU 패킷)
```

**합쳐 보내지 않음.** 다리 하나의 빠른 패킷이 이미 850 B 라, 둘을 합치면 MTU 를
넘어 조각남. 조각 하나만 잃어도 패킷 전체가 버려져 손실률이 확 올라감.

PlotJuggler 는 여러 출처를 같은 타임라인에 올림. 팔·상체까지 붙으면 이 구성이
그대로 늘어남.

CSV 는 크기 제약이 없으므로 `merge()` 로 한 파일에 모아도 됨.

---

## `udp.py`

**보내고 잊음.** 받는 쪽이 없어도, 느려도, 꺼져 있어도 제어 루프가 멈추지 않음.

### 왜 TCP 가 아닌가

TCP 는 상대가 안 받으면 **송신이 막힘.** 제어 루프 한가운데서 막히면 주기가 통째로
밀림. UDP 는 커널 버퍼에 넣고 바로 돌아옴.

패킷이 몇 개 빠져도 상관없음 — 그래프에 점 하나가 비는 것뿐이고, 100Hz 로 보내므로
눈에 띄지도 않음.

### 예외를 던지지 않음

네트워크가 끊기거나 상대가 꺼져 있는 것은 **로봇 입장에서 정상 상황임.** 실패는
세기만 하고, 처음 한 번만 로그를 남김.

관측이 제어를 멈추면 관측할 대상이 없어짐.

### 진단 패킷 주기

```python
Telemetry(robot, host=..., diag_every=10)   # 100Hz 에서 10Hz
```

### 반올림

소수점 둘째 자리까지 보냄. 패킷 크기를 반으로 줄이는 데 이게 제일 큼.

0.01도는 모터 해상도(0.022도)보다 촘촘해서 **정보를 잃지 않음.**

### 시간축

`t` 를 PlotJuggler 의 timestamp 필드로 지정할 것. 지정하지 않으면 **수신 시각**을
쓰게 되어 네트워크 지터가 데이터에 섞임.

시각은 첫 호출을 0으로 하는 상대 시간임. 벽시계를 쓰면 x 축이 `1.7e9` 같은 값에서
시작해 읽을 수 없음.

### 자체 카운터는 UDP 로 안 나감

```python
tm.as_fields()   # {'udp.sent': ..., 'udp.errors': ..., 'csv.rows': ...}
```

나가는 경로가 고장났는데 **그 사실을 같은 경로로 알릴 수는 없음.** 로그와 CSV 로 봄.

---

## `csv_log.py`

UDP 는 실시간으로 보는 것이고, 이쪽은 **끝나고 나서 되돌아보는 것**임. 사고가 났을
때 그 직전 몇 초를 프레임 단위로 다시 볼 수 있어야 함.

### 열이 실행 전에 정해짐

첫 줄에 헤더를 쓰고 나면 열이 고정됨. 헤더에 없는 키는 버리고 셈.

**열이 밀리면 기록 전체가 못 쓰게 됨.** 나중에 열어 보면 어느 열이 무엇인지 알 수
없고, 그걸 알아채는 것은 보통 사고 조사 중임.

### 이어 쓰지 않음

열 구성이 실행마다 다를 수 있는데(모터를 추가하거나 관절 이름을 바꾸면) 이어 쓰면
한 파일 안에 두 형식이 섞임.

### 디스크 쓰기가 주기를 흔듦

`flush_every` 주기마다 한 번만 밀어 넣음. 기본 50이면 100Hz 에서 0.5초마다임.

**멈출 때는 반드시 밀어 넣음.** 버퍼에 남은 것이 사라지면 사고 직전 몇 줄을 잃는데,
하필 그게 제일 보고 싶은 부분임.

소수점은 셋째 자리까지 — UDP 보다 한 자리 더 남김. 크기 제약이 없고, 나중에
미분해서 볼 때 반올림 오차가 커짐.

---

## `policy_log.py`

정책 한 번 실행의 입출력을 남김. 스냅샷에는 관절 상태만 있고 **모델이 본 벡터**는
없음 -- 관찰이 학습 때와 어긋났는지는 그 벡터를 봐야 앎.

    t                 첫 정책 호출부터 흐른 초
    obs/...           모델 입력 그대로 (정규화 전, 라디안 단위)
    act/<관절>        모델 출력 그대로
    tgt/<관절>        관절 목표각 (도). 루프에 실제로 넘긴 것
    pos/<관절>        그 순간의 실측 관절각 (도)
    extra/<모터>/<값> 추가 값. `--extra` 를 켰을 때만 (`track_log` 와 같은 열)
    power/<모터>/...  전력. ROS `log_node` 에서 전기값을 읽을 때만 (`power.py`)
    current/total_a   전류계가 잰 로봇 전체 DC 전류 (A). 전류계를 켰을 때만
    current/age       그 값이 들어온 뒤 흐른 시간 (ms). 못 받았으면 -1

파일은 JSON 하나임 (`run_name.write`). `columns` 에 위 열 이름을, `rows` 에 한 주기
한 줄씩, `limits` 에 관절 가동범위를, `run` 에 이 실행의 인자를 담음.

### 두 군데를 감쌈

    wrap_model    벡터 -> 행동. obs 와 act 를 잡음
    wrap_motion   (t, 관찰) -> 목표. tgt 와 pos 를 붙여 한 줄을 완성함

모델만 감싸면 관절 이름이 붙은 목표·실측을 모름 -- 그 둘은 관절 이름이 붙은 사전에만
있음. motion 만 감싸면 모델이 본 벡터를 모름.

관찰 칸 이름은 `control/deploy.py` 의 `_term_names` 가 계약의 관찰 항목(`func`)마다
만들고, `policy.obs_names` 로 나와 `PolicyLog(obs_names, ...)` 에 들어감
(`scripts/run.py` 의 `PolicyLog(policy.obs_names, policy.order, robot=leg)`). 계약이
관찰 순서를 정하므로 이 README 를 고칠 일은 없고, 새 `func` 를 더하면 `_term_names`
에 그 이름 짓는 분기를 같이 더할 것. 길이가 어긋나면 첫 기록에서 세고 제어는 계속함.

### 메모리에 쌓고 끝날 때 씀

루프 안에서 파일을 쓰지 않음 (줄 하나에 수 µs). 50Hz 로 한 시간이 18만 줄 정도라
메모리로 충분함. 대신 **강제로 죽으면 남지 않음.**

---

## `track_log.py`

`huphy-test --log` 이 남김. 매 주기 한 줄.

    t              첫 주기부터 흐른 초
    tgt/<관절>     실제로 나간 관절 목표각 (도). 가드가 자른 뒤 값 (`robot.last_sent`)
    pos/<관절>     그 명령에 대한 실측 관절각 (도)
    imu/<이름>/<값> IMU. roll/pitch/yaw, gx/gy/gz, grav_x/y/z, ax/ay/az, age (`IMU_FIELDS`)
    extra/<모터>/<값> 추가 값. `--extra` 를 켰을 때만. iq (A), temp (C), vbus (V)

`extra/` 는 IMU 열 바로 뒤에 붙고, 실시간 뷰어(`live`)와 `policy_log` 에도 같은 열이
붙음. 전류·전압은 몇 주기에 한 번씩 갱신되므로(`--extra-per-cycle`) 그 사이 줄에는 마지막
값이 들어가고, 첫 값을 받기 전에는 빈 칸임. 온도는 모터가 정수 도로 보냄.

`policy_log` 에서 정책 칸(obs/act)을 뺀 모양이라 `tools/policy_viewer.html` 로 그대로
열림. 뷰어는 `act/` 가 없으면 관절 목록을 `tgt/` 에서 읽음.

`pos` 는 motion 이 받은 관찰임 -- 직전 주기에 수거한 값이라 같은 줄 `tgt` 보다 한
주기 앞섬. 응답이 빠진 주기는 마지막으로 받은 값이 그대로 남음.

---

## `live.py`

`--live [PORT]` 로 켬. `track_log` 와 같은 줄을 파일 대신 메모리 고리(60초)에 쌓고,
같은 프로세스의 HTTP 스레드가 `live_viewer.html` 과 `/data?since=<번호>` 를 내줌.
브라우저는 0.1초마다 새 줄만 받아 그림.

- 제어 루프는 줄 하나를 고리에 넣을 뿐임 (락 한 번). 브라우저가 없거나 느려도 모름
- `0.0.0.0` 에 열어서 같은 망의 노트북에서도 봄. 읽기 전용
- 포트가 막혀 있으면 경고만 하고 제어는 그대로 감
- **녹화**: 화면의 녹화 버튼(`POST /record/start`, `/record/stop`)이 누른 구간을 따로
  모아 `track/<월일>_track_live_<이름>.json` 으로 씀 (`track_log` 형식). 파일은 HTTP 스레드가
  씀. 녹화 중에 끝나면 `LiveServer.stop()` 이 거기까지 저장함
- **주기가 빠듯하면 끄고 돌릴 것.** HTTP 스레드도 GIL 을 잠깐씩 잡음 -- 끝 집계의
  밀림으로 확인

---

## `power.py`

읽어 온 상전류로 구리 손실을 계산해 열을 만듦. 전기값(`extra/`)을 읽는 쪽에서만
쓰임 -- 지금은 ROS `log_node` 뿐임 (`huphy-run --extra` 는 열을 안 만듦. 모델별
상저항을 꺼내는 길이 없음).

    power/<모터>/copper_w   그 모터의 구리 손실 (W)
    power/copper_w          모터 전부의 합 (W)
    power/dc_a_lo           DC 전류 **하한** (A)

    P_cu = 1.5 * iq**2 * R_phase

`R_phase` 는 모델별 사양값임 (`motors/robstride/tables.phase_resistance_ohm`).
모터는 DC 전류도 전력도 안 냄 -- 매뉴얼의 읽기 가능 항목이 네 개뿐임
(docs/motor_power.md 1절).

**하한인 이유:** 구리 손실만 계산함. 기계 출력(토크·속도가 기록 열에 없음), 철손,
인버터 손실, 감속기 손실의 상수가 없음. 한 모터라도 상전류를 못 받았으면 합이
`NaN` 임 -- 일부만 더한 값을 전체 합으로 읽지 않게.

### 실측 열이 같은 파일에 있음

전류계(`sensors/wcm1600/`)가 잰 값은 계산이 아니지만 열 이름을 이 파일이 냄
(`CURRENT_COLUMNS`, `current_values`). **둘이 같아질 수 없다는 것을 한 군데에 적어
두려는 것임.**

    current/total_a   로봇 전체 DC 전류 (A). 실측
    current/age       그 값이 들어온 뒤 흐른 시간 (ms)

    빠진 손실    철손 + 인버터 + 감속기 + 기계 출력     -> 계산값이 작음
    범위 차이    실측은 연산보드·팬·통신까지 다 포함    -> 실측이 큼

`current/total_a - power/dc_a_lo` 를 바로 "손실" 로 읽으면 안 됨. 로봇을 세워 둔
채 잰 값을 기준선으로 빼면 비교가 됨 (`huphy-current` 가 평균을 찍어 줌).

열이 생기는 길이 둘임.

    huphy-run --current        PolicyLog(current_source=meter.read). 줄마다 꺼냄
    ROS current_node           /huphy/bus_current -> log_node 가 줄에 넣음

`age` 를 같이 두는 이유: 장비 출력 주기가 로그 주기(50Hz)보다 느려 같은 값이 여러
줄에 반복됨. 없으면 "전류가 안 변함" 과 "장비가 멈춤" 이 구분되지 않음.

**켜 놓고 값이 안 와도 열은 남음.** 첫 줄로 열을 정하면 늦게 오는 값이 다 버려짐 --
그 줄들은 `current/age` 가 `-1` 임.

---

## `latency_log.py`

모터마다 **명령 묶음을 보내기 직전 시각 -> 수신 스레드가 응답을 받은 시각**을 잼.
`RobStrideBus.latency` 에 붙고, 안 붙어 있으면 버스는 시각을 재지도 않음.

    ontime   그 주기 수거에서 받은 것
    late     수거 대기를 넘겨 다음 주기에 들어온 것. 지연은 원래 명령 기준
    lost     끝내 안 온 것. 보낸 수 - 받은 수

MIT 응답에는 순번이 없어서, 도착 시각이 이번 송신보다 앞이면 직전 명령의 응답으로
봄. 묶음 송신 시각 하나를 쓰는 이유는 slcan 에서 앞 프레임이 직렬로 나가는 동안 뒤
프레임이 기다리는 시간도 루프가 겪는 지연이기 때문임.

끝나면 관절별 p50/p95/p99/최대·늦음·유실 표를 찍고 JSON 으로 씀. `meta` 칸에
`drain_ms`·`hz` 를 남겨 뷰어가 기준선을 그림. **수신 스레드가 없는 버스**(다리 하나)는
꺼낸 시각이 찍혀 지연이 조금 크게 나옴.

---

## `run_name.py`

위 셋(`policy_log`·`track_log`·`latency_log`)의 **파일 이름·`run` 칸·쓰기를 한 곳에
모은 것.** 한쪽만 고치면 같은 실행의 파일들이 다른 이름으로 나가, 어느 `latency` 가
어느 `policy` 와 같은 실행 것인지 이름으로 못 가림.

    <폴더>/<종류>/<월일>_<종류>_<이름>[_<인자들>].json

    logs/policy/1030_policy_walk_g0.5-0.8_vx0.3.json
    logs/latency/1030_latency_walk_g0.5-0.8_vx0.3.json
    logs/track/1030_track_zero_g0.3.json

- `tags()` 가 이름에 붙일 조각을 만듦. **기본값인 인자는 빼므로** 전부 기본값이면
  월일·종류·이름만 남음. `--teleop` 이면 명령값 자리에 `teleop` 하나만 넣음 (값이 매
  주기 바뀌어 이름에 넣을 수 없음 -- 실제 값은 `obs/cmd/<이름>` 열에 있음)
- `path()` 가 종류별 폴더를 붙임. 같은 이름이 있으면 `_2`, `_3`. **덮어쓰지 않음**
- `header()` 가 `run` 칸을 만듦. **이름에서 뺀 것이 전부 여기 들어감** -- 초 단위
  시각, 체크포인트, 기본값인 인자들. 이름은 찾기용, `run` 은 정확한 기록임
- `write()` 가 JSON 으로 씀

    {"run":     {"at": "2026-10-30 14:30:52", "policy": "walk", ...},
     "limits":  {"right_leg/knee": [6, 114], ...},
     "columns": ["t", "obs/gyro/x", ...],
     "rows":    [[0.0, 0.01, ...], [0.02, ...]]}

**열 이름을 한 번만 적고 값은 배열로** 둠. 줄마다 `{"t": ..., "obs/...": ...}` 로
쓰면 같은 기록이 1.9배로 커짐 (50Hz 60초, 열 81개 기준 2.2MB -> 4.0MB).

셋 다 CSV 였다가 JSON 으로 바꿨음. 전에는 뷰어가 `# limits ...` 와 `# run ...` 줄을
문자열로 쪼개 읽어야 했는데, 지금은 `doc.run.gain` 으로 바로 읽음. **스냅샷 쪽
(`csv_log.py`) 은 그대로 CSV 임** -- 저쪽은 제어 루프 안에서 매 주기 이어 쓰는
파일이라 끝에 한 번에 쓰는 JSON 과 맞지 않음.

---

## 쓰는 법

```python
from huphy import telemetry

tm = telemetry.Telemetry.from_config(leg, robot_config.telemetry)

with tm:
    while running:
        leg.send_action(action)
        tm.record(loop_dt_ms=dt * 1000)
```

무응답 모터 수는 인자로 넘기지 않음 — `Leg` 가 누가 답했는지 알고 있어 스냅샷이
직접 읽어 감.

설정에서 둘 다 꺼 두면 아무것도 하지 않음 — **호출부가 분기하지 않아도 되게 함.**

```yaml
telemetry:
  host: null            # 비우면 UDP 안 보냄
  port: 9870
  csv_path: null        # 비우면 파일 안 만듦
  csv_flush_every: 50
```

진단 패킷 주기(`diag_every`)는 설정 파일에 없음. 기본 10주기임.

---

## 받는 쪽

```bash
sudo ufw allow 9870/udp
ping <파이 IP>
echo '{"t":1,"x":42}' | nc -u -w1 <우분투 IP> 9870
```

PlotJuggler 에서 UDP Server 를 열고 포트와 `t` 를 지정하면 됨. 자세한 것은
[docs/monitoring.md](../../../docs/monitoring.md) 참조.

---

## 테스트

```bash
PYTHONPATH=src python3 -m pytest tests/test_telemetry.py -q
```

43개. UDP 는 **진짜 소켓**으로 자기 자신에게 보내 받아 봄 — 직렬화와 반올림이
실제로 왕복하는지 확인함. CSV 는 임시 폴더에 씀.

고정하는 것:

```
field_names() 와 build() 의 키가 같음
CSV 열 == 빠른 것 + 진단, t 는 한 번만
두 패킷이 각각 MTU 안에 들어가고, 합치면 넘침
진단이 diag_every 주기마다만 나감
CSV 는 매 줄에 전 필드가 채워짐
송신·기록이 실패해도 예외를 던지지 않음
close() 가 버퍼를 밀어 넣음
```

`ack` / `age` / `miss` 는 `tests/test_leg.py` 의 `TestLinkStatus` 가 고정함 —
링크 상태를 만드는 곳이 `Leg` 이기 때문임.

---

## 팔다리가 여럿일 때

기록 단위는 로봇이 아니라 **팔다리**임 (`snapshot.parts`).

```python
snapshot.parts(leg)      # (leg,)              다리 하나면 자기 자신
snapshot.parts(biped)    # (right_leg, left_leg)
```

### 이름이 깊어지지 않음

```
right_leg/knee/pos          <- 이대로
huphy/right_leg/knee/pos    <- 이렇게 되지 않음
```

합성 로봇을 통째로 한 단위로 보면 한 겹 깊어져서, 다리 하나로 돌리던 때의
로그·그래프 레이아웃과 안 맞음. 팔다리마다 따로 찍으면 예전 이름 그대로임.

### CSV 는 한 줄, UDP 는 팔다리마다 한 패킷

| | 왜 |
|---|---|
| CSV 한 줄 | 같은 시각의 두 다리를 나란히 봐야 함 |
| UDP 나눠 보냄 | 다리 하나가 이미 1 KB 가까움. 합치면 MTU(1500)를 넘어 조각남 |

조각 하나만 잃어도 패킷 전체가 버려짐. PlotJuggler 는 여러 출처를 같은 타임라인에
올리므로 나눠 보내도 그래프는 하나로 보임.

### IMU 는 한 번만

IMU 필드에는 팔다리 이름이 안 붙음 (`imu/main/gx`). 로봇 전체에서 한 번만 찍고,
몸통에 달린 것과 다리에 달린 것을 한 줄에 같이 넣음 — 대조하려면 같은 줄에 있어야
함 (`snapshot.imus_of`).
