Human-Pygmalion/HUPHY/docs/full_robot.md

# 실제 로봇 결합 — 다리 하나에서 양다리로

다리 하나를 어떻게 돌리는지, 양다리를 어떻게 묶는지, 남은 것이 무엇인지 정리함.

계층을 나눈 이유는 [architecture.md](architecture.md), 한 주기에 값이 어떻게
흐르는지는 [cycle.md](cycle.md).

---

## 0. 한눈에

| | 상태 |
|---|---|
| 설정 (`robot.yaml`) | 양다리가 다 적혀 있음 |
| 두 다리를 묶는 계층 | **있음** — `robots/biped.py` |
| 관절 이름 | `right_leg/knee` 로 구분됨 |
| IMU | 다리가 아니라 로봇이 들고 있음 |
| 통신 두절 | 이어지면 양다리가 같이 멈춤 |
| 수신 | 버스마다 스레드. 수거 대기가 겹침 |
| 진입점 | `huphy-test --robot` |
| 캘리브레이션 | 1.0 은 양쪽 다 비어 있음 — **재야 함** |
| 정책 | 관절 6개짜리. 양다리 모델은 학습 중 |

설정에만 있던 "로봇 전체" 라는 마디가 실행 쪽에도 생김. 남은 것은 실측과 정책임 —
둘 다 코드가 아님.

---

## 1. 다리 하나를 쓰는 방법

**여전히 유효한 경로임.** 브링업과 커미셔닝은 다리 하나씩 하는 작업이고, 조립을
확인할 때도 다리별로 먼저 돌려 봄. 양다리는 3장.

### 1.1 두 계층에 "로봇" 이 따로 있음

```python
robot = load_robot(path)          # RobotConfig — 설정. 양다리 다 있음
limb  = _pick_limb(robot, name)   # LimbConfig  — 그중 하나를 고름
leg   = build_leg(robot, limb)    # Leg         — 실행 객체
loop  = ControlLoop(leg, ...)     # 루프에 들어가는 것은 leg
```

| | [`RobotConfig`](../src/huphy/config/schema.py#L263) | [`Robot`](../src/huphy/robots/base.py#L54) |
|---|---|---|
| 무엇 | 야믈을 담은 읽기 전용 자료형 | 관절 이름으로 말하는 실행 객체 |
| 양다리 | 있음 (`limbs` 에 둘 다) | 구현체가 [`Leg`](../src/huphy/robots/leg.py#L101) 하나뿐 |
| 하는 일 | 없음. 데이터임 | 명령 계산·전송·수거 |

`robot` 이라는 변수는 `build_leg` 에 재료로 들어가고 끝임. 제어 루프 근처에
가지 않음.

### 1.2 조립 순서

`huphy-bringup`, `huphy-run`, `huphy-test`, `huphy-commission` 이 전부 같은
순서를 지남 ([bringup.py:584](../src/huphy/scripts/bringup.py#L584)).

```
1  _find_config()          config/robot.yaml 을 찾음
2  load_robot(path)        YAML -> RobotConfig                하드웨어 안 만짐
3  _pick_limb(robot, ...)  팔다리 하나를 고름                  <- 여기서 좁아짐
4  build_leg(robot, limb)  CanBus -> RobStrideBus -> Leg      객체만 생김
5  leg.connect()           CAN 채널을 엶                      <- 처음 하드웨어
6  ControlLoop(leg, ...)   주기·통계·기록을 맡김
```

2~4 는 통신을 하지 않음. 설정 오류(모르는 모델, 관절 이름 불일치, id 중복)는
전부 4 에서 걸리고, 5 에는 배선 문제만 남음.

캘리브레이션 파일은 4 에서 `Leg` 생성자가 읽음. 야믈에서 온 모터 정보와
JSON 의 `limits_deg` 가 합쳐지는 지점이 거기 한 군데임
([leg.py:206](../src/huphy/robots/leg.py#L206)).

### 1.3 각 계층이 맡은 것

```
scripts/     설정을 읽고 객체를 조립함
control/     주기를 지킴. 끝날 때 안전하게 정리함
robots/      관절 이름 <-> 모터 id, 관절각 <-> 모터각          <- 경계
motors/      모터 id 와 raw 각도. 각도 <-> 바이트
canbus.py    프레임 송수신
```

| 계층 | 아는 것 | 모르는 것 |
|---|---|---|
| `control/` | 시간, 주기 | 관절도 모터도 모름 |
| `robots/` | 관절 이름, cal 각도 | 프레임, 바이트 |
| `motors/` | 모터 id, raw 각도 | 관절 이름 |
| `canbus.py` | CAN id 와 8바이트 | 바이트의 뜻 |

제어 루프가 관절을 모르기 때문에, 루프를 고치지 않고도 다른 종류의 로봇을
넣을 수 있음. 이것이 아래 3장의 전제임.

### 1.4 `Leg` 가 하는 일

위에서 관절 목표를 받아 아래로 모터 명령을 냄. 네 가지가 **여기서만** 일어남.

```
입력   {"knee": 30.0, "ankle_pitch": 10.0}      관절 이름, cal 공간
  1  한계·점프 검사        cal 공간에서 먼저 함
  2  발목 pitch/roll -> a/b 각도    기구학
  3  관절 이름 -> 모터 id   robot.yaml 의 매핑
  4  cal -> raw            캘리브레이션의 sign/offset
출력   {10: MitCommand(62.79도, kp, kd)}         모터 id, raw 공간
```

**검사가 변환보다 먼저임.** 한계는 관절 좌표계에서 잰 값이라, 모터 각도로 바꾼
뒤 검사하면 부호가 뒤집힌 관절에서 한계가 반대로 걸림.

### 1.5 한 주기

`Leg` 는 이 일을 세 동작으로 나눠 가지고 있음
([base.py:140](../src/huphy/robots/base.py#L140)).

| | 하는 일 | CAN |
|---|---|---|
| `build_commands` | 위 네 가지 계산 | 안 씀 |
| `send` | 계산해 둔 명령 전송 | 씀 |
| `collect` | 응답 수거, 상태 갱신 | 씀 |

다리가 하나면 `send_action()` 이 셋을 순서대로 부르면 됨. 나눠 둔 이유는 2.2 에
있음.

---

## 2. 왜 이렇게 되어 있나

### 2.1 다리 하나로 시작했음

0.5 하드웨어가 다리 하나였음. 그 시점에 양다리 관리 계층을 만들었다면 실물로
검증한 적 없는 추상이 하나 늘 뿐임. 대신 **끼울 자리를 인터페이스로 남겨** 둠.

### 2.2 이미 깔려 있는 것

양다리를 전제하고 만들었으나 아직 쓰이지 않는 것들임.

| 무엇 | 어디 | 지금 |
|---|---|---|
| 계산·전송·수거 분리 | [base.py:140](../src/huphy/robots/base.py#L140) | `send_action` 이 셋을 묶어 씀 |
| 여러 버스 수거 (`drain_all`) | [canbus.py:303](../src/huphy/motors/canbus.py#L303) | 테스트만 씀 |
| 기록 필드에 팔다리 이름 | [snapshot.py:151](../src/huphy/telemetry/snapshot.py#L151) | `right_leg/knee/pos` 로 이미 나감 |
| 왼다리 발목 거울상 | [bringup.py:115](../src/huphy/scripts/bringup.py#L115) | `side` 로 갈림 |
| 채널 공유 시 id 충돌 검사 | [schema.py:293](../src/huphy/config/schema.py#L293) | 채널이 달라 안 걸림 |
| 팔다리 선택 도구 | [schema.py:319](../src/huphy/config/schema.py#L319) | 부르는 곳 없음 |

계산·전송·수거를 나눈 이유가 핵심임 ([이슈 #10](issues.md)). 다리마다
"계산 → 전송 → 수거" 를 돌리면 이렇게 됨.

```
왼다리   [계산][전송][---- 응답 대기 ----]
오른다리                                    [계산][전송][대기]
```

두 CAN 채널은 물리적으로 독립이라 실제로 겹쳐 보낼 수 있는데 그 병렬성을 못 씀.
두 다리의 명령 시각도 벌어짐. 나눠 두면 이 순서를 짤 수 있음.

```
왼다리 계산 -> 오른다리 계산 -> 왼다리 전송 -> 오른다리 전송 -> 수거
```

### 2.3 비어 있던 자리

오래 이랬음. 설정에는 로봇 전체를 뜻하는 마디가 있는데 실행에는 없어서, 다리가
그 자리에 그대로 앉아 있었음.

```
설정 계층                   실행 계층 (예전)
RobotConfig        ->       (없음)                <- 비어 있던 자리
 ├ limbs["right"]  ->         Leg("right_leg")    <- 루프의 뿌리가 여기였음
 ├ limbs["left"]   ->         (안 만들어짐)
 ├ safety          ->         Leg.safety
 ├ imus            ->         Imu (mount 로 다리에 들어감)
 └ telemetry       ->         Telemetry
```

`Robot` 계약이 이 자리를 미리 명시해 뒀음 —
"다리, 팔, 나중에는 **양다리를 묶은 것**도 이 계약을 채움"
([base.py:55](../src/huphy/robots/base.py#L55)).

지금은 `Biped` 가 그 자리에 들어가 있고, `safety` 와 `imus` 도 다리에서 한 층
위로 올라갔음. 3장이 그 그림임.

---

## 3. `Biped` — 로봇 전체

### 3.1 위치

`Leg` 를 대체하지 않음. 위에 얹혀 같은 `Robot` 계약을 채우고, 안에 `Leg` 둘과
IMU 를 둠.

```
ControlLoop
 └ robot -> Biped("huphy")
             ├ Leg("right_leg") -> RobStrideBus -> CanBus("can1")  + 수신 스레드
             ├ Leg("left_leg")  -> RobStrideBus -> CanBus("can0")  + 수신 스레드
             └ ImuGroup                                            <- 다리와 나란히
```

`ControlLoop` 도 `Leg` 도 `CanBus` 도 이 그림 때문에 고쳐지지 않았음. `Biped` 가
`Robot` 계약을 채우므로 루프는 이것이 다리 하나인지 양다리인지 모름.

### 3.2 맡는 것 셋

| | |
|---|---|
| 이름 구분 | `right_leg/knee`. 무릎이 둘이라 필요함 |
| 전송 순서 | 전부 계산 → 전부 전송 → 수거 |
| 반쪽 금지 | 연결·토크는 되돌리고, 종료·수거는 나머지를 마저 함 |

구분자가 `/` 인 이유: 관찰 필드가 이미 `knee.pos` 처럼 `.` 을 씀. 같은 문자를
쓰면 `right_leg.knee.pos` 에서 어디까지가 팔다리 이름인지 갈리지 않음.

전송 순서가 중요한 이유는 [이슈 #10](issues.md) 에 있음 — 다리마다
"계산→전송→수거" 를 붙여 하면 앞 다리가 응답을 기다리는 동안 뒤 다리는 보내지도
못해, 두 다리의 명령 시각이 벌어짐.

### 3.3 IMU 가 다리에서 떨어져 나옴

같은 센서가 다리에 붙었다가 몸통으로 옮겨감. 설정에서 `ImuConfig` 를 `limbs`
안이 아니라 로봇 밑에 둔 것이 그 이유였는데, 실행 객체에서 다리가 센서를 소유하고
있으면 옮길 때 소유자까지 바뀜.

`ImuGroup` 이 다리와 나란히 놓임 (`sensors/group.py`). 여는 데 실패해도 예외를
올리지 않음 — IMU 는 관측이지 제어가 아니라서, 센서 때문에 로봇을 못 움직이면
고장 났을 때 안전한 자세로 되돌리는 것조차 막힘.

`mount` 는 이제 **어디 붙었는지 적어 두는 메모**임. 값을 찾는 쪽은 개체 이름만
알면 됨 (`imu/main/gx`).

### 3.4 통신이 끊기면 양쪽이 같이 멈춤

연속 무응답이 이어지면 그 모터는 현재 위치를 모른 채 **마지막 명령을 유지하고
있음.** 다리 하나면 그 관절만 굳지만, 양다리면 한쪽만 움직여 넘어짐.

```
safety/link.py      끊겼는지 판정만 함
control/loop.py     그 결과로 자세를 붙잡고 토크를 끊음
```

나눈 이유: 정지는 순서가 있는 절차라 그 순서를 아는 곳에서 해야 함. 바로 끊으면
서 있는 다리가 주저앉음.

| | |
|---|---|
| 기준 | 연속 무응답 **주기 수**. 시간이 아님 — 루프가 밀려도 뜻이 같음 |
| 설정 | `SafetyConfig.link_loss_cycles` (기본 5, 100Hz 에서 50ms) |
| 범위 | 한 모터라도 걸리면 끊긴 것으로 봄 |
| 모드 | 제어 모드에서만. 관찰 모드는 토크가 없어 세울 것이 없음 |

정상 종료와 구분하려고 `LoopStats.link_loss` 에 남김. 둘 다 루프가 조용히 끝나서,
이 값이 없으면 "시간이 다 됐나" 와 "다리가 죽었나" 를 가를 수 없음.

### 3.5 수신은 버스마다 따로

`CanBus(channel, reader=True)`. 켜면 `recv` 를 기다리는 일이 제어 루프에서 빠지고,
`drain` 은 큐에서 꺼내기만 함.

```
끄면   can0 기다림 -> can1 기다림      총 대기가 버스 수만큼 곱해짐
켜면   두 채널이 동시에 받음            큐에서 꺼내기만
```

락 구성 — **수신 스레드는 송신 락을 잡지 않음.** 잡으면 `recv` 에서 블로킹하는
동안 송신이 밀려, 스레드를 둔 이유가 사라짐. 공유하는 것은 프레임 `deque` 뿐이고
`append`/`popleft` 가 원자적이라 락이 필요 없음. 닫을 때는 **스레드를 먼저 세우고**
채널을 닫음.

큐가 차면 오래된 것부터 버리고 `can.rx_dropped` 를 올림. 0 이 아니면 소비가 밀린
것이라 `loop_dt` 와 같이 볼 것.

### 3.6 기록

기록 단위가 로봇이 아니라 **팔다리**임.

```
right_leg/knee/pos          <- 다리 하나로 돌리던 때와 같은 이름
huphy/right_leg/knee/pos    <- 이렇게 깊어지지 않음
```

| | 왜 |
|---|---|
| CSV 한 줄 | 같은 시각의 두 다리를 나란히 봐야 함 |
| UDP 팔다리마다 한 패킷 | 다리 하나가 이미 1KB 가까움. 합치면 MTU 를 넘어 조각남 |
| IMU 는 한 번만 | 필드에 팔다리 이름이 안 붙음. 몸통·다리 센서가 한 줄에 |

---

## 4. 쓰는 법

```bash
huphy-test --robot zero                    # 로봇 전체를 0도로 두고 붙잡음
huphy-test --robot range --period 10       # 로봇 전체 가동 범위 왕복
huphy-test --limb right_leg zero           # 다리 하나
huphy-test --limb left_leg,right_leg zero  # 일부만 묶기 (드묾)
```

**플래그가 곧 만들어지는 객체임.**

| | 만들어지는 것 | 관절 이름 |
|---|---|---|
| `--limb right_leg` | `Leg` | `knee` |
| `--robot` | `Biped` | `right_leg/knee` |

`--limb` 은 예전부터 "팔다리가 여럿이라 헷갈리니 하나를 짚어라" 는 뜻임. 로봇
전체는 그것과 **다른 층의 선택**이라 플래그를 따로 둠. 둘을 같이 주면 거부함.

프로세스를 둘 띄우는 것과 다름 — 명령이 같은 주기에 나가고, 한쪽 통신이 끊기면
양쪽이 같이 멈춤.

주기는 팔다리 중 **가장 느린** `control_hz` 에 맞춤. 빠른 쪽에 맞추면 느린 쪽이
매 주기 밀림.

`bringup` 과 `commission` 은 팔다리 하나만 받는 그대로임. 사람이 한 다리를 손으로
만지는 절차라 묶을 이유가 없음.

조립을 코드로 하면:

```python
robot = load_robot("config/robot.yaml")
biped = build_biped(robot)          # kind: leg 인 팔다리 전부
loop = ControlLoop(biped, hz=100.0, mode=Mode.CONTROL)
```

---

## 5. 앞으로 해야 할 것

### 하드웨어 — 지금 막고 있는 것

- **양다리 실측** — `huphy-commission --limb <팔다리> zero` 후 `sweep`.
  1.0 캘리브레이션은 지금 **양쪽 다 비어 있음.** 값이 없으면 `is_configured` 가
  거짓이라 토크가 나가는 경로가 막힘
- **모터 매핑 확인** ([이슈 #8](issues.md)) — 명령한 관절이 실제로 움직이는지
- **왼다리 발목 기하 확인** ([이슈 #13](issues.md)) — 거울상은 실측이 아니라 가정임

### 코드 — 실물을 보고 정할 것

- **주기 예산 측정** — 12모터에서 목표 Hz 를 지키는지. 못 지키면 수신 스레드의
  폴링 간격부터 볼 것
- **`link_loss_cycles` 조정** — 기본 5 는 계산값이 아니라 출발점임. 실물에서
  정상 상태의 `miss` 분포를 보고 정할 것
- **게인 튜닝** ([이슈 #9](issues.md)) — RS04 는 0.5 의 RS02 보다 토크가 7배임

### 정책 — 다른 곳에서 진행 중

- **양다리 시뮬 모델과 재학습** — 지금 모델은 관절 6개, 관찰 24/26칸이고 시뮬
  파일이 `half_huphy.xml` 임
- **관찰을 모델 입력으로 옮기는 곳** — 양다리 12칸 순서는 학습 쪽과 정했음
  (왼다리 6 → 오른다리 6). `control/policy.py` 의 `BIPED_LEGS` / `BIPED_ORDERS`
- **`huphy-run` 의 양다리 경로** — 붙였음. `huphy-run --robot`. 관찰 42/44칸,
  출력 12칸을 가중치와 대조함. `action_scale` 은 `--policy` 규격을 그대로 씀
- **최종 실행기** — 설정 파일 하나로 인자 없이 도는 것.
  [policy_runner.md](policy_runner.md) 에 설계 검토

---

## 6. 예상 순서

| 단계 | 무엇 | 끝났다는 기준 |
|---|---|---|
| 1 | 양다리 배선·CAN 확인 | `commission scan` 에 모터 6개씩 다 뜸 |
| 2 | 양다리 실측 (`zero` → `sweep`) | 두 JSON 의 `limits_deg` 가 채워짐 |
| 3 | 다리별 단독 브링업 | 양쪽 다 `huphy-bringup` 으로 사인파가 돎 |
| 4 | 양다리 영자세 | `huphy-test --robot zero` 가 유지됨 |
| 5 | 주기 예산 측정 | 12모터에서 목표 Hz 를 지킴 |
| 6 | 양다리 시뮬 모델과 재학습 | 시뮬에서 서고 걷는 것을 확인 |
| 7 | 정책 실물 적용 | — |

**4 를 3 보다 먼저 하지 않을 것.** 다리 하나가 혼자 제대로 돌지 않는 상태에서
둘을 묶으면, 문제가 다리에 있는지 묶는 계층에 있는지 갈리지 않음.

1~3 은 하드웨어 작업이고 코드를 안 고침. 4~5 에서 이 문서의 코드가 처음 실물을
만남. 6~7 은 별개 프로젝트에 가까움.
