Human-Pygmalion/HUPHY/src/huphy/control/POLICY.md

# 정책 실행 — 지금까지 만든 것

> **2026-10-23 — 정책은 꾸러미 폴더 하나임.** `control/walk.py` 는
> 지워졌고, `control/deploy.py` 가 `config/policies/<이름>/deploy_contract.json` 을
> 읽어 어느 정책이든 같은 코드로 돌림. 0장이 지금 구조임.
>
> **지워짐 (2026-10-20).** 아래 2장~8장의 `balance`/`hopping`/`stand` 정책과
> `control/policy.py`의 `observation_vector`/`BALANCE`/`HOPPING`, `control/stand.py`
> 는 더 이상 없음. **역사적 참고용으로만** 남겨 둠 — 지금 `huphy-run --help`와 다름.

상태 기계와 토크 가드가 없어서 **사람이 지켜보며 돌려야 함.**

```
있음   계약 파일 -> 규격            src/huphy/control/deploy.py   load()
있음   관찰 -> 모델 입력 벡터        src/huphy/control/deploy.py   DeployPolicy.observation_vector()
있음   모델 출력 -> 관절 목표        src/huphy/control/deploy.py   DeployPolicy.joint_targets()
있음   .pt 파일 -> 부를 수 있는 함수  src/huphy/control/rsl_rl.py   load()
있음   실행 파일                     src/huphy/scripts/run.py      main()
없음   상태 기계
없음   토크 가드
```

---

## 0. 실행 (지금)

```bash
huphy-run --policy walk --cmd vx=0.5         # 걷기 (--policy 는 필수)
huphy-run --policy stair_slope --cmd vx=0.5     # 계단·경사 (앞으로만)
huphy-run --policy squat --cmd h_star=0.80    # 스쿼트
```

### 0.1 꾸러미

```
config/policies/
  walk/
    deploy_contract.json     이 저장소가 씀 (옛 walk.py 의 값 그대로)
    generalized_walk.pt      체크포인트 37400
    generalized_walk_49999.pt  체크포인트 49999 (기본)
  stair_slope/
    deploy_contract.json     학습 쪽 deploy.yaml 에서 옮겨 적음
    stairs_slopes12_99998.pt  체크포인트 99998. 49999 에서 이어 학습
  squat/
    deploy_contract.json     학습 쪽 export_deploy.py 가 만든 것 그대로
    policy_5000.pt (기본)  policy_4500.pt  policy_4000.pt
    README.md                학습 쪽 꾸러미 README (참고용)
```

새 정책은 폴더 하나를 넣으면 됨. 코드는 안 바뀜.

### 0.2 계약의 어느 값이 어디로 가나

`deploy.load(folder)` 가 계약을 읽어 `DeployPolicy` 를 만듦. 단위(rad -> 도)와 관절
이름(`R_crank_A_joint` -> `right_leg/ankle_a`, `deploy.robot_name`) 은 여기서 한 번
바뀜.

| 계약 필드 | `DeployPolicy` | 쓰는 곳 |
|---|---|---|
| `actions[].joint` (index 순) | `order` | 행동 순서. `joint_targets()` 가 이 순서로 이름을 붙임 |
| `actions[].offset_rad` | `default_pose_deg` | ① 목표 = 이것 + 배율 x 행동 ② 관찰 관절각의 기준점 ③ 시작 자세 (`run.py` 의 `approach`·`staged`) |
| `actions[].scale_rad_per_unit` | `scale` | `joint_targets()` |
| `actions[].clip_rad` | `limits_deg` | `joint_targets()` 가 목표를 자름 |
| `observations[]` | `terms` | `observation_vector()` 가 이 순서로 `OBSERVATIONS[func]` 을 불러 이어 붙임 |
| `observations[].history_frames` | `Term.history` | `motor_encoder_rel` 의 프레임 수. `Runner.history` 가 쌓음 |
| `h_star` (`height_command` 일 때) | `commands["h_star"]` | 범위·시작값. 속도 제한 0.1 m/s (`H_STAR_MAX_RATE`) |
| `observations[].components` (`velocity_command`) | `commands["vx"]` 등 | 시작값 0 |
| `observations[].ranges` (`velocity_command`) | `commands[이름].range` | ① `--cmd` 가 범위 밖이면 시작 전에 멈춤 ② `_command` 가 관찰에 넣기 전에 자름 ③ `teleop.make_axes` 가 상한을 맞추고, **범위가 한 점이면 축을 안 만듦** |
| `control_rate_hz` | `hz` | 정책 주기. `held()` 의 안쪽 주기 |
| `checkpoints.<번호>.pt` / `pt_sha256` / `golden` | `checkpoints` | `load_model()` 의 검사 |

### 0.3 관찰 항목 표 (`deploy.OBSERVATIONS`)

| `func` | 칸 | 계산 (`deploy.py`) |
|---|---|---|
| `imu_gyro` | 3 | `_gyro` — `ImuState.gyro_dps` 를 rad/s 로 |
| `imu_gravity` | 3 | `_gravity` — `ImuState.gravity` 그대로 |
| `motor_encoder_rel` | 관절 x 프레임 | `_encoder_rel` — (관절각 − 기본자세) rad, 오래된 프레임이 앞. 첫 주기는 지금 값으로 메움 |
| `last_action` | 12 | `_last_action` — 직전 모델 출력, 자르기 전 |
| `height_command` | 1 | `_command` — `h_star`, 범위로 자름 |
| `velocity_command` | `components` 수 | `_command` — `vx`, `wz` 등 |

모르는 `func` 이 계약에 있으면 `load()` 가 `ContractError` 로 멈춤 (0 으로 채우지 않음).

### 0.4 모터를 켜기 전 검사 (`DeployPolicy.load_model`)

```
1  .pt 가 있음
2  sha256 == 계약의 pt_sha256          다른 꾸러미의 가중치를 섞으면 여기서 걸림
3  rsl_rl.load: 입력 == obs_dim, 출력 == action_dim
4  golden 이 있으면 그 입력을 넣어 학습 쪽 출력과 1e-4 안 (GOLDEN_TOL)
```

`run.py` 는 여기에 더해 `--cmd` 이름·범위(`_parse_commands`), `--hz` 배수, 다리
이름을 CAN 을 열기 전에 봄.

### 0.5 한 주기 (`Runner.step`)

```
observation(도) ─┐
IMU(ImuState)  ──┼─> history 에 지금 관절각 추가 (history_frames 개만 남김)
명령           ──┘   commands.step(1/hz)        h_star 는 0.1 m/s 로 목표에 다가감
                     observation_vector(Frame)  계약 순서대로 이어 붙임 (rad)
                     model(vector)              rsl_rl: 정규화 + MLP
                     last_action = 출력          다음 주기 관찰로
                     joint_targets(출력)         기본자세 + 배율 x 행동, 자름, 도
```

명령 목표는 도는 중에 바뀔 수 있음. `huphy-run --teleop` 이면 `Commands.source` 가
`teleop.Teleop.targets` 이고, `Commands.step` 이 매 정책 주기 그 값을 목표로 넣음.
pygame 은 별도 프로세스(`teleop._process`)에서 `TeleopState.update` 로 누름/뗌을
적분·감속·상한 처리해 공유 메모리에 씀 -- [`teleop.py`](teleop.py) 모듈 설명.

`huphy-run` 은 `DeployPolicy.motion()` 으로 이것을 `Motion` 으로 감싸고, ROS
`policy_node` 는 `Runner` 를 직접 들고 토픽 값을 `runner.commands.set()` 으로 넣음.

## 0-구. 실행 (옛 버전, 지워짐)

```bash
huphy-run --limb right_leg --policy balance
huphy-run --robot --policy stand --ankle-space ab --weights config/policies/stand_bi.pt
```

그 이름이 규격(입력 개수, `action_scale`)과 **관찰을 만드는 코드**를 고름. 가중치는
`config/policies/<이름>.pt` 를 씀. 다른 파일은 `--weights` 로.

| `--policy` | 입력 | 출력 | 규격 | 관찰을 만드는 곳 |
|---|---|---|---|---|
| `balance` | 24 | 6 | `policy.BALANCE` | `policy.observation_vector` |
| `hopping` | 26 | 6 | `policy.HOPPING` | 같음 (위상 2칸 더) |
| `stand` | 45 | 12 | `stand.SPEC` | `stand.observation_vector` |

**`stand` 는 2장의 구성과 다름** -- 8장 참조.

| 옵션 | 기본값 | 무엇 |
|---|---|---|
| `--policy` | 없으면 오류 | `balance` / `hopping` / `stand` |
| `--weights` | `config/policies/<정책>.pt` | 더 학습한 모델을 시험할 때 |
| `--robot` / `--limb` | — | 양다리 모델(12칸)이면 `--robot`, 한다리면 `--limb <이름>` |
| `--ankle-space` | `rp` | 발목을 무엇으로 내는지. `rp` 발판 자세 / `ab` 모터각. `stand` 는 `ab` 고정 |
| `--ankle-output` | `position` | 발목에 각도 / 토크. `torque` 는 `rp` 에서만 |
| `--hz` | `50` | 모터 **전송** 주기. 50 의 정수 배만. 정책은 늘 50Hz 로 불리고 사이 주기는 직전 목표를 다시 보냄. slcan 이면 50 |
| `--drain-ms` | `2` | 응답을 기다리는 최대 시간. slcan 이면 4 |
| `--gain-scale A [B]` | `1.0` | kp/kd 배율. 하나면 전체, 둘이면 나머지 A · 발목 B. 0 초과 1 이하 |
| `--log [DIR]` | 끔 (`logs/`) | 정책 입출력과 관절별 응답 지연을 JSON 으로 남김 -- [`tools/README.md`](../../../tools/README.md) |
| `--approach` | `3` | 시작 자세까지 옮기는 시간(초) |
| `--duration` | 없음 | 이 초만큼만. 생략하면 Ctrl-Q 까지 |

### 0.1 바로 움직이지 않음

지금 자세에서 정책 목표로 한 번에 뛰면 관절이 튐. 세 단계를 거침.

```
1  3초에 걸쳐 영점 자세(관절 전부 0)로 천천히 옮김
2  그 자세로 유지하며 Enter 를 기다림          <- 사람이 손을 떼고 자리를 잡는 시간
3  Enter 누르면 정책 시작
```

영점 자세로 가는 이유는 정책이 그 자세를 기준으로 학습했기 때문임. 관찰의 관절
각도가 그 자세 기준의 상대값이라, 다른 자세에서 시작하면 학습 때 본 적 없는 입력이
들어감.

화면이 아니면(파이프, 서비스) Enter 없이 바로 시작함.

**아직 실물에서 돌리면 안 됨** -- 넘어져도 멈추지 않고(5.5), 발목 토크에 한계 검사가
없음(5.4).

### 0.2 실행하면 무슨 일이 일어나나

```
1  설정 읽기          config/robot.yaml -> 모터 id, 게인, IMU
2  다리 만들기        모터 표 + 캘리브레이션(한계각·오프셋) + 발목 기구학
3  CAN 열기           채널이 안 올라와 있으면 여기서 멈춤
4  IMU 열기           실패해도 계속 감 (다리는 씀)
5  가중치 읽기        입력 개수가 정책 이름과 다르면 여기서 멈춤
6  루프 시작          토크를 넣음
7  매 주기 (50Hz)     관찰 -> 모델 -> 관절 목표 -> 모터
8  끝날 때            자세를 붙잡은 뒤 토크 차단
```

7번 한 주기의 안은 1절에 있음.

8번은 `control/loop.py` 가 `finally` 로 함. Ctrl-C 로 끊든 예외로 끝나든 같은 순서를
탐.

### 0.3 실행 구조

무엇이 무엇을 부르는지.

```
scripts/run.py
   │  조립만 함
   ├─ config/loader.py        robot.yaml 읽기
   ├─ scripts/bringup.py      build_leg -- 다리 조립. 브링업과 같은 함수를 씀
   ├─ control/rsl_rl.py       .pt -> 모델 함수
   ├─ control/policy.py       모델 함수 -> Motion
   └─ control/loop.py         run(Motion)
                                 │  매 주기
                                 ├─ robots/leg.py      관찰, 명령 만들기, 전송
                                 │    ├─ kinematics/ankle.py   발목 IK/FK/토크
                                 │    ├─ safety/guards.py      한계·점프 검사
                                 │    └─ motors/robstride/     프레임 만들기
                                 └─ telemetry/                 기록
```

브링업이 쓰는 것과 **같은 루프·같은 다리**임. 다르게 들어가는 것은 `Motion` 하나뿐임
— 브링업은 사인파 같은 것을 넣고, 여기는 정책을 넣음.

---

## 1. 한 주기에 무슨 일이 일어나나

```
모터에서 각도·속도를 읽음 (도, 도/초)        robots/leg.py 의 get_observation
IMU 에서 각속도·중력방향을 읽음                sensors/ebimu/imu.py
   ↓
숫자 24개(또는 26개)로 늘어놓음. 라디안으로 바꿈    control/policy.py
   ↓
(입력 - mean) / std 로 정규화                 control/rsl_rl.py
   ↓
완전연결 4층 + ELU                            control/rsl_rl.py
   ↓
숫자 6개. 단위 없음
   ↓
× action_scale -> 라디안 -> 도                control/policy.py
   ↓
관절 목표 6개
   ↓
모터 7~10 은 각도 그대로, 11·12 는 기구학을 거쳐 각도나 토크로   robots/leg.py
   ↓
CAN 프레임
```

정책이 50Hz 로 학습됐으므로 제어 루프도 50Hz 로 돌리는 것이 맞음.

---

## 2. 관찰 24개 / 26개의 구성 — `balance` / `hopping`

학습 쪽(mjlab)이 이 순서로 이어 붙임. 가중치 파일의 입력 차원과 맞음.

| | 개수 | 무엇 |
|---|---|---|
| `base_ang_vel` | 3 | IMU 각속도 (rad/s) |
| `projected_gravity` | 3 | 중력 방향을 몸체 좌표로. 수평이면 `(0,0,-1)`. **IMU 모듈이 만들어 올림** |
| `joint_pos` | 6 | 관절 각도 (rad) |
| `joint_vel` | 6 | 관절 각속도 (rad/s) |
| `actions` | 6 | **직전 주기에 모델이 낸 값 그대로.** 배율 곱하기 전 |
| `hop_phase` | 2 | `sin`/`cos`. hopping 에만 |

```
balance  24        hopping  26
```

관절 순서는 CAN id 7 → 12 임. 모델은 이름을 모르고 순서만 봄.

```
hip_pitch(7)  hip_roll(8)  hip_yaw(9)  knee(10)  ankle_pitch  ankle_roll
                                                  └── 모터 11·12 가 함께 만듦
```

---

## 3. 행동을 관절 목표로

```
관절 목표(rad) = 기본자세 + action_scale × 모델출력
```

기본 자세가 전부 0 이라 두 번째 항만 남음.

| | `action_scale` | 출력 1.0 이면 |
|---|---|---|
| balance | 0.25 | 14.3도 |
| hopping | 0.5 | 28.6도 |

**이 값은 `.pt` 안에 없음.** 학습 설정에만 있어서 코드에 적어 뒀음
(`src/huphy/control/policy.py` 의 `BALANCE` / `HOPPING`). 틀리면 로봇이 두 배로
움직이는데 에러는 안 남.

`stand` 는 기본 자세가 0 이 아니라 첫 번째 항이 남고, 그 뒤 관절마다 자름 (8장).

---

## 4. 체크포인트를 numpy 로 읽음

`.pt` 는 zip 이고 안에 pickle 하나와 float32 원본이 들어 있음. torch 없이 읽음 —
신경망이 4층이라 곱셈 5만 번이면 끝나고, 제어 루프가 도는 파이에 200MB 짜리를 넣을
이유가 없음.

꺼내는 것:

```
mlp.0 / mlp.2 / mlp.4 / mlp.6      완전연결 4층. 사이에 ELU
obs_normalizer._mean / ._std       학습 중에 쌓인 통계
```

층 크기는 파일에서 읽으므로 학습 쪽에서 층을 바꿔도 따라감.

`distribution.std_param` 은 학습 때 탐색용이라 안 씀. `critic_state_dict` 도 안 씀.

가중치는 `config/policies/balance.pt`, `hopping.pt` 에 있고 테스트가 그 파일을 직접
읽음.

---

## 5. 제한사항

### 5.1 torch 와 대조하지 않았음

numpy 로 다시 짠 계산이 torch 와 같은 값을 내는지 **확인 못 했음.** 이 환경에
torch 가 없음.

확인 방법: 학습하는 쪽(torch 있는 곳)에서 같은 입력을 넣어 나온 출력을 뽑아 주면,
그 값과 맞는지 테스트로 고정할 수 있음. 한 번만 하면 됨.

### 5.2 실물에서 아무것도 확인 안 됨

아래는 전부 "설계대로 조립됐다" 는 전제 위에 있음.

- 모터의 + 방향이 시뮬과 같은지
- 실물 영점 자세가 시뮬의 기준 자세(관절 전부 0)와 같은지
- IMU 를 붙인 방향
- 관절 한계가 시뮬 범위와 맞는지 (시뮬 `knee` 는 0~115도)

### 5.3 IMU 좌표

IMU 를 시뮬 프레임에 맞춰 붙였다고 들었음. 그래서 정책에 넣을 때 좌표 변환을 하지
않음.

다만 브링업 화면과 텔레메트리에 나오는 `roll`/`pitch` 는 **IMU 프레임 기준**이라,
로봇 기준으로 읽으면 둘이 바뀌어 보임. 표시용 변환은 아직 없음.

### 5.4 발목 토크에 가드가 없음

발목을 토크로 보낼 때 한계 검사가 안 걸림. `safety/guards.py` 는 목표 각도를 받아
자르는데 토크 명령에는 넘길 각도가 없음.

### 5.5 정책이 늦거나 멈추면

아무 대비가 없음. 모델이 `None` 이나 NaN 을 내면 그대로 나가고, 모델 호출이 안
돌아오면 제어 루프도 같이 멈춤.

### 5.6 `hop_period_s` 는 임의값

hopping 의 뛰는 주기를 0.6초로 적어 뒀는데 **근거가 없음.** 학습 쪽 커리큘럼에서
stance/flight 시간이 바뀌므로 최종 값을 받아야 함.

---

## 6. 상태 기계를 붙일 때 바꿔야 하는 것

상태 기계는 "지금 무엇을 돌릴지" 를 고르는 것임. 지금 구조로 안 되는 게 셋임.

### 6.1 게인을 실행 중에 못 바꿈

지금은 `config/robot.yaml` 의 `kp`/`kd` 를 읽어 `Motor.gains` 에 넣고, 그 값이 그대로
프레임에 실림. `Motor` 가 frozen 이라 만든 뒤에는 못 고침.

상태마다 게인이 달라야 함.

```
힘 빼고 대기    kp = 0       다리가 손에 딸려 움직여야 함
자세 잡기       kp = 30      버텨야 함
정책            kp = 20, kd = 0.502    학습에 쓴 값
```

**바꿀 곳**: `robots/leg.py` 가 게인 사본을 들고, 프레임을 만들 때 설정 대신 그
사본을 보게 함. 설정은 원래 값으로 남겨 둠.

### 6.2 발목 출력 모드를 실행 중에 못 바꿈

`robots/leg.py` 의 `ankle_output` 이 생성자에서 정해짐. 대기 상태에서는 토크가 필요
없고 정책에서는 필요한데 오갈 수 없음.

실행할 때 고르는 것은 됨 (`huphy-run --ankle-output`, 기본 `position`). **한 실행
안에서** 못 바꾸는 것만 남음.

**바꿀 곳**: 값 검사를 생성자 밖으로 빼서 실행 중에도 바꿀 수 있게.

### 6.3 정책이 든 "직전 행동" 을 되돌릴 수 없음

정책은 자기가 직전에 낸 값 6개를 다음 주기 입력으로 받음. `control/policy.py` 가 그
값을 함수 안에 들고 있는데 **밖에서 0으로 되돌릴 방법이 없음.**

정책 상태를 나갔다 다시 들어오면 예전 값이 남아 있어서, 시뮬에서 에피소드가 새로
시작할 때와 다른 상태로 시작함.

**바꿀 곳**: `policy_motion` 이 되돌리는 방법을 같이 내거나 작은 클래스로 바꿈.

### 6.4 상태별 경과 시간은 이미 됨

`hop_phase` 가 `t` 를 받아 계산하므로, 상태 기계가 "그 상태가 시작한 뒤로 흐른 시간"
을 넘기면 뛰는 위상이 상태 진입 시점부터 셈. `motions.chain` 이 이미 같은 방식임.

---

## 7. 다음에 할 것

```
1. torch 와 대조값 받기    5.1
2. 실물 확인              5.2
3. 토크 가드              5.4
4. 상태 기계              6.1~6.3 을 같이 손봄
```

---

## 8. `stand` — 1.0 서기 정책

`legonly_ab_v9_caps`. 2장~4장이 `balance`/`hopping` 기준이고, 이 정책은 **관찰
레이아웃이 겹치지 않아** `src/huphy/control/stand.py` 에 따로 있음.

```bash
huphy-run --robot --policy stand --ankle-space ab --weights config/policies/stand_bi.pt
```

`--robot --ankle-space ab --ankle-output position` 고정임. 다른 조합은 CAN 을 열기
전에 거부함.

### 8.1 관찰 45칸

| 칸 | 무엇 | 단위 |
|---|---|---|
| 0–2 | 각속도 | rad/s |
| 3–5 | 중력방향. 서 있으면 z 가 −1 | 단위벡터 |
| 6–17 | `q(t-1) − 기본자세` | rad |
| 18–29 | `q(t) − 기본자세` | rad |
| 30–41 | 직전 행동. 배율·기본자세를 입히기 전 날것 | — |
| 42–44 | 속도 명령 `(vx, vy, wz)`. 서기는 전부 0 | m/s, rad/s |

**관절 속도가 없음.** 대신 위치를 두 프레임 받아 모델이 스스로 추정함.

이력은 `[q(t-1) 전체 12][q(t) 전체 12]` 로 **오래된 것이 먼저**이고 관절별로 묶이지
않음. 첫 주기는 지금 위치로 앞을 메움 (학습 쪽 순환버퍼와 같음).

### 8.2 관절 순서 — 오른다리가 먼저

```
0-5    right_leg/hip_pitch  hip_roll  hip_yaw  knee  ankle_a  ankle_b
6-11   left_leg/hip_pitch   hip_roll  hip_yaw  knee  ankle_a  ankle_b
```

0.5 양다리(`policy.BIPED_LEGS`)는 **왼다리가 먼저**임. 서로 다른 학습에서 나온
규격이라 같은 상수를 공유하지 않음.

발목은 크랭크 두 개를 직접 냄. `Leg` 이 이름을 보고 기구학을 건너뜀.

### 8.3 기본 자세가 0 이 아님

살짝 웅크린 자세임 — 엉덩이 10도, 무릎 20도, 크랭크 8.3도. 왼쪽과 오른쪽의 부호가
반대이고 뒤집으면 로봇이 뒤로 감.

**세 곳에 같이 걸림.**

```
관찰   q - 기본자세 를 넣음            stand.observation_vector
행동   기본자세 + 0.25 x 행동          stand.joint_targets, 그 뒤 관절마다 자름
시작   기본자세로 데려다 놓음           run.py
```

0 에서 시작하면 정책이 켜지는 순간 무릎 20도를 한 번에 메우려 함.

자르는 범위(`stand.LIMITS_DEG`)는 **학습 모형의 범위**이지 실물 한계가 아님. 실물
한계는 캘리브레이션의 `limits_deg` 이고 `safety/guards.py` 가 따로 봄 — 둘 중 좁은
쪽이 걸림.

### 8.4 확인한 것

학습 쪽 배포 꾸러미가 참조 입출력 16쌍을 같이 줌.

| | 결과 |
|---|---|
| 모델 (`policy.pt`) | 최대차 4.554e−07 (허용 1e−4) |
| 명세 ↔ 상수 (순서·기본자세·한계·배율·`obs_dim`·Hz) | 전부 일치 |
| 관찰 빌더 왕복 (0–41칸) | 최대차 0.0 |

**이 대조가 정규화 오류를 잡았음** — `(v−mean)/std` 가 2.5e−01 어긋났고
`(v−mean)/(std+1e-2)` 가 맞았음. 5.1 의 "torch 와 대조값 받기" 가 이것으로 일부
해결됨. 절차는 `docs/policy_runner.md` 13.3.

### 8.5 아직 안 된 것

| | |
|---|---|
| 가중치 파일 | `config/policies/stand_bi.pt` 가 참조 입출력과 7.3 어긋남. 꾸러미의 `policy.pt` 가 맞는 파일임 |
| 캘리브레이션 | 12모터 전부 `limits_deg: null` 이라 제어 진입이 막힘 |
| IMU 부착 | `robot.yaml` 의 `mount: right_leg` 가 실제 위치와 맞는지. 몸통이면 `torso`. 축 방향은 `huphy-imu check` |
| 0.5 모델 | 정규화 식이 바뀌었으므로 `balance`/`hopping` 을 실물에서 다시 확인해야 함 |
