Human-Pygmalion/HUPHY/src/huphy/motors/robstride/README.md

# `robstride/` — RobStride 드라이버

```
robstride/
├── tables.py         벤더 사양 (데이터시트에서 오는 값)
├── codec/
│   └── mit.py        MIT 표준 프레임 인코딩/디코딩
├── bus.py            런타임 조작
└── commissioning.py  조립할 때 한 번 하는 조작
```

`tables` 와 `codec` 은 순수 계산임. `python-can` 없이 import되고 테스트됨.
`bus` 와 `commissioning` 은 전송 계층을 쓰므로 `__init__.py` 에서 내보내지 않음 —
이 패키지를 import하는 것만으로 `python-can` 이 필요해지지 않게 함.

```python
from huphy.motors.robstride import tables                      # python-can 불필요
from huphy.motors.robstride.bus import RobStrideBus            # 여기서만 필요
from huphy.motors.robstride import commissioning
```

출처: RS02 User Manual (Seeed Studio 배포판 251112). 각 값의 페이지를 주석에 명시함.

---

## `tables.py`

실측이 아님. 모터를 바꾸지 않는 한 변하지 않음.
실측값(sign/offset/limits/gains)은 `calibration/` 으로 감.

### 프로토콜과 제어 모드는 다른 축임

이름이 겹쳐 헷갈리기 쉬움.

| | `Protocol` | `ControlMode` |
|---|---|---|
| 정하는 것 | **프레임 포맷** | **무엇을 명령할지** |
| 값 | 11-bit 표준 / 29-bit 확장 | 5개 파라미터 / 목표위치 / 목표속도 |
| 전환 | Command 8 → **전원 재투입** | Command 6 → 즉시 |

**서로 독립임.** MIT 프로토콜을 쓰면서 Position 모드를 쓸 수도 있음.

> `Protocol.MIT`은 "11-bit 표준 프레임을 쓴다",
> `ControlMode.MIT`은 "5개 파라미터를 보낸다" — 같은 이름이지만 뜻이 다름.
> 매뉴얼도 후자를 "MIT mode", "Motion Control Mode", "operation control mode"로
> 혼용함.

모드마다 보내는 명령이 다름.

| 모드 | 명령 | 보내는 것 |
|---|---|---|
| `MIT` (전원 투입 기본값) | Command 3 | 위치 · 속도 · kp · kd · 토크 **5개** |
| `POSITION` | Command 10 | 목표 위치 + 속도 제한 |
| `VELOCITY` | Command 11 | 목표 속도 + 전류 제한 |

**본 프로젝트는 MIT 모드를 사용함.** 궤적을 직접 만들고 게인을 매 프레임 실어
보내야 하기 때문임.

### 인코딩 범위는 `[프로토콜][모델]`

같은 RS02라도 프로토콜에 따라 속도 범위가 다름.

| 조합 | 위치 | 속도 | 토크 | 출처 |
|---|---|---|---|---|
| RS02 / **MIT** | ±12.57 rad | **±44 rad/s** | ±17 N·m | 6.5 |
| RS02 / private | ±12.57 rad | **±44 rad/s** | ±17 N·m | p.20~21 |
| RS00 / MIT | ±12.57 rad | ±33 rad/s | ±14 N·m | 6.5 |

`260713` 판본에서는 두 프로토콜의 범위가 같음. 예전 판본은 MIT 을 ±33으로 잘라
쓰는 것으로 보임.

**현재 MIT만 사용하지만 `PRIVATE_ENCODING`도 표에 남김.** 두 범위가 다르다는 사실
자체가 중요하며, 이 축이 없으면 private 값을 MIT에 가져다 쓰는 실수가 남.

```python
encoding_for(Model.RS02)                      # 기본 인자가 MIT
encoding_for(Model.RS02, Protocol.PRIVATE)
encoding_for(Model.RS00, Protocol.PRIVATE)    # KeyError
```

**없는 조합에 `KeyError`를 던짐.** 조용히 기본값으로 때우지 않음 — 범위가 틀리면
명령한 값과 실제가 배율만큼 어긋나는데, 실물에서 찾기 매우 어려움.

> `pmax = 12.57 rad`은 4π를 반올림한 값임 (= ±720°).

### 명령 바이트의 F_CMD 규약

```
data[0:6] = 0xFF    data[6] = F_CMD    data[7] = 명령 바이트
```

`F_CMD`가 `0xFF`면 기본 동작, 다른 값이면 변형 동작임.

| `data[7]` | `F_CMD = 0xFF` | `F_CMD = 그 외` |
|---|---|---|
| `0xFC` | Enable | 제어 모드 설정 (값 = 모드) |
| `0xFD` | Stop | 프로토콜 전환 (값 = 프로토콜) |
| `0xFB` | 고장 클리어 | 고장값 조회 |

**같은 바이트가 두 명령을 겸함.** 그래서 상수 이름을 나눠 뒀음.

```python
CMD_ENABLE = 0xFC        # F_CMD = 0xFF
CMD_SET_MODE = 0xFC      # F_CMD = ControlMode
```

> 주석의 "Command N"은 **매뉴얼 목차 번호**임. CAN에는 이 숫자가 들어가지 않음.
> 나중에 "이 `0xFC`가 뭐지?" 할 때 매뉴얼에서 바로 찾으라는 표시임.
> private 프로토콜은 같은 것을 "Communication Type N"이라 부름 — 번호 체계가 다름.

### 11비트 ID 형식이 두 가지임

지금까지 쓰는 명령은 **11비트 ID 가 통째로 모터 CAN ID** 임 (`00A` = 모터 10).
그런데 매뉴얼 6.13~6.18절의 명령들은 **상위 3비트에 선택자**를 실음.

```
11-bit ID = (선택자 << 8) | 모터 CAN ID

선택자 0   지금 쓰는 명령 전부 (Enable/Stop/영점/고장/모드/ID/프로토콜/저장/능동보고)
       1   Command 10  위치 모드 제어
       2   Command 11  속도 모드 제어
       3   Command 14  파라미터 읽기
       4   Command 15  파라미터 쓰기
```

모터 CAN ID 가 1~127 이라 하위 8비트에 들어가므로 선택자와 겹치지 않음.

`_command_frame` 은 `can_id = motor_id` 만 만들어서 **선택자 명령을 못 보냄.**
전부 미구현임. 상수만 `SEL_*` 로 적어 둠.

### 파라미터 인덱스

하드웨어 전제를 확인하는 데 쓰는 것만 둠. 나머지는 필요해질 때 매뉴얼에서 추가함.

| 상수 | 인덱스 | 용도 |
|---|---|---|
| `PARAM_PROTOCOL_FLAG` | `0x201F` | 현재 프로토콜 확인 |
| `PARAM_ZERO_STA` | `0x7029` | 위치 보고 범위 확인 (`0`=`[0,360)`, `1`=`[-180,180)`) |

인덱스도 값도 **작은 자리 먼저** 임 (상태 프레임과 반대 — `codec/mit.py` 참조).

**MIT 모드에서 파라미터를 못 만지는 것이 아님.** 읽고 쓰는 경로가 둘 있고 표는 같음.

| | 읽기 | 쓰기 (RAM) | 플래시 저장 |
|---|---|---|---|
| private | Type 17 | Type 18 | Type 22 |
| MIT | Command 14 (`SEL_PARAM_READ`) | Command 15 (`SEL_PARAM_WRITE`) | Command 12 (`CMD_SAVE`) |

둘 다 미구현임. 지금은 사람이 [`docs/motor_setup.md`](../../../../docs/motor_setup.md)
절차대로 private 에서 `cansend` 로 함. MIT 쪽은 펌웨어 요구사항이 있음
(RS00 `0.0.3.27` / RS02 `0.2.3.32` 이상).

MIT 파라미터 응답의 11비트 ID 는 `(3 << 8) | 모터ID` 라서 **상태 프레임(`0FD`)과
CAN ID 로 구분됨.** 고장 응답이 안 갈리는 문제가 여기엔 없음.

---

## `codec/mit.py`

로봇을 전혀 모름. 관절 이름도 모터 배치도 없고 숫자와 바이트만 다룸.
인코딩 범위를 **인자로 받으므로** 모델·프로토콜에 묶이지 않음.

### 왜 양자화하나

CAN 2.0 프레임은 데이터가 **8바이트뿐**임. 실수 5개에 부동소수(4바이트씩 20바이트)를
쓸 수 없음.

```
uint = (값 + max) / (2*max) * (2**bits - 1)
해상도 = 2*max / (2**bits - 1)
```

위치에 16비트를 몰아주고 나머지를 12비트로 깎아 8바이트에 맞춤.

```
16 + 12 + 12 + 12 + 12 = 64bit = 8byte    ← 정확히 맞음
```

| 값 | 비트 | 해상도 (RS02) |
|---|---|---|
| 위치 | 16 | **0.0220°** |
| 속도 | 12 | 0.016 rad/s |
| 토크 | 12 | **0.0083 N·m** |
| Kp | 12 | 0.12 |
| Kd | 12 | 0.0012 |

### 프레임 배치

**명령** — Command 3 (p.38). 11-bit 표준 ID = 대상 모터 CAN ID

```
Byte0~1               목표각    16bit
Byte2 + Byte3[7:4]    목표속도  12bit
Byte3[3:0] + Byte4    Kp        12bit
Byte5 + Byte6[7:4]    Kd        12bit
Byte6[3:0] + Byte7    목표토크  12bit
```

**응답** — Response Command 1 (매뉴얼 6.1절)

```
Byte0                 모터 CAN ID
Byte1~2               현재각    16bit
Byte3 + Byte4[7:4]    현재속도  12bit
Byte4[3:0] + Byte5    현재토크  12bit
Byte6[7:6]            동작 모드  0 Reset / 1 Cali / 2 Motor
Byte6[5]              고장 있음
Byte6[4]              경고 있음
Byte6[3:0] + Byte7    권선 온도  12bit (0.1° 단위)
```

**명령과 응답의 배치가 다름** — 응답은 앞에 모터 ID가 붙어 한 칸씩 밀림.

**온도는 12비트임 ⚠️** Byte6 상위 4비트는 온도가 아님. 16비트로 읽으면 토크를
켠 순간(Motor 모드 → `Byte6[7]=1`) 3300°C 가 나옴. 토크가 꺼져 있을 땐 맞게 나와서
벤치에서는 안 보임. private 프로토콜에서는 이 플래그들이 29비트 CAN ID 안에 있어
`Byte6~7` 이 온전한 16비트 온도인데, MIT 은 11비트 ID 라 자리가 없어 내려왔음.

### 함수

| 함수 | 반환 |
|---|---|
| `float_to_uint(x, min, max, bits)` | 양자화된 정수 |
| `uint_to_float(x, min, max, bits)` | 역변환 |
| `pack_command(...)` | 명령 8바이트 |
| `decode_state(data, enc)` | `(id, pos_deg, vel_deg_s, tau_nm, temp_c)` |
| `decode_flags(data)` | `StatusFlags(mode, fault, warning)` |
| `decode_fault(data)` | `(id, fault_word)`. `0`이면 정상 |

`decode_flags` 는 인코딩 범위를 안 받음 — 플래그는 양자화된 값이 아니라 생비트라
범위표가 틀려도 맞음. 그래서 `decode_state` 와 나눠 뒀음.

### 클램프 특성 ⚠️

`float_to_uint`는 범위를 벗어나면 **잘림** (감싸지 않음).

```python
float_to_uint(999.0, -10.0, 10.0, 12)   # 4095 = 최대값
```

따라서 **전송 전에 범위 확인이 필요함** — 넘으면 조용히 최대/최소값이 나감.

그리고 **NaN은 이 클램프를 통과함.**

```python
min(10, nan)                             # 10      ← 비교가 False라 통과
float_to_uint(nan, -12.57, 12.57, 16)    # 65535 = 720°
```

**NaN 하나가 720° 목표 명령이 됨.** `safety.guards`가 미리 걸러야 함.

### 단위

내부는 rad, 외부는 deg. 변환이 **이 파일에서만** 일어나도록 경계에 가둠.
나머지 코드는 라디안을 신경 쓰지 않아도 됨.

### 고장값은 작은 자리 먼저

```
Byte0     모터 CAN ID
Byte1~4   고장값 32bit, 작은 자리 먼저 -- Byte1 이 최하위
```

**상태 프레임과 반대임.** 이 제조사는 프레임 종류마다 순서가 다름.

| | 순서 | 왜 |
|---|---|---|
| 제어 명령 · 상태 피드백 | 큰 자리 먼저 | 12비트 값이 바이트 경계를 넘나들어 손으로 조립한 것 |
| 파라미터 · 고장값 | **작은 자리 먼저** | MCU(ARM) 메모리의 32비트 값을 그대로 복사한 것 |

매뉴얼 6.8절 표에는 순서가 안 적혀 있지만 6.7절이 **"에러 코드는 응답의 BYTE1
자리로 돌아온다"** 고 함 — Byte1 이 최하위 바이트라는 뜻임. 고장값은 파라미터로도
읽히는 같은 레지스터(`faultSta`, uint32)이고, 파라미터는 매뉴얼이 작은 자리
먼저라고 명시함.

반대로 읽으면 **`raw` 는 0이 아닌데 이름이 하나도 안 붙음** — 과열(bit0)이
`0x01000000` 이 되어 어느 고장 비트에도 안 걸림. 이름 없는 16진수 줄이 나오면
이 순서를 의심할 것.

### `decode_fault`의 한계

고장 응답은 일반 상태 프레임과 **CAN ID가 같아**(둘 다 11비트 ID = 호스트 ID)
겉으로 구분되지 않음. 조회 명령을 보낸 직후의 첫 응답으로 간주해야 함.

**`decode_flags(data).fault` 가 더 나은 경로임.** 상태 프레임마다 딸려 오므로
왕복도 없고 오인할 여지도 없음. "무슨 고장인지"가 필요할 때만 `read_fault` 를 씀.

---

## `bus.py`

`base.py` 의 `MotorsBus` 계약, `codec/mit.py`, `canbus.py` 를 잇는 곳임.

각도는 전부 **raw 공간**이고 관절 이름은 모름 — 모터 id 로만 말함. cal 변환과 관절
이름은 `robots/` 가 함.

### 상태는 명령의 응답으로 옴

MIT 모드에는 **"상태 읽기" 명령이 따로 없음.** 모터는 동작 명령을 받으면 응답으로
현재 상태를 돌려줌.

그래서 움직이지 않고 상태만 보려면 게인과 토크가 0인 명령을 보냄.

```
tau = kp*(목표각 - 현재각) + kd*(0 - 현재속도) + 토크_FF
    =  0*(...)          +  0*(...)          + 0
    =  0
```

토크가 0이니 아무 일도 일어나지 않고 응답만 옴. 이것이 `PASSIVE` 임.

#### 요청 없이 받는 길도 있음 (미구현)

"읽기 명령" 은 없지만 **모터가 알아서 보내게** 할 수는 있음 — Command 13
(`CMD_ACTIVE_REPORT`, 매뉴얼 6.16절).

```
cansend can1 00A#FFFFFFFFFFFF01F9      # F_CMD=1 켬 / 0 끔(기본값)
```

켜면 Response Command 1 을 **기본 10ms 주기**로 스스로 보냄. 주기는 파라미터
`EPScan_time`(0x7026)으로 조정 — `1`=10ms, 이후 +1 마다 +5ms.

**제어 루프에는 쓰지 말 것.** 보고 시각이 모터 타이머 기준이라 명령과 안 붙음.
두 다리의 명령 시각을 맞추려고 전송을 몰아 둔 것([이슈 #10](../../../../docs/issues.md))이
무의미해짐. 명령을 안 보내면서 상태만 보고 싶은 자리 — 브링업 화면, 모니터링,
커미셔닝 중 관절을 손으로 돌려 보는 상황 — 에 맞음.

펌웨어 요구사항: RS00 `0.0.3.27` / RS02 `0.2.3.32` 이상.

### 전송과 수거를 나눠 둠

| | |
|---|---|
| `send_mit(commands)` | 보내기만. 보낸 개수 반환 |
| `collect(expect=)` | 수거만. **응답이 없었던 모터 id** 반환 |
| `refresh_states(motors=)` | 둘 다 (`MotorsBus` 계약) |

버스가 둘일 때 "왼다리 보내기 → 오른다리 보내기 → 왼다리 수거 → 오른다리 수거"
순서를 짜려면 나뉘어 있어야 함 (이슈 #10).

**`refresh_states` 는 제어 루프에서 쓰지 않음.** 이미 보낸 명령의 응답을
`collect()` 로 받으면 되므로 프레임을 두 배로 보낼 이유가 없음. 토크를 넣기 전에
다리 위치를 볼 때 씀.

### `MitCommand`

```python
MitCommand(position_deg=45.0, velocity_deg_s=0.0, kp=30.0, kd=1.0, torque_nm=0.0)
```

다섯 값을 튜플로 넘기지 않는 이유: 전부 `float` 이라 **순서를 틀려도 조용히
통과함.** `kp` 자리에 위치가 들어가면 `kp=45` 가 되어 모터가 전력으로 튐.

`position_deg` 는 raw 공간임.

### 모터별 인코딩 표

다리에 RS02 4개와 RS00 2개가 섞여 있고 토크 범위가 다름(17 vs 14 N·m). **같은
바이트가 모터마다 다른 토크를 뜻함.**

응답을 해석할 때 모터 id 를 프레임 안(`data[0]`)에서 꺼냄 — CAN 중재 id 는 모델을
알려주지 않음.

모델 문자열을 벤더 enum 으로 옮기는 곳이 **생성자 하나**임. 여기서 걸러 두면 제어
중에 오타가 드러나는 일이 없음.

```
m1: 모르는 모델 'RS99'. 가용: ['RS00', 'RS02']
```

### `disconnect` 가 토크를 먼저 끊음

순서가 반대면 채널이 닫힌 뒤라 정지 명령을 보낼 방법이 없어짐. 모터는 마지막
명령을 유지하므로 사람이 전원을 뽑을 때까지 힘을 씀.

**차단이 실패해도 채널은 반드시 닫음.** 여기서 예외를 올리면 정리가 중간에 멈춰
소켓이 열린 채로 남고, 다음 실행 때 채널을 못 엶.

### `read_fault` 가 큐를 먼저 비움

고장 응답은 일반 상태 프레임과 **CAN ID 가 같아** 구분되지 않음. 묵은 프레임이 남아
있으면 그걸 고장값으로 읽음.

`F_CMD` 도 조회용(`0x00`)을 씀 — `0xFF` 면 클리어라서 **조회하려다 원인을 지움.**

응답이 없으면 `None`, 정상이면 `ok=True` 임. 둘은 다름.

### 한계를 검사하지 않음

`send_mit` 은 값을 그대로 보냄. 한계는 `safety.guards` 가 cal 공간에서 이미 함.

같은 검사를 두 군데 두면 한쪽만 고쳐졌을 때 어느 쪽이 맞는지 알 수 없음.

### 지연을 잴 수 있음 (`latency`)

`latency` 에 기록기를 붙이면 `send_mit` 이 묶음을 보내기 직전 시각을 모터마다 남기고,
`collect` 가 응답 프레임의 도착 시각(수신 스레드가 찍은 `CanFrame.stamp`)과 맞춰
지연을 넘김. 도착이 이번 송신보다 앞이면 직전 명령의 늦은 응답으로 봄 -- MIT 응답에
순번이 없어서임.

기본은 `None` 이고, 그때는 시각을 재지도 않음. 붙이는 쪽은
`telemetry.latency_log.LatencyLog.attach()` (`huphy-run --log`).

### 여기 없는 것

CAN id 변경, 프로토콜 전환, 기계영점, 플래시 저장은 `commissioning.py` 로 감.
되돌리기 어렵고 한 번만 하는 조작이라, 제어 루프에서 부를 수 있는 자리에 두지 않음.

---

## `commissioning.py`

**조립할 때 한 번 하는 조작.** 제어 루프에서 쓰는 것이 하나도 없음.

`bus.py` 와 파일을 나눈 이유: 여기 있는 것은 전부 **되돌리기 어려움.**

| 조작 | 무엇이 남나 |
|---|---|
| 기계 영점 | 모터에 저장됨. 전원 재투입 후에도 남음 |
| CAN id 변경 | 주소가 바뀌어 옛 id 로는 말을 걸 수 없음 |
| 프로토콜 전환 | 전원을 재투입해야 적용됨 |

`MotorsBus` 계약에 이것들이 없으므로 제어 코드에서는 **부를 방법 자체가 없음.**

### 담긴 것

| | |
|---|---|
| `set_control_mode` | 제어 모드 (Command 6). 즉시 적용 |
| `set_zero` | 지금 자세를 기계 영점으로 (Command 4) |
| `set_can_id` | CAN id 변경 (Command 7) |
| `set_protocol` | 프로토콜 전환 (Command 8) |
| `sweep` | 토크를 끄고 손으로 미는 동안 가동 범위 기록 |
| `nudge` | 조금 움직였다 되돌림. 어느 관절인지 확인용 |
| `scan` | 응답하는 모터 id 수집 |

### 한 모터씩만 처리함

여러 개를 연속으로 바꾸다 중간에 실패하면 **어느 것이 옛 상태이고 어느 것이 새
상태인지 알 수 없음.** CAN id 가 겹치면 응답이 충돌해 구분조차 안 됨.

영점은 자세를 잡아 놓고 하나씩 하는 작업이기도 함.

### `set_zero` 가 메모를 필수로 받음

```python
set_zero(bus, 10, zero_reference="다리 편 상태, 발바닥 평면 접촉")
```

모터는 영점 값을 저장하지만 **"그때 다리가 어떤 자세였는지" 는 어디에도 남지
않음.** 이 메모가 없으면 영점을 재현할 수 없고, 재현할 수 없으면 `offset` 실측이
무의미해짐.

### `set_zero` 가 토크 켜진 상태를 거부함

영점을 잡으면 모터의 좌표계가 통째로 옮겨감. 그런데 직전 명령의 목표각은 **옛
좌표계 값**임. 그대로 유지되면 그 차이만큼 관절이 튐.

### `set_can_id` 가 새 id 로 응답을 확인함

상태 프레임에는 모터 id 가 실리므로 이것만은 확인 가능함. 실패하면 **양쪽 id 로
다시 확인하라고 알림** — 반영됐는데 응답만 놓쳤을 수 있음.

### `sweep` — 가동 범위를 재는 유일한 방법

한계는 **잴 수밖에 없음.** 토크를 끄고 사람이 관절을 양쪽 끝까지 밀면 그동안의
최대·최소를 기록함.

```python
sweep(bus, [10], should_stop=enter_pressed, on_update=show)
# {10: SweepResult(motor_id=10, lo_deg=-20.61, hi_deg=74.76, samples=412)}
```

**토크를 먼저 끊음.** 힘이 들어간 채로 밀면 모터와 싸우게 되고, 손으로 밀 수 있는
범위가 실제 가동 범위보다 좁게 나옴.

**raw 공간으로 냄.** 캘리브레이션 전에도 쓸 수 있어야 하기 때문임. 영점을 다시
잡으면 이 값도 다시 재야 함.

#### 발목도 같이 잼

두 모터가 로드로 발판에 물려 있어 한쪽만 손으로 돌릴 수 없음. **발을 잡고 움직이면
두 모터가 같이 따라옴** — 둘 다 토크가 꺼져 있어 서로 밀리지 않음.

그렇게 얻은 두 범위는 각 모터가 **어떤 자세에서든 가질 수 있는 값의 범위**임.
두 최대값을 동시에 가지는 자세는 없을 수 있으나, 명령은 IK 가 만든 짝에서
시작하므로 문제되지 않음.

#### 값이 사람 손에 달려 있음

끝까지 안 밀면 그만큼 좁게 나옴. **한 번 더 돌려 같은 값이 나오는지** 보는 것이
확인 방법임.

### `nudge` 는 현재 위치 기준 상대 이동

이 시점에는 캘리브레이션이 없어 **cal 공간이 존재하지 않음.** 따라서
`Motor.limits_deg` 를 적용할 수 없고, 지금 있는 자리에서 조금 움직이는 것만
안전하게 할 수 있음.

```
진폭 20도 상한      확인용이지 동작용이 아님
기본 kp=5           걸리면 못 움직이고 마는 편이 나음
PASSIVE 후 정지     바로 끊으면 관절이 떨어짐
finally 토크 차단    중단해도 힘이 빠짐
```

호출 전에 다리를 받쳐 둘 것. 중력을 이길 만큼의 게인이 아니므로 무릎처럼 하중을
받는 관절은 지지 없이는 움직이지 않거나 처짐.

### MIT 표준 프레임으로 되는 것만 있음

파라미터 읽기·쓰기(`PARAM_PROTOCOL_FLAG`, `PARAM_ZERO_STA`)를 다루는 명령은 여기
없음. 인덱스만 `tables.py` 에 적어 둠.

즉 하드웨어 전제를 코드로 확인할 수 없고, 지금은 외부 도구로 확인함 (이슈 #11).

---

## 터미널에서 쓰기

```bash
python -m huphy.scripts.commission --limb right_leg scan
python -m huphy.scripts.commission --limb right_leg nudge knee --delta 5
```

설정 파일에서 모터 목록을 읽으므로 모터 id 를 손으로 적지 않음.
[scripts/README.md](../../scripts/README.md) 참조.

---

## 테스트

```bash
PYTHONPATH=src python3 -m pytest tests/test_codec.py tests/test_robstride_bus.py \
                                tests/test_commissioning.py -q
```

`codec` 31개, `bus` 40개, `commissioning` 33개. 전부 하드웨어 없이 돌아감 —
자세한 내용은 [tests/README.md](../../../../tests/README.md) 참조.

---

## 미구현

| 파일 | 용도 | 필요해지는 시점 |
|---|---|---|
| `codec/private.py` | 29-bit 확장 프레임. 파라미터 읽기·쓰기 | 이슈 #11 을 해소할 때 |
