Human-Pygmalion/HUPHY/ros/huphy_ros/meshes/pelvis.stl

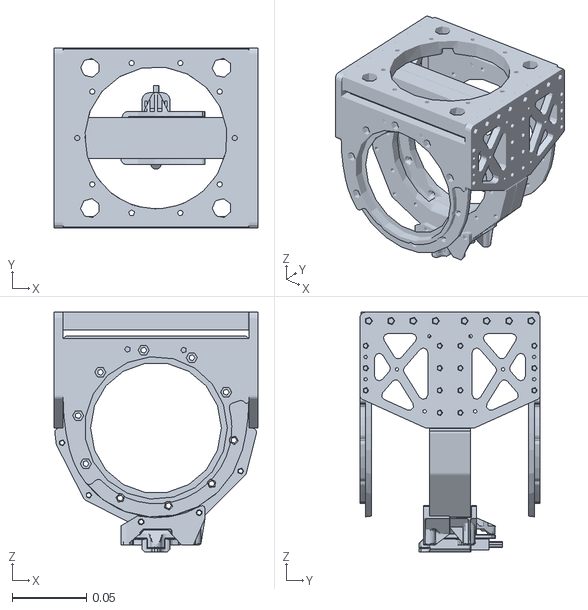
[picture p1: CAD file, 2026-11-02]
ros/huphy_ros/meshes/pelvis.stl
0.137 x 0.121 x 0.161
