Human-Pygmalion/HUPHY/ros/huphy_ros/meshes/R_thigh.stl

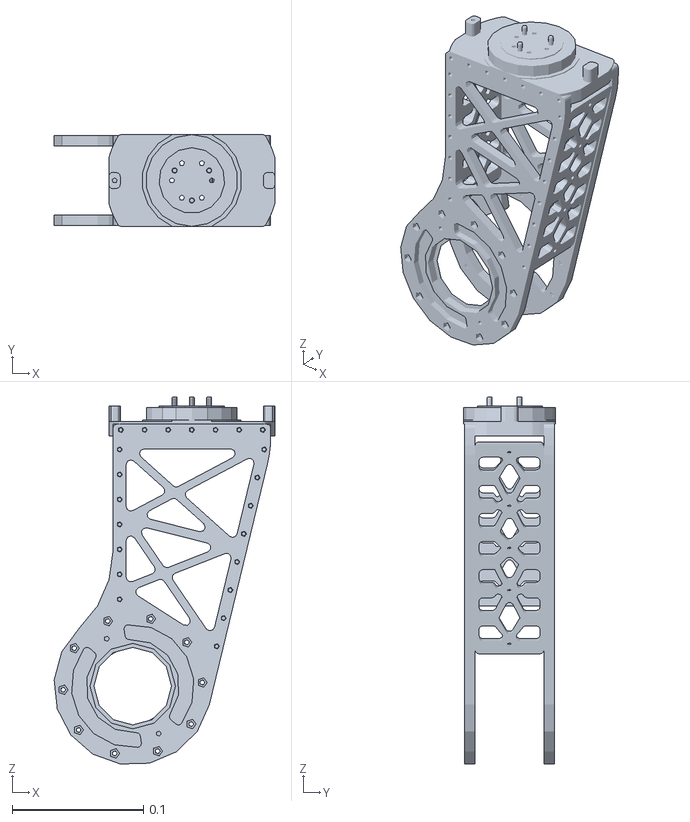
[picture p2: CAD file, 2026-11-02]
ros/huphy_ros/meshes/R_thigh.stl
0.168 x 0.0699 x 0.279
