Human-Pygmalion/HUPHY/ros/huphy_ros/meshes/crank_B.stl

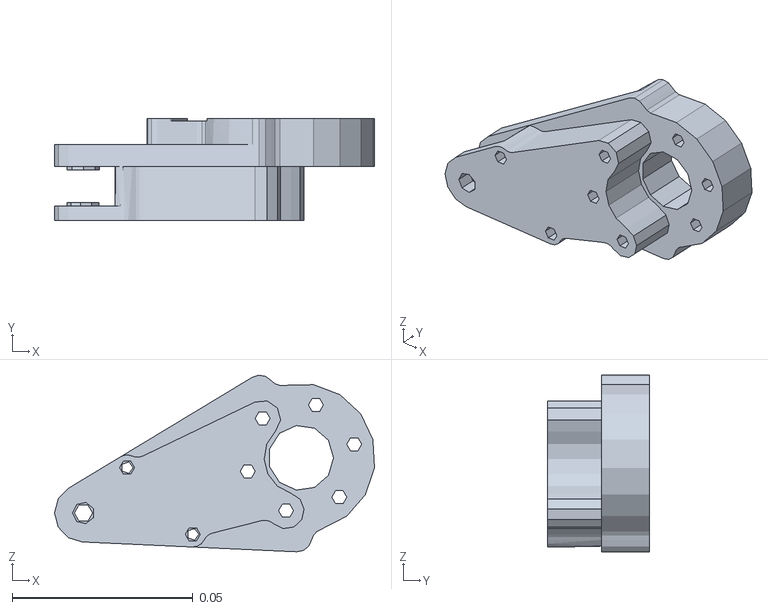
[picture p3: CAD file, 2026-11-02]
ros/huphy_ros/meshes/crank_B.stl
0.0884 x 0.0282 x 0.0488
