Human-Pygmalion/HUPHY/ros/huphy_ros/meshes/foot_noloop.stl

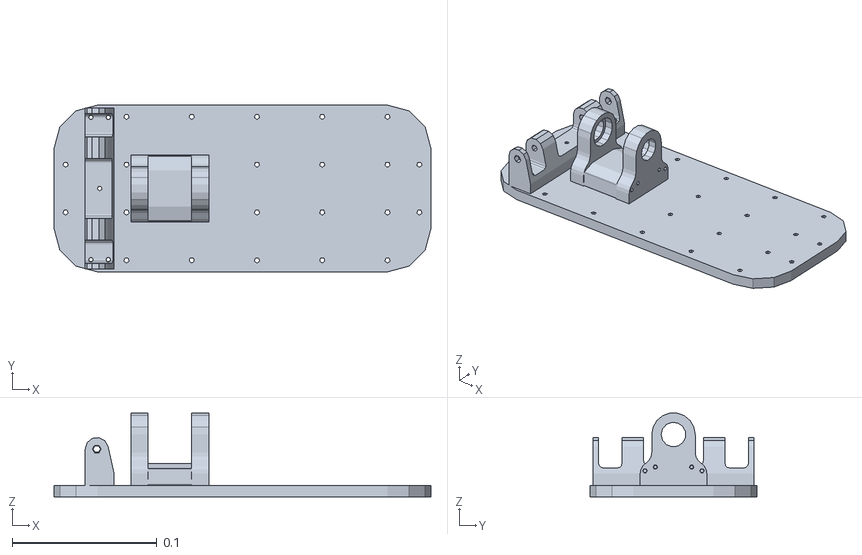
[picture p4: CAD file, 2026-11-02]
ros/huphy_ros/meshes/foot_noloop.stl
0.26 x 0.115 x 0.0578
