Human-Pygmalion/HUPHY/ros/huphy_ros/meshes/R_rod_B.stl

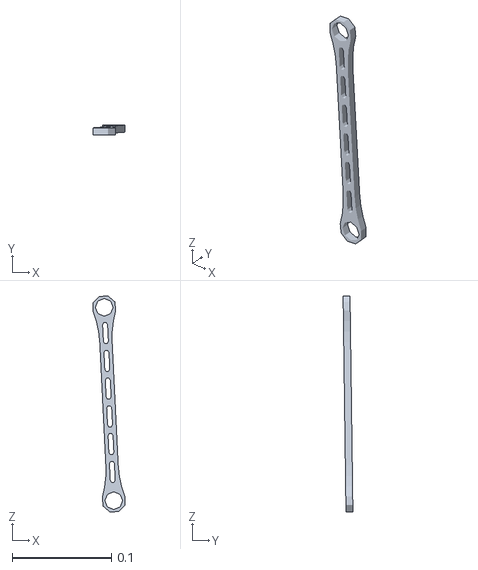
[picture p5: CAD file, 2026-11-02]
ros/huphy_ros/meshes/R_rod_B.stl
0.032 x 0.0099 x 0.218
