Human-Pygmalion/HUPHY/ros/huphy_ros/meshes/hip_pitch_link.stl

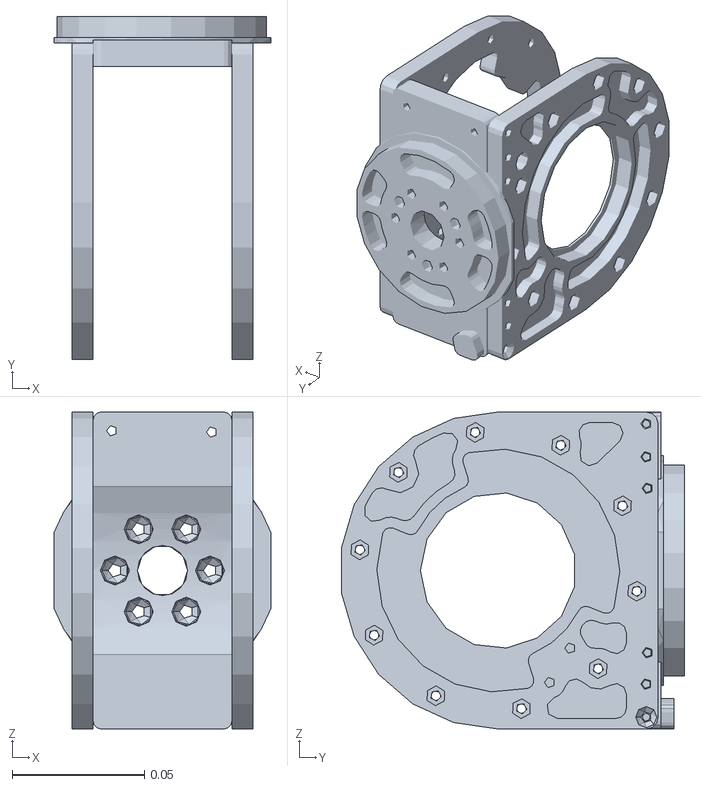
[picture p6: CAD file, 2026-11-02]
ros/huphy_ros/meshes/hip_pitch_link.stl
0.082 x 0.13 x 0.12
