Human-Pygmalion/HUPHY/ros/huphy_ros/meshes/crank_A.stl

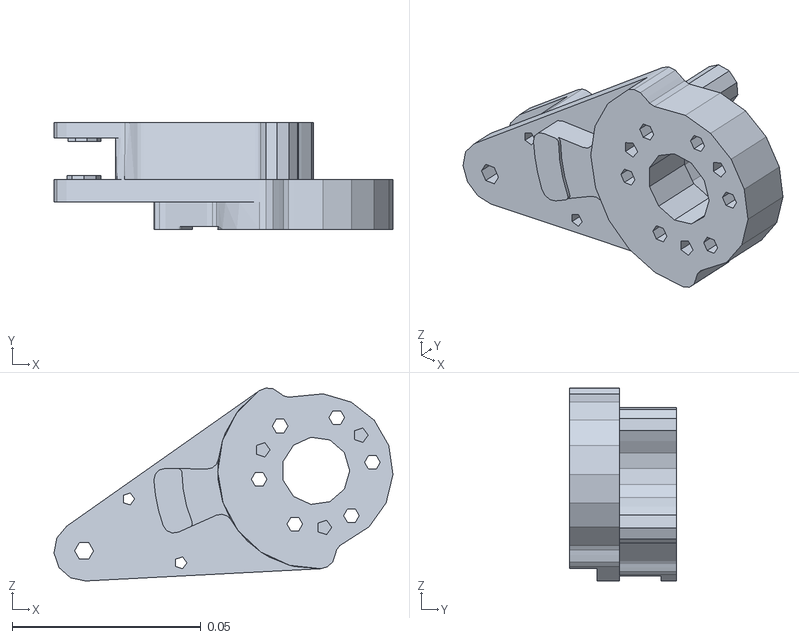
[picture p7: CAD file, 2026-11-02]
ros/huphy_ros/meshes/crank_A.stl
0.0899 x 0.0283 x 0.0512
