Human-Pygmalion/HUPHY/ros/huphy_ros/meshes/R_rod_A.stl

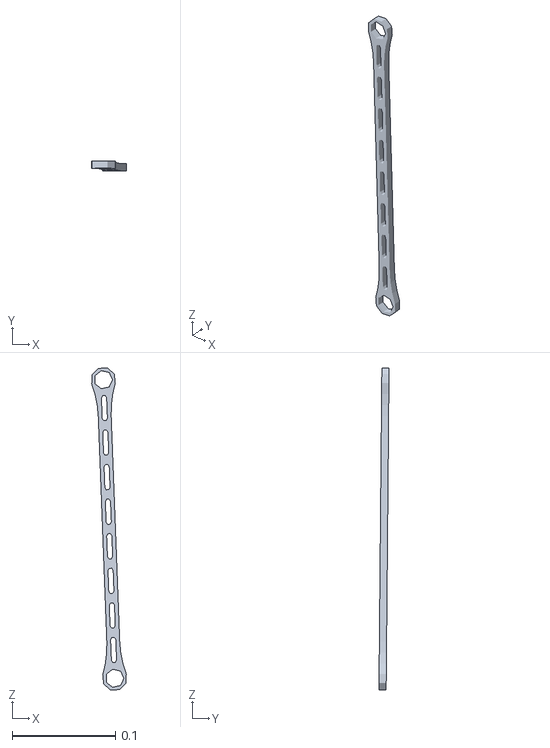
[picture p8: CAD file, 2026-11-02]
ros/huphy_ros/meshes/R_rod_A.stl
0.0334 x 0.0098 x 0.311
