Human-Pygmalion/HUPHY/ros/huphy_ros/meshes/shin_noloop.stl

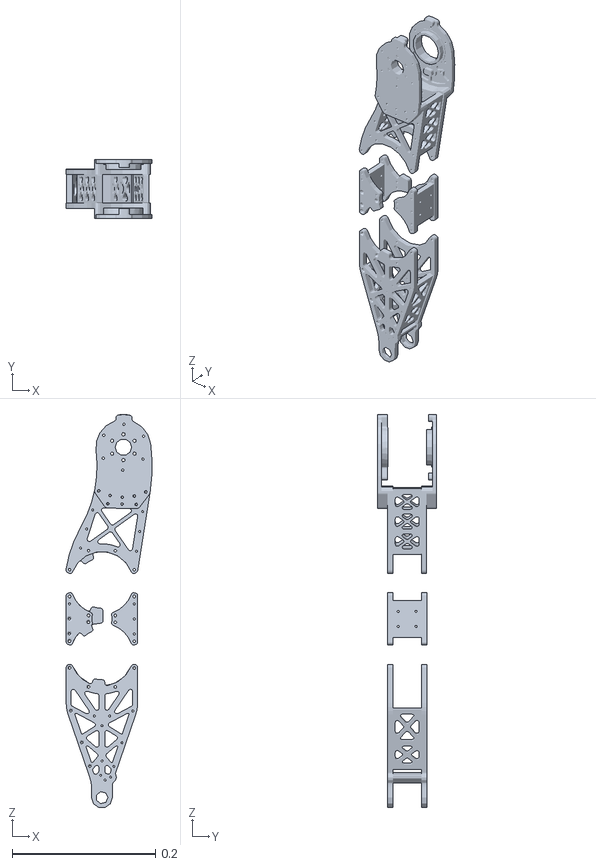
[picture p9: CAD file, 2026-11-02]
ros/huphy_ros/meshes/shin_noloop.stl
0.12 x 0.083 x 0.55
