Human-Pygmalion/HUPHY/ros/huphy_ros/meshes/hip_roll_link.stl

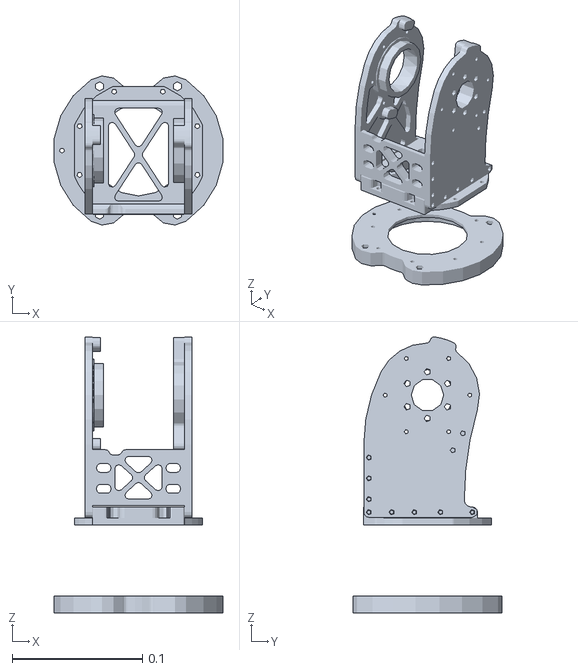
[picture p10: CAD file, 2026-11-02]
ros/huphy_ros/meshes/hip_roll_link.stl
0.13 x 0.115 x 0.212
