Human-Pygmalion/HUPHY/(list of files, cad)

Other CAD files:
ros/huphy_ros/meshes/R_foot_noloop.stl
ros/huphy_ros/meshes/thigh.stl
ros/huphy_ros/meshes/R_crank_A.stl
ros/huphy_ros/meshes/rod_A.stl
ros/huphy_ros/meshes/rod_B.stl
ros/huphy_ros/meshes/R_hip_pitch_link.stl
ros/huphy_ros/meshes/R_crank_B.stl
ros/huphy_ros/meshes/R_hip_roll_link.stl
ros/huphy_ros/meshes/R_shin_noloop.stl
