Human-Pygmalion/HUPHY/archivedlogs/test_zerolatency(gscan r).csv

# drain_ms=4 hz=200
t | joint | latency_ms | status
0.0957 | right_leg/hip_pitch | 2.2565 | ontime
0.1301 | right_leg/hip_pitch | 3.8686 | ontime
0.1437 | right_leg/hip_pitch | 0.7305 | ontime
0.1518 | right_leg/hip_pitch | 3.4889 | late
0.1574 | right_leg/hip_pitch | 2.1044 | late
0.1639 | right_leg/hip_pitch | 0.7407 | ontime
0.1692 | right_leg/hip_pitch | 1.3558 | late
0.1765 | right_leg/hip_pitch | 0.6051 | late
0.1850 | right_leg/hip_pitch | 1.3735 | late
0.1934 | right_leg/hip_pitch | 1.0367 | late
0.1993 | right_leg/hip_pitch | 1.5252 | late
0.2099 | right_leg/hip_pitch | 1.1864 | late
0.2176 | right_leg/hip_pitch | 3.5074 | late
0.2258 | right_leg/hip_pitch | 0.9567 | late
0.2315 | right_leg/hip_pitch | 1.0560 | late
0.2403 | right_leg/hip_pitch | 2.3375 | late
0.2498 | right_leg/hip_pitch | 1.0824 | late
0.2553 | right_leg/hip_pitch | 1.1473 | late
0.2625 | right_leg/hip_pitch | 0.4742 | ontime
0.2626 | right_leg/hip_pitch | 1.4958 | ontime
0.2716 | right_leg/hip_pitch | 0.6802 | ontime
0.2785 | right_leg/hip_pitch | 0.6133 | ontime
0.2935 | right_leg/hip_pitch | 0.5323 | ontime
0.2935 | right_leg/hip_pitch | 0.9433 | ontime
0.2997 | right_leg/hip_pitch | 1.0201 | ontime
0.3072 | right_leg/hip_pitch | 1.0469 | ontime
0.3151 | right_leg/hip_pitch | 3.4075 | ontime
0.3212 | right_leg/hip_pitch | 1.8411 | ontime
0.3271 | right_leg/hip_pitch | 0.8549 | ontime
0.3372 | right_leg/hip_pitch | 3.4401 | ontime
0.3442 | right_leg/hip_pitch | 2.3082 | ontime
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
30.5525 | right_leg/hip_pitch | 3.6968 | ontime
30.5635 | right_leg/hip_pitch | 0.9806 | ontime
30.5760 | right_leg/hip_pitch | 0.8219 | ontime
30.5885 | right_leg/hip_pitch | 4.5568 | ontime
30.6012 | right_leg/hip_pitch | 1.5414 | ontime
30.6141 | right_leg/hip_pitch | 3.5697 | ontime
30.6295 | right_leg/hip_pitch | 1.9198 | ontime
30.6421 | right_leg/hip_pitch | 4.1675 | ontime
30.6547 | right_leg/hip_pitch | 1.1398 | ontime
30.6666 | right_leg/hip_pitch | 2.3612 | ontime
30.6797 | right_leg/hip_pitch | 3.3854 | ontime
30.6952 | right_leg/hip_pitch | 1.0412 | ontime
30.7072 | right_leg/hip_pitch | 2.4901 | ontime
30.7214 | right_leg/hip_pitch | 3.6580 | ontime
30.7330 | right_leg/hip_pitch | 1.0281 | ontime
30.7482 | right_leg/hip_pitch | 3.9691 | ontime
30.7609 | right_leg/hip_pitch | 2.0396 | ontime
30.7748 | right_leg/hip_pitch | 0.9540 | ontime
30.7860 | right_leg/hip_pitch | 1.3768 | ontime
30.7979 | right_leg/hip_pitch | 1.2682 | ontime
30.8115 | right_leg/hip_pitch | 1.6252 | ontime
30.8247 | right_leg/hip_pitch | 0.7649 | ontime
30.8384 | right_leg/hip_pitch | 2.2755 | ontime
30.8492 | right_leg/hip_pitch | 3.5889 | ontime
30.8617 | right_leg/hip_pitch | 4.0432 | ontime
30.8733 | right_leg/hip_pitch | 2.6884 | ontime
30.8840 | right_leg/hip_pitch | 3.6806 | ontime
30.8952 | right_leg/hip_pitch | 1.9735 | ontime
30.9075 | right_leg/hip_pitch | 3.8101 | ontime
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
