Human-Pygmalion/HUPHY/ros/huphy_ros/urdf/huphy.urdf

<?xml version='1.0' encoding='utf-8'?>
<robot name="LegOnly_prototype-tempmass-motormeasured-armfix_v30_proxyfix_loop">
  <link name="base_link">
    <visual>
      <geometry>
        <mesh filename="package://huphy_ros/meshes/pelvis.stl" />
      </geometry>
    </visual>
    <visual name="R_hip_pitch_motor">
      <origin xyz="0.00065 -0.02962 -0.00044" rpy="-1.5708 0 0" />
      <geometry>
        <cylinder radius="0.06" length="0.0556" />
      </geometry>
      <material name="motor_black">
        <color rgba="0.1 0.1 0.1 1" />
      </material>
    </visual>
    <visual name="waist_yaw_motor">
      <origin xyz="0.00053 0.00058 0.09393" rpy="0 0 0" />
      <geometry>
        <cylinder radius="0.06" length="0.0556" />
      </geometry>
      <material name="motor_black">
        <color rgba="0.1 0.1 0.1 1" />
      </material>
    </visual>
    <visual name="L_hip_pitch_motor">
      <origin xyz="0.00065 0.02962 -0.00044" rpy="1.5708 0 0" />
      <geometry>
        <cylinder radius="0.06" length="0.0556" />
      </geometry>
      <material name="motor_black">
        <color rgba="0.1 0.1 0.1 1" />
      </material>
    </visual>
  </link>
  <link name="R_hip_pitch_link">
    <inertial>
      <origin xyz="0.00154376 0.00538733 0.000525268" rpy="0 0 0" />
      <mass value="1.8417" />
      <inertia ixx="0.00411465" ixy="9.91708e-06" ixz="6.31569e-06" iyy="0.00262779" iyz="7.62039e-06" izz="0.00285458" />
    </inertial>
    <visual>
      <geometry>
        <mesh filename="package://huphy_ros/meshes/hip_pitch_link.stl" />
      </geometry>
    </visual>
    <visual name="R_hip_roll_motor">
      <origin xyz="0.00317 0.00061 0.00049" rpy="3.14159 -1.5708 3.14159" />
      <geometry>
        <cylinder radius="0.06" length="0.0556" />
      </geometry>
      <material name="motor_black">
        <color rgba="0.1 0.1 0.1 1" />
      </material>
    </visual>
  </link>
  <link name="R_hip_roll_link">
    <inertial>
      <origin xyz="0.000912268 -0.00135613 -0.121662" rpy="0 0 0" />
      <mass value="1.373" />
      <inertia ixx="0.00340192" ixy="-2.6909e-06" ixz="-0.000151014" iyy="0.00347541" iyz="9.2076e-05" izz="0.002068" />
    </inertial>
    <visual>
      <geometry>
        <mesh filename="package://huphy_ros/meshes/hip_roll_link.stl" />
      </geometry>
    </visual>
    <visual name="R_hip_yaw_motor">
      <origin xyz="6e-05 3e-05 -0.13303" rpy="0 0 0" />
      <geometry>
        <cylinder radius="0.0495" length="0.0566" />
      </geometry>
      <material name="motor_black">
        <color rgba="0.1 0.1 0.1 1" />
      </material>
    </visual>
  </link>
  <link name="R_thigh_link">
    <inertial>
      <origin xyz="-0.0367184 -0.00147556 -0.339418" rpy="0 0 0" />
      <mass value="2.1176" />
      <inertia ixx="0.0114407" ixy="-8.34427e-06" ixz="-0.00210864" iyy="0.0135125" iyz="-7.39365e-05" izz="0.00382553" />
    </inertial>
    <visual>
      <geometry>
        <mesh filename="package://huphy_ros/meshes/thigh.stl" />
      </geometry>
    </visual>
    <visual name="R_knee_motor">
      <origin xyz="-0.04495 -0.00318 -0.36922" rpy="-1.5708 0 0" />
      <geometry>
        <cylinder radius="0.06" length="0.0556" />
      </geometry>
      <material name="motor_black">
        <color rgba="0.1 0.1 0.1 1" />
      </material>
    </visual>
  </link>
  <link name="R_shin_link">
    <inertial>
      <origin xyz="-0.0275899 -0.000127367 -0.232073" rpy="0 0 0" />
      <mass value="2.7018" />
      <inertia ixx="0.0211235" ixy="1.81622e-05" ixz="-0.00113853" iyy="0.0221923" iyz="0.000144791" izz="0.00343319" />
    </inertial>
    <visual>
      <geometry>
        <mesh filename="package://huphy_ros/meshes/shin_noloop.stl" />
      </geometry>
    </visual>
    <visual name="R_ankle_b_motor">
      <origin xyz="-0.02994 -0.00172 -0.19003" rpy="-1.5708 0 0" />
      <geometry>
        <cylinder radius="0.0495" length="0.0566" />
      </geometry>
      <material name="motor_black">
        <color rgba="0.1 0.1 0.1 1" />
      </material>
    </visual>
    <visual name="R_ankle_a_motor">
      <origin xyz="-0.03006 0.00172 -0.29003" rpy="-1.5708 0 0" />
      <geometry>
        <cylinder radius="0.0495" length="0.0566" />
      </geometry>
      <material name="motor_black">
        <color rgba="0.1 0.1 0.1 1" />
      </material>
    </visual>
  </link>
  <link name="R_ankle_pitch_link">
    <inertial>
      <origin xyz="0 1.42109e-17 0" rpy="0 0 0" />
      <mass value="0.040016" />
      <inertia ixx="1.43238e-05" ixy="-2.21684e-10" ixz="-1.31465e-09" iyy="3.69795e-06" iyz="-1.14375e-09" izz="1.42313e-05" />
    </inertial>
  </link>
  <link name="R_foot_link">
    <inertial>
      <origin xyz="0.0326641 4.26326e-17 -0.0312039" rpy="0 0 0" />
      <mass value="0.84518" />
      <inertia ixx="0.00109062" ixy="1.60551e-07" ixz="0.000280046" iyy="0.00456268" iyz="7.88778e-07" izz="0.00503462" />
    </inertial>
    <visual>
      <geometry>
        <mesh filename="package://huphy_ros/meshes/foot_noloop.stl" />
      </geometry>
    </visual>
  </link>
  <link name="L_hip_pitch_link">
    <inertial>
      <origin xyz="0.00154376 -0.00538733 0.000525268" rpy="0 0 0" />
      <mass value="1.8417" />
      <inertia ixx="0.00411465" ixy="-9.91708e-06" ixz="6.31569e-06" iyy="0.00262779" iyz="-7.62039e-06" izz="0.00285458" />
    </inertial>
    <visual>
      <geometry>
        <mesh filename="package://huphy_ros/meshes/R_hip_pitch_link.stl" />
      </geometry>
    </visual>
    <visual name="L_hip_roll_motor">
      <origin xyz="0.00317 -0.00061 0.00049" rpy="3.14159 -1.5708 3.14159" />
      <geometry>
        <cylinder radius="0.06" length="0.0556" />
      </geometry>
      <material name="motor_black">
        <color rgba="0.1 0.1 0.1 1" />
      </material>
    </visual>
  </link>
  <link name="L_hip_roll_link">
    <inertial>
      <origin xyz="0.000912268 0.00135613 -0.121662" rpy="0 0 0" />
      <mass value="1.373" />
      <inertia ixx="0.00340192" ixy="2.6909e-06" ixz="-0.000151014" iyy="0.00347541" iyz="-9.2076e-05" izz="0.002068" />
    </inertial>
    <visual>
      <geometry>
        <mesh filename="package://huphy_ros/meshes/R_hip_roll_link.stl" />
      </geometry>
    </visual>
    <visual name="L_hip_yaw_motor">
      <origin xyz="6e-05 -3e-05 -0.13303" rpy="0 0 0" />
      <geometry>
        <cylinder radius="0.0495" length="0.0566" />
      </geometry>
      <material name="motor_black">
        <color rgba="0.1 0.1 0.1 1" />
      </material>
    </visual>
  </link>
  <link name="L_thigh_link">
    <inertial>
      <origin xyz="-0.0367184 0.00147556 -0.339418" rpy="0 0 0" />
      <mass value="2.1176" />
      <inertia ixx="0.0114407" ixy="8.34427e-06" ixz="-0.00210864" iyy="0.0135125" iyz="7.39365e-05" izz="0.00382553" />
    </inertial>
    <visual>
      <geometry>
        <mesh filename="package://huphy_ros/meshes/R_thigh.stl" />
      </geometry>
    </visual>
    <visual name="L_knee_motor">
      <origin xyz="-0.04495 0.00318 -0.36922" rpy="1.5708 0 0" />
      <geometry>
        <cylinder radius="0.06" length="0.0556" />
      </geometry>
      <material name="motor_black">
        <color rgba="0.1 0.1 0.1 1" />
      </material>
    </visual>
  </link>
  <link name="L_shin_link">
    <inertial>
      <origin xyz="-0.0275899 0.000127367 -0.232073" rpy="0 0 0" />
      <mass value="2.7018" />
      <inertia ixx="0.0211235" ixy="-1.81622e-05" ixz="-0.00113853" iyy="0.0221923" iyz="-0.000144791" izz="0.00343319" />
    </inertial>
    <visual>
      <geometry>
        <mesh filename="package://huphy_ros/meshes/R_shin_noloop.stl" />
      </geometry>
    </visual>
    <visual name="L_ankle_b_motor">
      <origin xyz="-0.02994 0.00172 -0.19003" rpy="1.5708 0 0" />
      <geometry>
        <cylinder radius="0.0495" length="0.0566" />
      </geometry>
      <material name="motor_black">
        <color rgba="0.1 0.1 0.1 1" />
      </material>
    </visual>
    <visual name="L_ankle_a_motor">
      <origin xyz="-0.03006 -0.00172 -0.29003" rpy="1.5708 0 0" />
      <geometry>
        <cylinder radius="0.0495" length="0.0566" />
      </geometry>
      <material name="motor_black">
        <color rgba="0.1 0.1 0.1 1" />
      </material>
    </visual>
  </link>
  <link name="L_ankle_pitch_link">
    <inertial>
      <origin xyz="0 -1.42109e-17 0" rpy="0 0 0" />
      <mass value="0.040016" />
      <inertia ixx="1.43238e-05" ixy="2.21684e-10" ixz="-1.31465e-09" iyy="3.69795e-06" iyz="1.14375e-09" izz="1.42313e-05" />
    </inertial>
  </link>
  <link name="L_foot_link">
    <inertial>
      <origin xyz="0.0326641 -4.26326e-17 -0.0312039" rpy="0 0 0" />
      <mass value="0.84518" />
      <inertia ixx="0.00109062" ixy="-1.60551e-07" ixz="0.000280046" iyy="0.00456268" iyz="-7.88778e-07" izz="0.00503462" />
    </inertial>
    <visual>
      <geometry>
        <mesh filename="package://huphy_ros/meshes/R_foot_noloop.stl" />
      </geometry>
    </visual>
  </link>
  <joint name="right_leg__hip_pitch" type="revolute">
    <origin xyz="0 -0.1237 0" rpy="0 0 0" />
    <parent link="base_link" />
    <child link="R_hip_pitch_link" />
    <axis xyz="0 1 0" />
    <limit lower="-2.0943951023931953" upper="0.4363323129985824" effort="120" velocity="20" />
    <dynamics damping="0.0275" friction="0.519" />
  </joint>
  <joint name="right_leg__hip_roll" type="revolute">
    <origin xyz="0 0 0" rpy="0 0 0" />
    <parent link="R_hip_pitch_link" />
    <child link="R_hip_roll_link" />
    <axis xyz="-1 0 0" />
    <limit lower="-0.4363323129985824" upper="1.4835298641951802" effort="120" velocity="20" />
    <dynamics damping="0.0275" friction="0.519" />
  </joint>
  <joint name="right_leg__hip_yaw" type="revolute">
    <origin xyz="0 0 0" rpy="0 0 0" />
    <parent link="R_hip_roll_link" />
    <child link="R_thigh_link" />
    <axis xyz="0 0 1" />
    <limit lower="-0.7853981633974483" upper="0.7853981633974483" effort="60" velocity="20" />
    <dynamics damping="0.0252" friction="0.251" />
  </joint>
  <joint name="right_leg__knee" type="revolute">
    <origin xyz="-0.045 0 -0.37" rpy="0 0 0" />
    <parent link="R_thigh_link" />
    <child link="R_shin_link" />
    <axis xyz="0 1 0" />
    <limit lower="0.0" upper="2.0943951023931953" effort="120" velocity="20" />
    <dynamics damping="0.0275" friction="0.519" />
  </joint>
  <joint name="right_leg__ankle_pitch" type="revolute">
    <origin xyz="-0.03 0 -0.49" rpy="0 0 0" />
    <parent link="R_shin_link" />
    <child link="R_ankle_pitch_link" />
    <axis xyz="0 -1 0" />
    <limit lower="-0.8726646259971648" upper="0.5235987755982988" effort="90" velocity="20" />
  </joint>
  <joint name="right_leg__ankle_roll" type="revolute">
    <origin xyz="0 0 0" rpy="0 0 0" />
    <parent link="R_ankle_pitch_link" />
    <child link="R_foot_link" />
    <axis xyz="-1 0 0" />
    <limit lower="-0.3490658503988659" upper="0.3490658503988659" effort="50" velocity="20" />
  </joint>
  <joint name="left_leg__hip_pitch" type="revolute">
    <origin xyz="0 0.1237 0" rpy="0 0 0" />
    <parent link="base_link" />
    <child link="L_hip_pitch_link" />
    <axis xyz="0 -1 0" />
    <limit lower="-0.4363323129985824" upper="2.0943951023931953" effort="120" velocity="20" />
    <dynamics damping="0.0275" friction="0.519" />
  </joint>
  <joint name="left_leg__hip_roll" type="revolute">
    <origin xyz="0 0 0" rpy="0 0 0" />
    <parent link="L_hip_pitch_link" />
    <child link="L_hip_roll_link" />
    <axis xyz="-1 0 0" />
    <limit lower="-1.4835298641951802" upper="0.4363323129985824" effort="120" velocity="20" />
    <dynamics damping="0.0275" friction="0.519" />
  </joint>
  <joint name="left_leg__hip_yaw" type="revolute">
    <origin xyz="0 0 0" rpy="0 0 0" />
    <parent link="L_hip_roll_link" />
    <child link="L_thigh_link" />
    <axis xyz="0 0 1" />
    <limit lower="-0.7853981633974483" upper="0.7853981633974483" effort="60" velocity="20" />
    <dynamics damping="0.0252" friction="0.251" />
  </joint>
  <joint name="left_leg__knee" type="revolute">
    <origin xyz="-0.045 0 -0.37" rpy="0 0 0" />
    <parent link="L_thigh_link" />
    <child link="L_shin_link" />
    <axis xyz="0 -1 0" />
    <limit lower="-2.0943951023931953" upper="0.0" effort="120" velocity="20" />
    <dynamics damping="0.0275" friction="0.519" />
  </joint>
  <joint name="left_leg__ankle_pitch" type="revolute">
    <origin xyz="-0.03 0 -0.49" rpy="0 0 0" />
    <parent link="L_shin_link" />
    <child link="L_ankle_pitch_link" />
    <axis xyz="0 -1 0" />
    <limit lower="-0.8726646259971648" upper="0.5235987755982988" effort="90" velocity="20" />
  </joint>
  <joint name="left_leg__ankle_roll" type="revolute">
    <origin xyz="0 0 0" rpy="0 0 0" />
    <parent link="L_ankle_pitch_link" />
    <child link="L_foot_link" />
    <axis xyz="1 0 0" />
    <limit lower="-0.3490658503988659" upper="0.3490658503988659" effort="50" velocity="20" />
  </joint>
  <link name="R_crank_A">
    <inertial>
      <origin xyz="-0.0198018 0.0360067 -0.0062147" rpy="0 0 0" />
      <mass value="0.034678" />
      <inertia ixx="7.59307e-06" ixy="1.99617e-06" ixz="-3.64097e-06" iyy="1.97976e-05" iyz="6.55228e-07" izz="1.66148e-05" />
    </inertial>
    <visual>
      <geometry>
        <mesh filename="package://huphy_ros/meshes/crank_A.stl" />
      </geometry>
    </visual>
  </link>
  <link name="R_rod_A_u">
    <inertial>
      <origin xyz="0 0 0" rpy="0 0 0" />
      <mass value="0.001" />
      <inertia ixx="1e-07" ixy="0" ixz="0" iyy="1e-07" iyz="0" izz="1e-07" />
    </inertial>
  </link>
  <link name="R_rod_A">
    <inertial>
      <origin xyz="0.00548356 0.00130335 -0.144762" rpy="0 0 0" />
      <mass value="0.080611" />
      <inertia ixx="0.00100139" ixy="-3.27114e-07" ixz="3.79761e-05" iyy="0.00100427" iyz="9.05816e-06" izz="3.7271e-06" />
    </inertial>
    <visual>
      <geometry>
        <mesh filename="package://huphy_ros/meshes/rod_A.stl" />
      </geometry>
    </visual>
  </link>
  <link name="R_crank_B">
    <inertial>
      <origin xyz="-0.0191695 -0.0360218 -0.00484967" rpy="0 0 0" />
      <mass value="0.033884" />
      <inertia ixx="6.87121e-06" ixy="-1.92757e-06" ixz="-2.43116e-06" iyy="1.8195e-05" iyz="-4.59121e-07" izz="1.5733e-05" />
    </inertial>
    <visual>
      <geometry>
        <mesh filename="package://huphy_ros/meshes/crank_B.stl" />
      </geometry>
    </visual>
  </link>
  <link name="R_rod_B_u">
    <inertial>
      <origin xyz="0 0 0" rpy="0 0 0" />
      <mass value="0.001" />
      <inertia ixx="1e-07" ixy="0" ixz="0" iyy="1e-07" iyz="0" izz="1e-07" />
    </inertial>
  </link>
  <link name="R_rod_B">
    <inertial>
      <origin xyz="0.00482552 -0.00130776 -0.0979551" rpy="0 0 0" />
      <mass value="0.067401" />
      <inertia ixx="0.000417838" ixy="3.10384e-07" ixz="2.06779e-05" iyy="0.000420171" iyz="-5.43715e-06" izz="3.00405e-06" />
    </inertial>
    <visual>
      <geometry>
        <mesh filename="package://huphy_ros/meshes/rod_B.stl" />
      </geometry>
    </visual>
  </link>
  <joint name="right_leg__ankle_a" type="revolute">
    <origin xyz="-0.029945 -0.001718 -0.190034" rpy="0 0 0" />
    <parent link="R_shin_link" />
    <child link="R_crank_A" />
    <axis xyz="-0.0000 -1.0000 -0.0000" />
    <limit lower="-1.2" upper="1.2" effort="60.0" velocity="20" />
    <dynamics damping="0.0252" friction="0.251" />
  </joint>
  <joint name="R_rod_A_u1" type="revolute">
    <origin xyz="-0.061494 0.042718 -0.021185" rpy="0 0 0" />
    <parent link="R_crank_A" />
    <child link="R_rod_A_u" />
    <axis xyz="-0.0000 -1.0000 -0.0000" />
    <limit lower="-3.1416" upper="3.1416" effort="0" velocity="50" />
  </joint>
  <joint name="R_rod_A_u2" type="revolute">
    <origin xyz="0 0 0" rpy="0 0 0" />
    <parent link="R_rod_A_u" />
    <child link="R_rod_A" />
    <axis xyz="0.9993 -0.0000 0.0379" />
    <limit lower="-3.1416" upper="3.1416" effort="0" velocity="50" />
  </joint>
  <joint name="right_leg__ankle_b" type="revolute">
    <origin xyz="-0.030055 0.001717 -0.290034" rpy="0 0 0" />
    <parent link="R_shin_link" />
    <child link="R_crank_B" />
    <axis xyz="0.0000 1.0000 0.0000" />
    <limit lower="-1.2" upper="1.2" effort="60.0" velocity="20" />
    <dynamics damping="0.0252" friction="0.251" />
  </joint>
  <joint name="R_rod_B_u1" type="revolute">
    <origin xyz="-0.060039 -0.042717 -0.01522" rpy="0 0 0" />
    <parent link="R_crank_B" />
    <child link="R_rod_B_u" />
    <axis xyz="0.0000 1.0000 0.0000" />
    <limit lower="-3.1416" upper="3.1416" effort="0" velocity="50" />
  </joint>
  <joint name="R_rod_B_u2" type="revolute">
    <origin xyz="0 0 0" rpy="0 0 0" />
    <parent link="R_rod_B_u" />
    <child link="R_rod_B" />
    <axis xyz="-0.9988 0.0000 -0.0492" />
    <limit lower="-3.1416" upper="3.1416" effort="0" velocity="50" />
  </joint>
  <link name="L_crank_A">
    <inertial>
      <origin xyz="-0.0198018 -0.0360067 -0.0062147" rpy="0 0 0" />
      <mass value="0.034678" />
      <inertia ixx="7.59307e-06" ixy="-1.99617e-06" ixz="-3.64097e-06" iyy="1.97976e-05" iyz="-6.55228e-07" izz="1.66148e-05" />
    </inertial>
    <visual>
      <geometry>
        <mesh filename="package://huphy_ros/meshes/R_crank_A.stl" />
      </geometry>
    </visual>
  </link>
  <link name="L_rod_A_u">
    <inertial>
      <origin xyz="0 0 0" rpy="0 0 0" />
      <mass value="0.001" />
      <inertia ixx="1e-07" ixy="0" ixz="0" iyy="1e-07" iyz="0" izz="1e-07" />
    </inertial>
  </link>
  <link name="L_rod_A">
    <inertial>
      <origin xyz="0.00548356 -0.00130335 -0.144762" rpy="0 0 0" />
      <mass value="0.080611" />
      <inertia ixx="0.00100139" ixy="3.27114e-07" ixz="3.79761e-05" iyy="0.00100427" iyz="-9.05816e-06" izz="3.7271e-06" />
    </inertial>
    <visual>
      <geometry>
        <mesh filename="package://huphy_ros/meshes/R_rod_A.stl" />
      </geometry>
    </visual>
  </link>
  <link name="L_crank_B">
    <inertial>
      <origin xyz="-0.0191695 0.0360218 -0.00484967" rpy="0 0 0" />
      <mass value="0.033884" />
      <inertia ixx="6.87121e-06" ixy="1.92757e-06" ixz="-2.43116e-06" iyy="1.8195e-05" iyz="4.59121e-07" izz="1.5733e-05" />
    </inertial>
    <visual>
      <geometry>
        <mesh filename="package://huphy_ros/meshes/R_crank_B.stl" />
      </geometry>
    </visual>
  </link>
  <link name="L_rod_B_u">
    <inertial>
      <origin xyz="0 0 0" rpy="0 0 0" />
      <mass value="0.001" />
      <inertia ixx="1e-07" ixy="0" ixz="0" iyy="1e-07" iyz="0" izz="1e-07" />
    </inertial>
  </link>
  <link name="L_rod_B">
    <inertial>
      <origin xyz="0.00482552 0.00130776 -0.0979551" rpy="0 0 0" />
      <mass value="0.067401" />
      <inertia ixx="0.000417838" ixy="-3.10384e-07" ixz="2.06779e-05" iyy="0.000420171" iyz="5.43715e-06" izz="3.00405e-06" />
    </inertial>
    <visual>
      <geometry>
        <mesh filename="package://huphy_ros/meshes/R_rod_B.stl" />
      </geometry>
    </visual>
  </link>
  <joint name="left_leg__ankle_a" type="revolute">
    <origin xyz="-0.029945 0.001718 -0.190034" rpy="0 0 0" />
    <parent link="L_shin_link" />
    <child link="L_crank_A" />
    <axis xyz="0.0000 1.0000 0.0000" />
    <limit lower="-1.2" upper="1.2" effort="60.0" velocity="20" />
    <dynamics damping="0.0252" friction="0.251" />
  </joint>
  <joint name="L_rod_A_u1" type="revolute">
    <origin xyz="-0.061494 -0.042718 -0.021185" rpy="0 0 0" />
    <parent link="L_crank_A" />
    <child link="L_rod_A_u" />
    <axis xyz="0.0000 1.0000 0.0000" />
    <limit lower="-3.1416" upper="3.1416" effort="0" velocity="50" />
  </joint>
  <joint name="L_rod_A_u2" type="revolute">
    <origin xyz="0 0 0" rpy="0 0 0" />
    <parent link="L_rod_A_u" />
    <child link="L_rod_A" />
    <axis xyz="-0.9993 0.0000 -0.0379" />
    <limit lower="-3.1416" upper="3.1416" effort="0" velocity="50" />
  </joint>
  <joint name="left_leg__ankle_b" type="revolute">
    <origin xyz="-0.030055 -0.001717 -0.290034" rpy="0 0 0" />
    <parent link="L_shin_link" />
    <child link="L_crank_B" />
    <axis xyz="-0.0000 -1.0000 -0.0000" />
    <limit lower="-1.2" upper="1.2" effort="60.0" velocity="20" />
    <dynamics damping="0.0252" friction="0.251" />
  </joint>
  <joint name="L_rod_B_u1" type="revolute">
    <origin xyz="-0.060039 0.042717 -0.01522" rpy="0 0 0" />
    <parent link="L_crank_B" />
    <child link="L_rod_B_u" />
    <axis xyz="-0.0000 -1.0000 -0.0000" />
    <limit lower="-3.1416" upper="3.1416" effort="0" velocity="50" />
  </joint>
  <joint name="L_rod_B_u2" type="revolute">
    <origin xyz="0 0 0" rpy="0 0 0" />
    <parent link="L_rod_B_u" />
    <child link="L_rod_B" />
    <axis xyz="0.9988 -0.0000 0.0492" />
    <limit lower="-3.1416" upper="3.1416" effort="0" velocity="50" />
  </joint>
  <link name="R_rod_A_end" />
  <joint name="R_rod_A_end_site" type="fixed">
    <parent link="R_rod_A" />
    <child link="R_rod_A_end" />
    <origin xyz="0.010939 0.0026 -0.288781" rpy="0 0 0" />
  </joint>
  <link name="R_rod_B_end" />
  <joint name="R_rod_B_end_site" type="fixed">
    <parent link="R_rod_B" />
    <child link="R_rod_B_end" />
    <origin xyz="0.009594 -0.0026 -0.194746" rpy="0 0 0" />
  </joint>
  <link name="R_ball_A" />
  <joint name="R_ball_A_site" type="fixed">
    <parent link="R_foot_link" />
    <child link="R_ball_A" />
    <origin xyz="-0.0505 0.0436 -0.01" rpy="0 0 0" />
  </joint>
  <link name="R_ball_B" />
  <joint name="R_ball_B_site" type="fixed">
    <parent link="R_foot_link" />
    <child link="R_ball_B" />
    <origin xyz="-0.0505 -0.0436 -0.01" rpy="0 0 0" />
  </joint>
  <link name="L_rod_A_end" />
  <joint name="L_rod_A_end_site" type="fixed">
    <parent link="L_rod_A" />
    <child link="L_rod_A_end" />
    <origin xyz="0.010939 -0.0026 -0.288781" rpy="0 0 0" />
  </joint>
  <link name="L_rod_B_end" />
  <joint name="L_rod_B_end_site" type="fixed">
    <parent link="L_rod_B" />
    <child link="L_rod_B_end" />
    <origin xyz="0.009594 0.0026 -0.194746" rpy="0 0 0" />
  </joint>
  <link name="L_ball_A" />
  <joint name="L_ball_A_site" type="fixed">
    <parent link="L_foot_link" />
    <child link="L_ball_A" />
    <origin xyz="-0.0505 -0.0436 -0.01" rpy="0 0 0" />
  </joint>
  <link name="L_ball_B" />
  <joint name="L_ball_B_site" type="fixed">
    <parent link="L_foot_link" />
    <child link="L_ball_B" />
    <origin xyz="-0.0505 0.0436 -0.01" rpy="0 0 0" />
  </joint>
</robot>
