Human-Pygmalion/HUPHY/config/robot_bench.yaml

# 벤치 구성 — 모터 두 대짜리 왼다리. **robot_v1.0.yaml 의 벤치판임.**
#
# 실물은 knee(RS04, id 4)와 ankle_a(RS03, id 5) 둘뿐이고 나머지 넷은 아직 없음.
# 그래도 여섯을 다 적는 이유: `robots/leg.py` 의 REQUIRED_MOTORS 가 여섯을 요구함.
# 빠뜨리면 "다리에 필요한 모터가 없음" 으로 조립 자체가 안 됨. 없는 넷은 응답이
# 없을 뿐이고, 그 사실은 텔레메트리의 ack/miss 에 그대로 드러남 -- 숨기지 않음.
#
# v1.0 과 다른 곳은 네 군데뿐임. 그 외 값(모터 id·모델·게인)은 v1.0 그대로라
# 벤치에서 맞춘 것이 실물에 그대로 올라감.
#
#   1. left_leg 만 있음        양다리 설정이면 build_biped 가 없는 다리까지 세움
#   2. channel/interface       벤치는 CANable(slcan)을 slcand 로 can0 에 올려 씀
#   3. link_loss_cycles: 0     없는 모터 넷이 매 주기 응답을 빠뜨림. 5 로 두면
#                              통신 끊김으로 판정해 곧바로 로봇을 세움 (control/loop.py)
#   4. enforce_limits: false   calibration/left_leg_v1.0.json 이 아직 실측 전이라
#                              limits_deg 가 전부 null 임. 커미셔닝(sweep+zero)을
#                              마치면 이 줄을 지우고 v1.0 과 같은 true 로 돌릴 것
#
# 각도는 전부 cal 공간임 -- 관절 각도이지 모터가 보고하는 raw 값이 아님.
name: huphy_bench
safety:
  command_margin_deg: 3.0

  # ===== 2026-09-08: 속도 제한을 max_delta_deg 에서 max_vel_deg_s 로 옮김 =====
  #
  # max_delta_deg 로 속도를 제한하던 것을 그만둔다. 그것은 속도가 아니라 **힘**을 자른다.
  # 기준점이 측정 위치라서 명령과 현재각의 차이가 그 값으로 묶이고, 모터 펌웨어 식이
  # tau = kp*(명령각 - 현재각) + ... 이므로 힘이 함께 묶인다. 3도 x kp 30 = 1.57 N*m.
  # 게다가 스스로를 조인다: 모터가 뒤처지면 측정이 안 나아가고 -> 명령도 안 나아가고
  # -> 오차가 안 쌓이고 -> 힘이 안 커진다. 이론 초당 300도 설정에서 실측 초당 49도가
  # 나온 이유다. (옛 주석이 인용하던 "클리핑 = 속도 제한이다" 는 반증되어 정정됨.)
  #
  # max_delta_deg 는 원래 설계 의도인 **폭주 상한**으로 되돌린다. 라이브러리 기본값은
  # 50.0 이지만 벤치 첫 운전이라 15.0 에서 시작한다: 힘 상한이 kp 30 에서 7.85 N*m 로,
  # 지금의 1.57 N*m 에서 다섯 배지만 기본값 50.0(26.2 N*m)까지 한 번에 가지는 않는다.
  max_delta_deg: 40

  # 진짜 속도 제한. 직전 **명령**에서 한 주기에 max_vel_deg_s / control_hz 만큼만 나아간다
  # (safety.guards.clamp_rate). 명령이 모터와 무관하게 보장된 속도로 나아가므로 오차가
  # 자유롭게 커지고, 따라잡을 힘을 온전히 쓴다.
  #
  # 데이터시트(RS03/RS04 매뉴얼, 출력단): 무부하 200 rpm = 초당 1200도,
  # 정격 RS03 180 rpm = 초당 1080도 / RS04 167 rpm = 초당 1002도. 기준은 정격이어야 한다
  # (무부하는 힘을 전혀 안 낼 때만 나오는 값).
  #
  # 30.0 은 RS04 정격의 3.0% 다. 낮게 시작하는 이유: 옛 방식의 실측이 초당 49도였던 것은
  # 힘이 잘려서지 그 속도를 의도해서가 아니고, 새 구조에서는 적은 값이 **정말로 그 속도로**
  # 나온다. 재 보고 올린다.
  # 2026-09-08: 데이터시트 정격에 맞춤. 이제 이 관문은 사실상 안 걸리고, 실제 상한은
  # 힘(max_delta_deg x kp)과 마찰이 정한다 - 실측 약 235 도/s (max_delta 40, kp 30).
  # 출력단 정격: RS03 180 rpm = 1080 도/s · RS04 167 rpm = 1002 도/s (매뉴얼 1항).
  # 공차 -10% 를 반영해 보수적으로 적는다: 1080*0.9 = 972, 1002*0.9 = 902.
  max_vel_deg_s: 902.0
  max_vel_deg_s_by_motor:
    hip_yaw: 972.0    # RS03
    knee: 902.0       # RS04
    hip_pitch: 902.0  # RS04
    hip_roll: 972.0   # RS03
    ankle_a: 972.0    # RS00 은 별도 확인 전이라 보수적으로 RS03 값을 씀
    ankle_b: 972.0
  enforce_limits: false     # 커미셔닝 전용. 실측 끝나면 true 로
  link_loss_cycles: 0       # 없는 모터 넷 때문에 켜 두면 즉시 정지함
telemetry:
  host: 192.168.20.177      # pygviewer 브리지가 받는 주소
  port: 9870
  csv_path: null
  csv_flush_every: 50
imus:
  # 2026-09-06: 벤치에 EBIMU 한 개 물림. 읽기만 해서 확인한 값 (huphy-imu apply 안 돌림 --
  # apply 는 센서 비휘발성 메모리를 바꾸고 전원을 껐다 켜도 남음):
  #
  #   초당 100줄, 줄당 15개 항목  = quat 4 + gyro 3 + accel 3 + dist 3 + temp 1 + time 1
  #   사원수 크기 1.000        -> 자세 정상
  #   가속도 크기 1.001 g      -> 중력 포함이 맞음 (accel_mode: gravity)
  #   가만히 둔 상태 각속도 0.00 -> 영점 정상
  #
  # 즉 센서가 이미 아래 output 그대로 보내고 있어 apply 가 필요 없음.
  main:
    model: ebimu
    # udev 심볼릭 링크(/dev/ebimu)는 이 컴퓨터에 아직 없음. by-id 경로는 USB 포트를 바꿔
    # 꽂아도 같은 이름이라 ttyUSB 번호보다 안전함 -- ttyUSB 번호는 꽂는 순서대로 붙음.
    port: /dev/serial/by-id/usb-Silicon_Labs_CP2102_USB_to_UART_Bridge_Controller_0001-if00-port0
    # 다리가 아직 없어 책상에 놓여 있음. 다리에 붙이면 이 한 줄만 바꾸면 됨.
    mount: left_leg
    output: [quat, gyro, accel, dist, temp, time]
    accel_mode: gravity
    dist_mode: local
    rate_hz: 100
limbs:
  left_leg:
    kind: leg
    side: left
    channel: can0           # sudo slcand -o -c -s8 /dev/ttyACM0 can0 && sudo ip link set can0 up
    interface: socketcan
    control_hz: 100.0
    calibration: calibration/left_leg_v1.0.json
    motors:
      hip_pitch: {id: 1,  model: RS04, kp: 10.0, kd: 1.0}   # 없음
      hip_roll:  {id: 2,  model: RS04, kp: 10.0, kd: 1.0}   # 없음
      hip_yaw:   {id: 3,  model: RS03, kp: 10.0, kd: 1.0}   # 없음
      knee:      {id: 4,  model: RS04, kp: 10.0, kd: 1.0}   # 실물 (2026-09-04 육안 확인)
      ankle_a:   {id: 5,  model: RS03, kp: 10.0, kd: 1.0}   # 실물 (2026-09-04 육안 확인)
      ankle_b:   {id: 6,  model: RS03, kp: 10.0, kd: 1.0}   # 없음
