Human-Pygmalion/HUPHY/src/huphy/scripts/selftest.py

"""동작 확인 — 다리를 정해진 패턴으로 계속 움직여 봄.

    huphy-test --limb right_leg zero
    huphy-test --limb right_leg range
    huphy-test --robot zero             로봇 전체를 같은 루프로
    huphy-test --robot pose 0 10 0 30 0 0  0 10 0 30 0 0
    huphy-test --robot watch            토크 없이 손으로 움직이는 것을 봄

네 가지임.

    zero     관절 전부를 0도로 두고 붙잡음
    range    관절마다 최소~최대를 오감
    pose     준 각도로 옮기고 붙잡음. 발목은 기본이 모터각(ankle_a/ankle_b)
    watch    **토크를 끄고** 위치만 읽음. 사람이 손으로 움직이는 것을 보고 녹화함

넷 다 **Ctrl-Q 를 누를 때까지** 계속함. 앞의 셋은 끝나면 자세를 붙잡은 채로 토크를
끊음. `watch` 는 처음부터 끝까지 토크가 없음.


## watch -- 손으로 움직이는 것을 기록

제어 루프를 관찰 모드(`Mode.OBSERVE`)로 돌림. 들어갈 때 토크를 끊고, 힘이 0인 명령
(kp = kd = 토크 = 0)을 보내 그 응답으로 위치를 받음 -- MIT 모드에는 읽기 전용 명령이
없음. 목표가 없으므로 기록에는 실측(`pos/`)과 IMU 만 있음.

실시간 뷰어(`--live`)가 **기본으로 켜짐** -- 화면 없이 할 일이 없어서임. 화면의
녹화 버튼으로 원하는 구간만 `logs/track/<월일>_track_live_watch.json` 으로 남김.
`--log` 을 같이 주면 실행 전체도 `logs/track/<월일>_track_watch.json` 으로 남김.


## 무엇을 보는 것인가

`zero` 는 **자세가 유지되는가**를 봄. 처지면 게인이 부족하고, 부르르 떨면 과함.
관절 전부가 0도이므로 눈으로 봐도 어긋난 관절이 바로 보임.

`range` 는 **끝까지 가는가**를 봄. 설정한 한계까지 실제로 도달하는지, 도중에
걸리는 데가 없는지, 양 끝에서 부딪히는 소리가 나지 않는지.


## 시작할 때 반드시 천천히 감

지금 자세가 어디든 목표까지 **`--approach` 초에 걸쳐** 옮긴 뒤에 패턴을 시작함.
토크를 넣는 순간 목표가 멀리 있으면 관절이 튐 — 점프 가드가 자르기는 하지만 그
전에 큰 토크가 한 번 나감.


## 한계에서 여유를 둠

`range` 는 설정한 한계에서 `--margin` 만큼 안쪽까지만 감. 한계는 하드스톱을 재서
넣은 값이라 그대로 명령하면 스톱에 부딪힘.


## 무엇을 조종할지 — `--limb` 과 `--robot`

    --limb right_leg     다리 하나 (Leg)
    --robot              로봇 전체 (Biped). kind: leg 인 팔다리를 전부

**플래그가 곧 만들어지는 객체임.** `--limb` 은 예전부터 "팔다리가 여럿이라
헷갈리니 하나를 짚어라" 는 뜻이고, 로봇 전체는 그것과 다른 층의 선택이라 플래그를
따로 둠.

`--robot` 이면 관절 이름 앞에 팔다리가 붙음 (`right_leg/knee`). 다리 하나면
안 붙음 -- 구분할 대상이 없는데 화면과 명령만 달라짐.

드물게 일부만 묶고 싶으면 `--limb left_leg,right_leg` 처럼 나열할 수 있음.

프로세스를 둘 띄우는 것과 다름 -- 명령이 같은 주기에 나가고, 한쪽 통신이 끊기면
**양쪽이 같이** 멈춤. 따로 띄우면 한쪽이 죽어도 다른 쪽은 계속 움직여 넘어짐.

`zero` 를 양다리로 돌리는 것이 조립을 확인하는 첫 단계임 — 관절 전부가 0도이므로
좌우가 어긋난 것이 눈으로 보임.
"""

from __future__ import annotations

import argparse
import logging
import math
import os
import select
import sys
import termios
import threading
import tty
from pathlib import Path
from typing import Any, Dict, List, Optional, Tuple

from ..config import ConfigError, LimbConfig, load_robot
from ..control import ControlLoop, Mode, motions, policy
from ..control.studio import Studio
from ..robots.biped import join_name
from ..telemetry import latency_log, live, run_name, track_log
from ..robots.leg import (
    ANKLE_JOINTS,
    ANKLE_MOTORS,
    ANKLE_SPACE_MOTOR,
    SEND_BURST,
    SEND_MODES,
    SINGLE_JOINTS,
    HostIdError,
    Leg,
)
from .bringup import build_biped, build_leg
from . import failures, table
from ..motors.canbus import DEFAULT_DRAIN_S, bring_up_hint
from .commission import CONFIG_NAME, _find_config, _pick_limbs, all_legs

logger = logging.getLogger("huphy.selftest")

QUIT_KEY = "\x11"
"""Ctrl-Q. 터미널이 흘려보내는 문자라 raw 모드에서만 읽힘."""

LOG_SKIP_S = 2.0
EXTRA_DEFAULT = 2
"""`--extra` 를 줬을 때 다리당 한 주기 읽기 수 (`huphy-run` 과 같음)."""
"""`--log-skip` 기본값. 연결 직후 첫 주기들은 수신 스레드·USB 가 막 돌기 시작해 느림."""

DEFAULT_APPROACH_S = 3.0
DEFAULT_MARGIN_DEG = 5.0
DEFAULT_PERIOD_S = 6.0


# ===========================================================================
# 팔다리 여럿
# ===========================================================================
def parts(robot) -> Tuple[Any, ...]:
    """다리들. 합성 로봇이면 그 팔다리, 아니면 자기 자신 하나."""
    return tuple(getattr(robot, "parts", ())) or (robot,)


def named(robot, part, name: str) -> str:
    """관절 이름. 합성 로봇이면 앞에 팔다리를 붙임.

    다리 하나면 붙이지 않음 -- 붙이면 화면과 명령이 지금과 달라지는데, 구분할
    대상이 없어 얻는 것이 없음.
    """
    return join_name(part.id, name) if getattr(robot, "parts", None) else name


# ===========================================================================
# 관절 한계
# ===========================================================================
def joint_limits(robot) -> Dict[str, Tuple[float, float]]:
    """관절 이름 -> (최소, 최대). 관절 좌표계임.

    출처가 둘임.

        hip_pitch hip_roll hip_yaw knee     robot.yaml 의 limits_deg. 모터와 관절이 1:1 임
        ankle_pitch ankle_roll  AnkleEnvelope. 모터 한계가 아니라 시험 범위임

    발목은 모터 두 개가 로드로 물려 있어 **모터 한계를 관절 한계로 옮길 수 없음.**
    한 모터의 최대각이 다른 모터의 자세에 따라 달라짐. 그래서 발목만 기구학 쪽의
    시험 범위를 씀.

    한계가 없는 관절은 빠짐 -- 아직 안 잰 것이라 어디까지 가도 되는지 모름.

    팔다리가 여럿이면 이름 앞에 팔다리가 붙음. **다리마다 한계가 다름** -- 좌우가
    거울상이라도 실측값이라 같지 않음.
    """
    out: Dict[str, Tuple[float, float]] = {}
    for part in parts(robot):
        for name in SINGLE_JOINTS:
            limits = part.config.motors[name].limits_deg
            if limits is not None:
                out[named(robot, part, name)] = (float(limits[0]), float(limits[1]))

        envelope = part.kinematics.envelope
        out[named(robot, part, "ankle_pitch")] = tuple(
            float(v) for v in envelope.pitch_deg
        )
        out[named(robot, part, "ankle_roll")] = tuple(
            float(v) for v in envelope.roll_deg
        )
    return out


def _inset(limits: Tuple[float, float], margin: float) -> Tuple[float, float]:
    """한계에서 안쪽으로 `margin` 만큼 들어옴.

    폭이 여유의 두 배도 안 되면 가운데로 접음 -- 좁은 관절에서 최소가 최대보다
    커지는 것을 막음.
    """
    lo, hi = limits
    if hi - lo <= 2.0 * margin:
        middle = 0.5 * (lo + hi)
        return (middle, middle)
    return (lo + margin, hi - margin)


# ===========================================================================
# 동작
# ===========================================================================
def approach(targets: Dict[str, float], start: Dict[str, float], seconds: float):
    """지금 자세에서 목표까지 관절 전부를 같이 옮김.

    `motions.ramp` 은 관절 하나짜리라 여기서 여러 관절을 함께 다룸. 시작값은
    루프를 돌리기 전에 읽어 둔 관찰임 -- 매 주기 다시 읽으면 목표가 따라 움직여
    영영 도착하지 않음.
    """
    if seconds <= 0:
        raise ValueError(f"seconds 는 0보다 커야 함 (받은 값 {seconds})")

    def motion(t: float, observation: Dict[str, Any]) -> Dict[str, float]:
        fraction = min(1.0, max(0.0, t / seconds))
        return {
            name: start.get(name, target) + (target - start.get(name, target)) * fraction
            for name, target in targets.items()
        }

    return motion


def cycle(limits: Dict[str, Tuple[float, float]], *, period_s: float):
    """관절마다 최소~최대를 오감. 전부 같은 위상으로 움직임.

    사인파를 씀 -- 삼각파는 양 끝에서 속도가 꺾이면서 점프 가드에 걸리고, 실제로도
    관절이 한 번 튐.

    시작이 가운데라 `approach` 가 데려다 놓은 자리에서 이어짐.
    """
    plan = {
        name: (0.5 * (lo + hi), 0.5 * (hi - lo)) for name, (lo, hi) in limits.items()
    }
    omega = 2.0 * math.pi / float(period_s)

    def motion(t: float, observation: Dict[str, Any]) -> Dict[str, float]:
        return {
            name: center + amplitude * math.sin(omega * t)
            for name, (center, amplitude) in plan.items()
        }

    return motion


def midpoints(limits: Dict[str, Tuple[float, float]]) -> Dict[str, float]:
    return {name: 0.5 * (lo + hi) for name, (lo, hi) in limits.items()}


def then(first, seconds: float, second):
    """`first` 를 `seconds` 만큼 돌린 뒤 `second` 로 넘어감. 뒤는 끝이 없음.

    `motions.chain` 은 구간마다 길이를 받고 마지막이 끝나면 명령을 멈춤. 여기는
    Ctrl-Q 까지 계속해야 해서 뒤 구간에 길이를 두지 않음.

    `second` 는 **자기 구간의 0초부터** 시작하는 시간을 받음 -- 사인파가 가운데에서
    시작해야 접근이 데려다 놓은 자리와 이어짐.
    """

    def motion(t: float, observation: Dict[str, Any]):
        if t < seconds:
            return first(t, observation)
        return second(t - seconds, observation)

    return motion


# ===========================================================================
# Ctrl-Q
# ===========================================================================
class QuitWatcher:
    """Ctrl-Q 가 눌리면 루프를 멈춤.

    별도 스레드에서 키를 봄 -- 루프는 주기를 지켜야 해서 입력을 기다릴 틈이 없음.
    `loop.stop()` 은 다음 주기에 빠져나오게만 하므로 스레드에서 불러도 됨.

    **터미널 설정을 두 군데 바꿈.** 빠져나올 때 원래 설정으로 되돌림.

    | 무엇을 | 어디를 | 왜 |
    |---|---|---|
    | `ICANON`·`ECHO` 끔 | `tty.setcbreak` 가 `LFLAG` 를 만짐 | 엔터 없이 한 글자씩 읽고, 누른 키가 화면에 안 찍히게 함 |
    | `IXON` 끔 | 여기서 `IFLAG` 를 만짐 | Ctrl-Q 는 XON(흐름 제어)이라 켜져 있으면 tty 드라이버가 먹고 프로그램까지 안 옴 |

    `tty.setcbreak` 는 `LFLAG` 만 건드리므로 `IXON` 을 따로 꺼야 함. 안 그러면
    Ctrl-Q 를 눌러도 아무 일도 일어나지 않음.

    화면이 아니면 아무것도 하지 않음 -- 그때는 Ctrl-C 로 끊음.
    """

    def __init__(self, loop: ControlLoop) -> None:
        self.loop = loop
        self.armed = sys.stdin.isatty()
        self._saved = None
        self._thread: Optional[threading.Thread] = None
        self._done = threading.Event()

    def __enter__(self) -> "QuitWatcher":
        if not self.armed:
            return self
        fd = sys.stdin.fileno()
        self._saved = termios.tcgetattr(fd)
        tty.setcbreak(fd)
        # setcbreak 는 LFLAG 만 만짐. IXON 이 남아 있으면 Ctrl-Q(0x11) 를 tty
        # 드라이버가 XON 으로 먹어 read 까지 오지 않음.
        mode = termios.tcgetattr(fd)
        mode[0] &= ~termios.IXON  # mode[0] 이 IFLAG
        termios.tcsetattr(fd, termios.TCSANOW, mode)
        self._thread = threading.Thread(target=self._watch, daemon=True)
        self._thread.start()
        return self

    def __exit__(self, *exc) -> None:
        self._done.set()
        if self._thread is not None:
            self._thread.join(timeout=1.0)
        if self._saved is not None:
            termios.tcsetattr(sys.stdin.fileno(), termios.TCSADRAIN, self._saved)
        return None

    def _watch(self) -> None:
        while not self._done.is_set():
            ready, _, _ = select.select([sys.stdin], [], [], 0.1)
            if not ready:
                continue
            # 와 있는 것을 한 번에 다 읽음. `sys.stdin.read(1)` 은 파이썬 버퍼에 나머지를
            # 쌓아 두는데 select 는 그 버퍼를 못 봐서, 빨리 누른 두 번째 키부터 다음
            # 키를 누를 때까지 처리되지 않았음.
            data = os.read(sys.stdin.fileno(), 64).decode(errors="ignore")
            for key in data:
                if key == QUIT_KEY:
                    logger.info("Ctrl-Q -- 멈춤")
                    self.loop.stop()
                    return
                self.on_key(key)

    def on_key(self, key: str) -> None:
        """Ctrl-Q 말고 다른 키. 여기서는 버림 -- 이어받는 쪽(`run.EnterWatcher`)이 씀."""


# ===========================================================================
# 명령
# ===========================================================================
def _read_pose(robot, loop: ControlLoop, joints) -> Dict[str, float]:
    """지금 관절 각도를 읽음. 루프를 한 주기 돌려 상태를 받아 옴.

    MIT 모드에는 읽기 전용 명령이 없어서, 힘이 나가지 않는 명령을 보내고 그 응답을
    받는 것임.

    관찰은 **모터 공간**임 (`knee.pos`, `ankle_a.pos`). 모터 이름은 관찰에서 그대로
    읽음.

    발판 자세(`ankle_pitch`/`ankle_roll`)만 FK 를 따로 부름. 관찰에도 있지만 그쪽은
    **못 풀었을 때 마지막으로 알려진 자세를 냄** -- 읽은 값과 옛 값이 구분되지 않음.
    `ankle_pose()` 는 못 풀면 `None` 을 내므로 "못 읽었다" 가 드러남.
    """
    loop.step(None, t=0.0)
    observation = robot.get_observation()

    out: Dict[str, float] = {}
    for part in parts(robot):
        for name in list(SINGLE_JOINTS) + list(ANKLE_MOTORS):
            key = named(robot, part, name)
            if key not in joints:
                continue
            value = observation.get(f"{key}.pos")
            if value is not None:
                out[key] = float(value)

        wanted = [named(robot, part, n) for n in ANKLE_JOINTS]
        if not any(k in joints for k in wanted):
            continue
        pose = part.ankle_pose()
        if pose is not None:
            for key, value in zip(wanted, pose):
                if key in joints:
                    out[key] = float(value)
    return out


def _run(
    robot, loop: ControlLoop, targets, motion, *, approach_s: float, watchers=(),
) -> int:
    """접근 -> 패턴. Ctrl-Q 까지 돎.

    `watchers` 는 `wrap_motion` 을 가진 관측기 (`--log` 의 추종 기록, `--live` 의
    실시간 뷰어). 매 주기 낸 목표와 받은 관찰을 봄 -- 목표를 바꾸지 않음.
    """
    start = _read_pose(robot, loop, targets)
    missing = [name for name in targets if name not in start]
    if missing:
        print(f"  상태를 못 읽은 관절: {missing}. 배선과 CAN id 를 확인할 것.")
        return 1

    print(f"  멈추려면 Ctrl-Q.\n")

    loop.mode = Mode.CONTROL
    plan = then(approach(targets, start, approach_s), approach_s, motion)
    for watcher in watchers:
        plan = watcher.wrap_motion(plan)

    with QuitWatcher(loop):
        stats = loop.run(plan)

    # 텔레메트리 없이도 이 주기로 몇 번 빠졌는지 보게 함 (scripts/failures.py).
    print("\n" + failures.report(robot, stats))
    if stats.link_loss is not None:
        # 정상 종료와 구분되어야 함 -- 둘 다 조용히 끝남.
        print(f"\n  ** 통신 두절로 멈춤: {stats.link_loss} **")
        print("  배선과 CAN id 를 확인할 것. 양다리면 둘 다 멈췄음.")
        return 1
    if not stats.kept_up:
        print("  주기를 못 지킴. 게인을 만지기 전에 이것부터 볼 것.")
        return 1
    return 0


def cmd_zero(args, robot, loop: ControlLoop) -> int:
    """관절 전부를 0도로 두고 붙잡음."""
    joints = [
        named(robot, part, name)
        for part in parts(robot)
        for name in list(SINGLE_JOINTS) + list(ANKLE_JOINTS)
    ]
    targets = {name: 0.0 for name in joints}

    print(f"\n{robot.id} 영자세 유지 -- {len(joints)}개 관절을 0도로")
    print("  관절 전부가 0도이므로 어긋난 관절이 눈으로 보임.")
    print("  처지면 kp 가 부족하고, 부르르 떨면 kp 가 과함.")
    if len(parts(robot)) > 1:
        print("  양다리를 같은 루프로 돌림 -- 좌우가 어긋난 것도 눈으로 보임.")
    print(f"\n  {args.approach:.0f}초에 걸쳐 0도로 옮긴 뒤 그대로 유지합니다.")

    return _run(
        robot, loop, targets, motions.hold(targets),
        approach_s=args.approach, watchers=getattr(args, "watchers", ()),
    )


def cmd_range(args, robot, loop: ControlLoop) -> int:
    """관절마다 최소~최대를 오감."""
    limits = joint_limits(robot)
    inset = {name: _inset(span, args.margin) for name, span in limits.items()}

    print(f"\n{robot.id} 가동 범위 왕복 -- 주기 {args.period:.1f}초")
    print(f"  한계에서 {args.margin:.1f}도 안쪽까지만 감.\n")
    print("  " + table.header(("관절", 12, "<"), ("최소", 9), ("최대", 9)))
    for name, (lo, hi) in inset.items():
        print(f"  {name:<12} {lo:9.2f} {hi:9.2f}")

    skipped = [
        named(robot, part, n)
        for part in parts(robot)
        for n in SINGLE_JOINTS
        if named(robot, part, n) not in limits
    ]
    if skipped:
        print(
            f"\n  한계가 없어 빼는 관절: {skipped}.\n"
            f"  huphy-commission --limb <팔다리> sweep 으로 먼저 잴 것."
        )

    flat = [name for name, (lo, hi) in inset.items() if hi - lo < 1.0]
    if flat:
        print(f"\n  움직일 폭이 없는 관절: {flat}. 한계가 좁거나 여유가 큼.")

    print(f"\n  {args.approach:.0f}초에 걸쳐 가운데로 옮긴 뒤 왕복을 시작합니다.")

    return _run(
        robot,
        loop,
        midpoints(inset),
        cycle(inset, period_s=args.period),
        approach_s=args.approach,
        watchers=getattr(args, "watchers", ()),
    )


def pose_joints(space: str) -> List[str]:
    """다리 하나의 이름 여섯. 발목만 공간에 따라 갈림.

        ab   hip_pitch hip_roll hip_yaw knee ankle_a     ankle_b      모터 각도
        rp   hip_pitch hip_roll hip_yaw knee ankle_pitch ankle_roll   발판 자세

    앞 네 개는 모터와 관절이 1:1 이라 어느 쪽이든 같음. 발목만 모터 두 개가 로드로
    발판 하나를 밀어서, `ab` 는 모터각을 그대로 주고 `rp` 는 두 값을 기구학에 같이
    넣어 모터각을 얻음.
    """
    ankle = ANKLE_MOTORS if space == ANKLE_SPACE_MOTOR else ANKLE_JOINTS
    return list(SINGLE_JOINTS) + list(ankle)


def pose_order(robot, space: str = ANKLE_SPACE_MOTOR) -> List[str]:
    """`pose` 에 숫자만 나열할 때의 순서.

        다리 하나    여섯 개 (`pose_joints`)
        로봇 전체    왼다리 6개 -> 오른다리 6개

    **양다리 모델의 출력 규격과 같은 순서임** (`policy.BIPED_LEGS`). 모델이 낼
    자세를 손으로 넣어 볼 때 순서를 따로 외울 필요가 없게 함. `robot.yaml` 의
    `limbs` 순서(지금 오른다리가 먼저)와는 무관함.

    규격에 없는 다리 이름은 뒤에 설정 순서대로 붙음.
    """
    def rank(part) -> int:
        legs = policy.BIPED_LEGS
        return legs.index(part.id) if part.id in legs else len(legs)

    ordered = sorted(parts(robot), key=rank)
    return [
        named(robot, part, joint)
        for part in ordered
        for joint in pose_joints(space)
    ]


def pose_limits(robot, space: str) -> Dict[str, Tuple[float, float]]:
    """`pose` 가 화면에 찍는 한계. **공간마다 출처가 다름.**

        ab   캘리브레이션 실측값. 여섯 개 다 같은 출처임
        rp   네 관절은 실측값, 발목 두 축은 AnkleEnvelope 의 시험 범위

    발목을 `rp` 로 줄 때 실측값을 못 쓰는 이유: 모터 두 개가 물려 있어 **한 모터의
    최대각이 다른 모터의 자세에 따라 달라짐.** 모터 한계를 관절 한계로 옮길 수 없음.

    한계가 없는 것은 빠짐 -- 아직 안 잰 것임.
    """
    if space != ANKLE_SPACE_MOTOR:
        return joint_limits(robot)

    out: Dict[str, Tuple[float, float]] = {}
    for part in parts(robot):
        for name in pose_joints(space):
            limits = part.config.motors[name].limits_deg
            if limits is not None:
                out[named(robot, part, name)] = (float(limits[0]), float(limits[1]))
    return out


def parse_pose(tokens, order) -> Dict[str, float]:
    """`pose` 인자를 관절 목표로. 두 방식 중 하나만 받음.

        숫자만        정확히 len(order) 개. order 순서대로
        이름=값       준 관절만 그 값, 나머지는 0

    **섞으면 거부함.** 숫자 몇 개와 이름 몇 개가 섞이면 숫자가 어느 관절에 갈지
    정할 근거가 없음.

    이름으로 줄 때 안 준 관절을 **지금 자세가 아니라 0 으로** 두는 이유: 결과가
    실행할 때마다 같아야 함. 지금 자세를 쓰면 로봇이 어디 있었느냐에 따라 목표가
    달라짐. 시작 전에 목표 전부를 표로 찍으므로 사람이 확인할 수 있음.

    이름은 그 공간의 것만 받음 -- `ab` 면 `ankle_a`/`ankle_b`, `rp` 면
    `ankle_pitch`/`ankle_roll`. 섞으면 `Leg` 이 어차피 거부함.
    """
    tokens = list(tokens)
    if not tokens:
        raise SystemExit("각도를 줄 것. 숫자를 나열하거나 이름=값 으로")

    with_names = [t for t in tokens if "=" in t]
    if with_names and len(with_names) != len(tokens):
        raise SystemExit(
            "숫자와 이름=값 을 섞을 수 없음. 숫자는 순서로, 이름은 이름으로 갈 곳을 "
            "정하는데 섞이면 숫자가 어디로 갈지 알 수 없음"
        )

    def number(text: str, where: str) -> float:
        try:
            value = float(text)
        except ValueError:
            raise SystemExit(f"{where}: 숫자가 아님 ({text!r})") from None
        if not math.isfinite(value):
            raise SystemExit(f"{where}: 유한한 숫자여야 함 ({text!r})")
        return value

    if with_names:
        out = {name: 0.0 for name in order}
        for token in tokens:
            name, _, text = token.partition("=")
            name = name.strip()
            if name not in out:
                raise SystemExit(
                    f"모르는 관절 {name!r}. 가용: {', '.join(order)}"
                )
            out[name] = number(text, name)
        return out

    if len(tokens) != len(order):
        raise SystemExit(
            f"각도가 {len(tokens)}개인데 {len(order)}개여야 함. 순서:\n  "
            + "\n  ".join(order)
        )
    return {name: number(text, name) for name, text in zip(order, tokens)}


def cmd_pose(args, robot, loop: ControlLoop) -> int:
    """준 각도로 옮기고 붙잡음."""
    space = args.ankle_space
    order = pose_order(robot, space)
    targets = parse_pose(args.values, order)
    limits = pose_limits(robot, space)

    where = "모터 각도" if space == ANKLE_SPACE_MOTOR else "발판 자세"
    print(f"\n{robot.id} 자세 유지 -- {len(order)}개, 발목은 {where} ({space})")
    print("  " + table.header(
        ("관절", 22, "<"), ("목표", 9), ("최소", 9), ("최대", 9), ("", 8, "<")
    ))
    outside = []
    for name in order:
        value = targets[name]
        span = limits.get(name)
        if span is None:
            lo_text, hi_text, note = f"{'--':>9}", f"{'--':>9}", "한계없음"
        else:
            lo, hi = span
            lo_text, hi_text = f"{lo:9.2f}", f"{hi:9.2f}"
            note = "" if lo <= value <= hi else "범위밖"
            if note:
                outside.append(name)
        print(f"  {name:<22} {value:9.2f} {lo_text} {hi_text} {note}")

    if outside:
        note = (
            "  가드가 한계 안쪽으로 자름."
            if space == ANKLE_SPACE_MOTOR
            else "  발목 외 관절은 가드가 한계 안쪽으로 자름. 발목은 기구학이 못 풀면 버림."
        )
        print(f"\n  범위 밖: {outside}.\n{note}")
    print(f"\n  {args.approach:g}초에 걸쳐 옮긴 뒤 그대로 유지합니다.")

    return _run(
        robot, loop, targets, motions.hold(targets),
        approach_s=args.approach, watchers=getattr(args, "watchers", ()),
    )


def watch_joints(robot) -> List[str]:
    """`watch` 가 기록하는 관절. 다리마다 단일 관절 넷, 발목 자세 둘, 발목 모터 둘.

    발목은 두 공간을 다 남김 -- 손으로 움직일 때는 어느 쪽으로 볼지 미리 정할 이유가
    없음. 자세(pitch/roll)는 모터각에서 기구학으로 되짚은 값임.
    """
    names = list(SINGLE_JOINTS) + list(ANKLE_JOINTS) + list(ANKLE_MOTORS)
    return [named(robot, part, name) for part in parts(robot) for name in names]


def cmd_watch(args, robot, loop: ControlLoop) -> int:
    """토크를 끄고 위치만 읽음. 사람이 손으로 움직이는 것을 봄."""
    joints = watch_joints(robot)
    watchers = getattr(args, "watchers", ())
    for watcher in watchers:
        if watcher.order is None:
            watcher.order = tuple(joints)

    print(f"\n{robot.id} 손으로 움직이기 -- 관절 {len(joints)}개를 읽기만 함")
    print("  ** 토크가 없음. 다리가 중력에 처지므로 받쳐 둘 것 **")
    if not watchers:
        print("  기록하는 곳이 없음 -- --live 를 못 띄웠으면 --log 를 줄 것")
    print("  화면의 녹화 버튼으로 원하는 구간만 저장함. 멈추려면 Ctrl-Q.\n")

    # 관찰 모드에서는 motion 이 안 불림 -- 매 주기 불리는 텔레메트리 자리에 붙음.
    loop.mode = Mode.OBSERVE
    loop.telemetry = track_log.ObservationTap(robot, watchers, inner=loop.telemetry)
    with QuitWatcher(loop):
        stats = loop.run()

    print("\n" + failures.report(robot, stats))
    if not stats.kept_up:
        print("  주기를 못 지킴. 기록 간격이 고르지 않음.")
    return 0


def studio_gains(robot) -> Dict[str, Any]:
    """studio 게인표의 기준값과 상한. 모터 이름(팔다리 없이) -> `(kp, kd)`.

    기준값은 첫 팔다리의 설정값(robot.yaml) -- 양다리가 같은 값을 받으므로 다르면
    알림. 상한은 MIT 인코딩이 실을 수 있는 최댓값이고, 팔다리마다 모델이 다르면 작은 쪽.
    """
    base: Dict[str, Tuple[float, float]] = {}
    top: Dict[str, Tuple[float, float]] = {}
    differ = []
    for part in parts(robot):
        for name, motor in part.config.motors.items():
            g = part.base_gains[name]
            if name in base and base[name] != (g.kp, g.kd):
                differ.append(f"{part.id}/{name}")
            base.setdefault(name, (g.kp, g.kd))
            enc = part.bus.encoding(motor.id)
            kp_max, kd_max = top.get(name, (float("inf"), float("inf")))
            top[name] = (min(kp_max, enc.kp_max), min(kd_max, enc.kd_max))
    if differ:
        print(f"  ** 팔다리마다 robot.yaml 게인이 다름: {differ}. studio 는 같은 값을 양쪽에 걺 **")
    return {"base_gains": base, "max_gains": top}


def cmd_studio(args, robot, loop: ControlLoop) -> int:
    """웹에서 토크·게인·자세·동작 순서를 다룸. 힘이 풀린 채로 시작함."""
    studio: Studio = args.studio
    watchers = getattr(args, "watchers", ())
    for watcher in watchers:
        if watcher.order is None:
            watcher.order = tuple(studio.joints)
    if not any(isinstance(w, live.LiveFeed) for w in watchers):
        print("  실시간 뷰어를 못 띄워 조작할 화면이 없음. --live <다른 포트> 로 다시 실행할 것.")
        return 1

    print(f"\n{robot.id} studio -- 관절 {len(studio.joints)}개, 발목은 모터각")
    print("  ** 토크 없이 시작함. 화면의 '토크 켜기' 로 지금 자세를 붙잡음 **")
    print(f"  게인은 robot.yaml 값 x {args.gain_scale:g} 로 시작. 붙잡은 상태에서만 값으로 바꿈")
    print("  화면이 5초 끊기면 동작을 멈추고 그 자리를 붙잡음.")
    print("  끝내려면 Ctrl-Q (감쇠 후 토크를 끊음).\n")

    # 웹 요청은 매 주기 앞에서 처리함 -- CAN 을 건드리는 일은 제어 스레드에서만.
    loop.mode = Mode.OBSERVE
    loop.before_step = studio.before_step
    loop.telemetry = track_log.ObservationTap(
        robot, watchers, inner=loop.telemetry, targets=studio.row_targets
    )
    with QuitWatcher(loop):
        stats = loop.run(studio.motion)

    print("\n" + failures.report(robot, stats))
    if stats.link_loss is not None:
        print(f"\n  ** 통신 두절로 멈춤: {stats.link_loss} **")
        return 1
    return 0


COMMANDS = {
    "zero": cmd_zero, "range": cmd_range, "pose": cmd_pose,
    "watch": cmd_watch, "studio": cmd_studio,
}


# ===========================================================================
# 진입점
# ===========================================================================
def _add_common(parser, *, suppress: bool) -> None:
    """어느 자리에서도 받는 옵션. 최상위와 서브명령 양쪽에 붙임.

    argparse 는 최상위 플래그를 서브명령 뒤에 받지 않음. `zero --approach 5` 라고
    쓰는 것이 자연스러우므로 서브명령에도 같은 옵션을 둠.

    서브명령 쪽은 기본값이 `SUPPRESS` 임. 그러지 않으면 `--limb r zero` 처럼 앞에
    적은 값을 **서브명령의 기본값이 덮어씀** -- 안 준 옵션은 이름공간에 아예 넣지
    않아야 앞의 값이 살아남음.
    """
    default = (lambda v: argparse.SUPPRESS if suppress else v)
    parser.add_argument(
        "--config",
        default=default(None),
        help=f"기본값: 위로 올라가며 {CONFIG_NAME} 을 찾음",
    )
    parser.add_argument(
        "--limb",
        default=default(None),
        help="팔다리 이름. 쉼표로 여럿. 팔다리가 하나뿐이면 생략 가능",
    )
    parser.add_argument(
        "--robot",
        action="store_true",
        default=default(False),
        help="로봇 전체를 한 루프로 (kind: leg 인 팔다리 전부)",
    )
    parser.add_argument(
        "--hz",
        type=float,
        default=default(None),
        help="제어 주기. 기본은 설정의 control_hz",
    )
    parser.add_argument(
        "--drain-ms",
        type=float,
        default=default(DEFAULT_DRAIN_S * 1000.0),
        help=(
            f"응답을 기다리는 최대 시간(ms). 기본 {DEFAULT_DRAIN_S * 1000.0:g}. "
            f"늘리면 늦은 응답을 받지만 모터가 죽으면 매 주기 그만큼 씀"
        ),
    )
    parser.add_argument(
        "--send-mode",
        choices=SEND_MODES,
        default=default(SEND_BURST),
        help=(
            "명령을 버스에 내는 방식. burst=6개를 연달아 보내고 모음 (기본), "
            "seq=한 모터씩 보내고 응답을 받은 뒤 다음. burst 는 모터마다 호스트 id 가 "
            "0xF0+id 여야 함 -- 연결할 때 확인하고 아니면 멈춤. 못 맞춘 모터가 있으면 seq. "
            "docs/can_communication.md 4절"
        ),
    )
    parser.add_argument(
        "--extra",
        action="store_true",
        default=default(False),
        help=(
            "추가 값(모터 전류 iq, 전압 VBUS)을 중간중간 읽어 옴. 켜면 실시간 뷰어와 --log 기록에 "
            "extra/<관절>/iq·vbus·temp 열이 생김. burst 에서만"
        ),
    )
    parser.add_argument(
        "--extra-per-cycle",
        type=int,
        default=default(EXTRA_DEFAULT),
        metavar="N",
        help=(
            f"--extra 일 때 한 주기에 다리마다 실어 보낼 읽기 수. 기본 {EXTRA_DEFAULT} -- "
            f"모터 6 x (전류, 전압) 12칸을 돌아 100Hz 에서 값 하나가 약 17Hz"
        ),
    )
    parser.add_argument(
        "--gain-scale",
        type=float,
        default=default(1.0),
        help="게인을 낮춰 시작함. 기본 1.0",
    )
    parser.add_argument(
        "--approach",
        type=float,
        default=default(DEFAULT_APPROACH_S),
        help=f"시작 자세까지 옮기는 시간. 기본 {DEFAULT_APPROACH_S:.0f}초",
    )
    parser.add_argument(
        "--allow-uncalibrated",
        action="store_true",
        default=default(False),
    )
    parser.add_argument(
        "--log",
        nargs="?",
        const=Path("logs"),
        type=Path,
        default=default(None),
        metavar="DIR",
        help=(
            "관절별 목표·실측각과 응답 지연을 JSON 으로 남김. 폴더를 안 주면 logs/. 종류별 폴더로 나뉨. "
            "tools/policy_viewer.html, tools/latency_viewer.html 로 열어 볼 수 있음"
        ),
    )
    parser.add_argument(
        "--log-skip",
        type=float,
        default=default(LOG_SKIP_S),
        metavar="SEC",
        help=(
            f"지연 기록에서 첫 송신 뒤 이 초만큼은 버림. 기본 {LOG_SKIP_S:g}. "
            "감쇠 정지 구간은 늘 빠짐"
        ),
    )
    parser.add_argument(
        "--live",
        nargs="?",
        const=live.DEFAULT_PORT,
        type=int,
        default=default(None),
        metavar="PORT",
        help=(
            f"도는 동안 관절 목표·실측을 브라우저로 봄. 포트를 안 주면 {live.DEFAULT_PORT}. "
            "같은 망의 다른 기계에서도 열림"
        ),
    )
    parser.add_argument(
        "-v", "--verbose", action="store_true", default=default(False)
    )


def build_parser() -> argparse.ArgumentParser:
    p = argparse.ArgumentParser(
        prog="huphy-test",
        description="다리를 정해진 패턴으로 계속 움직여 봄. Ctrl-Q 로 멈춤.",
        formatter_class=argparse.RawDescriptionHelpFormatter,
        epilog=(
            "예시:\n"
            "  --limb right_leg zero\n"
            "  --limb right_leg range --period 10 --margin 8\n"
            "  --robot zero                    로봇 전체를 같은 루프로\n"
            "  --limb right_leg pose 0 10 0 30 0 0\n"
            "  --robot pose 0 10 0 30 0 0  0 10 0 30 0 0      왼다리 6 -> 오른다리 6\n"
            "  --robot pose left_leg/knee=30 right_leg/knee=30   나머지는 0\n"
            "  --robot --hz 50 --drain-ms 4 zero --log    목표·실측과 지연을 logs/ 에 남김\n"
            "  --robot --hz 50 zero --live              브라우저로 실시간 (포트 8770)\n"
            "  --robot watch                            토크 없이 손으로 움직이며 보고 녹화\n"
            "  --robot studio                           웹에서 토크·게인·자세·동작 순서\n"
        ),
    )
    _add_common(p, suppress=False)

    sub = p.add_subparsers(dest="command", required=True)

    z = sub.add_parser("zero", help="관절 전부를 0도로 두고 붙잡음")
    _add_common(z, suppress=True)

    w = sub.add_parser(
        "watch",
        help="토크를 끄고 위치만 읽음. 손으로 움직이는 것을 실시간 뷰어로 보고 녹화",
    )
    _add_common(w, suppress=True)

    st = sub.add_parser(
        "studio",
        help="웹에서 토크·게인·자세·동작 순서를 다룸. 힘이 풀린 채로 시작",
    )
    _add_common(st, suppress=True)
    st.add_argument(
        "--open", action="store_true",
        help="같은 망의 다른 기계에서도 열리게 함. 기본은 이 기계(127.0.0.1)만 -- 제어가 붙음",
    )
    st.add_argument(
        "--sequences", type=Path, default=Path("config/sequences"),
        help="동작 순서를 저장하는 폴더. 기본 config/sequences",
    )

    r = sub.add_parser("range", help="관절마다 최소~최대를 오감")
    _add_common(r, suppress=True)
    r.add_argument(
        "--period",
        type=float,
        default=DEFAULT_PERIOD_S,
        help=f"한 번 왕복하는 데 걸리는 시간. 기본 {DEFAULT_PERIOD_S:.0f}초",
    )
    r.add_argument(
        "--margin",
        type=float,
        default=DEFAULT_MARGIN_DEG,
        help=f"한계에서 남길 여유. 기본 {DEFAULT_MARGIN_DEG:.0f}도",
    )

    ps = sub.add_parser(
        "pose",
        help="준 각도로 옮기고 붙잡음. 숫자를 순서대로 나열하거나 이름=값",
    )
    _add_common(ps, suppress=True)
    ps.add_argument(
        "--ankle-space",
        choices=sorted(policy.ORDERS),
        default=ANKLE_SPACE_MOTOR,
        help="발목을 무엇으로 줄지. ab=모터 각도 (기본), rp=발판 자세",
    )
    ps.add_argument(
        "values",
        nargs="+",
        metavar="각도",
        help="숫자만(다리 하나 6개, 로봇 전체 12개 -- 왼다리 먼저) 또는 이름=값",
    )
    return p


def main(argv=None) -> int:
    args = build_parser().parse_args(argv)
    logging.basicConfig(
        level=logging.DEBUG if args.verbose else logging.INFO,
        format="%(levelname)s %(message)s",
    )

    from pathlib import Path

    path = Path(args.config) if args.config else _find_config()
    if path is None or not path.is_file():
        raise SystemExit(f"설정 파일이 없음: {path or CONFIG_NAME}")
    try:
        robot = load_robot(path)
    except ConfigError as e:
        raise SystemExit(str(e)) from None

    if args.robot and args.limb:
        raise SystemExit(
            "--robot 과 --limb 을 같이 줄 수 없음. --robot 은 팔다리 전부이고 "
            "--limb 은 그중 골라 쓰는 것임"
        )
    limbs: List[LimbConfig] = (
        all_legs(robot) if args.robot else _pick_limbs(robot, args.limb)
    )
    if args.drain_ms < 0:
        raise SystemExit(f"--drain-ms 는 0 이상이어야 함 (받은 값 {args.drain_ms})")
    # --extra 는 켜기만 함. 개수는 --extra-per-cycle. 아래는 "켜졌으면 개수, 아니면 None" 하나로 씀.
    # (--extra [N] 으로 두면 뒤에 오는 서브명령 이름을 N 으로 읽어 깨짐)
    args.extra = args.extra_per_cycle if args.extra else None
    if args.extra is not None and args.extra < 1:
        raise SystemExit(f"--extra-per-cycle 은 1 이상이어야 함 (받은 값 {args.extra})")
    if args.extra and args.send_mode != SEND_BURST:
        raise SystemExit("--extra 는 --send-mode burst 에서만 됨 (읽기 응답을 CAN id 로 가름)")
    options = dict(
        # studio 는 실행 중에 배율을 바꿈 -- 설정의 게인 그대로 만들고 배율은 세션이 걺.
        gain_scale=1.0 if args.command == "studio" else args.gain_scale,
        allow_uncalibrated=args.allow_uncalibrated,
        drain_s=args.drain_ms / 1000.0,
        send_mode=args.send_mode,
        extra=args.extra or 0,
    )

    # 팔다리가 하나면 다리 그대로 씀 -- 관절 이름에 접두어가 붙지 않아 화면과
    # 명령이 지금과 같음. 여럿이면 묶어야 명령이 같은 주기에 나감.
    if len(limbs) == 1:
        machine = build_leg(robot, limbs[0], **options)
    else:
        machine = build_biped(robot, limbs, **options)

    # 팔다리마다 control_hz 가 다를 수 있음. 한 루프로 도는 이상 하나만 고를 수
    # 있어 **가장 느린 쪽**에 맞춤 -- 빠른 쪽에 맞추면 느린 쪽이 매 주기 밀림.
    hz = args.hz if args.hz else min(limb.control_hz for limb in limbs)
    loop = ControlLoop(machine, hz=hz, mode=Mode.OBSERVE)


    # 지연은 첫 상태 읽기부터 잼 -- 통신은 패턴이 시작했는지와 무관함. 추종은 접근
    # 구간부터 매 주기 한 줄 (`_run`).
    # watch 는 화면 없이 할 일이 없음 -- 실시간 뷰어를 기본으로 켬.
    # watch·studio 는 화면 없이 할 일이 없음 -- 실시간 뷰어를 기본으로 켬.
    if args.command in ("watch", "studio") and args.live is None:
        args.live = live.DEFAULT_PORT
    args.studio = None
    if args.command == "studio":
        args.studio = Studio(
            machine,
            joints=pose_order(machine, ANKLE_SPACE_MOTOR),
            limits=pose_limits(machine, ANKLE_SPACE_MOTOR),
            **studio_gains(machine),
            gain_scale=args.gain_scale,
            sequences_dir=args.sequences,
        )
    latency = None
    args.track = None
    watchers = []
    if args.log is not None:
        # 첫 --log-skip 초는 버리고, 감쇠(정지·관찰 전환) 동안은 끔.
        latency = latency_log.LatencyLog(
            drain_ms=args.drain_ms, hz=hz, skip_s=args.log_skip,
        ).attach(machine)
        loop.on_settle = latency.on_settle
        args.track = track_log.TrackLog(robot=machine)
        watchers.append(args.track)
    server = None
    if args.live is not None:
        feed = live.LiveFeed(
            hz=hz, title=f"huphy-test {args.command} · {machine.id}",
            name=f"test_{args.command}", save_dir=args.log or Path("logs"),
            robot=machine,
        )
        server = live.start(
            feed, args.live, studio=args.studio,
            # 제어가 붙는 studio 는 이 기계에서만 열림. --open 이면 같은 망에서도.
            host="0.0.0.0" if args.command != "studio" or args.open else "127.0.0.1",
        )
        if server is not None:
            watchers.append(feed)
    args.watchers = tuple(watchers)

    try:
        with machine:
            return COMMANDS[args.command](args, machine, loop)
    except ConnectionError as e:
        channels = sorted({limb.channel for limb in limbs})
        raise SystemExit(f"{e}\n{bring_up_hint(channels)}") from e
    except HostIdError as e:
        raise SystemExit(str(e)) from e
    except KeyboardInterrupt:
        print()
        return 130
    finally:
        if server is not None:
            server.stop()
        naming = _log_naming(args)
        if args.track is not None:
            _save_track(args.track, args.log, args.command, *naming)
        if latency is not None:
            _save_latency(latency, args.log, args.command, *naming)
        if args.extra:
            print("\n" + failures.extra_report(machine))


def _log_naming(args) -> tuple:
    """`(이름 조각들, run 칸)`. 두 기록이 같은 것을 씀.

    `huphy-run` 과 같은 규칙임 (`telemetry/run_name.py`). 정책이 없으므로 정책
    이름 자리에 동작 이름(`zero`·`pose` 등)이 들어감.
    """
    return (
        run_name.tags(
            gain_scale=args.gain_scale,
            extra={
                "hz": args.hz or None,
                "drain": args.drain_ms if args.drain_ms != DEFAULT_DRAIN_S * 1000.0 else None,
                args.send_mode: True if args.send_mode != SEND_BURST else None,
                "extra": args.extra,
            },
        ),
        run_name.header(
            command=args.command,
            gain=args.gain_scale,
            hz=args.hz,
            drain_ms=args.drain_ms,
            send_mode=args.send_mode,
            extra=args.extra,
            approach=args.approach,
        ),
    )


def _save_track(track: "track_log.TrackLog", directory: Path, name: str,
                parts=(), run_meta=None) -> None:
    """추종 기록을 씀. 실패해도 올리지 않음."""
    if not len(track):
        return
    try:
        path = track.save(track_log.default_path(directory, name, parts), run_meta or {})
    except OSError as e:
        print(f"  추종 기록 저장 실패: {e}")
        return
    note = f", 기록 실패 {track.errors}회" if track.errors else ""
    print(f"  추종 기록: {path}  ({len(track)}줄{note})")


def _save_latency(latency: "latency_log.LatencyLog", directory: Path, name: str,
                  parts=(), run_meta=None) -> None:
    """지연 요약을 찍고 JSON 으로 씀. **실패해도 올리지 않음** -- 토크는 이미 끊긴 뒤임."""
    if not len(latency):
        return
    print("\n" + latency.summary())
    try:
        path = latency.save(latency_log.default_path(directory, name, parts), run_meta or {})
    except OSError as e:
        print(f"  지연 기록 저장 실패: {e}")
        return
    print(f"  지연 기록: {path}")


if __name__ == "__main__":  # pragma: no cover
    raise SystemExit(main())
