Human-Pygmalion/HUPHY/src/huphy/scripts/run.py

"""정책 실행 — 정책 꾸러미 하나를 골라 양다리를 움직임.

    huphy-run --policy walk --cmd vx=0.5 --cmd wz=0.1
    huphy-run --policy squat --cmd h_star=0.80
    huphy-run --policy squat --checkpoint 4500

브링업과 **같은 다리·같은 루프**를 씀. 다르게 들어가는 것은 매 주기 관절 목표를
내는 것 하나뿐임 -- 브링업은 사인파 같은 것을 넣고, 여기는 모델을 넣음.


## 정책은 꾸러미 폴더 하나임

`--policy 이름` 이면 `config/policies/<이름>/` 을 씀 (폴더 경로를 그대로 줘도 됨).
그 안의 `deploy_contract.json` 이 관절 순서, 기본 자세, 자르기 범위, 관찰 구성, 주기,
명령, 가중치 파일 이름을 정함 -- 읽는 쪽은 `control/deploy.py`. **이 파일에는 정책별
숫자가 없음.**


## 명령: 고정값(`--cmd`) 또는 pygame 조작(`--teleop`)

이름은 계약이 정함: walk 는 `vx`, `wz`, squat 는 `h_star`. 안 주면 계약의 시작값
(walk 0, squat 기본자세 높이 0.8914 m). 범위가 있는 명령은 범위 밖이면 시작 전에
거부함. 속도 제한이 있는 명령(`h_star`, 0.1 m/s)은 시작값에서 목표까지 그 속도로 감.

`--teleop` 이면 pygame 창(별도 프로세스, `control/teleop.py`)에서 실시간으로 조작함.
walk 는 W/S·A/D 를 누르는 동안 가속(적분), 떼면 감속해 0. 상한·가속·감속은
`--max/--accel/--decel 이름=값`. squat 는 ↑/↓ 로 높이.


## 게인은 `robot.yaml`을 그대로 씀

정책은 **학습에 쓴 게인**으로 돌아야 함. `robot.yaml`(`robot_v1.0.yaml`)이 곧
학습에서 가정한 사양값이라 덮어쓰지 않음 (135/75/130/60, `config/robot.yaml` 참조).


## 아직 없는 것

    상태 기계        지금은 정책 하나만 돎. 넘어져도 안 멈춤
    토크 가드        한계 검사가 발목 토크 경로엔 안 걸림(위치 출력만 써서 해당 없음)

**사람이 옆에서 지켜보며 돌릴 것.**
"""

from __future__ import annotations

import argparse
import logging
import signal
import sys
from pathlib import Path

from ..config import ConfigError, load_robot
from ..control import ControlLoop, Mode, deploy, held, teleop
from ..motors.canbus import DEFAULT_DRAIN_S, bring_up_hint
from ..robots.leg import SEND_BURST, SEND_MODES, HostIdError
from ..sensors.wcm1600 import Wcm1600
from ..telemetry import latency_log, live, policy_log, run_name
from . import failures
from .bringup import build_biped
from .commission import CONFIG_NAME, _find_config, all_legs
from .selftest import QuitWatcher, approach

logger = logging.getLogger("huphy.run")

ANKLE_MOTORS = ("ankle_a", "ankle_b")
"""`--gain-scale` 의 두 번째 숫자가 걸리는 모터. `robot.yaml` 의 모터 이름임."""

LOG_SKIP_S = 0.0
EXTRA_DEFAULT = 2
"""`--extra` 를 줬을 때 다리당 한 주기 읽기 수. 모터 6 x (전류, 전압) = 12칸을 도므로
100Hz 에서 값 하나가 약 17Hz 로 갱신됨."""
"""`--log-skip` 기본값. **정책 시작 부분은 버리지 않음** -- 정책이 켜진 직후가 가장 많이
보는 구간임. 연결 직후의 느린 첫 주기들은 접근 구간에 들어가 이미 빠짐."""

POLICIES_DIR = Path("config/policies")
"""`--policy 이름` 을 찾는 곳. 저장소 꼭대기 기준."""



DEFAULT_APPROACH_S = 3.0
"""기준 자세까지 옮기는 데 쓰는 시간.

**서서히 가야 함.** 토크를 넣는 순간 목표가 멀리 있으면 관절이 튐 -- 점프 가드가
자르기는 하지만 그 전에 큰 토크가 한 번 나감.
"""


def staged(approach_motion, approach_s: float, policy_motion, hold_pose):
    """기준 자세로 옮김 -> 그 자세로 기다림 -> Enter 누르면 정책.

    셋을 한 덩어리로 묶어 제어 루프에 넘김. 루프는 이 안에 단계가 있는 줄 모름.

    `start()` 를 부르기 전까지는 기준 자세를 계속 보냄 -- 사람이 로봇에서 손을 떼고
    자리를 잡을 시간임.
    """
    started = [False, 0.0]
    waiting = dict(hold_pose)

    def motion(t: float, observation):
        if t < approach_s:
            return approach_motion(t, observation)
        if not started[0]:
            return dict(waiting)
        if started[1] == 0.0:
            started[1] = t
        return policy_motion(t - started[1], observation)

    def start() -> None:
        started[0] = True

    motion.start = start          # type: ignore[attr-defined]
    motion.is_started = lambda: started[0]      # type: ignore[attr-defined]
    return motion


class EnterWatcher(QuitWatcher):
    """Enter 를 누르면 정책을 시작시키고, Ctrl-Q 를 누르면 루프를 멈춤.

    `huphy-test` 와 같은 키로 멈추려고 `QuitWatcher` 를 이어받음. 터미널을 한 글자씩
    읽는 모드로 두므로 `input()` 으로 Enter 를 기다릴 수 없음 -- 둘을 한 스레드가
    같이 봄.

    화면이 아니면(파이프, 서비스) 바로 시작함 -- 누를 사람이 없는데 영원히 기다리면
    안 됨. 그때는 Ctrl-C 로 끊음.
    """

    def __init__(self, motion, loop: ControlLoop) -> None:
        super().__init__(loop)
        self.motion = motion

    def __enter__(self) -> "EnterWatcher":
        if not self.armed:
            self.motion.start()
            return self
        super().__enter__()
        return self

    def on_key(self, key: str) -> None:
        # 한 글자 모드라도 ICRNL 이 살아 있어 Enter 는 보통 "\n" 으로 옴.
        if key in ("\n", "\r") and not self.motion.is_started():
            print("  시작함")
            self.motion.start()


def _policy_names() -> "list[str]":
    """`config/policies/` 안에서 계약 파일을 가진 폴더 이름들. `--policy` 도움말에 씀.

    목록을 손으로 적어 두면 꾸러미를 넣고도 도움말에 안 나옴. 폴더가 없거나 읽을 수
    없으면 빈 목록을 냄 -- 도움말을 찍다가 멈추면 안 되므로.
    """
    try:
        return sorted(d.name for d in POLICIES_DIR.iterdir()
                      if (d / deploy.CONTRACT_NAME).is_file())
    except OSError:
        return []
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
