Human-Pygmalion/HUPHY/tests/test_deploy.py

"""정책 꾸러미 공통 실행기(`control/deploy.py`) 테스트 — 하드웨어 없이 돎.

    PYTHONPATH=src python3 -m pytest tests/test_deploy.py -q

`config/policies/` 의 **진짜 꾸러미 셋**을 읽음.

    walk   계약을 이 저장소가 씀 (옛 walk.py 값 그대로)
    stair_slope    walk 49999 에서 이어 학습. 전진만 (wz 범위가 [0, 0])
    squat        학습 쪽 export_deploy.py 가 만든 계약 그대로. 참조 입출력 24쌍
"""

import json
import math
import shutil
from pathlib import Path

import numpy as np
import pytest

from huphy.control import deploy
from huphy.sensors.base import ImuState

POLICIES = Path(__file__).resolve().parent.parent / "config" / "policies"
WALK = deploy.load(POLICIES / "walk")
STAIRS = deploy.load(POLICIES / "stair_slope")
SQUAT = deploy.load(POLICIES / "squat")


class FakeImu:
    def __init__(self, state=None):
        self.state = state or ImuState(gyro_dps=(0.0, 0.0, 0.0), gravity=(0.0, 0.0, -1.0))

    def read(self):
        return self.state


def at_pose(policy, shift=0.0):
    return {f"{j}.pos": v + shift for j, v in policy.default_pose_deg.items()}


# ===========================================================================
# 관절 이름
# ===========================================================================
class TestNames:
    @pytest.mark.parametrize("contract, robot", [
        ("R_hip_pitch_joint", "right_leg/hip_pitch"),
        ("L_knee_joint", "left_leg/knee"),
        ("R_crank_A_joint", "right_leg/ankle_a"),
        ("L_crank_B_joint", "left_leg/ankle_b"),
    ])
    def test_contract_names_map_to_robot_names(self, contract, robot):
        assert deploy.robot_name(contract) == robot

    @pytest.mark.parametrize("bad", ["R_ankle_pitch_joint", "X_knee_joint", "R_knee"])
    def test_unknown_names_are_refused(self, bad):
        with pytest.raises(deploy.ContractError):
            deploy.robot_name(bad)
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
