Human-Pygmalion/HUPHY/(commit log)

2026-09-07 속도 제한을 직전 명령 기준 램프로 분리 (max_delta_deg 는 폭주 상한으로 되돌림)
    ## 무엇이 문제였나
    벤치가 `max_delta_deg` 를 3.0 으로 낮춰 속도 제한으로 쓰고 있었다. 그것은 속도
    제한이 아니다. 기준점이 **측정 위치**라서 명령과 현재각의 차이가 그 값으로 묶이고,
    MIT 식이 `tau = kp*(명령각 - 현재각) + ...` 이므로 **토크가 함께 묶인다.**
    3° / kp 30 이면 최대 1.57 N·m 다.
    게다가 스스로를 조인다. 모터가 뒤처지면 측정이 안 나아가고 -> 명령도 안 나아가고
    -> 오차가 안 쌓이고 -> 토크가 안 커진다. 느릴수록 더 느려진다. 실측: 이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
2026-09-08 벤치: 속도 제한을 max_vel_deg_s 로 옮기고 max_delta_deg 는 폭주 상한으로
    max_delta_deg 3.0 으로 속도를 제한하던 것은 실제로는 힘을 kp x 3도 = 1.57 N*m 로
    묶고 있었다. 기준점이 측정 위치라 모터가 뒤처지면 명령도 안 나아가, 이론 초당 300도
    설정에서 실측이 초당 49도였다.
    max_delta_deg 15.0 = 폭주 상한 (힘 상한 7.85 N*m, 라이브러리 기본값 50.0 까지 한 번에
    가지 않고 첫 운전이라 중간값에서 시작).
    max_vel_deg_s 30.0 = 진짜 속도 제한, 직전 명령 기준. RS04 정격 초당 1002도의 3.0%.
    [robot_bench.yaml]
2026-09-08 벤치: 속도 240 도/s, 폭주 상한 40도 — 실측으로 정한 값
    속도를 올려가며 잰 결과 (무릎, kp 30):
    설정 30 -> 실측 32.0 설정 60 -> 실측 64.2
    설정 120 -> 실측 115.6 설정 240 -> 실측 157.2 <- 못 따라감
    힘 상한(max_delta_deg)만 15 -> 40 으로 올리자 같은 240 설정에서 235.5.
    즉 150 도/s 위부터 막던 것은 속도 설정이 아니라 힘 상한이었다.
    240 도/s = RS04 정격(1002)의 24%. 40도 = kp 30 에서 20.9 N*m
    (RS04 연속 정격 40 N*m 의 절반).
    [robot_bench.yaml]
2026-09-08 벤치: 속도 제한을 모터 정격에 맞춤 (관절별)
    사용자 지시 "속도제한 일단 실제 모터에 맞춰줘".
    데이터시트 출력단 정격에 공차 -10% 를 반영: RS03 180 rpm = 1080 -> 972 도/s,
    RS04 167 rpm = 1002 -> 902 도/s. 관절별로 적는다(max_vel_deg_s_by_motor).
    이제 속도 관문은 사실상 안 걸리고 실제 상한은 힘이 정한다. 실측:
    vel 240 / delta 15 -> 157 도/s (힘에 막힘)
    vel 240 / delta 40 -> 236 도/s (속도 설정에 막힘)
    vel 902 / delta 40 -> 418 도/s (힘에 막힘, 위아래 418.3/418.6 재현)
    사람 무릎 보행 최대치(약 400 도/s)를 넘는다. 더 올리려면 max_delta_deg 나 kp 를
    올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
    [robot_bench.yaml]
2026-09-10 feat(policy): 발목을 모터로 학습한 모델의 행동 순서
    시뮬이 발목을 두 축 관절로 두느냐 두 모터로 두느냐에 따라 모델이 내는 마지막
    두 칸이 다름. MOTOR_ORDER 를 두고 세 함수가 order 인자로 받게 함.
    JOINT_ORDER ... ankle_pitch ankle_roll 실물에서 IK 를 거침
    MOTOR_ORDER ... ankle_a ankle_b 그대로 모터로
    PolicySpec 에 안 넣은 이유: 규격의 나머지 값(action_scale, obs_dim)이 두 공간에서
    똑같아서, 넣으면 같은 모델이 balance_rp/balance_ab 로 둘씩 늘어남. 실행할 때
    인자로 받음.
    관찰 개수도 행동 개수도 둘이 같아(24/26, 6) 가중치 파일만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
2026-09-10 feat(robots): Leg 이 발목 명령 공간을 이름으로 판별
    발목을 관절로 주면(ankle_pitch/ankle_roll) IK 를 거치고, 모터로 주면
    (ankle_a/ankle_b) 그대로 나감. 아래(가드, cal -> raw, 프레임)는 원래부터 모터
    이름으로 돌아가므로 손댈 것이 없었음.
    플래그로 안 받은 이유: 플래그를 따로 들면 명령과 그 해석이 어긋날 수 있는데,
    명령 자체가 어느 공간인지 말해 주면 어긋날 수가 없음.
    거부하는 것 셋:
    한 쌍 중 하나만 모터 두 개가 두 자유도를 같이 만들어 비틀림
    두 공간을 섞음 어느 쪽을 따를지 정할 근거가 없음
    ab + torque 토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
2026-09-10 feat(scripts): huphy-run 에 --ankle-space, 발목 기본을 위치로
    --ankle-space rp ankle_pitch, ankle_roll IK 를 거쳐 모터로 (기본)
    --ankle-space ab ankle_a, ankle_b 그대로 모터로
    --ankle-output position (기본) 또는 torque
    PolicySpec 에 안 넣고 인자로 받는 이유: action_scale 도 obs_dim 도 두 공간이
    똑같아서, 규격에 넣으면 같은 모델이 balance_rp/balance_ab 로 둘씩 늘어날 뿐임.
    어긋나도 코드로는 안 잡힘 -- 관찰 개수도 행동 개수도 같아 가중치 검사를 그냥
    통과함. 사람이 맞게 골라야 해서 시작 화면에 어느 쪽인지 찍음.
    ab + torque 는 CAN 을 열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
2026-09-11 docs: 발목 명령 공간이 둘이 된 것을 반영
    control/README.md 에 MOTOR_ORDER 와 "발목이 두 갈래임" 절, cycle.md 에 순서가
    둘이라는 것, POLICY.md 6.2 에 실행할 때는 고를 수 있게 됐다는 것.
2026-09-11 feat(policy): 양다리 모델의 12칸 순서 — 왼다리 먼저
    학습 쪽과 정한 출력 규격을 코드에 적음.
    0-5 left_leg/hip_pitch ... left_leg/ankle_roll
    6-11 right_leg/hip_pitch ... right_leg/ankle_roll
    BIPED_ORDERS 를 ORDERS 에서 만들어 발목 두 공간(rp/ab) 모두 12칸 순서가 생김.
    이름 앞의 다리는 robot.yaml 의 limbs 키와 같아서 Biped.split_action 이 그대로
    나눔.
    Biped.joint_names 에서 순서를 끌어오지 않은 이유: 그쪽은 robot.yaml 에 적힌 순서를
    따르는데 지금 설정은 오른다리가 먼저임. 모델 규격은 설정 파일이 아니라 학습이
    정하는 것이라 여기 고정함.
    observation_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
2026-09-11 feat(scripts): huphy-run --robot — 양다리 모델을 로봇 전체로 돌림
    huphy-run --robot --policy balance --weights runs/biped.pt
    모델 출력 12칸에 policy.BIPED_ORDERS 로 이름을 붙이고(왼다리 먼저), Biped 가 그
    이름을 보고 다리별 버스로 나눔. 나누는 쪽은 이미 있었고 이름을 붙이는 쪽이
    빠져 있었음.
    관찰 길이는 관절 수에서 계산함 (42, 위상이 있으면 44). action_scale 과 위상은
    --policy 로 고른 규격을 그대로 씀 -- 양다리 규격이 따로 나오면 상수를 하나 더 둠.
    모터를 켜기 전에 거부하는 것:
    --robot 과 --limb 을 같이 줌
    설정에 left_leg/right_leg 가 없음.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
2026-09-11 docs: 최종 정책 실행기 설계 검토 — 설정 파일 하나로 도는 것
    학습 결과(가중치 + 설정 파일)만 넣으면 인자 없이 도는 실행기의 설계. huphy-run 과
    별개로 두고 명령어도 다름. 아직 안 만듦.
    모델에 딸린 값(action_scale, 관절 순서, 주기, 게인, 발목 공간)이 지금은 파이썬
    상수나 CLI 인자에 있음. robot.yaml 을 캘리브레이션과 나눈 기준("이 숫자를 어디서
    얻었나")을 적용하면 가중치 옆 파일에 있어야 함.
    같은 사실을 두 곳에 적지 않도록 발목 공간·관찰 길이·다리 수는 joints 목록에서
    알아냄. 가중치와 해석이 한 쌍으로 다니므로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
2026-09-11 feat(scripts): huphy-test pose — 준 각도로 옮기고 붙잡음
    huphy-test --limb right_leg pose 0 10 0 30 0 0
    huphy-test --robot pose 0 10 0 30 0 0 0 10 0 30 0 0
    huphy-test --robot pose left_leg/knee=30 right_leg/knee=-20
    zero 가 전부 0 이던 것을 원하는 자세로 넓힌 것. 지금 자세에서 --approach 초에
    걸쳐 옮긴 뒤 Ctrl-Q 까지 붙잡음.
    각도는 둘 중 한 방식으로 받음. 섞으면 거부함 -- 숫자가 어느 관절로 갈지 정할
    근거가 없음.
    숫자만 정확히 6/12 개를 순서대로
    이름=값 준 관절만. 나머지는 0
    숫자 순서는 로봇 전체면 왼다리 6 -> 오른다리 6. 양다리 모델의 출력 규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
2026-09-11 fix(tests): huphy-run --robot 테스트가 절반 확률로 흔들리던 것
    가짜 CAN 버스의 recv() 가 큐가 비어도 기다리지 않고 바로 돌아왔음. 양다리 경로는
    수신 스레드를 켜는데, 그 스레드가 쉬지 않고 돌며 GIL 을 쥠. 파이썬은 5ms 마다
    스레드를 바꾸는데 드레인 예산은 2ms 라, 메인 스레드가 연결 직후의 상태 조회를
    놓침. 상태가 한 번도 없는 모터는 가드가 명령을 거부하므로 그 다리가 끝까지 명령을
    못 받음 -- test_both_legs_receive_commands 가 8번 중 4번 실패했음.
    실물 recv(timeout) 는 select 로 기다리며 GIL 을 놓으므로, 가짜도 timeout 만큼
    기다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
    [test_run.py]
2026-09-11 feat(motors): 수거 대기 시간을 버스가 들게 함 — 두 곳에 박힌 2ms 를 하나로
    응답을 기다리는 최대 시간(2ms)이 두 곳에 따로 적혀 있었음.
    canbus.py:80 DEFAULT_DRAIN_S = 0.002
    bus.py:218 collect(timeout_s=0.002) <- 제어 경로는 이쪽을 씀
    그래서 상수를 바꿔도 제어 경로에는 안 닿았음.
    RobStrideBus(drain_s=...) 로 받아 collect 와 refresh_states 가 그 값을 씀. 기본값은
    canbus.DEFAULT_DRAIN_S 라 지금 동작은 그대로임. build_leg 에 drain_s 를 내서
    build_biped 로도 넘어감.
    크게 잡으면 늦게 온 응답을 이번 주기에 받아 무응답이 줄지만, 모터 하나가 죽으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
2026-09-11 feat(robots): 모터별 무응답을 누적해서 셈
    link_counts() -> {모터: {asked, missed}}. 명령한 횟수와 그중 응답이 없던 횟수임.
    지금까지 있던 것은 연속 무응답(miss)뿐이라 한 번 답하면 0 으로 돌아감. 가끔씩
    빠지는 모터는 거기서 안 보임 -- 실행이 끝난 뒤 "몇 번 빠졌나" 를 이쪽이 말함.
    텔레메트리 없이 실행 끝에 찍으려고 둠.
    명령 안 한 모터는 세지 않음 (응답이 없는 게 정상임). 연결 직후의 상태 조회는
    들어감. Biped 는 이름 앞에 팔다리를 붙여 합침.
    [biped.py, leg.py, test_biped.py, test_leg.py]
2026-09-11 feat(scripts): 실행 끝에 실패 집계, --drain-ms 로 수거 대기 조절
    huphy-test 와 huphy-run 이 루프가 끝난 뒤 무엇이 실패했는지 한 번에 찍음.
    텔레메트리를 켜지 않고 주기를 바꿔 가며 몇 번 빠지는지 보려는 것임.
    주기 평균 Hz, 밀린 횟수, 가장 늦은 주기
    수거 대기 대기 시간과 주기 대비 비율. 양다리면 최악 두 배로 셈
    무응답 응답이 하나라도 빠진 주기 수와 비율
    CAN 채널별 송신 실패, 수신 실패, 대기 초과, 큐가 차서 버린 것
    모터별 명령 대비 응답 없던 횟수. 빠진 모터만, 많은 순
    가드 자른 횟수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
2026-09-14 docs: 루트 README 에 이번 작업 명령어 반영
    빠져 있던 것.
    huphy-test --robot, pose, --drain-ms, 끝 실패 집계
    huphy-run 절이 통째로 없었음. --policy/--weights/--ankle-space/
    --ankle-output/--robot 과 시작 절차
    같이 낡아 있던 것도 고침.
    robot.yaml 심볼릭 링크 예시가 robot_v0.5.yaml 로 남아 있었음 (지금 1.0)
    "왼다리 한계 없음" -> 1.0 은 양다리 다 비어 있음
    머리말의 "다리 하나가 동작" -> 양다리를 한 루프로
    테스트 개수 956 -> 1200
    README 의 명령줄이 실제 파서에 들어가는지 전부 대조함.
2026-09-14 feat(scripts): pose 가 발목을 모터각으로 받음. --ankle-space 로 고름
    pose 는 "각 모터를 이 각도로" 라고 주는 자리인데 발목 두 칸만 발판 자세
    (ankle_pitch/ankle_roll)로 받고 있었음. 화면에도 그렇게 찍혀 무엇을 주는지가
    헷갈렸음.
    기본을 모터각으로 바꿈. 앞 네 개는 모터와 관절이 1:1 이라 어느 쪽이든 같고, 발목만
    갈림.
    ab (기본) ankle_a ankle_b 모터각을 그대로 보냄
    rp ankle_pitch ankle_roll 기구학을 거쳐 모터각으로
    한계의 출처도 같이 갈림. ab 는 여섯 개 다 캘리브레이션 실측값이고, rp 는 발목만
    AnkleEnvelope 의 시험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
2026-09-14 feat(scripts): 실패 집계에 보냄/받음/미수신을 넣음
    CanCounters 가 frames_sent 와 frames_received 를 세고 있었는데 표에 안 넣었음.
    이 둘을 비교해야 "늦게 온 것" 과 "유실" 이 갈림.
    채널 보냄 받음 미수신 송신실패 수신실패 대기초과 버림
    can1 780 768 12 0 0 0 0
    미수신이 작으면 유실은 없고 늦게 온 것임 (대기초과를 볼 것).
    MIT 모드는 명령을 받으면 반드시 응답하므로 정상이면 미수신이 0 에 가까움. 크면
    응답이 실제로 안 돌아온 것이라 배선·전원·프로토콜 쪽임.
    끝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
2026-09-14 docs: cycle 문서를 현재 코드에 맞춤
    양다리·수신 스레드·통신 두절이 들어오면서 흐름이 바뀐 곳을 반영함.
    - 0장에 Biped 나눔 단계를 넣고 코드 위치를 전부 현재 줄 번호로 고침
    - 관찰·명령 계산에 양다리 합침과 rp/ab 발목 공간 분기를 넣음
    - 7-1-1 수신 스레드, 7-6 늦게 온 응답이 다음 주기로 밀리는 것을 새로 씀
    - 응답 프레임 온도가 12비트이고 Byte6 상위가 플래그인 것을 고침
    - 수거 예산이 RobStrideBus.drain_s 이고 다리 수만큼 곱해지는 것으로 고침
    - 기록이 팔다리 단위이고 IMU 는 로봇이 드는 것임을 넣음
    - "무응답이 이어져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
2026-09-15 fix(scripts): Ctrl-Q 가 tty 드라이버에 먹혀 huphy-test 가 안 멈춤
    tty.setcbreak 는 LFLAG 만 만짐 -- ICANON 과 ECHO 를 끌 뿐 IFLAG 는 그대로 둠.
    IXON 이 켜진 채로 남으면 Ctrl-Q(0x11) 가 곧 XON 이라 tty 드라이버가 흐름 제어로
    먹어 감시 스레드의 read 까지 오지 않음. 주석은 raw 모드로 바꾼다고 적혀 있었지만
    실제로 부르는 것은 cbreak 였음.
    setcbreak 뒤에 IFLAG 에서 IXON 만 따로 끔. tty.setraw 로 바꾸지 않은 이유는
    ISIG 까지 꺼져 Ctrl-C 가 안 먹히기 때문임 -- 통신이 끊겼을 때 남는 마지막 수단을
    없애면 안 됨.
    pty 안에서 IXON 이 꺼지는지, 빠져나올 때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
    [selftest.py, test_selftest.py]
2026-09-17 feat(control): 정지 절차가 hold 대신 damp 로 감쇠하며 멈춤
    Ctrl-Q/SIGINT/duration 종료/통신두절로 CONTROL 모드가 끝나면 kp 를 유지한
    채 현재 자세로 즉시 붙잡던 것을, kp=0/kd=100(RS03/RS04 인코딩 상한)으로
    속도만 죽이는 감쇠를 5초 보낸 뒤 토크를 끊도록 바꿈. 위치를 붙잡지 않아
    중력·관성에 맡겨지므로 급정지보다 완만하게 멈춤.
2026-09-17 fix(control): 감쇠 kd 를 100에서 10으로 낮춤
    실물로 돌려 보니 100은 관절이 너무 늦게 떨어지고 진동이 심함. 10으로 낮춰
    확인함.
    [leg.py]
2026-09-21 feat(config): 1.0 kp/kd 를 실측 사양값으로 채움
    hip_pitch/hip_roll/hip_yaw 150/6, knee 220/6, 발목(crank_A/crank_B) 22.266/1.414.
    토크·속도 한계는 tables.py 의 RS03/RS04 인코딩과 이미 일치해 손대지 않음.
    [robot_v1.0.yaml]
2026-09-21 feat(control): 모터 전송 주기를 정책 추론 주기와 분리함
    held() 로 motion 을 감싸면, 루프는 outer_hz 로 매 주기 전송하되 실제 추론은
    inner_hz 로만 함 -- 그 사이 주기는 직전 목표를 그대로 반복함. 보간 없음.
    run.py 는 POLICY_HZ=50 을 상수로 고정해 CLI 인자에서 뺐고, --hz 는 이제
    전송 주기 전용임. POLICY_HZ 의 정수 배가 아니면 모터 켜기 전에 멈춤.
2026-09-21 docs: 양다리 collect 가 겹치는 이유를 스레드 타임라인으로 설명함
2026-09-21 feat(config): 양다리 stand 정책 가중치 추가
2026-10-06 fix(control): 정규화에 학습이 쓴 eps 를 넣음
    rsl_rl 의 EmpiricalNormalization 은 (v - mean) / (std + 1e-2) 로 쓰는데
    우리는 eps 없이 나누고 있었음. 0 으로 나누는 것을 막는 자리 채우기가 아니라
    학습에 실제로 들어간 값임.
    학습 쪽 꾸러미가 참조 입출력 16쌍을 같이 주어 확인됨.
    (v - mean) / std 최대차 2.5e-01
    (v - mean) / (std + 1e-2) 최대차 4.6e-07
    std 가 작은 칸일수록 차이가 큼. balance 는 std 최소가 0.0546 이라 그 칸의
    입력이 18% 어긋나 있었음 -- 0.5 모델도 실물에서 다시 확인할 것.
2026-10-06 feat(control): 1.0 서기 정책 경로를 추가함
    huphy-run --robot --policy stand --ankle-space ab 로 돌아감.
    관찰 구성이 0.5 모델들과 겹치지 않아 policy.py 에 분기를 넣지 않고
    control/stand.py 를 따로 둠.
    balance / hopping stand
    관절 속도 joint_vel n칸 안 씀
    관절 위치 1프레임 2프레임
    기본 자세 전부 0 0 이 아님. 빼서 넣음
    속도 명령 없음 3칸
    관찰 길이 24 / 26 45
    관절 순서 왼다리 먼저 오른다리 먼저
    값은 학습 쪽 꾸러미 pyg_stand_v9_caps 의 de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
2026-10-06 test(control): 정지 절차가 damp 로 바뀐 것을 테스트와 문서에 반영
    c1d229c 가 정지 절차를 hold(게인 유지, 자세 붙잡음)에서 damp(kp=0, kd 만
    남겨 속도만 죽임)로 바꿨는데 테스트 4개가 옛 절차를 기준으로 남아 있었음.
    test_control 3개
    FakeRobot 에 damp 가 없어 _settle 이 getattr 검사에서 조용히 빠져나갔고,
    robot.log 에 hold 도 damp 도 안 남았음. damp() 를 추가하고 단언을 바꿈.
    test_holds_before_cutting_torque 는 이름도 지금 동작과 달라 바꿈.
    test_run 1개
    knee[-1] 로 마지막 프레임의 kp 를 봤는데 그것이 감쇠 프레임이라 0 이었음.
    실행 0.3초에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
2026-10-06 docs: stand 정책 실행법을 README 네 곳에 넣음
    코드와 run.py 안내에만 있고 README 에는 없었음.
    루트 README 정책별 입력·출력 표, stand 는 접근 자세가 기준 자세인 것
    scripts/README run.py 절이 아예 없어서 새로 씀. 파일 목록도 3개뿐이라 채움
    control/README stand.py 절. policy.py 와 뭐가 다른지 표로
    control/POLICY.md 8장 신설 -- 관찰 45칸, 오른다리 먼저, 기본 자세 세 곳,
    참조 입출력 대조 결과, 아직 안 된 것
    정규화 식이 바뀐 것도 control/README 에 반영함.
2026-10-06 fix(scripts): stand 로 실행하면 시작 화면에서 터지던 것
    target_pose 를 print 아래에서 만드는데 시작 화면이 그 값을 쓰고 있었음.
    UnboundLocalError. 조건식이라 balance/hopping 에서는 평가되지 않아 안 걸렸고,
    stand 경로를 끝까지 도는 테스트가 없어서 못 잡았음.
    target_pose 를 print 위로 올리고, 양다리 설정으로 stand 경로를 끝까지 도는
    테스트 6개를 넣음. 그중 셋이 이 버그를 바로 잡음.
    끝까지 돎
    시작 화면에 기준 자세가 보임
    접근이 영자세가 아니라 기준 자세로 감 (좌우 무릎 부호로 판정)
    --limb / rp / torque 거부 셋
    시작 화면의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
    [run.py, test_run.py]
2026-10-06 feat(config): 1.0 양다리 limits_deg 를 학습 모형 가동범위로 채움
    deploy_contract.json 의 clip_rad 를 도로 바꿔 넣음. limits_deg 만 바꿨고
    sign 1.0, offset_deg 0.0, zero_reference 는 그대로 둠.
    오른다리 왼다리
    hip_pitch -112.75 ~ +17.75 -17.75 ~ +112.75
    hip_roll -19.50 ~ +79.50 -79.50 ~ +19.50
    hip_yaw -40.50 ~ +40.50 -40.50 ~ +40.50
    knee +6.00 ~ +114.00 -114.00 ~ -6.00
    ankle_a/b -61.88 ~ +61.88 -61.88 ~ +61.88
    좌우 부호가 반대인 것은 학습 쪽 거울 규약 그대로임.
    이걸로 config.is_configured 가 True 가 되어 가드가 한계를 보게 됨.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
2026-10-06 fix(scripts): stand 는 robot.yaml 의 게인을 그대로 씀
    huphy-run 이 모든 모터의 게인을 POLICY_KP=20 / POLICY_KD=0.502 로 덮어쓰고
    있었음. 그 값은 0.5 시뮬 half_huphy.xml 것이고 1.0 서기 정책이 가정한 값이
    아님. 무릎이 220 이어야 하는데 20 으로 나가고 있었음 -- 11배.
    1.0 은 robot.yaml 이 곧 학습이 가정한 사양값임 (꾸러미 README 5장과 숫자까지
    같음). 관절 묶음마다 다르기도 해서 Gains 하나로는 표현도 안 됨.
    hip_pitch/hip_roll RS04 kp 150 kd 6
    hip_yaw RS03 kp 150 kd 6
    knee RS04 kp 220 kd 6
    ankle_a/ankle_b RS03 kp 22.266 kd 1.41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
    [run.py]
2026-10-12 feat(config): 1.0 양다리 채널을 slcan1 / slcan0 으로 바꾸고 문서에 반영
    1.0 은 USB 어댑터(slcand)로 올리므로 채널 이름이 slcan1(오른다리) / slcan0(왼다리).
    0.5 는 그대로 can1 / can0.
2026-10-12 feat(scripts): huphy-run 도 Ctrl-Q 로 멈춤
    EnterWatcher 가 selftest.QuitWatcher 를 이어받아 한 스레드에서 Enter(정책 시작)와
    Ctrl-Q(정지)를 같이 봄. 한 글자 모드라 input() 으로는 Enter 를 못 받아서 바꿈.
    QuitWatcher 에 Ctrl-Q 가 아닌 키를 넘기는 on_key 훅을 둠.
2026-10-12 feat(scripts): huphy-run --gain-scale 로 kp/kd 를 낮춰 돌림
    숫자 하나면 전체, 둘이면 '나머지 발목' 순서. 발목 토크 경로의 관절 PD 에도
    두 번째 배율이 걸림. 시작 화면에 실제로 걸린 게인과 배율을 찍음.
    build_leg 에 관절별 배율(joint_gain_scale)을 받는 인자를 둠.
2026-10-12 feat(telemetry): 정책 입출력 기록과 재생 뷰어
    huphy-run --log 이 정책 호출마다 관찰(정규화 전), 모델 출력, 관절 목표각·실측각을
    logs/policy_<정책>_<시각>.csv 로 남김. 관찰 칸 이름은 stand.OBS_NAMES 와
    policy.observation_names 가 정함.
    tools/policy_viewer.html 로 재생하듯 봄 -- 관절별 추종과 오차, 관찰 묶음, 행동.
2026-10-12 feat(telemetry): 관절별 응답 지연 기록과 히스토그램 뷰어
    --log 이면 명령을 보낸 때부터 응답이 도착한 때까지를 모터마다 잼. 제때·늦음
    (다음 주기)·유실로 나누고, 끝날 때 관절별 p50/p95/p99 표를 찍고
    latency_<정책>_<시각>.csv 로 씀. RobStrideBus 에 송신 시각을 남기는 훅을 둠.
    tools/latency_viewer.html 로 관절별·전체 히스토그램을 봄.
2026-10-12 feat(tools): IMU 관찰값 실시간 표시와 좌표계 검사
    serve 는 모델이 받는 IMU 값(obs 0-5)을 웹으로 보여줌. check 는 손으로 돌리는 동안
    기록해서 gyro 단위와 gyro·중력의 좌표계가 맞는지 판정함. 모터는 열지 않음.
2026-10-12 feat(config): stand 가중치를 model_11999 로 바꾸고 이전 것을 v7 로 남김
    stand_bi.pt 는 새 학습본(model_11999), stand_bi_v7.pt 는 이전 stand_bi.pt(model_8998)
    그대로임.
2026-10-13 feat(config): 1.0 양다리 채널을 canr / canl 로 바꿈
    번호(slcanN, canN)로 지으면 Jetson 내장 CAN 이 부팅 때 잡는 can0 과 겹칠 수 있어
    다리 이름으로 지음. README 에 1.0 을 올리는 slcand 명령과 이 기기의 udev 규칙
    (VID ad50 / PID 60c4) 형식을 적음.
2026-10-13 fix(scripts): 채널 연결 실패 안내가 USB 어댑터에서 안 되는 명령을 알려주던 것
    USB 어댑터(slcand)는 ip link 에 bitrate 를 못 넘기는데 네 진입점이 모두
    'ip link set ... type can bitrate 1000000' 만 찍었음. canbus.bring_up_hint() 로 모으고,
    채널 이름으로는 어댑터 종류를 알 수 없으므로 slcand -s8 방식과 네이티브 방식을
    같이 찍음.
2026-10-13 docs: huphy-run 새 옵션·기록·도구와 slcan 운용값을 문서에 반영
    - huphy-run 옵션표(README, POLICY.md, scripts/README)에 --gain-scale A [B], --log 를
    넣고 --hz 를 모터 전송 주기(50 의 정수 배)로 고침
    - slcand -s8 이 아닐 때의 증상, slcan 지연 실측과 권장값(--hz 50 --drain-ms 4)
    - tools/README.md: 정책 기록·지연 뷰어와 imu_viewer 쓰는 법
    - telemetry/README 에 policy_log·latency_log, robstride/README 에 지연 훅
2026-10-13 fix(motors): CAN 오류 프레임을 응답으로 세지 않음
    python-can 은 오류 프레임을 기본으로 받음. 수신 큐에 섞이면 drain(expect=6) 이 그것을
    응답 한 개로 세어 진짜 응답이 다음 주기로 밀리고, 밀림이 쌓여 지연이 늘고 모터별
    무응답이 고르게 높아짐. slcan 은 오류 프레임을 안 만들어 안 보였고 gs_usb 로 바꾼 뒤
    드러남. 큐에 넣지 않고 CanCounters.error_frames 로 세고, 실패 집계에 '버스오류' 열로 냄.
2026-10-13 feat(scripts): huphy-test --log 으로 관절별 응답 지연을 남김
    huphy-run 과 같은 지연 기록을 latency_test_<명령>_<시각>.csv 로 씀. 첫 상태 읽기부터
    재고, 끝날 때 p50/p95/p99·늦음·유실 표를 찍음. 정책 없이 통신만 볼 때 씀.
2026-10-13 feat(tools): 지연 뷰어를 다리별로 묶음
    왼다리·오른다리를 나란히 두고 각 다리 전체 히스토그램을 맨 위에 둠. 두 다리 전체는
    같은 y 축이라 좌우를 바로 비교함. 표에도 다리별 합계 줄을 넣음.
2026-10-13 docs: USB-CAN 어댑터를 slcan 에서 candleLight(gs_usb) 로 바꾸는 절차
    docs/candlelight.md 에 gs_usb 빌드·설치, DFU 로 펌웨어 쓰기, udev 이름 고정, 되돌리기와
    진행 기록을 적음 (오른다리 전환 끝, 왼다리 남음). firmware/canable/ 에 쓰는 candleLight
    바이너리와 원래 slcan 펌웨어 백업을 둠. README 의 채널 올리기 절을 1.0(candleLight,
    ip link 로 bitrate) / slcan(전환 전) / 0.5(네이티브)로 나눔.
2026-10-13 chore(logs): 1.0 서기·통신 실험 기록을 archivedlogs/ 에 남김
    policy·latency CSV 16개. 수거 대기 2ms/4ms 비교, 바닥 서기, slcan 과 gs_usb(candleLight)
    전환 전후 지연 기록. tools/policy_viewer.html, tools/latency_viewer.html 로 열림.
2026-10-15 feat(firmware): 왼다리 어댑터도 candleLight 로 바꾸고 원래 펌웨어를 백업함
    왼다리도 STM32F072 이고 쓰기 뒤에도 시리얼이 그대로라 udev 규칙으로 canl 을 고정함.
    canr/canl 둘 다 gs_usb 로 bitrate 1000000, ERROR-ACTIVE 로 올라옴. slcand 는 더 안 씀.
    backup_left.bin 은 되돌릴 때 쓰는 원래 slcan 펌웨어 전체(128K).
2026-10-15 fix(sensors): EBIMU 쿼터니언의 y, z 축 부호를 각속도·가속도 축에 맞춤
    EBIMU 는 쿼터니언만 (X, -Y, -Z) 축(항공 기체 좌표계) 기준으로 보냄. 순서만 바꾸고
    부호를 안 뒤집어서 중력방향의 x 성분 부호가 반대로 나왔음 -- 크기는 1 이라 검사로
    안 잡히고, 앞으로 기울면 정책은 뒤로 기운 것으로 봄. to_quaternion 이 (w, x, -y, -z)
    로 옮김. 가속도계와 대조해 0.002 안에서 맞음 (뒤집기 전 0.5 벌어짐).
2026-10-15 feat(scripts): huphy-test studio·watch, 실시간 추종 뷰어, 추종 기록
    - studio: 웹에서 토크 켜기·게인·자세·키프레임 재생 (control/studio.py). 요청은 큐로만
    받고 제어 루프가 before_step 에서 처리함. ControlLoop 에 switch_to_control /
    switch_to_observe 를 둠
    - watch: 토크 없이 위치만 읽어 손으로 움직이는 것을 봄
    - --live: 도는 동안 관절 목표·실측과 IMU 를 브라우저로 봄 (telemetry/live.py)
    - huphy-test --log 이 추종 기록(track_log)도 남김 -- tools/policy_viewer.html 로 열림
    - Leg.set_gains / set_gain_scale: 게인만 갈아 끼움 (캘리브레이션 한계는 그대로)
2026-10-15 feat(motors): --send-mode seq -- 모터마다 보내고 응답을 받은 뒤 다음으로
    RobStride MIT 응답은 모든 모터가 같은 CAN id(호스트 id 0xFD)를 씀. 6개를 몰아서
    보내면 두 응답이 같은 순간에 시작될 때 id 가 같아 중재가 안 되고 데이터에서 부딪혀
    둘 다 깨짐. 양다리 실측(토크 0, 100Hz): burst 무응답 주기 39~43%·유실 5~6%·버스오류
    약 1300, seq 무응답 0%·유실 0.2%·버스오류 4. 주기도 89Hz -> 95Hz 로 빨라짐.
    - RobStrideBus.collect_until: 한 모터 응답이 올 때까지만 받음 (_absorb 로 해석 공유)
    - Leg.send_mode (burst/seq): seq 면 send() 안에서 송신·수거를 끝냄
    - Biped: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
2026-10-15 feat(telemetry): 지연 기록에서 감쇠 정지를 빼고 huphy-run 은 정책 구간만 남김
    - LatencyLog: pause/resume/on_settle, skip_s. 센 송신의 응답만 세서 켜고 끄는 경계에
    가짜 유실이 안 생김. 같은 송신의 중복 응답은 버림
    - ControlLoop.on_settle: 감쇠 시작·끝을 알림 (정지, studio 관찰 전환)
    - huphy-run: 정책이 처음 불릴 때 켬. 접근·대기·감쇠는 빠지고 정책 시작은 안 자름
    (--log-skip 기본 0)
    - huphy-test: 처음 2초를 버림 (--log-skip 기본 2) -- 연결 직후 첫 주기들이 느림
2026-10-15 docs: CAN 통신 진단 기록 -- 무엇이 문제였고 지금 어떻게 보내고 세나
    slcan 펌웨어, 옛 gs_usb 드라이버의 패킷 오독(송신 멈춤), 같은 응답 id 를 몰아서 받을
    때의 충돌을 증거와 함께 적음. gs_usb 6.1 백포트 빌드·교체·되돌리기, --send-mode seq
    의 동작과 실측, 지연 기록의 제때·늦음·유실 판정과 비율 계산, 진단 명령과 틀렸던 가설.
2026-10-16 feat(scripts): --send-mode 기본값을 seq 로
    huphy-test, huphy-run, huphy-bringup 이 지나는 build_leg 의 기본을 seq 로 바꿈. 예전
    방식은 --send-mode burst. Leg 클래스 자체의 기본은 burst 로 남김 -- 가짜 버스로 도는
    테스트들이 그것을 전제로 짜여 있음. huphy-commission 은 버스를 바로 써서 여전히 몰아서
    보냄 (docs/can_communication.md 에 적음).
2026-10-16 feat(tools): studio 시퀀스를 계산으로 만듦 -- 스쿼트, 정적 보행, 발목 roll 확인
    make_sequences.py 가 발 위치·들기·골반 기울기로 자세를 정하고 역기구학으로 관절각을
    구해 config/sequences/sim_*.json 을 씀. 허벅지 = 정강이 = 0.39 m, 발판 수평
    (ankle_pitch = knee - hip), 좌우 체중 이동은 hip_roll + 발목 roll. 모든 키프레임의 관절
    한계(여유 3도)·발목 도달 범위·모터각을 검사하고 넘으면 안 씀.
    - sim_roll_check: 골반 좌우 3도 -- 발목 roll 부호 확인용 (가정임)
    - sim_squat: 무릎 20 -> 45 -> 70 -> 45 -> 20, 3회. 깊을수록 발목을 덜 젖힘 (깊게에서 10도)
    - sim_walk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
2026-10-16 chore(config): studio 에서 손으로 만든 시퀀스 (walk 수정, ankle 추가)
2026-10-16 fix(motors): 늦게 온 응답을 그 주기의 무응답으로 셈
    응답에 순번이 없어서 직전 주기의 늦은 응답이 다음 주기의 정상 응답으로
    집계되었고, 대기초과가 났는데도 모터별 빠짐 비율에는 안 잡혔음.
    도착 시각이 이번 송신보다 앞선 프레임은 상태 캐시에만 반영하고 무응답으로
    두며, 모터별 late_counts 로 따로 셈. 실패 요약 표에 그중늦음 열을 추가함.
2026-10-16 chore(logs): 0.31~0.51 서기 지연·관측 기록을 archivedlogs/ 에 남김
2026-10-18 docs: ROS 2 Humble 이식 정리
    ROS 를 안 써 본 사람 기준으로 개념부터 적고, 그 개념이 지금 레포의 무엇에
    해당하는지 짝지어 둠. 아직 안 만든 것의 설계임.
    1장 노드·토픽·서비스·액션·파라미터·메시지를 지금 코드에 매핑
    2장 얻는 것과 안 얻는 것. 실시간성·안전·설정은 ROS 가 안 해 줌
    3장 Humble 설치와 워크스페이스
    4장 패키지 구조. huphy 를 ROS 패키지로 안 만드는 이유
    5장 붙는 자리는 Motion 과 snapshot 두 곳뿐
    6장 노드 둘. 정책은 당분간 control_node 안에
    7장 주기와 스레드. ControlLoop 를 rclpy 타이머에 얹으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
2026-10-19 docs,test: stand_bi 실행 파이프라인 감사와 그 테스트
    huphy-run --robot --policy stand 가 실제로 도는 전체 경로를 줄 단위로 따라간
    기록. 소스는 안 고치고 문서와 테스트만 추가함.
    docs/policy_pipeline_audit.md
    1-8장 호출 순서, IMU 경로, 가중치 읽기, 관찰 45칸 배치, 행동->모터 명령,
    조립, 정책/전송 주기, CAN 프레임 바이트 배치
    9장 발견된 문제 6건
    9.1 huphy-run 이 텔레메트리를 안 씀 -- 정책 실행 중 아무 기록도 안 남음
    9.2 IMU 유효성 검사가 제어 경로에 없음
    9.3 stand_bi.pt 가 회귀 테스트 대상에서 빠져 있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
2026-10-19 feat(scripts): huphy-can -- CAN 채널 올리기·내리기·상태
    로봇을 돌릴 때마다 ip link 를 손으로 치던 것을 명령으로 만듦. 채널은 robot.yaml 에서 읽음.
    - up: 내렸다가 1 Mbps 로 올림. 모터 전원이 꺼진 채 보내 막힌 송신 큐도 풀림. slcand 가
    떠 있으면 먼저 끔
    - down: 내림
    - status: 어댑터 수, gs_usb 로드, 채널별 상태·비트레이트·오류 카운터·막힌 큐,
    최근 gs_usb echo 오류
    - 연결 실패 안내(bring_up_hint) 맨 앞에 huphy-can up, 손으로 하는 법은 gs_usb 먼저
    root 가 아니면 sudo 를 붙여 부르고 암호는 sudo 가 터미널에서 물음.
2026-10-19 feat(config): 1.0 양다리 게인을 실물에서 정한 값으로 바꿈
    hip_pitch/hip_roll kp 150 -> 135, hip_yaw kp 150 -> 75 / kd 6 -> 4,
    knee kp 220 -> 130, ankle_a/b kp 22.266 -> 60 / kd 1.414 -> 2.7. 양다리 같음.
2026-10-19 fix(control): 시작 2초는 밀림·최악 주기에서 뺌
    연결 직후 첫 주기들은 수신 스레드·USB 가 막 돌기 시작해 느려서, 세면 실제로 도는 동안의
    주기를 가림. 주기 수와 평균 Hz 는 그대로 다 셈. 실패 집계에 제외 구간을 같이 찍음.
2026-10-19 docs(candlelight): 선 재작업으로 어댑터와 다리가 맞바뀐 것과 확인법
    10-19 부터 0041... = 오른다리 canr, 003E... = 왼다리 canl. 채널마다 모터 id 응답으로
    어느 어댑터가 어느 다리인지 보는 절차를 남김.
2026-10-19 feat(tools): 스쿼트·걷기 시퀀스를 실물에 맞게 다듬음
    - 발목: 모델의 발판 수평보다 5도 펴야 실물이 평평함 (FLAT_ANKLE_DOWN)
    - 스쿼트: 다리 3도 벌림, 준비 자세 발목 5도 -> 깊게 15도 폄
    - 걷기: 발목을 스쿼트 준비 자세 모터각으로 고정 (roll 0), 내딛기(D)에서만 흔들발 5도 젖힘,
    다리 4도 벌림, 골반 기울기 4도, 발 드는 높이 0.15 m
    - 걷기를 sim_walk_start / sim_walk(두 걸음, 무한 반복) / sim_walk_stop 으로 나눔 --
    반복 끝 자세가 첫 자세로 이어짐
    - sim_walk2x: studio 에서 저장한 걷기
    - 미리보기 뒤 화면에 다리 벌림을 그림
2026-10-19 feat(telemetry): 관절 그래프 y 축을 캘리브레이션 가동범위로 고정
    기록 CSV 첫 줄에 '# limits 관절=최소:최대 ...' 를 남김 (track_log, policy_log, 라이브 녹화).
    값은 캘리브레이션 limits_deg, 발목 pitch/roll 은 IK 시험 범위. 정책 기록 뷰어와 라이브
    뷰어의 관절별 그래프가 이 범위로 y 축을 고정하고 눈금은 실제 각도로 찍음
    ('가동범위 정규화', 기본 켬). 범위 줄이 없는 예전 기록은 v1.0 값을 씀.
2026-10-19 docs(config): 1.0 게인 주석을 지움 -- 사양값이 아니라 실물에서 정한 값이 됨
2026-10-19 chore(logs): archivedlogs/ 를 지움
2026-10-20 feat(ros): huphy_ros 패키지 골격 — 노드 둘, 변환, 다리
    docs/ros.md 의 설계를 코드로 옮김. src/huphy/ 는 한 글자도 안 고쳤음.
    ros/huphy_ros/
    convert.py 단위(도<->라디안)와 이름(right_leg/knee <-> right_leg__knee)
    bridge.py 토픽 <-> Motion. 최신 명령·관찰을 한 칸씩 들고 락 하나로 보호
    control_node.py ControlLoop 를 자기 스레드에서 돌리고 ROS 와 이어 줌
    telemetry_node.py 읽기만. Mode.OBSERVE 라 토크가 안 들어감
    launch/ observe(읽기만), control(observe_only 기본 true)
    앞의 둘은 rclpy 를 import 하지 않음. ROS 없는 기계에서 테스트가 돌아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
2026-10-20 feat(control): balance/hopping/stand 를 generalized_walk 로 교체
    더 이상 돌리지 않는 0.5 balance/hopping, 1.0 stand 정책과 가중치를 지우고
    generalized_walk(44칸 입력, 12관절 출력, vx/wz 명령 고정값)를 정식 정책으로
    들임. 가중치는 maido-39/HuphyChan-dev(vibecoded-audit-20261012)의
    terrain10_2048_model_37400.pt, SHA-256 확인함.
    huphy-run 은 --policy/--limb/--robot/--ankle-space/--ankle-output 을 없애고
    --vx/--wz 만 받음 -- 정책이 하나뿐이고 항상 양다리 position 출력이라 선택지가
    필요 없어짐. 게인은 robot.yaml 그대로 씀(덮어쓰지 않음).
    policy.py 는 balance/hopping 전용 관찰 빌더를 지우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
2026-10-21 feat(ros): 기계 둘 · 노드 둘 구성으로 다시 만듦
    전에 만든 것은 한 기계 전제였고 정책이 control_node 안에 있었음. 배치가
    정해져서 패키지를 다시 만들고 docs/ros.md 를 다시 씀.
    정해진 것 (docs/ros.md 0장에 번호로)
    1 관절상태 -> 정책 -> 목표각 한 바퀴가 네트워크를 건너감
    2 목표각이 끊기면 감쇠 후 토크 차단
    3 접근 단계는 policy_node
    4 속도 명령(vx,wz) / 시작·정지·토크 / 관절 목표각 직접
    5 정책 교체 없음
    6 추론은 타이머 50Hz. 상태가 낡으면 목표각을 안 냄
    7 IMU 는 모션보드
    8 joint_targets 토픽 하나를 정책과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
2026-10-21 fix(ros): enable 서비스가 토크가 안 들어갔는데 성공으로 답하던 것
    _on_enable 이 루프를 띄우기만 하고 success=True 로 답했음. _enter 의
    robot.enable() 이 실측값이 없어 예외를 내면 (robots/leg.py 의 enable) 스레드가
    조용히 죽는데, 부르는 쪽은 토크가 들어간 줄 앎.
    실측 여부를 먼저 보고, 루프를 띄운 뒤 ENABLE_SETTLE_S(0.3초) 기다렸다가
    스레드가 살아 있는지 확인해서 답함.
2026-10-21 docs(ros): 설계·코드·실행을 ros/README.md 한 곳으로 옮김
    docs/ros.md 와 ros/huphy_ros/README.md 로 나뉘어 있던 것을 합침. 그림도
    docs/ros.drawio 에서 ros/ros.drawio 로 옮김.
    한 곳에 둔 이유: 설계(왜 이렇게 했나)와 실행(어떻게 쓰나)이 같은 사실을
    가리키는데 파일이 둘이면 어긋남. 저장소 관례상 폴더별 상세는 소스 옆에 두는
    것이기도 함 (docs/README.md 의 '코드 옆 문서').
    ros/README.md 773줄
    0 정해진 것 13개
    1-2 ROS 개념 매핑, 전체 그림 넷
    3-7 노드 둘 · 토픽 · 단위와 이름 · 주기와 끊김 · 안전
    8 코드 — 파일별로 뭘 하고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
2026-10-21 docs(ros): 다이어그램 토픽 상자를 전달되는 값으로 적고 위치를 옮김
    토픽 상자 안이 /huphy/joint_states 같은 경로였는데 무슨 값이 가는지로 바꿈.
    Measured joint angles 12 · Body angular velocity 3 · Gravity direction 3
    Target joint angles 12
    Velocity command — forward vx · turn wz
    서비스 이름도 경로 대신 하는 일로 — turn torque on/off, start/stop the policy.
    토픽 이름과 메시지 타입, QoS 는 ros/README.md 4장 표가 들고 있음. 그림은
    무슨 값이 어느 방향으로 몇 Hz 로 가는지만 답함.
    화살표가 겹치던 토픽 상자 위치는 사용자가 옮긴 것을 그대로 둠.
2026-10-22 docs(ros): 쓰는 법을 위로, 설계를 아래로
    리드미만 보고 따라할 수 있게 순서를 바꿈. 개념 설명부터 시작하던 것을
    설치·실행·파라미터·테스트·안 될 때 먼저 두고, 그 아래 '아래는 설계' 로
    묶음.
    위쪽은 명령 위주로 줄임 -- 실행은 6단계에 각 단계마다 치는 명령과 확인할
    값만. 왜 그런지는 아래 설계부가 들고 있음.
    설계부 장 번호는 안 바꿨음 (0~10 그대로). 코드 docstring 이 9장·10장·4-1·
    6-2 를 가리키고 있어서임. 옮긴 설치·실행·파라미터·테스트·안될때는 번호를
    떼고 위로, 남은 센서·안하는것은 16·17 -> 11·12 로 당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
2026-10-22 chore: leg_control 을 지움
    0.5 때 쓰던 단일 다리 제어 스크립트. 지금은 src/huphy/ 가 그 일을 다 하고
    더 이상 안 돌림.
    레포 안에서 이것을 import 하거나 가리키는 곳이 없음 (src · tests · tools ·
    ros · 문서 전부 확인함). 폴더 안에서 자기들끼리만 참조하고 있었음.
    README.md ankle_kinematics.py move_motor10.py robot_constant.py
    single_leg_controller.py test_zero_persistence.py
    utils/mit_codec.py utils/__init__.py
    docs/option3_control_analysis.md
    필요하면 이 커밋 이전으로 가면 있음.
2026-10-22 docs(ros): 로봇 없이 ROS 를 점검하는 절차
    vcan 으로 가짜 CAN 채널을 만들어 ROS 배선만 보는 법. 모터가 없어도 토픽·
    주기·이름·단위·QoS 와 정책 추론, 서비스를 전부 확인할 수 있음.
    1 sudo modprobe vcan; ip link add dev vcan0 type vcan
    2 robot.yaml 의 채널만 바꾼 사본
    3 local.launch.py
    4 토픽 확인 -- position 이 0 이고 missing_cycles 가 느는 것이 여기서는 맞음
    5 candump 로 프레임 -- 안 찍히면 ROS 아래 계층 문제
    6 정책 -- stage, vx
    huphy-can up 은 vcan 에 쓰면 안 됨. ip link set ... type can bitrate 를
    거는데 vcan 에는 비트레이트가 없음.
    enable 을 부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
2026-10-22 docs(ros): 새 컴퓨터 설치 순서를 venv 기준으로 다시 씀
2026-10-22 fix(ros): OBSERVE 에서 joint_states 가 하나도 안 나가던 것
    관찰을 motion 안에서만 써 뒀는데 OBSERVE 에서는 루프가 motion 을 안
    부름. before_step 에서 매 주기 써 두도록 옮김.
    loop_status 의 mean_hz 가 도는 중에 늘 0.0 이던 것도 고침 (total_s 는
    루프가 끝나야 채워짐).
2026-10-22 docs(ros): 경로를 $HOME/HUPHY 로 고정, 가짜 CAN 기대값 보강
    $PWD 를 쓰면 다른 폴더에서 launch 할 때 가중치를 못 찾아 policy_node 가
    죽음.
2026-10-23 feat: install.sh 로 새 컴퓨터 설치를 한 번에
    ROS 설치, venv(--system-site-packages), pip install, 가상환경 파이썬으로
    colcon 빌드, ~/.bashrc 블록까지. 여러 번 실행해도 되고, 옵션 없이 만든
    venv 나 시스템 파이썬으로 빌드된 워크스페이스는 고쳐 놓음.
    ros/README.md 의 설치 절차는 스크립트를 쓰는 것으로 줄임.
2026-10-23 refactor(ros): install.sh 를 ros/ 로 옮김
    ROS 용 설치 스크립트임. ROS 없이 레포만 쓰는 설치는 README.md 에 따로 있음.
2026-10-24 fix(scripts): QuitWatcher 가 한꺼번에 들어온 키를 놓치던 것
    sys.stdin.read(1) 은 나머지 글자를 파이썬 버퍼에 쌓아 두는데 select 는 그
    버퍼를 못 봐서, 빨리 연달아 누른 두 번째 키부터 다음 키를 누를 때까지 처리되지
    않았음. os.read 로 와 있는 것을 한 번에 읽고 한 글자씩 넘김.
2026-10-24 feat(control): 정책을 계약 파일 꾸러미로 일반화, huphy_squat 추가
    정책이 파이썬 모듈이 아니라 config/policies/<이름>/ 폴더 하나임.
    deploy_contract.json(학습 쪽 export_deploy.py 형식) + .pt 를 control/deploy.py
    가 읽어 관절 순서, 기본 자세, 자르기 범위, 관찰 구성, 주기, 명령을 정함.
    정책별 코드는 없음 -- 모르는 관찰 항목(func)이 오면 CAN 을 열기 전에 멈춤.
    - generalized_walk: 옛 control/generalized_walk.py 상수를 계약으로 옮김.
    가중치는 config/policies/generalized_walk/ 로 이동. 옛 코드와 목표각 차이
    1e-15 도 (200 주기 무작위 입력).
    - huphy_squat: HuphyChan-dev k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
2026-10-24 feat(run): --teleop 으로 pygame 창에서 명령을 실시간 조작
    walk: W/S vx, A/D wz. 누르는 동안 accel 로 가속(적분), 떼면 decel 로 감속해
    정확히 0, |v| <= max. 반대 키는 decel 로 먼저 멈춤. --max/--accel/--decel
    이름=값 으로 설정 (기본 0.5 / 0.5 / 1.0). squat: 위/아래 화살표로 h_star.
    창에서 Enter 시작, Space 속도 0, Esc·Ctrl-C·Ctrl-Q·창 닫기로 멈춤.
    pygame 은 별도 프로세스(spawn)로 돌고 공유 메모리에 값을 씀. 제어 루프는 매
    정책 주기 Commands.source 로 읽기만 함 (약 1.4us). 50Hz 루프 깨어남 오차는
    pygame 이 있든 없든 같음 (p99 0.007ms).
    안전: 창을 못 띄우면 CAN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
2026-10-26 feat(telemetry): 로그 이름에 월일과 인자를 넣고 첫 줄에 실행 기록을 남김
    이름만 보고 뭘 바꿔 돌린 것인지 알 수 있게 함.
    전 policy_generalized_walk_20261027_143052.csv
    후 1027_policy_generalized_walk_g0.3_vx0.3_wz0.2.csv
    1027_policy_generalized_walk_g0.5-0.8_teleop.csv
    1027_policy_huphy_squat_h0.8.csv
    1027_policy_generalized_walk.csv 기본값만
    기본값인 인자는 이름에서 뺌. 전부 기본이면 월일·무엇·정책만 남음.
    teleop 이면 명령값 자리에 teleop 만 적음 -- 값이 매 주기 바뀌어 이름에 못
    넣음. 게인·hz·drain 은 그대로 들어감. 실제 명령값은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
2026-10-26 feat(telemetry): 로그를 종류별 폴더로 나눔
    logs/
    ├── policy/ 1027_policy_generalized_walk_g0.3_vx0.3.csv
    ├── latency/ 1027_latency_generalized_walk_g0.3_vx0.3.csv
    └── track/ 1027_track_zero_g0.3.csv
    한 폴더에 섞여 있으면 실행을 몇 번 하는 순간 목록이 길어져 같은 실행의 짝을
    눈으로 찾기 어려움.
    폴더에 이미 종류가 있는데 파일 이름에도 남긴 이유: 파일 하나만 떼어 뷰어에
    끌어다 놓거나 남에게 보낼 때 이름만으로 뭔지 알 수 있어야 함.
    default_path 는 폴더를 안 만듦 -- 만드는 것은 save() 임. 경로 만들기에
    부작용을 안 넣음.
2026-10-26 feat(control): --profile 로 주기 안 단계별 소요 시간을 잼
    모델 추론·CAN 지연은 이미 재지만 관측 읽기/송신/수거 같은 나머지 단계는 실측이
    없어 63Hz 밖에 못 내는 원인을 못 좁힘. step() 에 perf_counter 를 꽂아
    관측/정책/송신/수거 네 단계를 따로 재고, --profile 로 켰을 때만 평균/p95/최대를
    찍게 함.
2026-10-27 feat(telemetry): 로그를 CSV 에서 JSON 으로 바꿈
    logs/policy/1027_policy_generalized_walk_g0.3_vx0.3.json
    logs/latency/1027_latency_generalized_walk_g0.3_vx0.3.json
    logs/track/1027_track_zero_g0.3.json
    파일 한 개가 사전 하나임.
    {"run": {"at": "2026-10-27 14:30:52", "policy": "generalized_walk",
    "checkpoint": "37400", "gain": 0.3, "vx": 0.3, ...},
    "limits": {"right_leg/knee": [6, 114], ...},
    "columns": ["t", "obs/gyro/x", ...],
    "rows": [[0.0, 0.01, ...], ...]}
    머리말 파싱이 없어짐. 전에는 # limits 와 # run 을 문자열로 쪼개 읽었는데
    이제 뷰어가 data.run.gain 으로 바로 읽음.
    열 이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
2026-10-27 docs: QUICKSTART.md -- CAN 과 정책 명령어 빠른 참조
    레포를 받은 뒤 선을 올리고 정책을 돌리기까지. 명령 위주로 짧게.
    1 CAN 선 up / status / down, 안 될 때 볼 것
    2 모터 확인 watch 로 손으로 움직여 보고, zero / pose / studio
    3 정책 있는 정책 표 -> 인자 표 -> 쓰는 법 -> teleop -> 첫 통전
    4 보기 --live 브라우저, --log JSON
    5 통신 이상 --drain-ms / --send-mode / --hz
    자주 쓰는 것만 6줄, 그 밖의 명령
    정책 표는 deploy_contract.json 에서 읽은 값임.
    generalized_walk vx 앞뒤 m/s · wz 돌기 rad/s 체크포인트 37400
    huphy_squat h_sta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
2026-10-27 docs(motors): 호스트 id 규칙·펌웨어 OTA 절차와 모터 현황, 스캔·OTA 도구
    12대 모두 호스트 id 를 0xF0 + id 로 바꿈 (Command 9, 즉시·영구). 응답 CAN id 가
    모터마다 달라져 몰아 보내도 중재로 줄을 서고, Command 14 응답도 CAN id 로 주인을 앎.
    Command 14 에 답하지 않던 7대 펌웨어를 CAN OTA 로 올림 (RS03 0.3.1.37 -> 0.3.1.50
    6대, RS04 0.4.1.24 -> 0.4.1.38 1대). motor_setup.md 14~16절에 규칙, 절차, 겪은 것,
    12대 현황(펌웨어, MCU 고유번호)을 적음.
    tools/can_scan.py 라인을 훑어 호스트 id·전압·전류·zero_sta 를 표로
    tools/rs_ota.py RobStride OTA. 쓰기 전에 모터 버전과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
2026-10-27 feat(motors): --send-mode 기본을 burst 로, --probe 로 전류·전압 기록
    호스트 id 를 모터마다 다르게 둔 뒤 100Hz 관찰 실측에서 burst 유실 0%, 한 다리
    응답을 다 받는 데 약 1.8ms (seq 3ms 이상). 그래서 기본을 burst 로 되돌림.
    build_leg 이 burst 면 연결할 때 모터마다 응답 id 가 0xF0 + id 인지 보고 아니면
    HostIdError 로 멈춤 -- 갈아 끼운 모터의 설정을 빠뜨리면 충돌이 조용히 돌아오므로.
    --probe [N] (huphy-run, huphy-test): 다리당 한 주기 N 개(기본 2)의 Command 14 읽기를
    명령에 실어 보냄. iq(0x701A)·VBUS(0x701C) 를 모터마다 돌아가며 읽고, 응답은 CAN id 로
    모터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
2026-10-28 fix(scripts): --probe 를 켜기만 하는 옵션으로, 개수는 --probe-per-cycle
    --probe [N] 으로 두니 `huphy-test --robot --probe watch` 에서 서브명령 이름 watch 를
    N 으로 읽어 "invalid int value" 로 멈춤. --probe 는 store_true 로 바꾸고 다리당 한
    주기 읽기 수는 --probe-per-cycle N (기본 2) 으로 뺌. huphy-run 도 같이 맞춤.
2026-10-28 feat(telemetry): --probe 를 --extra 로 -- 추가 값을 기존 기록·뷰어의 열로
    --probe 가 읽기와 저장(logs/motor/ 전용 JSON)을 같이 해서 다른 기록과 규칙이 달랐고,
    줄 모양이 달라 어느 뷰어로도 못 봤음. 추가 값을 IMU 열처럼 붙이는 방식으로 바꿈.
    --extra 를 켜면 Leg 관찰에 <모터>.iq / <모터>.vbus 가 생기고, track_log / live /
    policy_log 줄 끝(IMU 열 뒤)에 extra/<모터>/iq·temp·vbus 열이 붙음. 끄면 열이 없음.
    실시간 뷰어와 policy_viewer.html 은 종류마다 한 그래프, 모터마다 한 선으로 그림.
    저장 여부는 --log 만 정함. 끝에는 다리별 읽기 집계(보냄/제때/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
2026-10-28 feat(ros): enable 뒤 감쇠로 대기, CONTROL 이 끝나면 OBSERVE 로, 라이브러리 로그를 ROS 로그로
    control_node:
    - enable 뒤 첫 목표각이 오기 전까지 매 주기 감쇠 명령을 보냄. 명령이 없으면 모터가
    안 답해서 5주기 만에 통신 두절로 멈췄음 (enable 은 성공이라고 답함).
    - CONTROL 이 스스로 끝나면 (목표각 끊김·통신 두절·예외 -> 감쇠 -> 토크 차단) 같은
    스레드가 OBSERVE 루프를 다시 띄움. disable 처럼 직접 멈춘 경우는 그대로 끝남.
    다시 하려면 enable -> start_policy.
    로그:
    - logbridge.py: 파이썬 logging 을 노드 logger 의 자식으로 넘기는 핸들러. huphy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
2026-10-28 feat(viewer): 추가 값 그래프 y 축을 촘촘히, 라벨은 소수 1자리
    전류·전압·온도(extra/) 그래프만 눈금을 약 6개로 늘리고 간격은 0.1 이상, 라벨은
    소수 1자리로 씀. 실시간 뷰어와 policy_viewer.html 둘 다. 관절 그래프는 그대로.
    온도는 모터가 정수 도로 보내서(상태 프레임 원값이 늘 10의 배수) 선은 1도 계단임.
2026-10-28 docs: 호스트 id·--extra·--profile 을 README 들에, ROS 에 send_mode
    README 2절 "코드가 가정하는 값" 에 호스트 id(0xF0+id)와 펌웨어를 넣고, 모터를 갈면
    호스트 id 까지 맞추라고 적음 (scripts/README 도). telemetry/README 열 목록에
    extra/<모터>/iq·temp·vbus. README·QUICKSTART 에 --profile (huphy-run 만, 단계별
    소요 시간) 과 huphy-test 의 --send-mode / --extra. --log 기록 이름을 JSON 형식으로.
    control_node 에 send_mode 파라미터 (기본 burst, launch 인자도). 호스트 id 검사에
    걸리면 traceback 대신 안내를 남기고 끝남 -- huphy-bringup 도 같음.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
2026-10-28 feat(motors): 응답 대기(drain) 기본을 2ms 에서 4ms 로
    호스트 id 를 모터마다 다르게 한 뒤로 한 다리의 마지막 응답(호스트 id 가 가장 큰 모터,
    오른다리는 ankle_b)이 늘 약 1.5ms 에 옴. ROS control_node 처럼 같은 프로세스에 다른 일이
    많으면 수거가 0.5ms 넘게 밀려 그 모터가 무응답으로 잡혔고, OBSERVE 에서 4.5%, 연속
    5번이면 통신 두절로 멈췄음. 선 위에서는 299/299 다 왔음 (candump). 4ms 로 올린 뒤
    9195 주기 중 무응답 1.
    다 오면 즉시 넘어가서 평소 주기는 그대로임. 100Hz 양다리 최악 8ms 라 "크게 잡음" 경고
    기준을 주기의 50% -> 80% 로 (기본값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
2026-10-28 fix(ros): joint_states 를 모터 12개 이름으로 -- 발목 크랭크 값이 0 으로 가던 것
    control_node 가 joint_states 에 관절 이름(joint_names)을 실어서 발목이 ankle_pitch /
    ankle_roll 로 나갔음. 정책 계약은 기존 레포(huphy-run)처럼 모터 12개 -- 발목은 크랭크
    모터(R_crank_A_joint -> ankle_a) -- 를 받으므로, policy_node 가 ankle_a/ankle_b 를 못
    찾고 deploy 가 0 으로 채웠음. 스쿼트가 ROS 로는 못 버티고 huphy-run 으로는 버틴 이유.
    motor_names 로 바꿈. 목표각은 원래 이름으로 받으므로 ankle_a/b 가 그대로 모터로 감.
2026-10-28 feat(ros): 기준 자세와 정책 시작을 나눔, teleop 창, 속도 명령 0.5초 안전장치
    approach / start_policy: start_policy 하나가 기준 자세로 3초 간 뒤 바로 정책으로
    넘어가서 로봇이 섰는지 보고 시작할 틈이 없었음. huphy-run 처럼 나눔 --
    /huphy/approach 는 꺼짐 -> 접근 -> 대기(ready, 기준 자세를 계속 냄),
    /huphy/start_policy 는 ready 일 때만 정책 (= huphy-run 의 Enter). 아니면 이유를 붙여
    거절. stage 에 ready 추가.
    teleop_node / teleop.launch.py: huphy-run --teleop 의 pygame 창을 그대로 띄우고 값을
    20Hz 로 /huphy/cmd_vel, /huphy/h_star 에 냄. R = approach (토크가 켜져 있을 때만),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
2026-10-28 feat(policy): 걷기 체크포인트 49999 추가, 기본으로; ROS checkpoint 인자 타입 오류 수정
    HuphyChan-dev generalized-union-dr 의 terrain10_union_dr_49999 (37400 에서 이어
    학습, terrain10 + union DR) 를 generalized_walk 꾸러미의 체크포인트 49999 로 넣고
    default_checkpoint 로 함. 37400 은 --checkpoint 37400 / checkpoint:=37400.
    같은 계약임: deploy.yaml 의 관절 순서·기본 자세·스케일·클립이 기존 계약과 7.5e-7 rad
    안에서 같고 관찰 44칸 구성도 같음. model_49999.pt sha256 이 deploy.yaml 과 일치.
    release policy.onnx (onnxruntime) 와 이 레포의 numpy 로더가 입력 24개에서 최대 9.5e-6
    으로 같은 출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
2026-10-28 docs(ros): teleop 예시에 걷기·스쿼트를 둘 다, 정책 노드와 같은 정책을 줄 것
    A-6 에는 스쿼트만, B-5 에는 걷기만 있어서 teleop 이 한 정책 전용처럼 보였음. 두 곳 다
    generalized_walk (W/S/A/D) 와 huphy_squat (↑/↓) 를 나란히 적고, policy:= 는 정책 노드에
    준 것과 같아야 한다고 적음 -- 다르면 키가 그 정책에 없는 명령을 내서 무시됨.
2026-10-28 feat(teleop): 속도 상한 기본을 0.5 에서 1.0 으로
    huphy-run --teleop 과 ROS teleop 창이 같이 쓰는 VELOCITY_DEFAULTS["max"]. vx 1.0 m/s,
    wz 1.0 rad/s -- 학습 범위(vx -1 ~ 2, wz -1 ~ 1) 안. 가속 0.5 / 감속 1.0 은 그대로라
    최대까지 2초, 떼면 1초 만에 0. --max 이름=값 (ROS 는 max:=) 으로 낮출 수 있음.
    기본값을 전제로 한 test_teleop 기대값과 README 표를 맞춤.
2026-10-28 chore: logs/ 를 저장소에 올림
    .gitignore 에서 logs/ 를 뺌. 종류별 폴더(policy/, latency/)의 JSON 기록 4개만 올림.
    예전 이름이 제각각인 CSV 기록과 없앤 --probe 기능의 motor/ 기록은 넣지 않음.
2026-10-29 feat(ros): Xbox 패드로 조작하는 gamepad_node
    joy 패키지의 joy_node 가 내는 /joy 를 받아 /huphy/cmd_vel · /huphy/h_star 를
    20Hz 로 내보내고 approach · start_policy · stop_policy · disable · enable 을 부름.
    teleop_node 와 내는 것이 같고 입력만 다름 (pygame 창 대신 Joy 메시지).
    위험한 둘에 조건을 검.
    토크 넣기(View) enable_hold_s(1.0초) 동안 계속 눌려 있어야 한 번 나감
    정책 시작(Menu) RB(데드맨)를 누르고 있는 동안에만 나감
    RB 를 떼면 속도는 0, h_star 는 마지막 값 유지 (0 으로 돌리면 바닥까지 내려가라는
    뜻이 됨). /joy 가 0.5초 넘게 안 오면 전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
2026-10-29 fix(ros): gamepad_node 가 패드의 버튼 수로 USB / 블루투스 배치를 고름
    기본 번호가 USB(xpad) 배치였는데 패드는 블루투스로 붙어 있어서 View(토크)를 눌러도
    안 먹고, 대신 LB(6번)를 1초 누르면 토크가 들어가는 상태였음. RB 데드맨(5번)도 안
    먹었음. 블루투스는 C·Z 빈 칸 때문에 X 부터 한 칸씩 밀려 View 10, Menu 11, RB 7,
    오른쪽 스틱 가로 축 2 (2026-10-29 /joy 기록과 tools/gamepad_viewer.py 로 실측).
    LAYOUTS 에 usb(버튼 11개)·bluetooth(16개) 두 배치를 두고 첫 /joy 의 버튼 수로 고름.
    도중에 바뀌면 다시 고름. 모르는 수면 패드를 통째로 무시하고 속도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
2026-10-29 feat(tools): gamepad_viewer.py -- 패드 입력을 브라우저로 실시간 확인
    ROS·런치·노드·joy 패키지 없이 이 파일 하나로 /dev/input/js* 를 직접 읽음 (표준
    라이브러리만). 버튼·축 번호와 이름, 스틱 위치, 막대를 보여 주고 방금 바뀐 칸을 밝힘.
    이름은 장치에 입력 코드를 물어(JSIOCGAXMAP/BTNMAP) 붙여서 USB·블루투스를 따로 안 맞춤.
    블루투스 Xbox 는 오른쪽 스틱이 Z/RZ, 트리거가 GAS(RT)/BRAKE(LT), C·Z 는 빈 칸이고
    리눅스 별칭 NORTH/WEST 는 위치가 반대라 안 씀 (Y 가 위 4번, X 가 왼쪽 3번).
    블루투스가 잠들어 끊기면 1초마다 다시 엶. 읽기만 함.
    Co-A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
2026-10-30 docs: 기록이 JSON 으로 바뀐 뒤 안 고친 문서들
    CSV 시절 파일 이름과 없는 심볼을 가리키던 곳을 고침.
    README.md policy_<정책>_<시각>.csv 등 4곳. --log 파일의
    columns/rows/run/limits 설명 추가
    docs/can_communication.md latency_<이름>_<시각>.csv 2곳
    tools/README.md stand.OBS_NAMES / policy.observation_names 는
    코드에 없음 -> deploy.py 의 _term_names
    없는 플래그(--ankle-space, --weights)와 없는 정책
    (stand, 45칸) 예시를 generalized_walk 로
    run/limits/columns/rows 표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
2026-10-30 feat(ros): 기록을 log_node 로 -- huphy-run --log 과 같은 JSON
    ROS 로 돌리면 모델이 본 관찰 벡터와 관절별 응답 지연이 아무데도 안 남았음.
    토픽으로 내보내고 기록 노드가 받아 씀.
    ## 왜 노드를 따로 두나
    기계가 둘임 (ros/README.md 결정 13). 두 노드가 각자 파일을 쓰면 정책 기록은
    작업 기계에, 지연 기록은 모션보드에 떨어져 같이 보려면 매번 옮겨야 함.
    그리고 쓰는 데 1분 기록이 220~260ms, 5분이면 1.2~1.3초 걸림 (측정). 두 노드는
    단일 스레드 executor 에서 100Hz·50Hz 타이머를 돌리므로 그 안에서 쓰면 낡음 기준
    60ms/100ms 를 넘겨 감쇠 정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
2026-10-30 feat(ros): D455 를 띄우는 camera.launch.py
    카메라를 열어 토픽으로 내는 노드는 인텔 공식 realsense2_camera_node 임.
    우리는 그 rs_launch.py 를 포함하면서 인자만 우리 값으로 넘김.
    - 토픽 이름공간을 /huphy/d455 로 (드라이버 기본은 /camera/camera)
    - 깊이 848x480x30. 색·IMU·포인트클라우드는 안 정해서 기본 끔
    - package.xml 에 exec_depend. 안 깔려 있어도 다른 런치는 다 돎
    - README: apt 설치, 나오는 토픽, hz/bw 로 재는 확인 단계, 안 될 때
    - README: 지형 노드에 무엇이 정해져야 하는지 적어 둠
    실제로 띄워 보지는 않음 -- 패키지가 아직 안 깔렸고 카메라도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
2026-10-30 feat(policy): stairs_slopes12 -- 계단·경사 걷기
    generalized_walk 의 49999 에서 이어 50,000 업데이트 더 학습한 체크포인트.
    경사 5~30도, 계단 3~18cm 를 12단계로 올리는 커리큘럼을 돌았음.
    generalized_walk 과 44/12 레이아웃이 같고 기본자세·클립·PD 게인도 7e-7 rad
    안에서 일치하지만, 명령 범위가 다름 -- vx 가 [0, 2] 이고 wz 가 [0, 0] 임
    (전진만 학습). 계약이 명령 범위를 하나만 담으므로 폴더를 따로 둠.
    vx 를 [0.1, 2.0] 이 아니라 [0.0, 2.0] 으로 적었음. 학습 쪽
    rel_standing_envs 가 0.05 라 vx=0 도 학습했고, 아래를 0.1 로 적으면
    deploy._command 가 스틱을 뗀 0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
2026-10-30 docs(ros): gamepad 절과 stairs_slopes12 를 README 에 반영
    패드 노드(gamepad_node, gamepad.launch.py)는 올려 뒀는데 README 에 없었음.
    조작 방법이 셋(창, 패드, 명령)이 된 것을 반영하고, 버튼 배치와 두 잠금
    조건(enable 은 View 1초 누르기, start_policy 는 RB 를 같이 누르기)을 적음.
    stairs_slopes12 를 런치 예시·정책 표·local.launch.py 설명에 넣고,
    angular.z 가 control/deploy.py 의 _command 에서 0 으로 잘린다는 것과
    teleop 에 A/D 키가, 패드에 오른쪽 스틱이 아예 안 생긴다는 것을 적음.
2026-10-30 docs(ros): 계단·경사 정책의 topic pub 예시
    런치 줄만 넣고 직접 명령 주는 예시를 빼먹었음. A-6 의 명령 블록과 그 아래
    표, 자주 쓰는 것만, 맨 앞 huphy-run <-> ROS 대응표 네 군데에 넣음.
    angular.z 를 안 쓰므로 '{linear: {x: 0.3}}' 만 적음 -- Twist 의 안 적은
    칸은 0 이고, angular.z 는 deploy._command 에서 어차피 0 으로 잘림.
2026-10-30 fix(ros): install.sh 필수 패키지에 build-essential
    ros/huphy_ros_interfaces (메시지 패키지) 는 빌드 때 C++ 를 컴파일해서 g++ 가 필요한데
    목록에 없었음. g++ 가 없는 기계에서 colcon 이 "CXX 컴파일러를 못 찾음" 으로 실패하고,
    control_node 가 huphy_ros_interfaces 를 못 찾고 죽었음. 없으면 1단계에서 apt 로 깜.
2026-11-02 fix(ros): 패드·teleop 노드가 거절 응답이나 이상한 입력에 죽던 것
    서비스 응답을 한 줄에서 info/warning 으로 바꿔 찍었는데, rclpy 는 같은 호출 자리에서
    로그 수준을 바꾸면 ValueError 를 냄. 정책 도중 A(approach) 가 처음 거절되자 그 줄에서
    gamepad_node 가 죽었고, 멈춤 버튼(B)도 같이 죽어 정책이 10초 혼자 돎 (2026-11-02).
    teleop_node 도 같은 코드라 같이 고침.
    gamepad_node 는 무엇이 와도 안 죽게 함:
    - 성공·거절을 다른 줄에서 찍음
    - 범위 밖 버튼 번호는 안 눌린 것, NaN·범위 밖 스틱 값은 0 또는 ±1
    - /joy 처리·주기 처리·spin 에서 난 예외는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
2026-11-02 feat(ros): 조작 노드나 패드가 끊기면 감쇠 후 토크를 끔
    패드 노드가 죽은 뒤 정책이 속도 0 으로 계속 돌았고, 멈춤 버튼도 같이 죽어 멈출
    수단이 없었음 (2026-11-02). 끊기면 힘을 끊는 쪽으로 바꿈.
    - control_node: 명령 토픽(cmd_vel/h_star)을 받다가 input_timeout_ms(500) 넘게 끊기면
    CONTROL 을 멈춤 -> 감쇠 5초 뒤 토크 끔. 정책이 꺼져 있어도(토크만 넣었거나 접근 중)
    걸림. 한 번도 안 받았으면 안 걸리고, enable 때마다 새로 셈. stop_on_input_loss 로 끔.
    - policy_node: 같은 끊김에 어느 단계든 정책을 끔 (stop_on_cmd_loss).
    - gamepad_node: 패드가 끊기면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
2026-11-02 feat(ros): 기록은 log_node 하나로 -- debug 인자 없앰, 패드 B 에 노드 안 끝남
    - control_node / policy_node 가 기록용 토픽을 늘 만들어 두고 구독자(log_node)가
    있을 때만 policy_row / latency 를 냄. debug 파라미터와 런치 인자 삭제
    - local.launch.py 는 제어+정책만. 기록은 어느 구성이든 log.launch.py
    - gamepad_node: B 는 정책·토크만 끄고 노드는 계속 돎 (종료는 Ctrl-C)
    - ros/README.md: 두 기계 / 한 기계별 "띄울 것 한눈에" 표
2026-11-02 feat(ros): RViz 로 3D 보기 -- view.launch.py, URDF, 발목 링키지 노드
    ros2 launch huphy_ros view.launch.py 로 실물 관절각대로 움직이는 3D 모델을 봄. 화면 있는
    기계에서 띄우고 control_node 가 떠 있으면 됨 (OBSERVE 로 충분). rviz2 는 따로 깖.
    - urdf/huphy.urdf: 학습 레포(HuphyChan-dev) 의 LegOnly_..._v30_proxyfix_loop 를
    make_urdf.py 로 변환. 관절 이름을 joint_states 와 같게(right_leg__ankle_a 등),
    정강이·발은 MJCF 가 쓰는 *_noloop 메시로 (원본 메시에는 링키지가 0 자세로 박혀 있어
    고정된 막대가 하나 더 보였음), MJCF 의 모터 원기둥과 고리 점(막대 끝·볼) 을 더함.
    -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
2026-11-02 chore: ros/logs -- 11-02 실물 정책 기록 (policy·latency)
2026-11-02 feat(tools): robot_viewer.py -- 기록을 3D 로봇으로 재생 (ROS 안 씀)
    python3 tools/robot_viewer.py [기록] 으로 브라우저에 띄움. logs/·ros/logs/ 의 policy·track
    기록을 고르면 실측(pos/, 회색)과 목표(tgt/, 분홍 반투명)를 겹쳐 그림. 재생·시간 막대·속도,
    키는 policy_viewer 와 같음.
    모델은 RViz 와 같은 ros/huphy_ros/urdf·meshes. 기록에는 모터 12개만 있어서 발과 발목
    막대는 linkage.py 로 30fps 마다 풂 (25초 기록에 5초 남짓). 그리기는 three.js (CDN).
2026-11-02 feat(tools): robot_viewer 오른쪽 위에 사람이 준 명령값
    재생 중 그 프레임에서 사람이 무엇을 시켰는지 같이 보여줌 -- 걷기는
    vx·wz, 스쿼트는 h_star. 기록에 이미 obs/cmd/ 로 들어 있어 새로 남길
    것은 없었음.
    이름을 박지 않고 obs/cmd/ 뒤에 붙은 것을 그대로 씀. 정책을 바꾸면
    그 정책이 받는 명령으로 알아서 바뀜. 단위는 vx/vy m/s, wz rad/s,
    h_star m 로 붙이고 모르는 이름이면 숫자만.
2026-11-04 fix(ros): local.launch.py 에서 제어의 hz 가 정책에 새던 것 -- motor_hz / policy_hz
    두 런치가 인자 이름 `hz` 를 같이 썼음. IncludeLaunchDescription 은 런치 설정
    범위를 새로 안 만들고 DeclareLaunchArgument 는 이미 있는 이름에 기본값을 안
    넣으므로, local.launch.py 가 control 을 먼저 include 하면 그 `hz`(100) 이
    문맥에 박혀 policy.launch.py 의 기본값 0 이 무시되고 policy_node 에 100 이
    들어갔음. 인자를 하나도 안 줘도 정책이 계약의 50 이 아니라 100Hz 로 돌았음
    (ros/logs 의 11-02 기록 다섯 개가 그 상태. run.hz 100, 줄 간격 9.99ms).
    - control.launch.py: 런치 인자 hz -> motor_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
2026-11-04 fix(robots): 양다리 수거가 마감 하나를 같이 씀 -- 최악 대기가 drain x 다리 수였던 것
    Biped.collect 가 다리마다 Leg.collect 를 부르고, 각자 drain_s 마감을 새로 잡았음.
    앞 다리가 응답 하나를 못 받아 마감까지 기다리면 뒤 다리도 처음부터 또 기다려서
    최악이 drain_s x 2 (4ms 면 8ms). 200Hz(5ms 주기)에서는 주기가 밀림.
    Biped.collect 마감을 한 번 잡고 Leg 에 deadline 으로 넘김
    Leg.collect deadline 을 받으면 남은 시간만 기다림. 지났어도 쌓인 응답은 꺼냄
    failures 수거 대기 줄이 다리 수를 곱하지 않음
    refresh(관찰 모드)는 다리마다 보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
2026-11-04 chore: ros/logs -- 11-04 기준 움직임·카메라 무게 기록, README
    squat_baseline / walk_baseline 기준 움직임
    squat_with_cam 카메라를 달고 같은 squat. 무게 영향 확인용
    README 에 기록별 설명을 둠. 11-02 기록은 전부 정책이 100Hz 로 돈 것(계약은
    50Hz)이라고 적음. 11-04 는 정책 50Hz · 모터 100Hz.
2026-11-06 feat(ros): 모터 전류·전압·온도를 기록 -- control.launch.py 의 extra 인자
    `huphy-run --extra` 가 남기는 extra/<모터>/iq·temp·vbus 열을 ROS 기록에도 남김.
    파일 모양이 같아서 tools/policy_viewer.html 을 그대로 씀.
    주기
    control_node 가 /huphy/debug/motor_extra 발행 state_hz (기본 100Hz)
    log_node 가 구독 100Hz. 마지막 메시지만 둠
    파일에 기록 정책 줄 주기 (50Hz)
    iq·vbus 값 갱신 extra:=2 면 약 17Hz
    temp 값 갱신 100Hz
    iq·vbus 는 상태 응답 프레임에 없어서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
2026-11-09 feat(ros): log_node 가 전력 열을 계산 -- extra 를 켤 때
    모터는 DC 전류도 전력도 안 냄. 매뉴얼 0x70xx 표의 읽기 전용 항목이 네
    개뿐이고 (mechPos, iqf, mechVel, VBUS) 그중 전력에 쓸 것은 상전류와 버스
    전압임. 둘은 인버터 반대쪽 값이라 곱해도 전력이 아님.
    그래서 읽어 온 상전류로 구리 손실을 계산해 열로 냄.
    power/<모터>/copper_w 1.5 * iq**2 * R_phase
    power/copper_w 모터 전부의 합
    power/dc_a_lo 합 / 그 줄 vbus 평균. **하한**
    기계 출력·철손·인버터 손실·감속기 손실이 빠져 있어 하한임 -- 토크·속도는
    MotorExtra 에 없고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
2026-11-09 docs(ros): log_node 기록 설명에 power/ 열을 반영
    열 표, 받는 값(모터 모델명), 쓰는 huphy 모듈, PolicyLog 에 더한 입구
    네 군데가 전력 열을 빼고 있었음.
2026-11-09 feat(telemetry): DC 전류 하한을 모터별로도 -- power/<모터>/dc_a_lo
    합계 하나(power/dc_a_lo)만 있던 것을 모터마다 냄.
    power/<모터>/dc_a_lo 그 모터의 구리 손실 / 그 모터의 vbus
    열 순서 모터별 copper_w -> 모터별 dc_a_lo -> 합계 둘
    전압을 못 받은 모터는 그 모터만 NaN. 합계는 전과 같이 손실 합 / vbus 평균.
    policy_viewer: 그래프 이름을 "전력 - 모터별 / 전력 합 / DC 전류 - 모터별 /
    DC 전류 합" 으로, 목록도 이 순서로. 모터별 DC 열이 없는 예전 기록은 그 그래프만
    안 생김.
    ros/README: local.launch.py 와 extra 가 기록 노드를 안 띄운다는 것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
2026-11-09 chore: ros/logs -- 11-09 half_alu 기록 (walk · squat · stairs)
    generalized_walk_half_alu huphy_squat_half_alu stairs_slopes12_half_alu
    policy · latency 한 쌍씩. 정책 50Hz · 모터 100Hz · extra 2
    policy 파일에는 power/<모터>/dc_a_lo 열을 기록 뒤에 넣음 -- 그 줄의 모터별
    copper_w / vbus 로, log_node 가 새로 만드는 열과 같은 순서·같은 정의.
2026-11-11 fix(tests): 전력 열 수 기대값이 b9a4e70 뒤로 안 맞던 것
    모터별 dc_a_lo 가 생겨 전력 열이 4개에서 6개가 됐는데
    test_rows_keep_their_width_before_the_first_current_arrives 의 산식이
    그대로였음.
2026-11-11 feat: union_dr_00545 모션 추종 정책과 motion_node
    HuphyChan-dev ee7770d7 의 huphy_00545_uniondr_30000 릴리스를 돌릴 수 있게 함.
    속도 명령 정책과 달리 사람이 줄 명령이 없고, 꾸러미에 든 659프레임 궤적을
    50Hz 로 재생하며 그 프레임의 관절값이 관찰의 명령 칸이 됨.
    관찰 114칸 중 48칸이 기준 프레임이고, 48칸이 관절 24개의 위치·속도임. 그 24개
    중 다리마다 6개(로드 유니버설 4축, 발목 2축)는 인코더가 없음. 로드 끝이 발판에
    붙어 루프가 닫혀 있어 크랭크각 2개로 정해지므로 풀어서 냄
    (kinematics/mjcf_loop.py). 학습에 쓴 기준 모션 659프레임이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
2026-11-11 feat(ros): 패드로 모션 추종 정책을 다룸
    gamepad_node 가 "조작할 명령이 없는 정책임" 으로 거절하고 있었음. 스틱이 할 일이
    없다고 노드 전체를 안 띄우면 버튼 다섯 개(View 토크, A 기준 자세, RB+Menu 시작,
    B 끔)도 같이 못 쓰게 됨 -- union_dr_00545 는 터미널에서 서비스를 부르는 길밖에
    없었음.
    명령이 없는 정책은 스틱만 비우고 버튼은 그대로 씀. cmd_vel 은 그때도 0 을 20Hz 로
    계속 냄 -- 값이 쓰이지 않지만 그것이 패드 쪽이 살아 있다는 신호임.
    motion_node 에 stop_on_cmd_loss 를 더함 (policy_node 와 같은 규칙). cmd_vel 과
    h_star 를 구독하되 값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
2026-11-11 refactor: 꾸러미 이름을 union 으로. README 실행 절차에 반영
    이름이 union_dr_00545 라 명령줄에 치기 길었음. 폴더·계약의 package·문서·시험·
    생성기를 다 union 으로 바꿈. motion.launch.py 의 기본값도 그것임.
    ros2 launch huphy_ros motion.launch.py policy:=$HOME/HUPHY/config/policies/union
    huphy-run --policy union
    앞 커밋에서 ros/README.md 의 노드 표와 motion_node 절만 넣고 실행 절차를 안
    고쳤음. 세 군데를 채움.
    "띄울 것 한눈에" 터미널 2 가 정책 종류에 따라 런치가 다름
    A-2 정책 노드 띄우기 넷 중 하나. 모션 추종은 motion.launch.py
    B. 한 기계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
2026-11-11 chore: ros/logs -- 11-11 전류 측정 squat, union 모션 추종 첫 시험
    huphy_squat_current_measure 전류 측정용 squat. 75초, extra 2
    (모터별 power/<모터>/dc_a_lo 열이 처음부터 들어감)
    1111_*_union, union_2 union(00545 모션 추종) 첫 실물. 둘 다 시작 0.4초
    안에 패드 B 로 멈춤 -- ref 는 프레임 0 부터 한 주기에
    한 프레임씩 모션 파일과 같게 들어감
    policy · latency 한 쌍씩. 정책 50Hz · 모터 100Hz.
2026-11-12 feat(ros): RViz 에 목표 자세를 반투명 로봇으로 겹쳐 그림 -- view.launch.py target 인자
    정책 노드가 낸 /huphy/joint_targets 를 두 번째 로봇으로 그림. 실측(진한 쪽)이 목표를
    얼마나 따라가는지 바로 보임.
    linkage_node 한 벌 더. joint_targets -> joint_targets_view 로 remap
    robot_state_publisher ns target, frame_prefix target/ -- /target/robot_description
    static TF world -> target/base_link (0 으로 고정)
    huphy.rviz RobotModel "Target", TF Prefix target, Alpha 0.35
    target:=false 면 안 띄움 (기본 true). 목표각은 접근·대기·정책 중에만 옴 -- 그 밖에는
    마지막 목표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
2026-11-12 chore: ros/logs -- 11-12 half_alu + 카메라, hip_roll kp 비교
    huphy_squat_half_alu_cam_roll_kp150 squat, hip_roll kp 150
    huphy_squat_half_alu_cam_roll_kp150_pose2 같은 게인, 기준 자세만 바꿈
    generalized_walk_half_alu_cam_roll_kp150 walk, hip_roll kp 150
    generalized_walk_half_alu_cam_roll_kp165 walk, hip_roll kp 165
    policy · latency 한 쌍씩. 정책 50Hz · 모터 100Hz · extra 2. 게인은 기록 안에 없어서
    이름으로만 남음.
2026-11-12 fix(viewer): 기록을 볼 때 발목 각도 범위를 안 봄
    정책이 낸 목표가 범위를 넘은 기록을 열면 화면이 "발목 푸는 중 100%" 에서
    멈췄음. 발목 풀이가 실패한 프레임이 worst_m 에 inf 를 남기고, 그 값이
    {"worst_mm": Infinity} 로 응답에 실려 브라우저의 res.json() 이 터졌음.
    Linkage 에 ankle_limits 를 넣어 뷰어만 끔. 범위 검사는 뒤집힌 해를 거르려고
    둔 것인데, 목표각을 볼 때는 무엇을 요구했는지 그대로 보여 주는 쪽이 맞음.
    RViz 쪽 linkage_node 는 기본값(켜짐) 그대로. 막대 범위(±90도)는 남김 --
    그것은 기계 한계가 아니라 조립 모양을 고르는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
2026-11-12 refactor: 정책 이름을 짧게
    union -> motion545, generalized_walk -> walk, huphy_squat -> squat,
    stairs_slopes12 -> stair_slope. 꾸러미 폴더, 계약의 package 필드, 문서,
    ROS launch 기본값과 노드 머리말까지 같이 바꿈.
    바꾸지 않은 것:
    가중치 파일 이름 (generalized_walk_49999.pt 등) -- sha256 으로 대조하는
    릴리스 산출물임
    기록 파일 이름과 그 안의 run.policy -- 돌았을 때의 이름이 기록임
    상류 이름 (Union-DR, generalized-union-dr, Huphy-Squat-Flat-v0,
    stairs_slopes12_union_dr_99998, 학습 런 이름)
2026-11-12 feat: motion399 꾸러미. 빌더가 릴리스 deploy.yaml 을 따라감
    a2620fe0 의 huphy_00399_uniondr_20000 을 꾸러미로 옮김. 기준 궤적 1511프레임
    30.22초, 체크포인트 20000. 계약은 motion545 와 같음 -- 관찰 114칸, 행동 12칸,
    50Hz, 관절 24개 순서까지 같고 다른 것은 궤적과 가중치뿐임.
    빌더(build_motion.py, 전 build_union.py)에서 파일 이름을 떼어 냄. 읽을 파일을
    릴리스 deploy.yaml 에서 가져오고(motion.training_file, policy.checkpoint,
    policy.onnx), env 는 env.yaml 이 없으면 stage2_env.yaml 을 씀 (399는 2단계
    학습임). 꾸러미 이름은 모션 번호에서 나옴. 같은 빌더로 545를 다시 만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
2026-11-12 chore: logs/track -- 모션 추종 기준 궤적 둘 (뷰어용)
    꾸러미의 npz 를 뷰어가 읽는 기록 모양으로 바꿔 둔 것. 관절 24개를 다 넣으므로
    뷰어가 풀 것이 없고 학습이 본 자세를 그대로 그림. 폐루프 잔차 0.0 mm.
    motion545_reference.json 659프레임 13.18초 144 KB
    motion399_reference.json 1511프레임 30.22초 325 KB
    로봇이 돈 기록이 아님 -- run.source 가 reference 임. 몸통은 안 그려짐
    (기록에 그 칸이 없음).
    다시 만들려면:
    python3 tools/policy_package/reference_to_log.py
    python3 tools/policy_package/reference_to_log.py --policy config/policies/motion399
2026-11-12 fix(ros): 모션 추종의 approach 를 궤적 시작 프레임 자세로
    motion_node 의 approach 가 계약의 기본자세로 갔음. policy_node 를 그대로 따라
    쓰고 모션 추종일 때를 다시 안 봤던 것임.
    학습은 에피소드를 시작할 때 로봇 관절을 그 프레임 값으로 놓고 시작함 (릴리스
    source/.../tracking/mdp/commands.py 의 _resample_command 가
    motion.joint_pos[time_steps] 를 write_joint_state_to_sim 함). 기본자세로 가면
    start_policy 를 누른 순간 기준과 실측이 벌어진 채로 들어감 -- R_hip_yaw 가
    motion545 20.8도, motion399 14.7도.
    DeployPolicy.reference_pose(frame) 를 넣고 motion_node 가 start_frame 자세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
2026-11-12 chore: ros/logs -- 11-12 motion399 두 번 (기록 순서대로 번호)
    1112_*_motion399 18:42 정책 27줄 (약 0.5초)
    1112_*_motion399_2 18:54 정책 88줄 (약 1.8초)
    log_node 가 붙인 번호가 기록 순서와 반대여서 맞바꿈 -- 먼저 찍힌 것이 번호 없는 쪽.
    policy · latency 한 쌍씩.
2026-11-13 feat: 전류계(WCM1600) -- 로봇 전체 DC 전류를 재서 기록에 남김
    계산값과 나란히 둠. power/dc_a_lo 는 구리 손실만 보는 하한이고 실측은
    연산보드·팬까지 포함해서, 둘이 같아지지 않는 것이 정보임. 대체하지 않음.
    sensors/current.py CurrentState, CurrentMeter. 벤더 중립
    sensors/wcm1600/ 프레임 파싱(순수 함수) + 백그라운드 리더
    scripts/current.py huphy-current. 기준선 잴 때 평균을 찍음
    telemetry/power.py current/total_a · current/age 열 이름
    scripts/run.py --current [PORT]
    ros/current_node.py /huphy/bus_current, 20Hz
    ros/log_node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
2026-11-13 chore: tools/wcm1600.py -- 전류계 원본 스크립트 (termios, 의존성 없음)
    받아 온 그대로임. huphy-current 와 겹치지만 pyserial 없이 돌아서,
    센서 모듈이 안 깔린 기계에서 장비만 확인할 때 씀.
2026-11-13 chore: ros/logs -- 11-13 전류계 실측 기록 (walk 2번, stair_slope 4번)
    1113_walk_current_measure 18:25 29초
    1113_walk_current_measure_2 18:28 56초
    1113_stair_slope_current_measure 18:44 7초
    1113_stair_slope_current_measure_2..4 18:45 / 18:55 / 19:02
    전류계(WCM1600, current_node)를 켜고 찍어 current/total_a · current/age 열이
    들어감. policy · latency 한 쌍씩. 정책 50Hz · 모터 100Hz · extra 2.
